almondsun/DynamicSystemsAndControl/project/pcb/redesign/production/jlcpcb-revB-2026-10-27/evidence/drill-report.txt

Drill report for buck.kicad_pcb
Created on 2026-10-27T14:55:54

Copper Layer Stackup:
    =============================================================
    L1 :  F.Cu                      front
    L2 :  B.Cu                      back

Drill file 'buck-PTH.drl' contains
    plated through holes:
    =============================================================
    T1  0.300mm  0.0118"  (39 holes))
    T2  0.400mm  0.0157"  (350 holes))
    T3  1.000mm  0.0394"  (9 holes))
    T4  1.100mm  0.0433"  (12 holes))
    T5  1.300mm  0.0512"  (4 holes))
    T6  1.400mm  0.0551"  (3 holes))

    Total plated holes count 417

Drill file 'buck-NPTH.drl' contains
    unplated through holes:
    =============================================================

    Total unplated holes count 0
