almondsun/DynamicSystemsAndControl/project/pcb/redesign/production/jlcpcb-quote-2026-10/evidence/drill-report.txt

Drill report for buck.kicad_pcb
Created on 2026-10-27T00:43:03

Copper Layer Stackup:
    =============================================================
    L1 :  F.Cu                      front
    L2 :  B.Cu                      back

Drill file 'buck-PTH.drl' contains
    plated through holes:
    =============================================================
    T1  0.300mm  0.0118"  (22 holes))
    T2  0.400mm  0.0157"  (25 holes))
    T3  1.000mm  0.0394"  (2 holes))
    T4  1.000mm  0.0394"  (19 holes))
    T5  1.100mm  0.0433"  (5 holes))
    T6  1.300mm  0.0512"  (8 holes))

    Total plated holes count 81

Drill file 'buck-NPTH.drl' contains
    unplated through holes:
    =============================================================

    Total unplated holes count 0
