almondsun/DynamicSystemsAndControl/project/pcb/audit/organization_by_type.md

# Documentos y bibliotecas organizados por tipo

Carpeta de origen comprobada: `C:\Users\justa\Downloads`. Se copiaron documentos de componentes electrónicos y bibliotecas; los documentos personales y materiales de clase ajenos permanecen en origen.

|Carpeta|Archivos únicos|
|---|---:|
|datasheets|40|
|cad/symbols|11|
|cad/footprints|15|
|cad/models_3d|14|
|cad/integrated_libraries|6|
|archives|16|
|technical_documents|6|
|pending_review|6|

Los datasheets confirmados están juntos en datasheets/. Los símbolos, footprints y modelos 3D están separados dentro de cad/. Las bibliotecas Altium integradas quedan en cad/integrated_libraries/, sin conversión ni separación interna. Los ZIP se conservan en archives/.

Se conservaron los nombres de archivo; para colisiones de nombre con contenido diferente se añade un fragmento SHA-256. Contenido idéntico se guarda una sola vez por categoría y sus orígenes quedan registrados.

La estructura anterior component_library/ por MPN se conserva como respaldo trazable y continúa siendo el destino del organizador previo. Esta vista por tipo es una copia organizada del estado actual; no se reconfiguró el watcher.

classification_by_type_manifest.csv registra origen, miembro ZIP, destino, MPN cuando existe, evidencia, asociación y hash. La presencia de documentos de otros componentes no los aprueba como sustitutos del Buck.

Originales de Descargas conservados, sin movimientos ni eliminaciones. Copias y originales verificados con SHA-256. Toda esta carpeta sigue excluida de Git. No se modificaron esquemáticos, PCB ni bibliotecas del proyecto activo.

## Pendientes de identificación
PDF sin texto claro o con caracteres ilegibles se copiaron a pending_review/. La identidad de estos archivos no se dedujo únicamente de su nombre.
