almondsun/DynamicSystemsAndControl/project/pcb/release/hardware-appendix.pdf

## Anexo de hardware: convertidor Buck

Revisión A: diseño preparado; ensayos físicos pendientes

Martín Ramírez Espinosa; Jerónimo Vargas Orozco Andrew Esteban Henao Becerra; Mateo Alexander Cardenas Cuesta Universidad Nacional de Colombia, Sede Manizales

## Alcance y estado

Este anexo acompaña las cuatro entregas IEEE. Las vistas proceden de la placa KiCad; no son fotografías de un prototipo. La placa tiene 99 por 99 mm, dos capas y 57 componentes. No se han comprado componentes ni realizado ensayos físicos. La fabricación permanece retenida hasta calificar componentes y validar un prototipo soldado.


Figura 1. Vista CAD isométrica. Los encapsulados estándar proceden de la biblioteca oficial KiCad. L1/L2 usan envolventes provisionales de 25 mm de diámetro: no representan dimensiones verificadas, bobinado ni terminales comerciales. Los capacitores representan el encapsulado previsto, con referencia y altura comercial pendientes. El MCU y accesorios son externos. Las vistas no certifican holguras, disipación ni montaje.

## Vista superior y localización


Figura 2. Vista superior CAD. La posición corresponde al archivo de placa. Verificar orientación, polaridad y dimensiones contra las piezas recibidas antes de ordenar.

Referencias | Función
J1; J2; J3 | Entrada con fusible externo; salida a carga; interfaz MCU.
Q1; D1; L1/L2; RS1 | MOSFET; rueda libre; inductancia serie; shunt.
U1; U2; U3 | IR2110; regulador 5 V; inversor HCT14.
U4; U5; U6 | Enclavamiento HCT00; comparadores LM393; INA180A1.
C4/C5 | Dos capacitores de 10 µF en paralelo.

## Plano de componentes

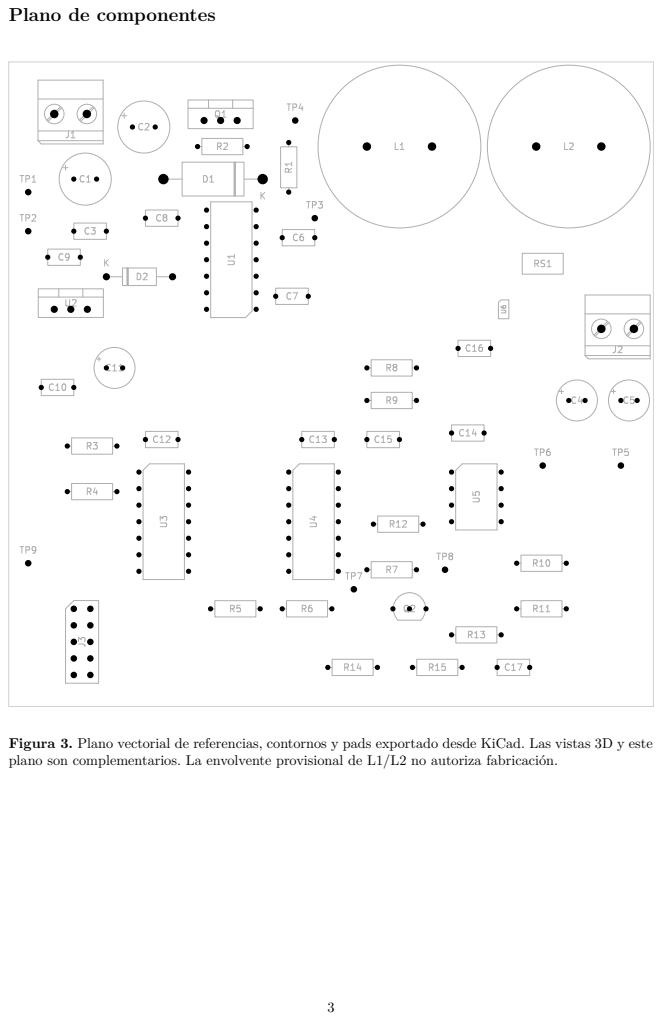
[picture p3: page 3]

Figura 3. Plano vectorial de referencias, contornos y pads exportado desde KiCad. Las vistas 3D y este
plano son complementarios. La envolvente provisional de L1/L2 no autoriza fabricación.

## Interconexión y puntos de medida

PCB BUCK
J1: VIN / GND
J2: VOUT / GND
J3: control y sensor

Fuente 12 V limitada
Fusible externo 2 A

Carga externa
6 / 7.2 / 4.8 Ω

STM32 Blue Pill
externo
5 V desde PCB

ST-Link + USB-UART
externos
lógica 3.3 V

SWD: PA13/14 · UART: PA9/10

CONEXIONES PREVISTAS · MONTAJE PENDIENTE

J3 → MCU
3: PA8 PWM
4: PB0 RUN
5: PB1 RESET
6: PB10 fallo
7: PA0 ADC
9: 3.3 V
J3: 1 = 5 V; 2, 8 y 10 = GND
Punto | Medida prevista
TP1 / TP2 | VIN / GND.
TP3 / TP4 | SW / GATE; vGS = V (TP4) − V (TP3), medida diferencial.
TP5 / TP6 | VOUT / ISENSE (nominalmente 1 V/A).
TP7 / TP8 / TP9 | SD / NTRIP / PWM d

′

J3: 1 = 5 V; 2, 8, 10 = GND; 3 = PA8; 4 = PB0; 5 = PB1; 6 = PB10 (fallo activo bajo); 7 = PA0; 9 = 3.3 V desde MCU. Conectar con alimentación apagada. Evitar realimentación entre USB, programador y reguladores. Verificar si el pin de 3.3 V del ST-Link es salida de alimentación o referencia; no unir fuentes independientes.

## Apagado y enclavamiento

NTRIP | RESET | RUN | SD | Resultado
0 | X | X | 1 | Disparo prioritario; fallo enclavado.
1 | 0 | 0 | 1 | Salida deshabilitada; conserva fallo previo.
1 | 1 | 0 | 1 | Limpia fallo con salida deshabilitada.
1 | 0 | 1 | 0/1 | Habilita sólo si no hay fallo enclavado.

Umbrales nominales: 2 A y 8.2 V. Intervalos estáticos calculados: 1.825–2.184 A y 7.561–8.868 V. No incluyen la verificación experimental del retardo ni garantizan ausencia de sobrepicos. Nunca conectar la masa de una sonda convencional al nodo SW.

## Revisión contra la guía original

Entrega | Requisito y evidencia disponible | Trabajo pendiente

1 (20 %) Derivación, dinámica, dos escalones de d

′ y
| errores; MATLAB/Simulink y circuito ngs- pice. | Revisión docente del informe; el circuito BJT no es la placa IR2110.

2 (30 %) PCB, lista de materiales, captura y protoco-
| lo preparados. | Montaje funcional; medir RLC; ajustar mo- delo; dos escalones físicos y errores.

3 (20 %) Especificaciones, PI por respuesta en fre-
| cuencia, cuatro casos numéricos; estimación PCB adicional separada. | Confirmar aceptación de la ubicación elegi- da del cero respecto a la recomendación de clase.

4 (30 %) Firmware ARM compilado, pruebas C y cap-
| tura, protocolo de cuatro casos. | Programar MCU, calibrar, medir tempori- zación/protecciones, cuatro pruebas físicas y reajuste si procede.

La lámina 90 del capítulo 10 recomienda normalmente cero PI por debajo del cruce. La entrega 3 explica por qué se escogió 3000 rad/s con cruce de 1000 rad/s y comprueba su margen; no se afirma seguir literalmente esa recomendación. Los porcentajes son pesos de evaluación, no porcentaje ganado ni avance calculado. Las fechas de mayo de 2025 de la guía deben confirmarse para el curso actual.

## Secuencia de trabajo del equipo

1. Cerrar referencias, disponibilidad y dimensiones; medir o conseguir datos de DCR, saturación y rizado admisible. Objetivo COP 350 000; estimado COP 281 501.95 con asignaciones de transporte y reserva COP 68 498.05, sin cotización final entregada.
2. Obtener y verificar MCU y componentes. Validar prototipo soldado con fuente limitada: inversión, bootstrap, apagado, protección y sensores.
3. Corregir el diseño según evidencia. Repetir ERC/DRC y comparar cotizaciones entregadas de PCBWay y JLCPCB; liberar fabricación sólo tras resolver bloqueos.
4. Fabricar, montar e inspeccionar. Medir RLC y calibrar ADC con dos puntos, comprobar con un tercero; medir PWM, latencia, rizado y temperatura.
5. Ejecutar tres repeticiones de los dos casos abiertos y los cuatro cerrados: 18 registros mínimos. Usar osciloscopio para rizado y pretrigger en carga.
6. Incorporar capturas, parámetros reales, incertidumbre y errores en entregas 2 y 4. Conservar datos previos a cualquier reajuste.

## Fuentes y trazabilidad

Guía: Descripción Proyecto Buck, pp. 1–3. Método: 10 The Frequency-Response Design Method, sección 7. Archivos KiCad y manifiesto de modelos en project/pcb; hojas de datos y enlaces en docs/sources.md. Simulación adicional en release/simulation. Los esquemas completos siguen en cinco páginas vectoriales exportadas directamente desde KiCad; ampliar para consultar pines y redes.

## Conectividad resumida de la etapa de potencia

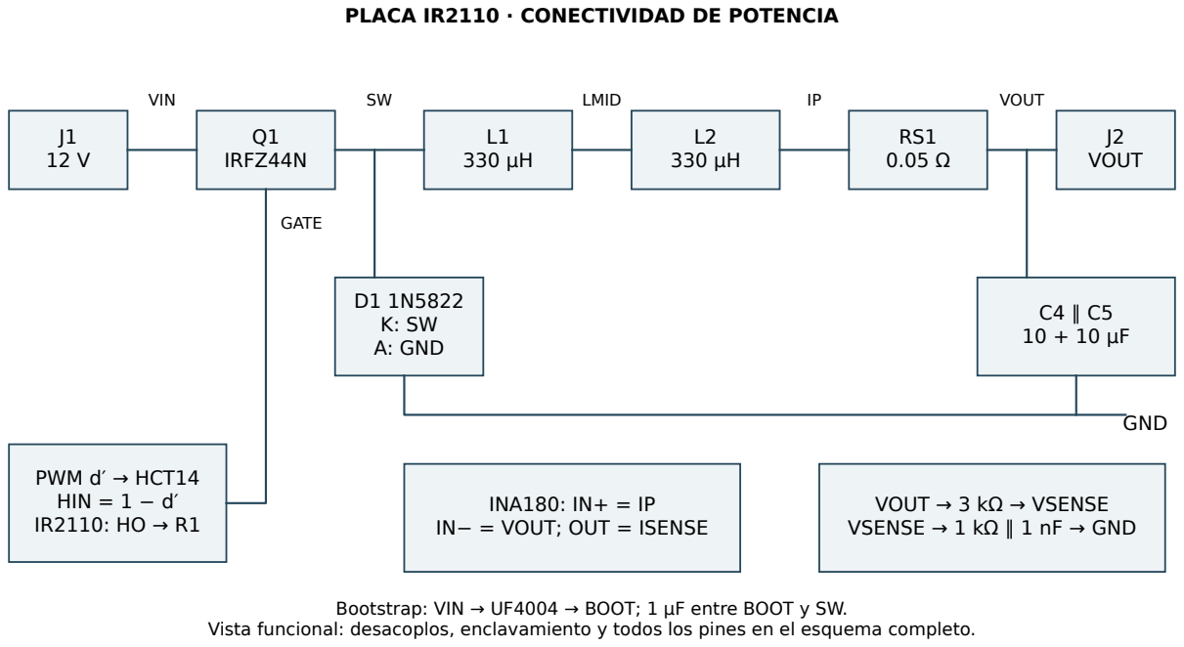
[picture p4: figure]
PLACA IR2110 · CONECTIVIDAD DE POTENCIA; Q1 IRFZ44N; J2 VOUT; VIN; LMID; VOUT; D1 1N5822 K: SW A: GND; GND; PWM d′ → HCT14 HIN = 1 − d′ IR2110: HO → R1; GATE; INA180: IN+ = IP IN− = VOUT; OUT = ISENSE; VOUT → 3 kΩ → VSENSE VSENSE → 1 kΩ ∥ 1 nF → GND

Bootstrap: VIN → UF4004 → BOOT; 1 μF entre BOOT y SW. Vista funcional: desacoplos, enclavamiento y todos los pines en el esquema completo.

Figura 4. Vista funcional de las redes de potencia y del signo de la entrada. L1 y L2 están en serie; RS1 está entre IP y VOUT. C4 y C5 comparten VOUT y GND. El esquema completo de las páginas siguientes detalla todos los pines, desacoplos, alimentación y protección. Esta vista no debe usarse sola para ensamblar.

1 | 2 | 3 | 4 | 5 | 6
1 | 2 | 3 | 4 | 5 | 6

AB

C

D

AB

C

D Date:

KiCad E.D.A. 10.0.6

Size: A4 | Rev: A Id: 1/5

Title: Buck 12V / 6V - REVIEW ONLY

File: buck.kicad_sch

Sheet: /

UNAL Manizales

Power stage

File: buck_1.kicad_sch Gate driver and supplies File: buck_2.kicad_sch

Independent protection

File: buck_3.kicad_sch STM32 interface and test points File: buck_4.kicad_sch

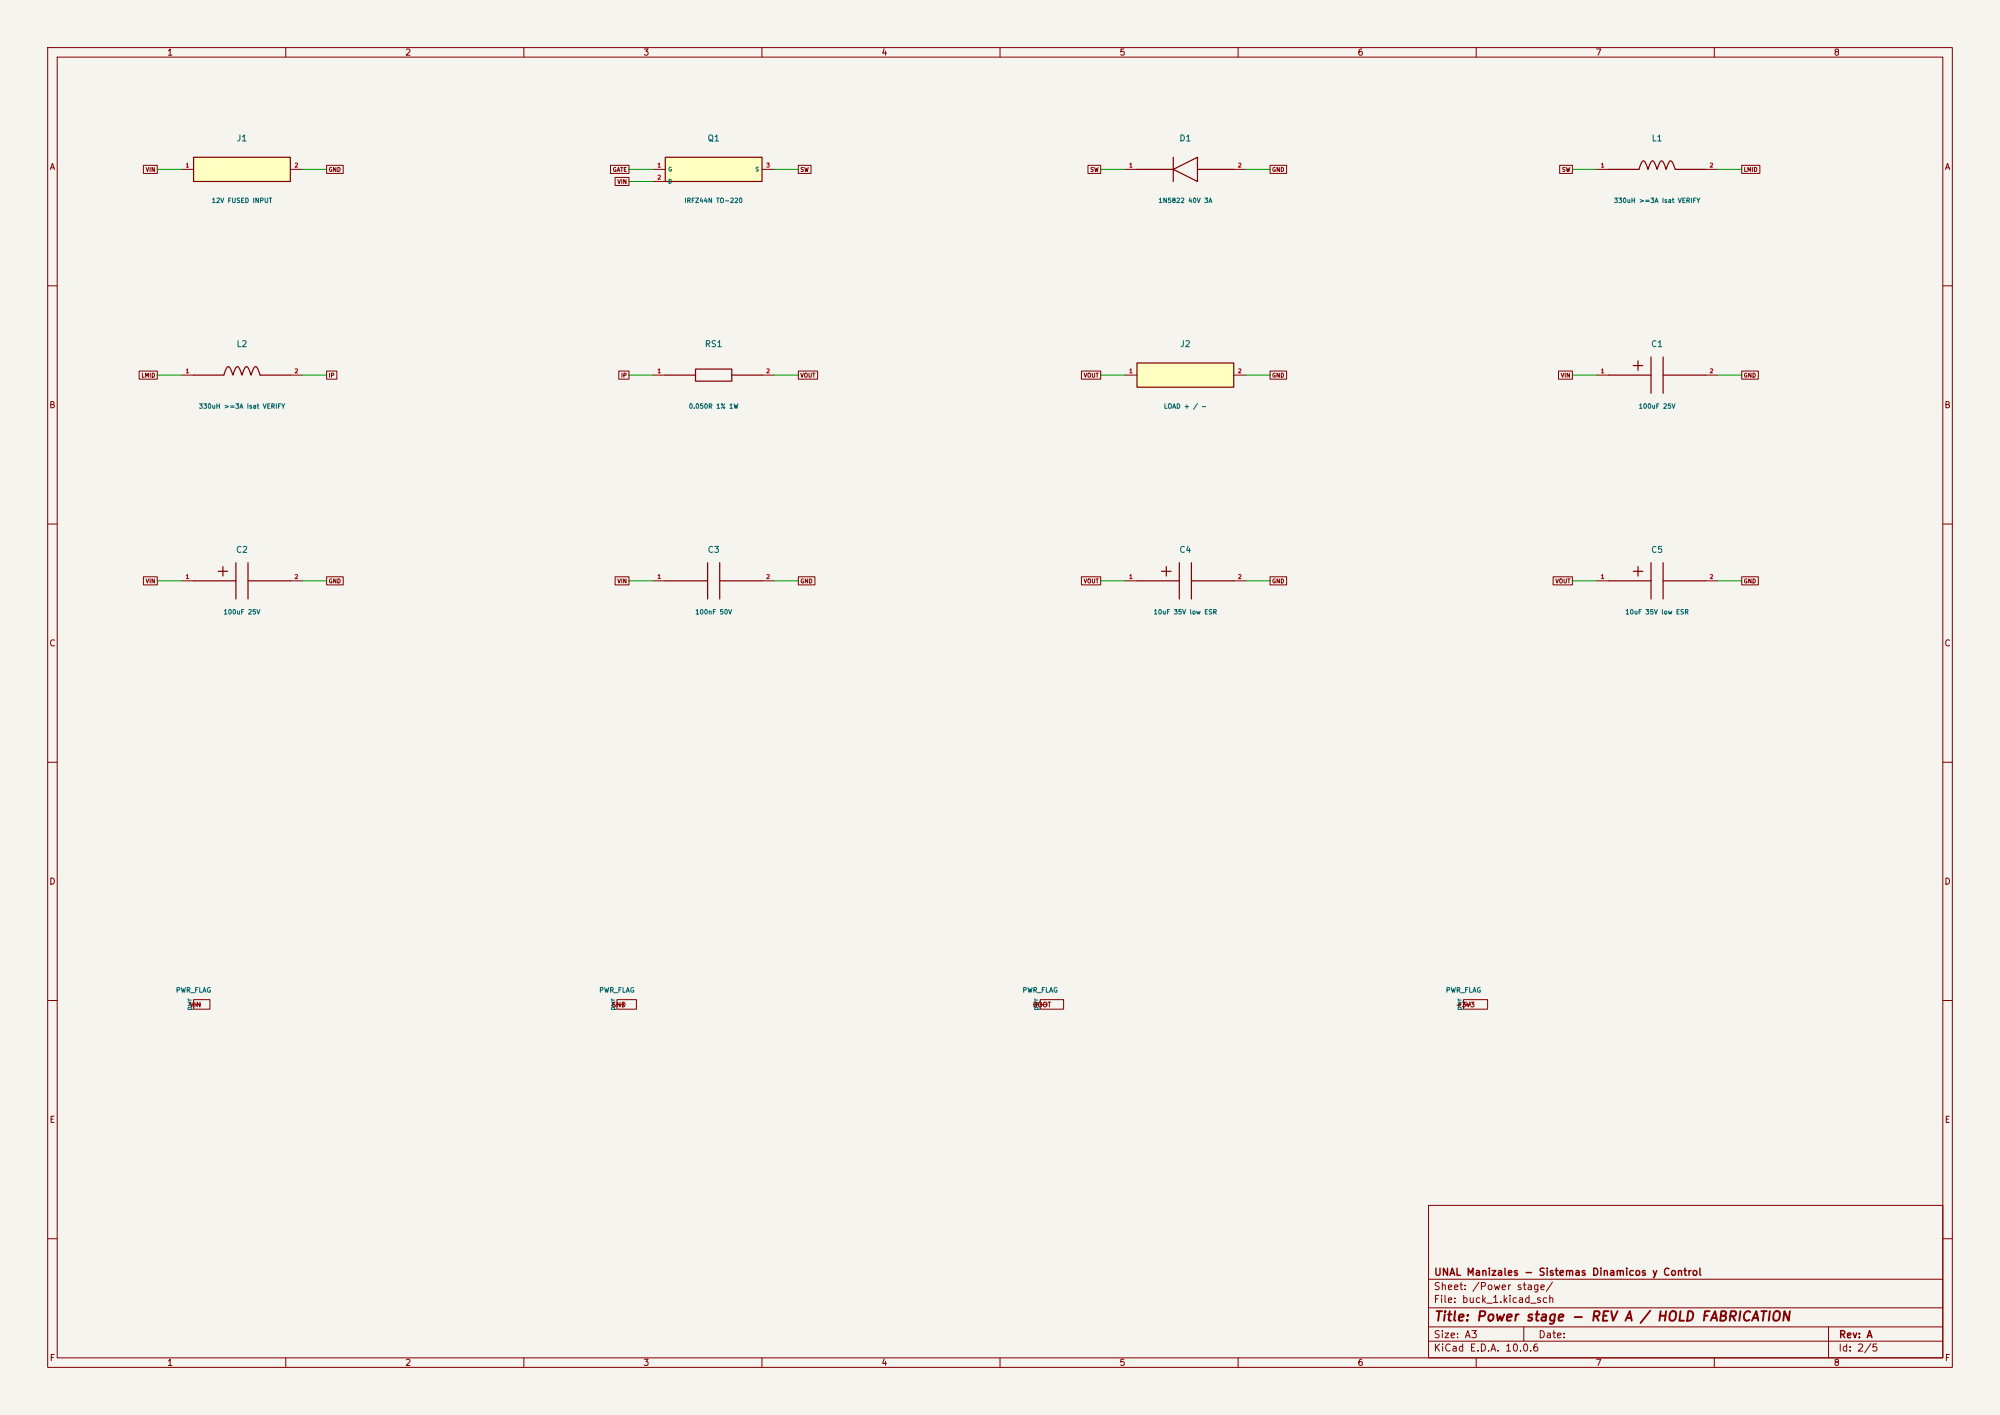
[picture p5: page 8]

UNAL Manizales - Sistemas Dinamicos y Control pwr 1 PWR_FLAG pwr 1 PWR_FLAG

Sheet: /Power stage/
File: buck_1.kicad_sch
Title: Power stage - REV A / HOLD FABRICATION

# 10k ¹ 2 C6

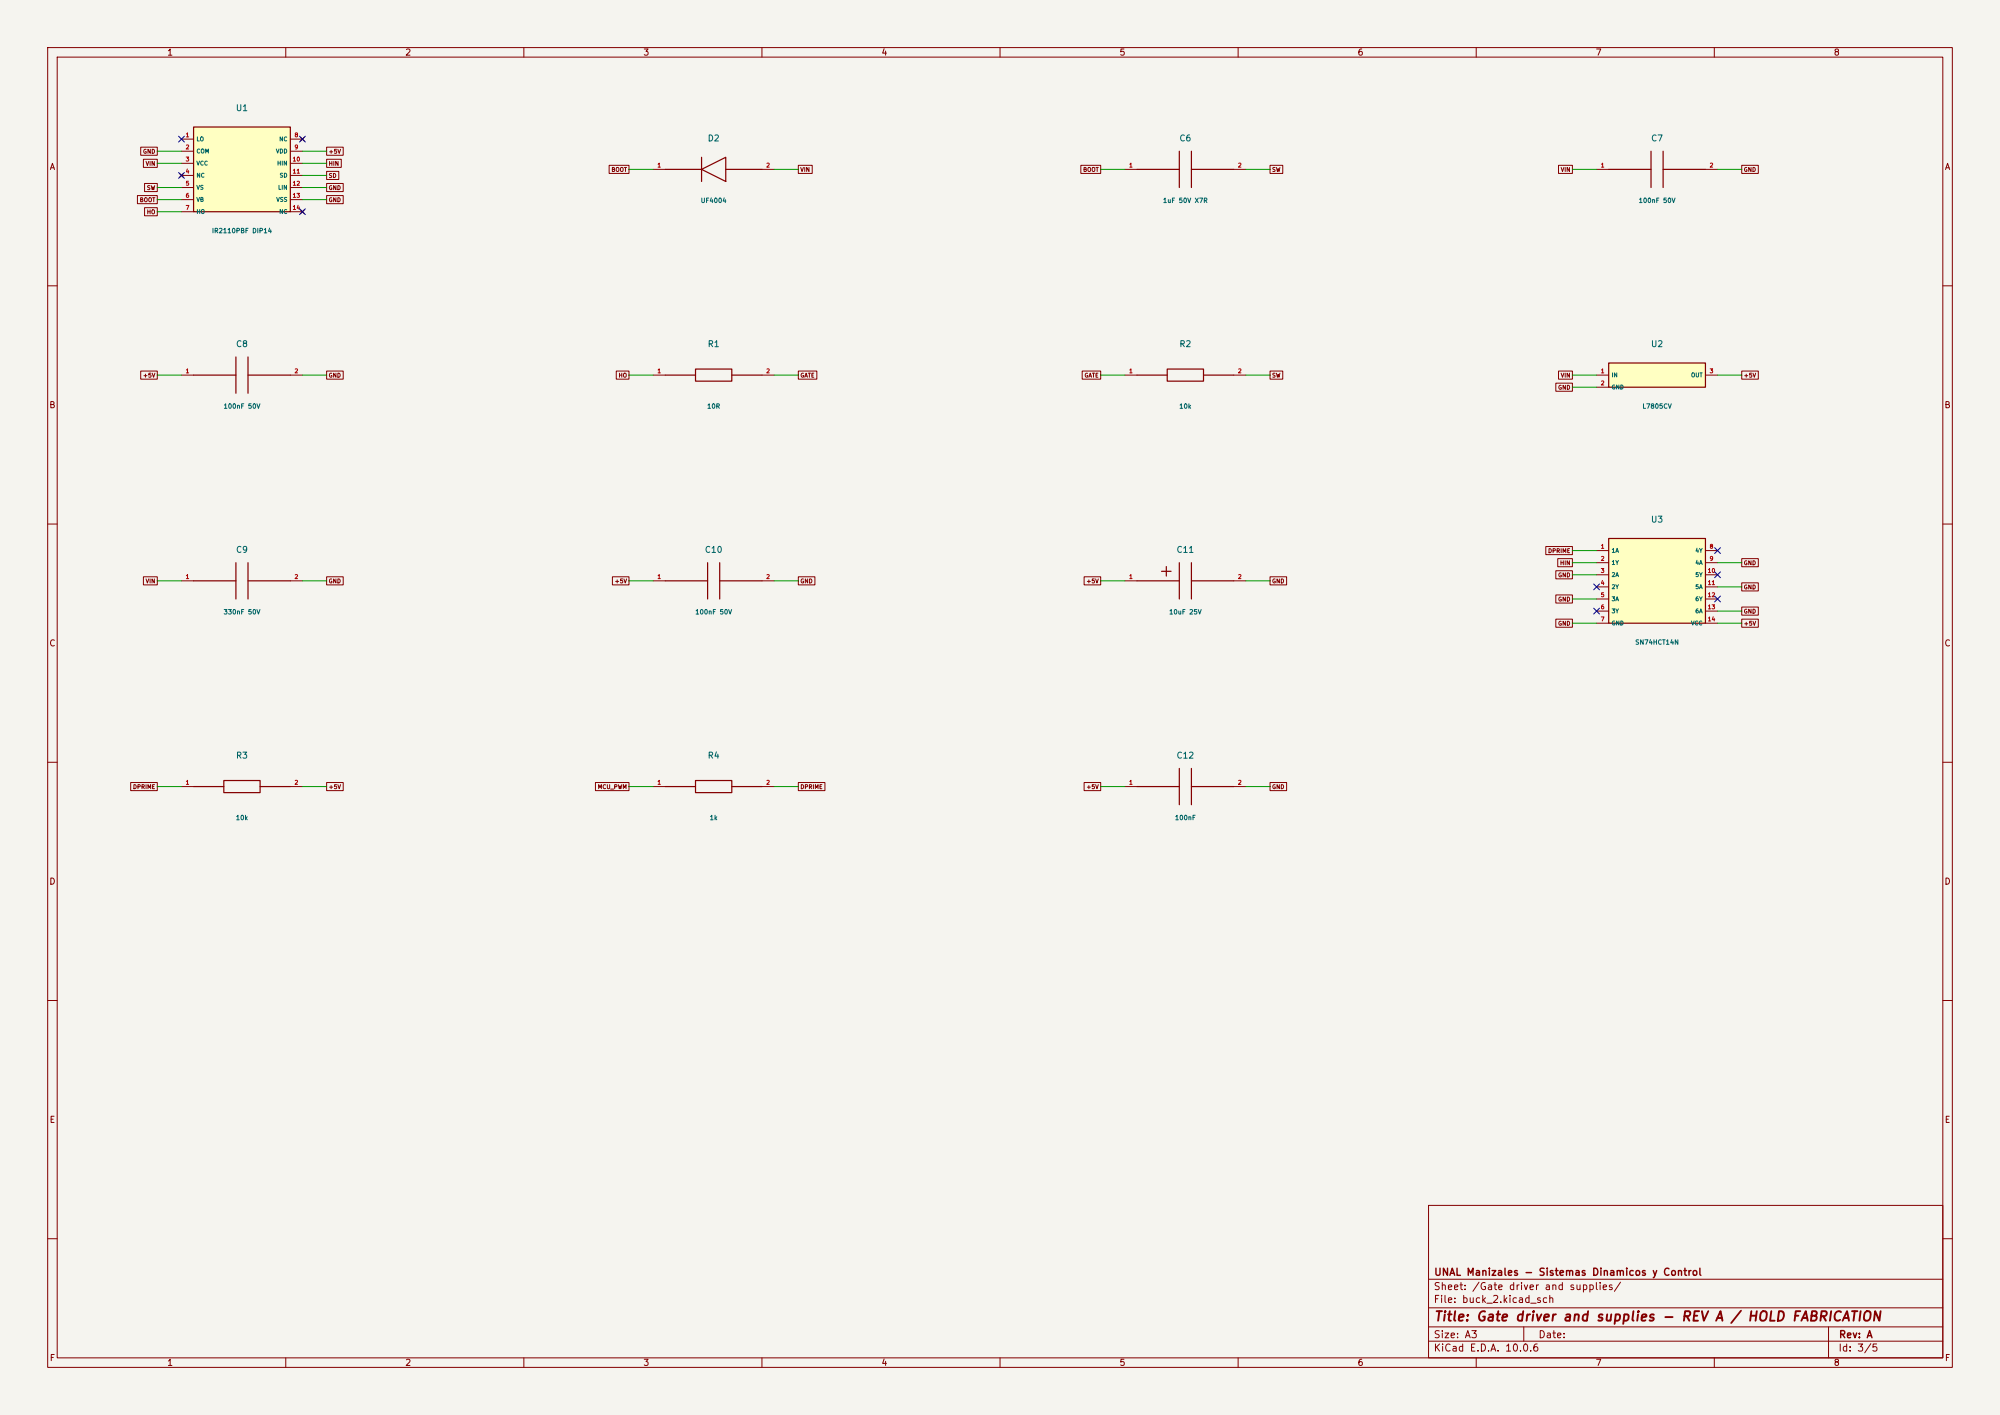
[picture p6: page 9]

UNAL Manizales - Sistemas Dinamicos y Control
Sheet: /Gate driver and supplies/
File: buck_2.kicad_sch
Title: Gate driver and supplies - REV A / HOLD FABRICATION

1 | 2 | 3 | 4 | 5 | 6 | 7 | 8
1 | 2 | 3 | 4 | 5 | 6 | 7 | 8

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
F Date:

Size: A3 | Rev: A

Title: Independent protection - REV A / HOLD FABRICATION

File: buck_3.kicad_sch

Sheet: /Independent protection/

UNAL Manizales - Sistemas Dinamicos y Control ¹ | 2 R13

10k

1A 1

1B 2

1Y 3

2A 4

2B 5

2Y 6 GND 7

3Y 8

3A 9

3B 10

4Y 11

4A 12

4B 13

VCC 14 U4

SN74HCT00N

1 | 2 R7
4.7k | 1 | 2 R5
10k | 1 | 2 R6

10k OUT1 1

IN1- 2

IN1+ 3 GND 4

IN2+ 5

IN2- 6 OUT2 7

VCC 8 U5

LM393P

1 | 2 C14

100nF

1 | 2 C15

100nF

1 | 2 R8

15k 1%

1 | 2 R10

31k 1%

1 | 2 R11

10k 1%

E 1 B
2 | C

3 Q2

2N3904

1 | 2 R12
10k ¹ | 2 C16

100nF

1 | 2 R9

10k 1%

1 | 2 C13

100nF OUT 1 GND 2

IN+ 3

IN- 4

VS 5 U6

INA180A1IDBVR

RUN +5V | GND

VOUT

RESET | GND

NFAULT_MCU

IP

GND

+3V3

NTRIP | +5V NFAULT NTRIP
FAULT NRESET +5V | +5V | VREF
VOUT | OVSENSE GND | OVSENSE | GND
ISENSE | GND | NFAULT_MCU
| FB
FAULT | FB
VREF | GND NFAULT | OVSENSE NTRIP

VREF +5V GND

GND

VREF

VREF

# ISENSE NTRIP +5V GND

+5V RESET NTRIP

SD NFAULT | GND
RUN
GND | +5V

FAULT NRESET

1 | 2 | 3 | 4 | 5 | 6 | 7 | 8
1 | 2 | 3 | 4 | 5 | 6 | 7 | 8

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
F Date:

Size: A3 | Rev: A

Title: STM32 interface and test points - REV A / HOLD FABRICATION

File: buck_4.kicad_sch

Sheet: /STM32 interface and test points/

UNAL Manizales - Sistemas Dinamicos y Control

SD 1 | TP7
SD MCU_PWM 1 | TP9

MCU_PWM

ISENSE 1 | TP6

ISENSE

GND 1 | TP2

GND

VOUT 1 | TP5
VOUT VIN 1 | TP1

VIN

1 | 2 R15

1k 1%

1 | 2 R14

3k 1%

NTRIP 1 | TP8

NTRIP

GATE 1 | TP4

GATE

SW 1 | TP3

SW

+5V 1 GND 2 MCU_PWM 3 RUN 4 RESET 5 | NFAULT_MCU

6

VSENSE 7 GND

8 +3V3

9 GND

10 J3

STM32 CABLE 2x5

1 | 2 C17
1nF | RUN

VSENSE

VOUT

GND

VIN

VOUT | VSENSE
ISENSE GND | GATE NTRIP
GND | +5V SW

SD

RESET | NFAULT_MCU

VSENSE GND +3V3 GND MCU_PWM

MCU_PWM

VSENSE | GND
