almondsun/DynamicSystemsAndControl/project/reports/final/entrega_1.pdf

# Modelado y validación de un convertidor Buck

Martín Ramírez Espinosa, Jerónimo Vargas Orozco Andrew Esteban Henao Becerra, Mateo Alexander Cardenas Cuesta Universidad Nacional de Colombia, Sede Manizales maramirezes@unal.edu.co, jevargaso@unal.edu.co anhenaobe@unal.edu.co, macardenascu@unal.edu.co

Entrega 1: Modelo y simulación

Resumen—Se deriva el modelo del Buck desde sus estados de conmutación. Se comparan la función de transferencia, el PWM ideal y un circuito completo ante dos escalones del complemento del ciclo de trabajo. Se separan sesgo estático, error incremental y rizado. Los resultados son de simulación.

I. PARÁMETROS Y CIRCUITO

Tabla I
PARÁMETROS DE LA GUÍA
Magnitud | Valor
Vin | 12 V
L; C | 660 µH; 20 µF
R; fs | 6 Ω; 10 kHz
D′ = 0.5 | Vo = 6 V; IL = 1 A

Se usan los valores de la guía [1]. La Fig. 1 representa el circuito simulado. Se suponen DCR rL = 0.1 Ω y ESR rC = 0.05 Ω; los semiconductores usan modelos genéricos. No son parámetros medidos.

sw

660 µH | rL | vo

Df

rC

20 µF

6 Ω

30 kΩ

vs

10 kΩ

g

Figura 1. Etapa de potencia y sensor del netlist. El driver excita g; el divisor entrega vs = vo/4.

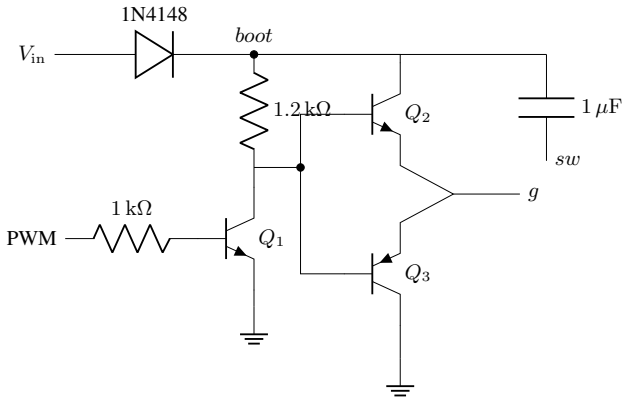
[picture p7: figure]
Vin; boot; PWM

Figura 2. Driver inversor y bootstrap del netlist. Q1: 2N2222; Q2: 2N3904; Q3: 2N2907, con modelos genéricos. sw es el nodo de conmutación.

II. DERIVACIÓN DEL MODELO
iL(t) y vo(t) son instantáneas; una barra indica promedio sobre Ts, mayúscula indica equilibrio y tilde indica perturbación. Se supone conducción continua (CCM), fuente constante y elementos ideales. Las ecuaciones ON/OFF son:

L

diL
dt =

(
Vin − vo, ON,
−vo, | OFF,

(1)

C

dvo
dt = iL −

vo
R
| en ambos estados. | (2)

El driver invierte PWM: d = 1−d

′
. Promediando los intervalos con pesos d y 1 − d:

L¯˙
iL = Vin(1 − d

′
| ) − v¯o,
Cv¯˙o = ¯iL − v¯o/R.
| | (3)

Vo = Vin(1 − D′
), | IL = Vo/R. | (4)

Sustituir ¯iL = IL + ˜iL, v¯o = Vo + ˜vo y d

| ′ = D′ + ˜d | ′ da el
estado incremental x˜ = [˜iL v˜o]
T:

x˜˙ =

0 −1/L
1/C −1/(RC)
| x˜ +
| −Vin/L
| 0
˜d

′
,

v˜o =

0 1
x. ˜

(5)

Eliminando ¯iL se obtiene LCv¨¯o+(L/R)v¯˙o+ ¯vo = Vin(1−d
′
).
Con condiciones iniciales incrementales nulas:

Gd′ (s) = Veo(s)
De′(s)

=

−Vin
LCs² + (L/R)s + 1
. | (6)
Gd′ (s) = | −9.090909 × 10⁸
s

2 + 8333.333s + 7.575758 × 10⁷

. (7)

La tensión total es 6 V más la respuesta incremental. No se debe aplicar el duty absoluto al modelo incremental. Para R constante, las ecuaciones promediadas son afines y también describen los escalones finitos dentro de sus hipótesis.

III. RESPUESTA DINÁMICA Y CONDUCCIÓN
La forma canónica de segundo orden [2] permite identificar:

ωn =

1
√
LC

, ζ =

p
L/C
2R

, ωd = ωn

p
1 − ζ
2. (8)

ωn = 8703.883 rad/s, ζ = 0.47871 y polos −4166.667 ± j7641.758 s−1
. No hay ceros finitos. La planta es estable y subamortiguada; su ganancia CC es −12 V por unidad de d

′

Mp = 100e

−πζ/√
1−ζ
2
= 18.03 %,
tp = π/ωd = 0.411 ms,
ts,2 % ≃ 4/(ζωn) = 0.960 ms.

(9)

Para ˜d
′ = a u(t − t0) y τ = t − t0 ≥ 0:

v˜o(τ ) = −12a[1 − e

−ζωnτh(τ )],

h(τ ) = cos(ωdτ ) + ζωn
ωd

sin(ωdτ ).

(10)

Así, a = +0.1 lleva a 4.8 V y a = −0.1 a 7.2 V. En el punto

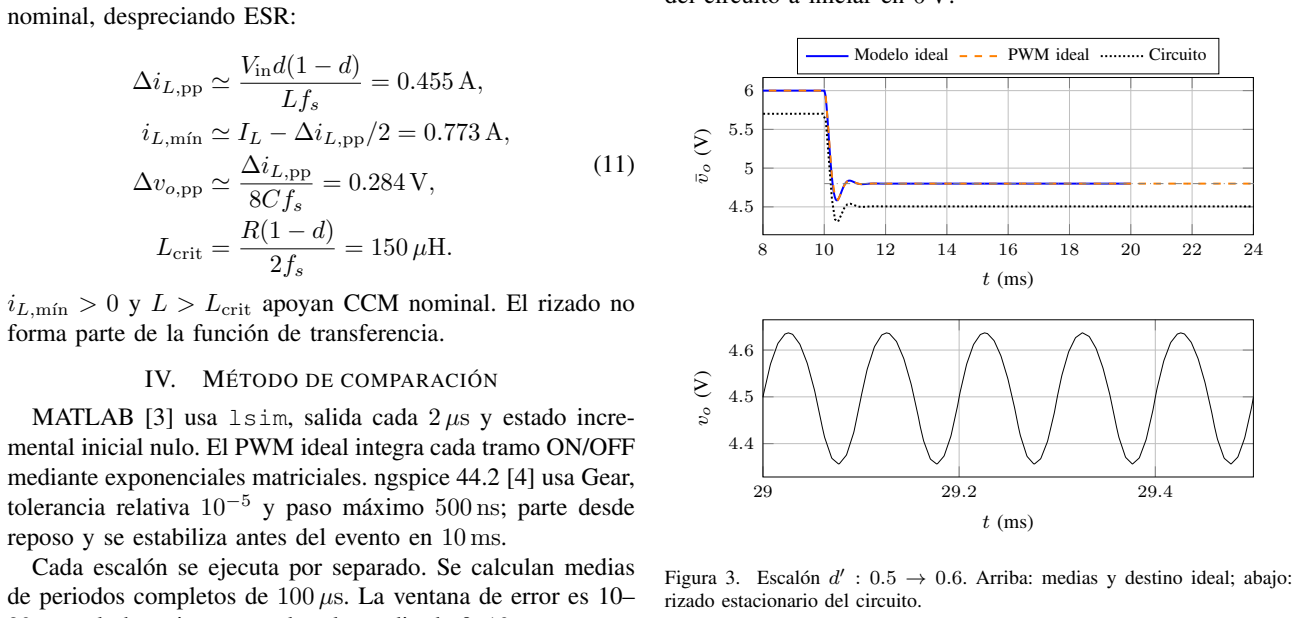
[picture p8: figure]
nominal, despreciando ESR:; Vind(1 − d); Lfs; 8Cfs; Lcrit =; IV. MÉTODO DE COMPARACIÓN; Modelo ideal; PWM ideal; Circuito; Figura 3. Escalón d; rizado estacionario del circuito.

iL,m´ın > 0 y L > Lcrit apoyan CCM nominal. El rizado no forma parte de la función de transferencia.

MATLAB [3] usa lsim, salida cada 2 µs y estado incremental inicial nulo. El PWM ideal integra cada tramo ON/OFF mediante exponenciales matriciales. ngspice 44.2 [4] usa Gear, tolerancia relativa 10−5 y paso máximo 500 ns; parte desde reposo y se estabiliza antes del evento en 10 ms.
Cada escalón se ejecuta por separado. Se calculan medias de periodos completos de 100 µs. La ventana de error es 10– 20 ms y la base incremental es la media de 9–10 ms.
Se compara la media por periodo v¯c[k] con el modelo vm[k] interpolado en el centro de cada periodo. Para N muestras:

ek = ¯vc[k] − vm[k],

ERMS =

### vuut

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
, Em´ax = m´ax k

|ek|.

(12)

El error incremental resta a cada curva su propia media previa al evento, vc,0 o vm,0:

e∆,k = (¯vc[k] − vc,0) − (vm[k] − vm,0). | (13)

ERMS,∆ usa la misma raíz cuadrática con e∆,k. El error normalizado es 100ERMS/|∆Videal|, donde el cambio nominal tiene magnitud 1.2 V.

V. RESULTADOS Y DISCUSIÓN

Tabla II
ERROR DEL CIRCUITO RESPECTO AL MODELO IDEAL
Magnitud | ∆d
| ′ = +0.1 | ∆d ′ = −0.1
Vo,ideal (V) | 4.800 | 7.200
v¯o,∞ (V) | 4.5060 | 6.8969
ERMS (V) | 0.2934 | 0.3025
ERMS,∆ (V) | 0.0060 | 0.0069
Em´ax (V) | 0.2975 | 0.3170
Error normalizado ( %) | 24.4506 | 25.2111

Las Figs. 3 y 4 muestran el sesgo estacionario cercano a 0.30 V, mientras el error incremental es de 6–7 mV. Las pérdidas y el driver desplazan el equilibrio; la dinámica dominante permanece próxima a la ideal. No se fuerza la curva del circuito a iniciar en 6 V.

: 0.5 → 0.6. Arriba: medias y destino ideal; abajo:

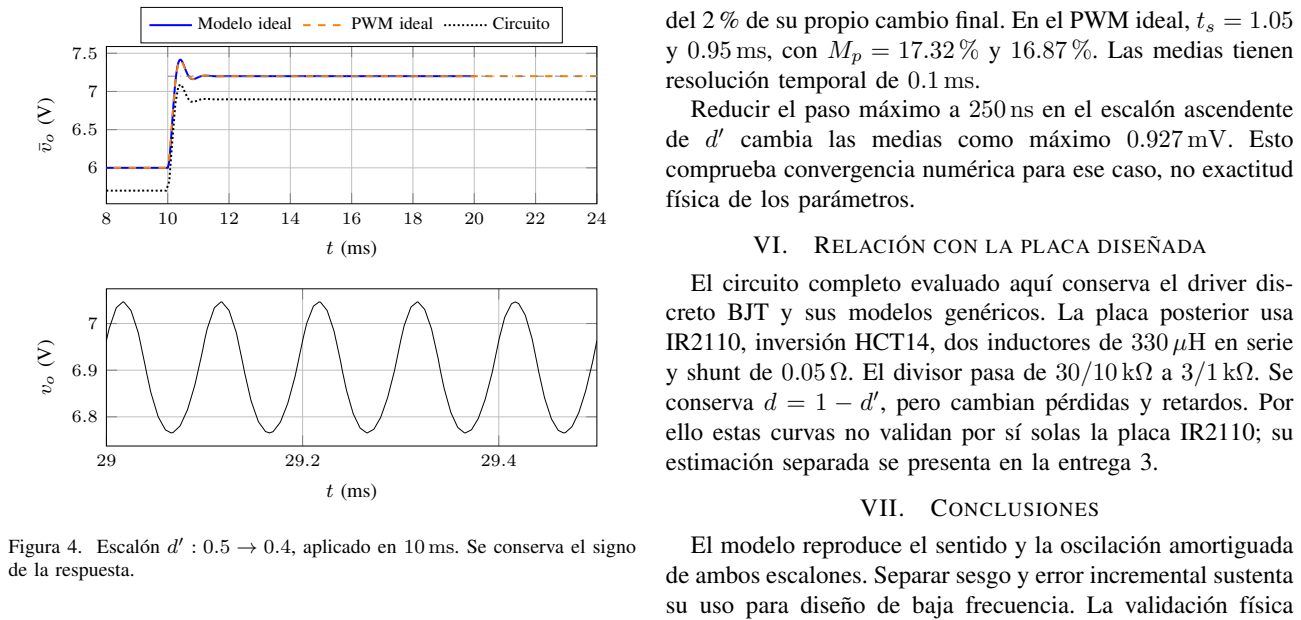
[picture p9: figure]
Modelo ideal; PWM ideal; Circuito; Figura 4. Escalón d; de la respuesta.; resolución temporal de 0.1 ms.; física de los parámetros.; VI. RELACIÓN CON LA PLACA DISEÑADA; conserva d = 1 − d; , pero cambian pérdidas y retardos. Por; VII. CONCLUSIONES

: 0.5 → 0.4, aplicado en 10 ms. Se conserva el signo

Tabla III
DINÁMICA DEL CIRCUITO RESPECTO DE SU PROPIO FINAL
Magnitud | +0.1 | −0.1
ts (ms) | 0.950 | 0.950
Mp ( %) | 16.43 | 16.01
Rizado pico a pico (V) | 0.280 | 0.281
iL,m´ın (A) | 0.458 | 0.807

El circuito no alcanza el destino ideal: su ts usa una banda del 2 % de su propio cambio final. En el PWM ideal, ts = 1.05 y 0.95 ms, con Mp = 17.32 % y 16.87 %. Las medias tienen

Reducir el paso máximo a 250 ns en el escalón ascendente cambia las medias como máximo 0.927 mV. Esto comprueba convergencia numérica para ese caso, no exactitud

El circuito completo evaluado aquí conserva el driver discreto BJT y sus modelos genéricos. La placa posterior usa IR2110, inversión HCT14, dos inductores de 330 µH en serie y shunt de 0.05 Ω. El divisor pasa de 30/10 kΩ a 3/1 kΩ. Se

ello estas curvas no validan por sí solas la placa IR2110; su estimación separada se presenta en la entrega 3.

El modelo reproduce el sentido y la oscilación amortiguada de ambos escalones. Separar sesgo y error incremental sustenta su uso para diseño de baja frecuencia. La validación física exige medir componentes y repetir los ensayos en laboratorio.

REFERENCIAS

[1] J. D. Bastidas Rodríguez, “Proyecto de Curso: Convertidor Buck con control de tensión de salida, Universidad Nacional de Colombia, mayo 2025, pp. 1–3.
[2] Material de Sistemas Dinámicos y Control, “Dynamic Response, Universidad Nacional de Colombia, material de clase.
[3] MathWorks, MATLAB, Simulink y Control System Toolbox, R2026a, documentación de lsim, margin, feedback, c2d y stepinfo, 2026.
[4] The ngspice team, ngspice User Manual, versión 44.2. Disponible: https: //ngspice.sourceforge.io/docs.html.
