almondsun/DynamicSystemsAndControl/project/reports/final/entrega_2.pdf

# Validación experimental del Buck en lazo abierto

Martín Ramírez Espinosa, Jerónimo Vargas Orozco Andrew Esteban Henao Becerra, Mateo Alexander Cardenas Cuesta Universidad Nacional de Colombia, Sede Manizales maramirezes@unal.edu.co, jevargaso@unal.edu.co anhenaobe@unal.edu.co, macardenascu@unal.edu.co

Entrega 2: Metodología; mediciones pendientes

Resumen—Se especifican la identificación de componentes, los dos ensayos de lazo abierto y las métricas de error. Se formula el modelo ajustado y se preparan tablas de registro. No hay datos de laboratorio: los resultados experimentales permanecen pendientes.

I. OBJETIVO Y ESTADO EXPERIMENTAL
La guía exige medir R, L y C y contrastar ambos escalones con el modelo ajustado [1]. No se han recibido mediciones ni capturas físicas: el documento establece el protocolo y los registros pendientes.

Tabla I
PARÁMETROS DE LA GUÍA
Magnitud | Valor
Vin | 12 V
L; C | 660 µH; 20 µF
R; fs | 6 Ω; 10 kHz
D′ = 0.5 | Vo = 6 V; IL = 1 A

Se seleccionan dos resistencias de 12 Ω, 10W en paralelo: carga nominal de 6 Ω, 20W: el nominal disipa 6W y a 7.2 V disipa 8.64W. Registrar temperatura y resistencia efectiva. Verificar terminales y referencias de los componentes reales.

II. DISEÑO PREPARADO PARA CONSTRUCCIÓN
La placa de 99 × 99 mm, dos capas y 57 componentes dispone de archivos KiCad, lista de materiales y salidas de fabricación para revisión. ERC, DRC y correspondencia esquema–placa no registran infracciones. Esto verifica reglas CAD, no funcionamiento eléctrico. No se han comprado componentes ni construido el prototipo.

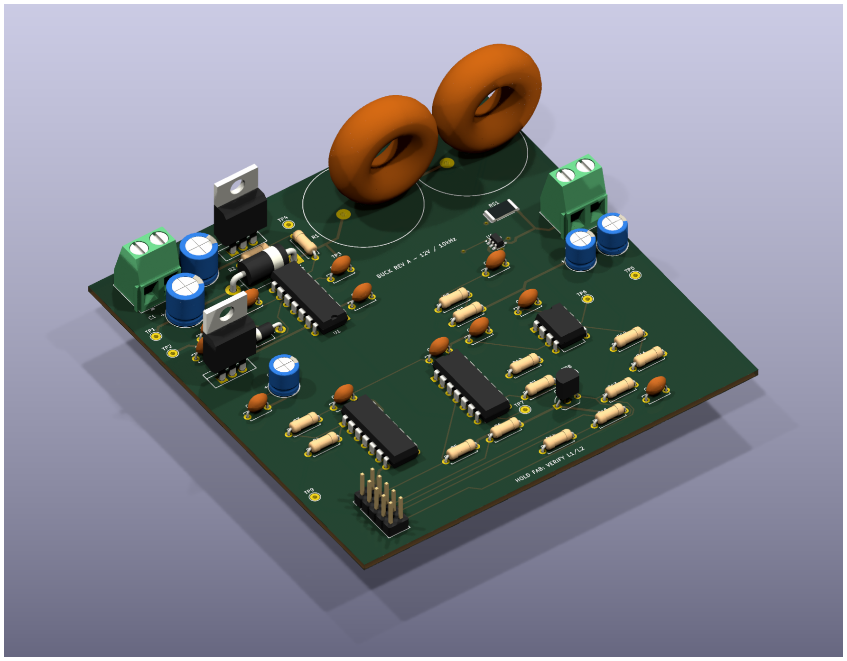
[picture p10: figure]

Figura 2. Vista CAD isométrica; no es una fotografía. Inductores: envolvente provisional. Capacitores: geometría genérica del encapsulado, referencia comercial pendiente.

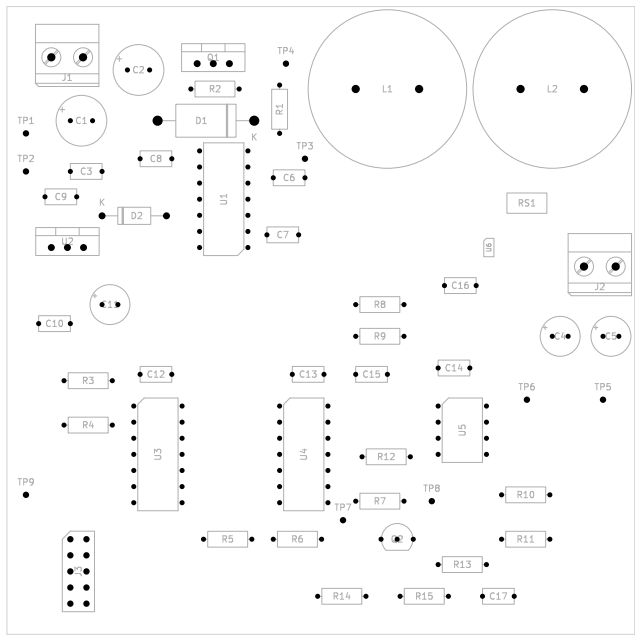
[picture p11: figure]

Figura 3. Vista de componentes con referencias y conectores. Las conexiones externas se detallan en el anexo.

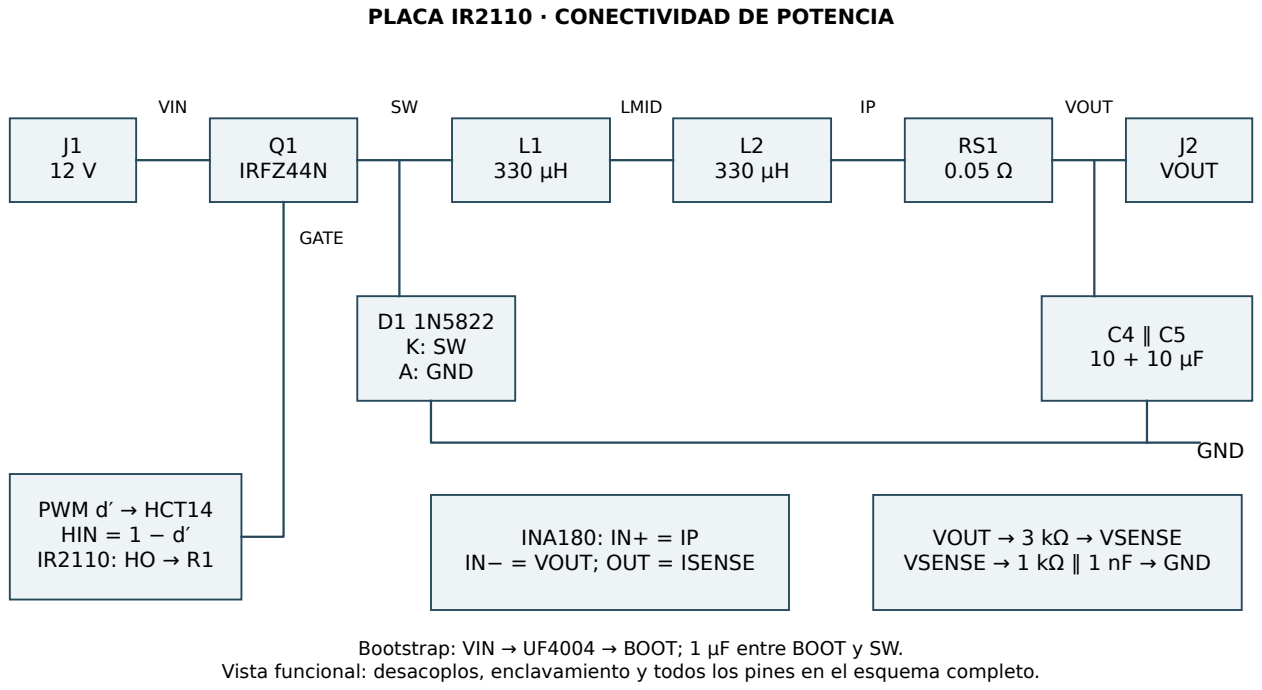
[picture p12: figure]
PLACA IR2110 · CONECTIVIDAD DE POTENCIA; Q1 IRFZ44N; J2 VOUT; VIN; LMID; VOUT; D1 1N5822 K: SW A: GND; GND; PWM d′ → HCT14 HIN = 1 − d′ IR2110: HO → R1; GATE; INA180: IN+ = IP IN− = VOUT; OUT = ISENSE; VOUT → 3 kΩ → VSENSE VSENSE → 1 kΩ ∥ 1 nF → GND

Bootstrap: VIN → UF4004 → BOOT; 1 μF entre BOOT y SW. Vista funcional: desacoplos, enclavamiento y todos los pines en el esquema completo.

Figura 1. Conectividad resumida de potencia, driver y sensor de la placa IR2110. El esquema completo con todos los pines está en el anexo de hardware.

La fabricación permanece retenida hasta confirmar dimensiones, saturación y DCR de L1/L2, referencia y corriente de
rizado de C4/C5, y verificar bootstrap, apagado y sensores en prototipo soldado. El STM32, programador y banco de carga se conectan externamente. El objetivo de presupuesto es COP 350 000; el estimado de COP 281 501.95 incluye asignaciones sin cotización final, dejando COP 68 498.05 de reserva.

III. IDENTIFICACIÓN DE PARÁMETROS

Tabla II
REGISTRO CON MEDIDOR DE PARÁMETROS; P = PENDIENTE
Dato | Nominal | Medido | Incert.
Vin (V) | 12 | P | P
R (Ω) | 6 | P | P
L (µH) | 660 | P | P
C (µF) | 20 | P | P
rL (Ω) | 0.20 (sup. PCB) | P | P
rC (Ω) | 0.15 (sup. PCB) | P | P
PWM (kHz) | 10 | P | P

Registrar instrumento, identificación, calibración, frecuencia de prueba, resolución, fecha y temperatura. Medir sin energizar; comprobar ausencia de saturación del inductor bajo corriente. Conservar fotografías y datos originales.

IV. MODELO CON PARÁMETROS MEDIDOS
El subíndice m denota parámetros medidos. La comparación principal actualiza la planta ideal:

Gd′

,m(s) = | −Vin,m
LmCms

2 + (Lm/Rm)s + 1

. | (1)

Como contraste adicional, incluir DCR y omitir ESR conduce a:

Gd′
,rL
(s) = −Vin,m
Dm(s)

,

Dm(s) = LmCms

2 + (Lm/Rm + rLCm)s

+ 1 + rL/Rm.

(2)

Este segundo modelo no incorpora caídas de diodos ni driver. El analizador disponible resuelve el modelo ideal con parámetros medidos y duty registrado; no identifica automáticamente pérdidas. Inicializar con tensión y corriente previas medidas. Si falta corriente, declarar iL(ti) = vo(ti)/Rm como hipótesis.

V. PROCEDIMIENTO DE ADQUISICIÓN
Comprobar continuidad, polaridad, PWM y apagado sin potencia. Verificar que aumentar d

′
reduce el tiempo ON.
Energizar con fuente limitada y observar corriente y vGS. En nodos flotantes usar medida diferencial apropiada; no conectar allí la masa de una sonda referida a tierra.

Estabilizar con d

′ = 0.5. Aplicar por separado 0.5 → 0.6 y 0.5 → 0.4, regresando al nominal entre capturas. Registrar duty y tensión simultáneamente al menos 5 ms antes y 20 ms después. Realizar tres repeticiones de cada caso.
Para rizado adquirir al menos 200 kS/s; documentar ancho de banda y desfase de canales. Promediar periodos completos sincronizados al PWM y conservar la forma instantánea.

VI. ANÁLISIS Y TABLAS DE RESULTADOS

Se compara la media por periodo v¯c[k] con el modelo vm[k] interpolado en el centro de cada periodo. Para N muestras:

ek = ¯vc[k] − vm[k],

ERMS =

### vuut

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
, Em´ax = m´ax k

|ek|.

(3)

El error incremental resta a cada curva su propia media previa al evento, vc,0 o vm,0:

e∆,k = (¯vc[k] − vc,0) − (vm[k] − vm,0). | (4)

ERMS,∆ usa la misma raíz cuadrática con e∆,k. El error normalizado es 100ERMS/|∆Videal|, donde el cambio nominal tiene magnitud 1.2 V.

Tabla III
RESULTADOS EXPERIMENTALES: d

′ 0.5 → 0.6

Magnitud | Modelo medido | Experimento
vo,0; vo,∞ (V) | Pendiente | Pendiente
Mp ( %); ts (ms) | Pendiente | Pendiente
ERMS; Em´ax (V) | — | Pendiente
ERMS,∆ (V) | — | Pendiente
Rizado (V) | No incluido | Pendiente

Tabla IV
RESULTADOS EXPERIMENTALES: d

′ 0.5 → 0.4

Magnitud | Modelo medido | Experimento
vo,0; vo,∞ (V) | Pendiente | Pendiente
Mp ( %); ts (ms) | Pendiente | Pendiente
ERMS; Em´ax (V) | — | Pendiente
ERMS,∆ (V) | — | Pendiente
Rizado (V) | No incluido | Pendiente

Reportar media y dispersión de las tres repeticiones, ventanas y banda del 2 % respecto del cambio final de cada curva. La comparación absoluta evalúa exactitud; la incremental separa sesgo y dinámica. No afirmar cumplimiento de una banda menor que la incertidumbre instrumental.

VII. DISCUSIÓN Y CRITERIO DE CIERRE
Superponer modelo nominal, modelo medido y experimento. Explicar tolerancias, pérdidas y errores instrumentales con evidencia. El cierre requiere ambas respuestas, parámetros medidos, incertidumbre, fotografías y conclusiones basadas en capturas. La validación física permanece pendiente.
| APÉNDICE A
| ARCHIVOS DE ANÁLISIS

El CSV contiene time_s, voltage_V, dprime, load_ohm y reference_V. El JSON contiene Vin, L_H, C_F, R_ohm, step_time_s, instrumento y fecha; initial_current_A es opcional. Ejecutar analyze_experiment.py según project/data/README.md. Conservar calibración y archivos originales de cada repetición.

| REFERENCIAS
[1] J. D. Bastidas Rodríguez, “Proyecto de Curso: Convertidor Buck con control de tensión de salida, Universidad Nacional de Colombia, mayo 2025, pp. 1–3.
