almondsun/DynamicSystemsAndControl/project/reports/final/entrega_3.pdf

# Diseño y validación del regulador PI

Martín Ramírez Espinosa, Jerónimo Vargas Orozco Andrew Esteban Henao Becerra, Mateo Alexander Cardenas Cuesta Universidad Nacional de Colombia, Sede Manizales maramirezes@unal.edu.co, jevargaso@unal.edu.co anhenaobe@unal.edu.co, macardenascu@unal.edu.co

Entrega 3: Control de tensión de salida

Resumen—Se diseña un PI mediante respuesta en frecuencia para regular 6 V. Se documentan signo, saturación, anti-windup y discretización. Cuatro escenarios de referencia y carga se contrastan en modelos promediados, PWM digital y circuito completo. Los resultados son exclusivamente numéricos.

I. ESPECIFICACIONES Y SIGNO DEL LAZO
La guía pide un compensador de la familia PID y cuatro escenarios [1]. Se elige PI (Kd = 0). Las siguientes metas son decisiones de diseño y se aplican a la tensión media por periodo.

Tabla I
METAS DE DISEÑO
Magnitud | Criterio
Referencia nominal | 6 V
Error final | < 20 mV
ts en referencia | < 10 ms; banda ±20 mV
Mp en referencia | < 10 % del escalón de 1 V
ts en carga | < 10 ms; banda ±0.12 V
Pico en carga | < 0.8 V
Duty físico | 0.05 ≤ d ≤ 0.95
Margen de fase | > 60◦ (modelo continuo)

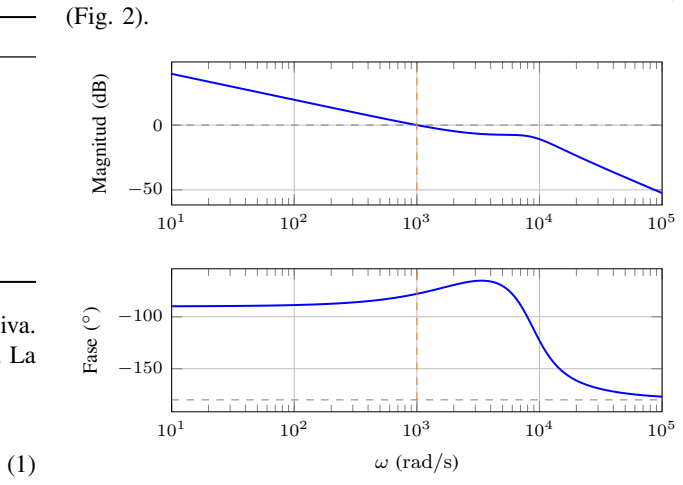
[picture p13: figure]
(Fig. 2).; Magnitud (dB); ω (rad/s); Fase (

Se define e = r−v¯o y se diseña sobre Gd = −Gd′ , positiva. El compensador hacia d

′
es H = −K; así Gd′H = GdK. La Fig. 1 muestra el complemento explícito.

K(s) = Kp +

Ki
s

,

d

′ = 1 − sat(0.5 + Kpe + z).

Σ | PI | 1 − d

PWM
driver r | Buck
e | d | d
′ | d
vo

sensor y promedio

−

Figura 1. Lazo de regulación. PI incluye sesgo, saturación y anti-windup. PWM y driver convierten d

′
en duty físico d.

II. DISEÑO POR RESPUESTA EN FRECUENCIA
Se aplica la condición de cruce de clase [2]. Se fijan ωc = 1000 rad/s (159.15 Hz) y ωz = 3000 rad/s, muy por debajo de fs = 10 kHz:

Ac = 1 − LCω²
c

, Bc = Lωc/R,

|Gd(jωc)| = p

Vin
A²
c + B² c | = 12.08566 V,

Kp =

1
|Gd(jωc)|

p
| 1 + (ωz/ωc)
| 2 ,

Ki = ωzKp.

(2)

Kp = 0.026165529 V−1
,
Ki = 78.496586 (V s)−1
,
Ti = Kp/Ki = 0.333333 ms.

(3)

∠Gd(jωc) = −6.3606◦ y ∠K(jωc) = −71.5651◦
. MATLAB
[3] obtiene margen de fase 102.075◦ y cruce 1000.019 rad/s

Figura 2. Lazo continuo K(jω)Gd(jω); línea vertical en ωc. No hay cruce finito de −180◦.

El margen de ganancia nominal es infinito dentro del modelo continuo; no incluye retardos ni polos parásitos del hardware. La integral corrige errores constantes y se omite la derivada para evitar amplificar ruido y rizado.

T(s) = Vin(Kps + Ki)
Dcl(s)

,

Dcl(s) = LCs³ + (L/R)s

2

+ (1 + VinKp)s + VinKi

(4)

La respuesta continua tiene subida 10–90 % de 2.613 ms, establecimiento al 2 % de 4.832 ms y sobreimpulso nulo.

III. PERTURBACIONES Y ALGORITMO DIGITAL
La carga cambia a 7.2 o 4.8 Ω manteniendo r = 6 V. Para corriente adicional extraída de la salida:

Veo

Iecarga

=

−Ls
LCs² + (L/R)s + 1

1
1 + GdK
. | (5)
La aproximación ˜icarga ≃ −VoR/R ˜ | 2
es local. Los ensayos
de ±20 % usan R(t) directamente. Al aumentar R, la tensión sube inicialmente porque disminuye la corriente de carga.

uk = 0.5 + Kpek + zk,
d

cmd
k = m´ın(0.95, m´ax(0.05, uk)),

zk+1 =

(
zk, | Sk,
zk + KiTsek, en otro caso, Sk = (uk ≥ 0.95 ∧ ek > 0)
∨ (uk ≤ 0.05 ∧ ek < 0).

(6)

El integrador se congela sólo si profundiza la saturación. Se usa Ts = 100 µs, medida media del periodo completado y orden aplicada d

ap
k = d

cmd
k−1

. En el equilibrio ideal: Vo = 6 V, IL = 1 A y z0 = 0.

t

k − 1 | k | k + 1 | k + 2

media v¯k−1
cálculo
d

cmd
k
precarga: Ts

d

cmd
k

aplicado

Figura 3. Temporización digital: cálculo con la media anterior y orden aplicada un periodo después. El promedio también modifica la dinámica de medida.

IV. VALIDACIÓN Y ALCANCE
MATLAB usa ode45, tolerancias relativa 10−8 y absoluta 10−10, paso máximo 10 µs y tramos separados en el evento de 10 ms. Simulink representa las mismas ecuaciones. ngspice emplea PI continuo y parte desde reposo; el PWM ideal usa PI digital con promedio y retardo. Las gráficas identifican estas realizaciones distintas.
La máxima diferencia MATLAB–Simulink es 43.414 µV. El modelo lineal ZOH con retardo de un periodo tiene radio de polos 0.915396 < 1. Son estables las 27 combinaciones de R, L, C al 80, 100 y 120 %, tanto continuas como discretas. La malla no prueba todas las tolerancias ni la transición CCM/DCM.
V. RESULTADOS
El error final es | media25–30 ms(¯vo)−rf |. El establecimiento
se obtiene del último incumplimiento de la banda desde el evento, con resolución Ts. El sobreimpulso se normaliza por 1 V en referencia; en carga se mide m´ax |v¯o−6|. Las Figs. 4–7 muestran los cuatro casos.

Tabla II
PWM IDEAL CON PI DIGITAL
Caso | ts (ms) | |e∞| (mV) | Mp/pico | Rizado (V)
6 → 7 V | 4.15 | 0.0002 | 0.000 % | 0.277
6 → 5 V | 4.05 | 0.0002 | 0.000 % | 0.277
R : +20 % | 0.85 | 0.0000 | 0.560 V | 0.286
R : −20 % | 0.85 | 0.0000 | 0.691 V | 0.282

Tabla III
CIRCUITO CON PI CONTINUO
Caso | ts (ms) | |e∞| (mV) | Mp/pico | Rizado (V)
6 → 7 V | 4.95 | 0.0048 | 0.012 % | 0.279
6 → 5 V | 4.95 | 0.0110 | 0.012 % | 0.288
R : +20 % | 0.65 | 0.0146 | 0.487 V | 0.293
R : −20 % | 0.65 | 0.0159 | 0.605 V | 0.289

El rizado es pico a pico. Los errores medios menores que 0.02 mV son precisión numérica del modelo, no una garantía para ADC reales. Ambas realizaciones cumplen las metas nominales.

8 | 10 | 12 | 14 | 16 | 18 | 20 | 22 | 24

6

6.5

7

t (ms)

¯vo (V)

Promediado | PWM digital | Circuito
29 | 29.2 | 29.4

6.9

7

7.1

t (ms)

vo (V)

Figura 4. Respuesta a 6 → 7 V. Arriba: medias y banda de establecimiento; abajo: rizado estacionario del circuito.

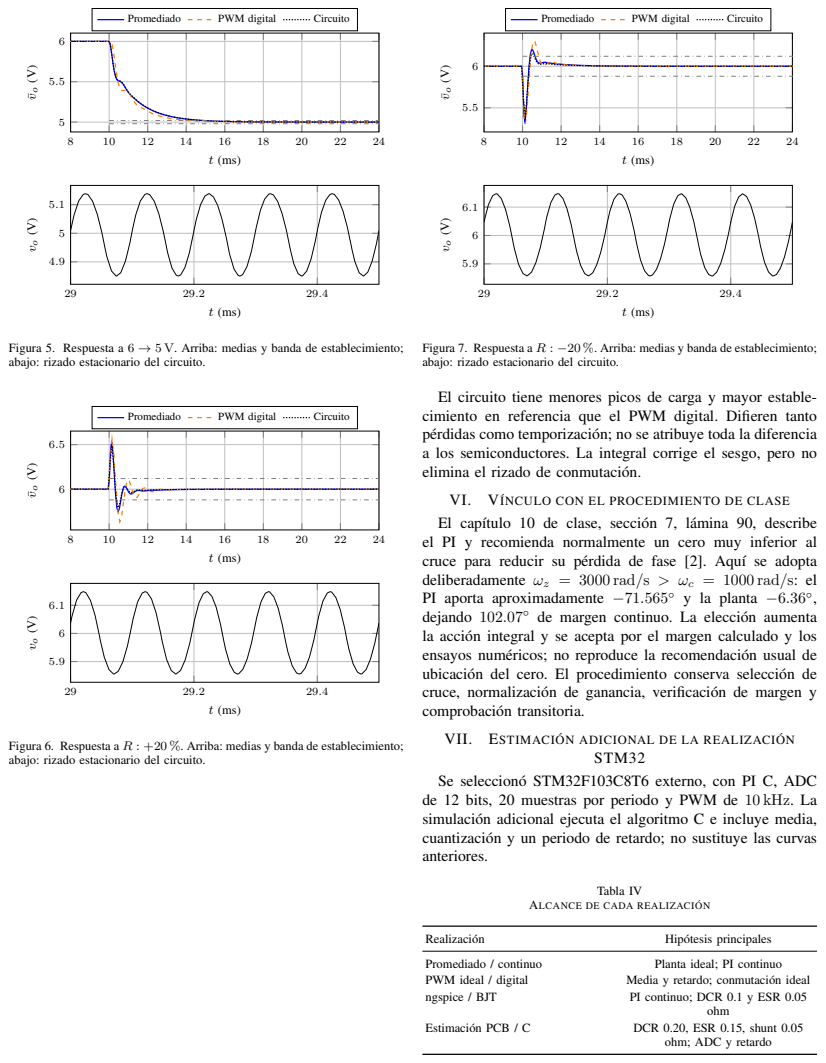
[picture p14: page 3]
Promediado; PWM digital; Circuito; STM32; Tabla IV; Realización; Hipótesis principales; Promediado / continuo; Planta ideal; PI continuo; PWM ideal / digital; Media y retardo; conmutación ideal; ngspice / BJT; PI continuo; DCR 0.1 y ESR 0.05; ohm; Estimación PCB / C; DCR 0.20, ESR 0.15, shunt 0.05

Figura 5. Respuesta a 6 → 5 V. Arriba: medias y banda de establecimiento;
abajo: rizado estacionario del circuito.

Figura 7. Respuesta a R : −20 %. Arriba: medias y banda de establecimiento;

El circuito tiene menores picos de carga y mayor estable-
cimiento en referencia que el PWM digital. Difieren tanto
pérdidas como temporización; no se atribuye toda la diferencia
a los semiconductores. La integral corrige el sesgo, pero no
elimina el rizado de conmutación.

VI. VÍNCULO CON EL PROCEDIMIENTO DE CLASE
El capítulo 10 de clase, sección 7, lámina 90, describe
el PI y recomienda normalmente un cero muy inferior al
cruce para reducir su pérdida de fase [2]. Aquí se adopta
deliberadamente ωz = 3000 rad/s > ωc = 1000 rad/s: el
PI aporta aproximadamente −71.565◦ y la planta −6.36◦
dejando 102.07◦ de margen continuo. La elección aumenta
la acción integral y se acepta por el margen calculado y los
ensayos numéricos; no reproduce la recomendación usual de
ubicación del cero. El procedimiento conserva selección de
cruce, normalización de ganancia, verificación de margen y
comprobación transitoria.

VII. ESTIMACIÓN ADICIONAL DE LA REALIZACIÓN

Figura 6. Respuesta a R : +20 %. Arriba: medias y banda de establecimiento;

Se seleccionó STM32F103C8T6 externo, con PI C, ADC
de 12 bits, 20 muestras por periodo y PWM de 10 kHz. La
simulación adicional ejecuta el algoritmo C e incluye media,
cuantización y un periodo de retardo; no sustituye las curvas
anteriores.

ALCANCE DE CADA REALIZACIÓN

ohm; ADC y retardo

La estimación PCB usa RDS = 0.022 Ω, VF = 0.45 V y retardos de encendido/apagado de 120/94 ns como supuestos. Euler usa paso de 0.5 µs con fracción de flanco PWM; parte de energía nula y aplica el evento tras 800 ms. Se muestran 40 ms con evento en 10 ms. No modela saturación, térmica, EMI ni la recarga real del bootstrap.

Tabla V
RESULTADOS ADICIONALES ESTIMADOS; NO MEDIDOS
Caso | ts (ms) | |e∞| (mV)
6 a 7 V | 4.30 | 0.364
6 a 5 V | 4.30 | 0.988
6 a 7.2 ohm | 0.80 | 0.253
6 a 4.8 ohm | 0.90 | 0.176

Las bandas son ±20 mV en referencia y ±0.12 V en carga. Seis escenarios no activan la protección simulada; corriente máxima 1.549272 A. Reducir el paso a 0.25 µs cambia la media como máximo 1.345 mV en referencia ascendente. Los umbrales nominales de protección no son tolerancias garantizadas.

VIII. CONCLUSIONES
El PI cumple los escenarios nominales y mantiene estabi-lidad en la malla evaluada. El signo inversor, los límites y el anti-windup son explícitos. La validación física requiere verificar adquisición, retardo y apagado y repetir los cuatro casos.

REFERENCIAS

[1] J. D. Bastidas Rodríguez, “Proyecto de Curso: Convertidor Buck con control de tensión de salida, Universidad Nacional de Colombia, mayo 2025, pp. 1–3.
[2] Material de Sistemas Dinámicos y Control, “The Frequency-Response Design Method, cap. 10, material de clase.
[3] MathWorks, MATLAB, Simulink y Control System Toolbox, R2026a, documentación de lsim, margin, feedback, c2d y stepinfo, 2026.
