almondsun/DynamicSystemsAndControl/project/reports/final/entrega_4.pdf

# Implementación y validación experimental del PI

Martín Ramírez Espinosa, Jerónimo Vargas Orozco Andrew Esteban Henao Becerra, Mateo Alexander Cardenas Cuesta Universidad Nacional de Colombia, Sede Manizales maramirezes@unal.edu.co, jevargaso@unal.edu.co anhenaobe@unal.edu.co, macardenascu@unal.edu.co

Entrega 4: Metodología digital; ensayos pendientes

Resumen—Se documenta la integración del PI con ADC y PWM: calibración, temporización, saturación y reajuste. Se establecen cuatro pruebas de aceptación. La integración física, las mediciones y los resultados experimentales permanecen pendientes.

I. ALCANCE
La guía exige implementar y ajustar el compensador y repetir cuatro ensayos físicos [1]. La placa está diseñada y el firmware STM32 compila. El código integra adquisición, DMA y PWM, y el núcleo C cuenta con pruebas en computador. Faltan el montaje, la programación del MCU, la calibración y las capturas físicas. No se declara completada la implementación física.

II. ADQUISICIÓN Y CALIBRACIÓN
El divisor nominal tiene Rt = 3 kΩ y Rb = 1 kΩ. Para un ADC unipolar de N bits:

vs[k] = nkVADC
2N − 1

,

vˆo[k] = a vs[k] + b, anom = 1 + Rt/Rb = 4,

∆vo,LSB =

aVADC
2N − 1

(1)

Obtener a, b con dos tensiones conocidas y validar con un tercer punto. Medir referencia y resistencias, registrar residuos y comprobar rango del ADC durante transitorios. Comparar resolución efectiva, ruido e incertidumbre con la meta de 20 mV.
La media por periodo requiere varias muestras sincronizadas; una sola muestra no reproduce automáticamente el promedio simulado. La configuración es de 12 bits, referencia nominal de 3.3 V y muestreo de 200 kHz; deben verificarse en la placa real.

Tabla I
CONFIGURADO EN FIRMWARE; VERIFICACIÓN FÍSICA PENDIENTE
Dato | Configuración; falta medir
MCU y reloj | STM32F103C8T6; 72 MHz
ADC | 12 bits; 3.3 V nominal; 200 kHz
Media; filtro | 20 muestras; RC de 0.75 us
PWM | 10 kHz; 7200 cuentas
Calibración y jitter | Pendiente
Instrumentos y fotografía | Pendiente

III. ALGORITMO Y TEMPORIZACIÓN
Se usa ek = rk − vˆo,k y se devuelve d

′
k = 1 − d

cmd
k
Verificar con osciloscopio la inversión del driver antes de conectar potencia.

uk = 0.5 + Kpek + zk,
d

cmd
k = clip(uk, 0.05, 0.95),
zk+1 = zk + γkek,

γk =

0, | uk ≥ 0.95, ek > 0,
0, | uk ≤ 0.05, ek < 0,
KiTs, en otro caso.

(2)

La rutina calcula la orden con la integral anterior y luego actualiza el estado. Cada 100 µs completa la media previa y precarga el PWM para el periodo siguiente (Fig. 1). Verificar latencia con un pin de diagnóstico y ausencia de interrupciones perdidas.

t

k − 1 | k | k + 1 | k + 2

media v¯k−1
cálculo
d

cmd
k
precarga: Ts

d

cmd
k

aplicado

Figura 1. Secuencia que debe reproducir la tarjeta: media, cálculo y aplicación retardada de la orden.

Tabla II
COEFICIENTES DISEÑADOS Y CARGADOS
Magnitud | Diseño / núcleo C | En tarjeta

Kp (V−1
) | 0.026165529 | Pendiente
Ki ((V s)−1
) | 78.496586 | Pendiente
KiTs (V−1
) | 0.007849659 | Pendiente
Ts (µs) | 100 | Pendiente
dm´ın; dm´ax | 0.05; 0.95 | Pendiente

El núcleo devuelve d

′ = 1 al deshabilitarse o enclavar fallo; detecta valores no finitos, tensiones fuera de rango y salida mayor que 8.5 V. Verificar apagado eléctrico real. La rutina no mide corriente ni sustituye la protección de sobrecorriente.

IV. PUESTA EN MARCHA Y REAJUSTE
Usar el montaje ya validado en lazo abierto, fuente limitada y referencia gradual. El firmware incorpora rampa de duty y transferencia al PI con ajuste de integral; falta verificarla en hardware. Verificar saturación, recuperación de la integral y apagado antes de alcanzar 6 V.
Si se requiere reajuste, actualizar Gd con parámetros medidos y considerar el retardo real. Recalcular la condición |K(jωc)Gd(jωc)| = 1, reducir cruce si el margen resulta insuficiente y conservar ganancias y capturas anteriores.

Tabla III
REGISTRO DE REAJUSTE
Dato | Antes | Después
Kp; Ki | Diseño | Pendiente
Cruce y margen | Diseño | Pendiente
Motivo y evidencia | — | Pendiente
Versión y fecha | Pendiente | Pendiente
V. INTEGRACIÓN IMPLEMENTADA Y PROTECCIÓN

PCB BUCK
J1: VIN / GND
J2: VOUT / GND
J3: control y sensor

Fuente 12 V limitada
Fusible externo 2 A

Carga externa
6 / 7.2 / 4.8 Ω

STM32 Blue Pill
externo
5 V desde PCB

ST-Link + USB-UART
externos
lógica 3.3 V

SWD: PA13/14 · UART: PA9/10

CONEXIONES PREVISTAS · MONTAJE PENDIENTE

J3 → MCU
3: PA8 PWM
4: PB0 RUN
5: PB1 RESET
6: PB10 fallo
7: PA0 ADC
9: 3.3 V
J3: 1 = 5 V; 2, 8 y 10 = GND

Figura 2. Interconexión prevista. MCU, programador, enlace serie y carga son externos a la PCB.

TIM1 genera PWM por PA8 y sincroniza TIM3; este dispara ADC1/PA0 cada 5 µs. DMA circular conserva dos bloques de 20 muestras. La interrupción TIM1 verifica bloque completo, promedia y precarga CCR para el siguiente periodo. La última conversión termina nominalmente a 97.667 µs. DWT vigila ejecución y el watchdog exige adquisición fresca. Estos tiempos proceden de la configuración y deben medirse.

Tabla IV
EVIDENCIA DE IMPLEMENTACIÓN
Elemento | Estado
Compilación ARM | ELF, BIN y HEX generados
Núcleo y runtime C | Pruebas nativas y sanitizadores superadas
Captura serie | Cuatro pruebas automatizadas superadas
Programación / tiempo real | Pendiente en MCU
ADC / protección / térmica | Pendiente en laboratorio

INA180A1 amplifica el shunt; LM393 activa un enclavamiento HCT00 por sobrecorriente o sobretensión. RUN bajo fuerza SD alto y deshabilita IR2110. El disparo tiene prioridad sobre RESET. Los umbrales nominales son 2 A y 8.2 V; la evaluación estática de tolerancias da 1.825–2.184 A y 7.561–8.868 V. Deben comprobarse retardo y disparo real. Se requiere fusible externo de 2 A y fuente limitada.
El enlace UART de 115200 baudios exporta las capturas después de detener RUN. Las 512 medias se guardan con duty aplicado y referencia; no equivalen al rizado instantáneo, que exige osciloscopio. Los escalones de carga manuales requieren captura con pretrigger. Conservar CSV crudos, calibración y versión de firmware junto a cada ensayo.

VI. ENSAYOS DE ACEPTACIÓN
Ejecutar por separado r : 6 → 7 V, r : 6 → 5 V, R : 6 → 7.2 Ω y R : 6 → 4.8 Ω, estos últimos con r = 6 V. Regresar al nominal y realizar tres repeticiones por caso. Capturar referencia, tensión, orden y carga desde 5 ms antes hasta al menos 20 ms después.
Usar e∞ = rf − media(¯vo) en una ventana final declarada. Medir ts con banda ±20 mV en referencia y ±0.12 V en carga. Medir sobreimpulso porcentual en referencia, pico m´ax |v¯o−6| en carga y rizado instantáneo.

Tabla V
RESULTADOS FÍSICOS; P = PENDIENTE
Caso | ts (ms) | |e∞| (mV) | Mp/pico | Rizado (V)
6 → 7 V | P | P | P | P
6 → 5 V | P | P | P | P
R : +20 % | P | P | P | P
R : −20 % | P | P | P | P

Agregar duty mínimo y máximo, corriente máxima, incertidumbre y dispersión. Comparar con la entrega 3 y explicar cuantización, latencia, pérdidas y saturación. Todo reajuste exige repetir los cuatro casos conservando el antes y después.

VII. ESTADO Y CONCLUSIÓN EXPERIMENTAL
Faltan montaje identificado, firmware cargado en MCU, calibración, medición de temporización y apagado, y doce capturas mínimas. La simulación sustenta el ajuste inicial, pero no demuestra desempeño físico.

APÉNDICE A
EVIDENCIA REPRODUCIBLE
Conservar firmware, buck_control.c, configuración de temporizador, calibración y CSV originales. El protocolo está en project/hardware/implementacion.md. El analizador compara el modelo promediado con duty y carga registrados; la evaluación del controlador debe añadir las métricas de aceptación y su incertidumbre.

REFERENCIAS

[1] J. D. Bastidas Rodríguez, “Proyecto de Curso: Convertidor Buck con control de tensión de salida, Universidad Nacional de Colombia, mayo 2025, pp. 1–3.
