almondsun/DynamicSystemsAndControl/project/pcb/redesign/netclass_assignments.csv

Net | Netclass | Track_target_mm | Clearance_mm | Via_diameter_mm | Via_drill_mm | Review
+5V | SUPPLY_5V | 0.5 | 0.25 | 0.8 | 0.4 | Preliminary
BOOT | GATE_DRIVER | 0.5 | 0.25 | 0.6 | 0.3 | Preliminary
DPRIME | DIGITAL_CONTROL | 0.25 | 0.2 | 0.6 | 0.3 | Preliminary
FAULT | DIGITAL_CONTROL | 0.25 | 0.2 | 0.6 | 0.3 | Preliminary
FB | DIGITAL_CONTROL | 0.25 | 0.2 | 0.6 | 0.3 | Preliminary
GATE | GATE_DRIVER | 0.5 | 0.25 | 0.6 | 0.3 | Preliminary
GND | POWER_GND | 0.25 | 0.2 | 0.8 | 0.4 | GND power return uses plane/manual review
HIN | DIGITAL_CONTROL | 0.25 | 0.2 | 0.6 | 0.3 | Preliminary
HO | GATE_DRIVER | 0.5 | 0.25 | 0.6 | 0.3 | Preliminary
IP | POWER_INDUCTOR | 2.0 | 0.25 | 0.8 | 0.4 | IP/VOUT Kelvin branches require manual width review
ISENSE | ANALOG_SENSE | 0.25 | 0.25 | 0.6 | 0.3 | Preliminary
LMID | POWER_INDUCTOR | 2.0 | 0.25 | 0.8 | 0.4 | Preliminary
MCU_PWM | DIGITAL_CONTROL | 0.25 | 0.2 | 0.6 | 0.3 | Preliminary
NFAULT | DIGITAL_CONTROL | 0.25 | 0.2 | 0.6 | 0.3 | Preliminary
NFAULT_MCU | DIGITAL_CONTROL | 0.25 | 0.2 | 0.6 | 0.3 | Preliminary
NRESET | DIGITAL_CONTROL | 0.25 | 0.2 | 0.6 | 0.3 | Preliminary
NTRIP | DIGITAL_CONTROL | 0.25 | 0.2 | 0.6 | 0.3 | Preliminary
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
