almondsun/DynamicSystemsAndControl/classroom/9 The Root-Locus Design Method.pdf

# The Root-Locus Design Method

# Professor: Juan David Bastidas Rodríguez Reference book for the presentation: Feedback Control of Dynamic Systems, 8th Edition, Franklin • Powell • Emami-Naeini, Pearson, 2019, ISBN: 978-0-13-468571-7

# Content

# 1. Root Locus of a Basic Feedback System 2. Guidelines for Determining a Root Locus 3. Selected Illustrative Root Loci 4. Design Using Dynamic Compensation 5. Design Examples Using the Root Locus

Sistemas Dinámicos y Control - 2025-1. Juan D. Bastidas
R. 2

# 1. Root Locus of a Basic Feedback System

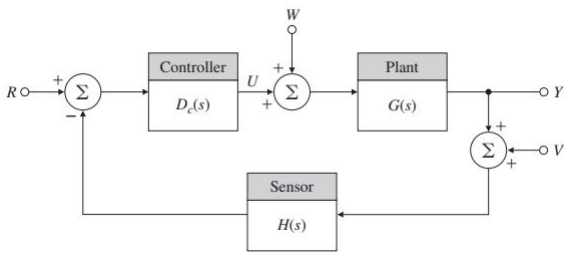
[picture p26: figure]

# 1. Put the characteristic equation in a polynomial form 2. Select the parameter of interest K 3. We can define component polynomials a(s) and b(s) such that

# the characteristic equation is a(s) + Kb(s) = 0 4. We then define the transfer function L(s) so that the characteristic equation can be written as =>

R. 3

# 1. Root Locus of a Basic Feedback System

# •Usually K is the gain of the controller then:

# - L(s) is proportional to Dc(s)G(s)H(s)

•Evans proposed: to plot the locus of all possible roots of the characteristic equation for 0 < K < ∞ to determine the best value of K - Studying the effects of additional poles and zeros on this plot, we can determine the consequences of additional dynamics added to Dc(s) (design of the controller) •The plot is named root locus •The rules to construct the root locus is called Evan’s method

R. 4

# 1. Root Locus of a Basic Feedback System

# Assuming

# - b(s) and a(s) are monic (the coefficient of the highest power of s is 1) - b(s) is degree m and a(s) is degree n with m

≤ n

# - The roots of b(s) = 0 are the zeros of L(s)

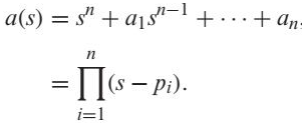
[picture p27: figure]

=> zi

# - The roots of a(s) = 0 are the poles of L(s)

=> pi

# - The root of a(s) + Kb(s) = 0 are the poles of the closed-loop system => r

i

R. 5

# 1. Root Locus of a Basic Feedback System

# There are different ways to write the characteristic equation of the closed-loop

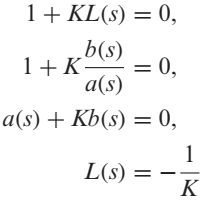
[picture p28: figure]

# system •Root-locus form or Evans form

# - Where K > 0

# - For each value of K there is a set of roots of the characteristic equation

R. 6

# 1. Root Locus of a Basic Feedback System

# Example: Root Locus of a Motor Position Control

# Solve for the root locus of closed-loop poles of the system created by feeding back the output θ

m

# with respect to the parameter A if Dc(s) = H(s) = 1 and also c

= 1.

R. 7

# 1. Root Locus of a Basic Feedback System

# Example: Root Locus of a Motor Position Control

R. 8

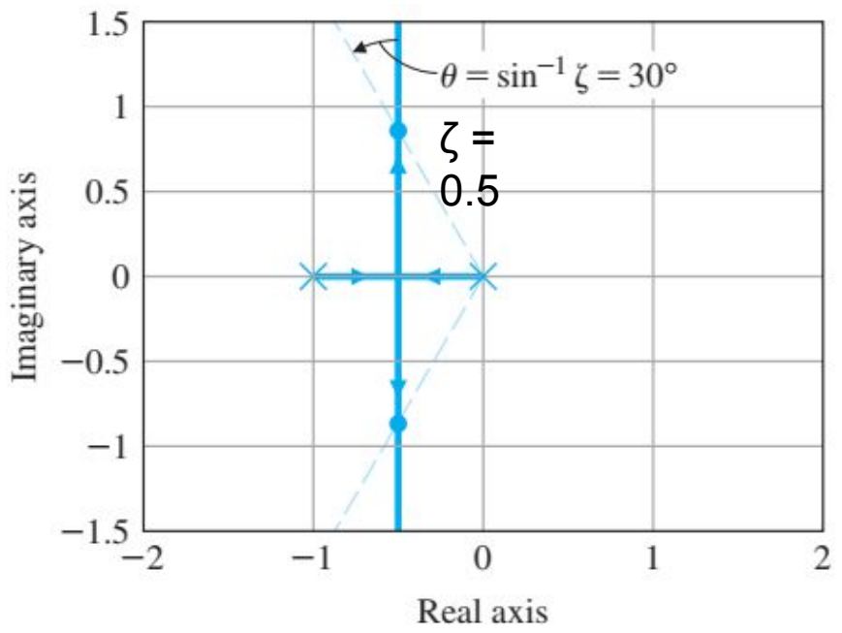
[picture p29: figure]

## To find wd

## for ζ = 0.5 (intersection):

wd

## = (½)/tan(30°) = √3/2 Then, K = 1

# 1. Root Locus of a Basic Feedback System

# Example: Root Locus of a Motor Position Control

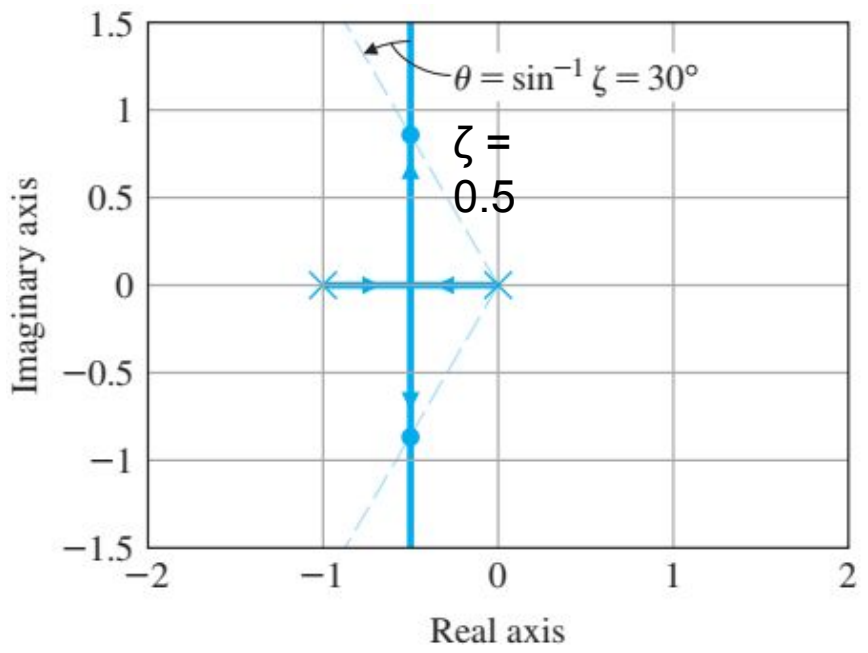
[picture p30: figure]

- There are two roots, thus, two loci which we call branches of the root locus - For K = 0 (open-loop) the branches begin at 0 and -1 (open-loop poles) - As K is increased, the roots move toward each other, coming together at s = −1/2 ( breakaway point) - The roots move off to ∞ with equal real parts (the sum is always −1)

R. 9

# 1. Root Locus of a Basic Feedback System

# Example: Root Locus of a Motor Position Control

# - Modifying K we change the location of the closed-loop poles but with the same settling time for complex poles - If the dynamic response is satisfactory =>

we define K for a desired ζ; otherwise,

# we require a more complex controller

# - The same logic can be applied for other parameters of the system that enters linearly in the characteristic equation

R. 10

# 1. Root Locus of a Basic Feedback System

# Example: Root Locus with Respect to Plant Open-Loop Pole and Zero

# With Dc(s) = H(s) = 1, find the root locus of the characteristic equation with respect

to c.

R. 11

# 1. Root Locus of a Basic Feedback System

# Example: Root Locus with Respect to Plant Open-Loop Pole and Zero

# With Dc(s) = H(s) = 1, find the root locus of the characteristic equation with respect

to c.

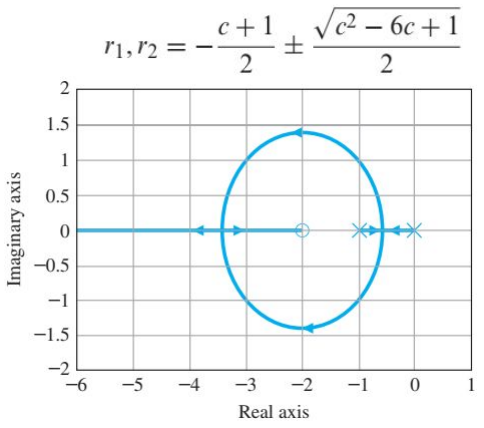
[picture p31: figure]

R. 12

## The root-locus form

# 1. Root Locus of a Basic Feedback System

# Example: Root Locus with Respect to Plant Open-Loop Pole and Zero

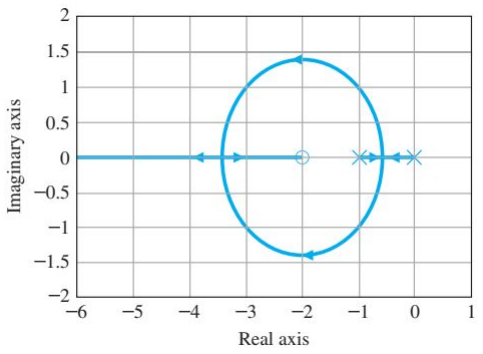
[picture p32: figure]

# - When c² − 6c + 1 < 0, the roots become complex, when 0.172 < c < 5.828 - When c < 0.172, the roots are on the real axis between s = 0 and −1 points - There are two roots at

## - s = −0.586, when c = 0.172 (breakaway point) - s = −3.41 when c = 5.828 (break-in point)

# - When c > 5.828, the two locus segments move in opposite along the real axis

## - One to ∞ - One to the zero

R. 13

# 1. Root Locus of a Basic Feedback System

# •Root locus can be done by Matlab (rlocus(G))

In control design we are interested in: •How a controller modifies the dynamics of the closed-loop system - Propose a controller that will meet the dynamic response specifications a required closed-loop performance •Evaluate the correctness of a computer-generated locus •It is difficult the generate the root locus for more complex systems (when the characteristic equation is order 3 or higher)

R. 14

# 2. Guidelines for Determining a Root Locus

# Guidelines for Determining a Root Locus

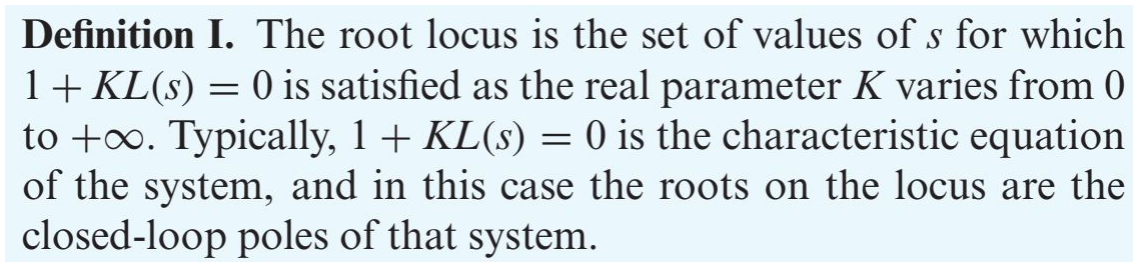
[picture p33: figure]

R. 15

# 2. Guidelines for Determining a Root Locus

# Guidelines for Determining a Root Locus

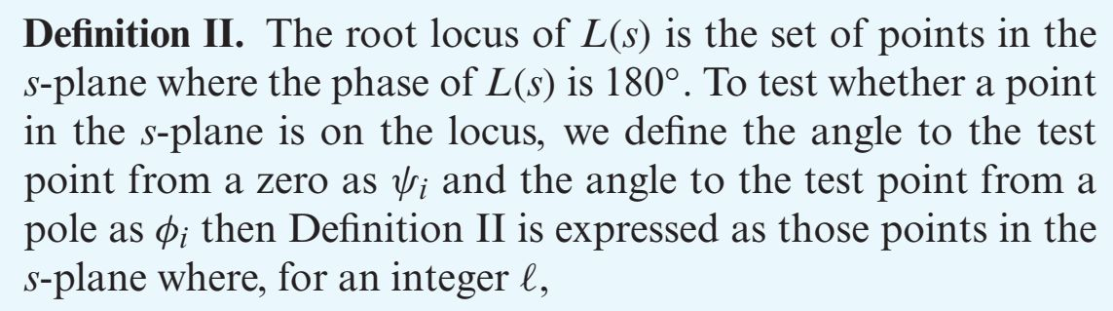
[picture p34: figure]

R. 16

# Guidelines for Determining a Root Locus

# - The importance of Definition II: while it is very difficult to solve a high-order polynomial by hand, computing the phase of a transfer function is relatively easy

- The usual case: K is real and positive => positive or 180° locus.

# - Other case: K is real and negative => negative or 0° locus

# - We can determine a positive root locus for a complex transfer function by measuring the phase and marking those places where we find 180◦

R. 17

# 2. Guidelines for Determining a Root Locus

# 2. Guidelines for Determining a Root Locus

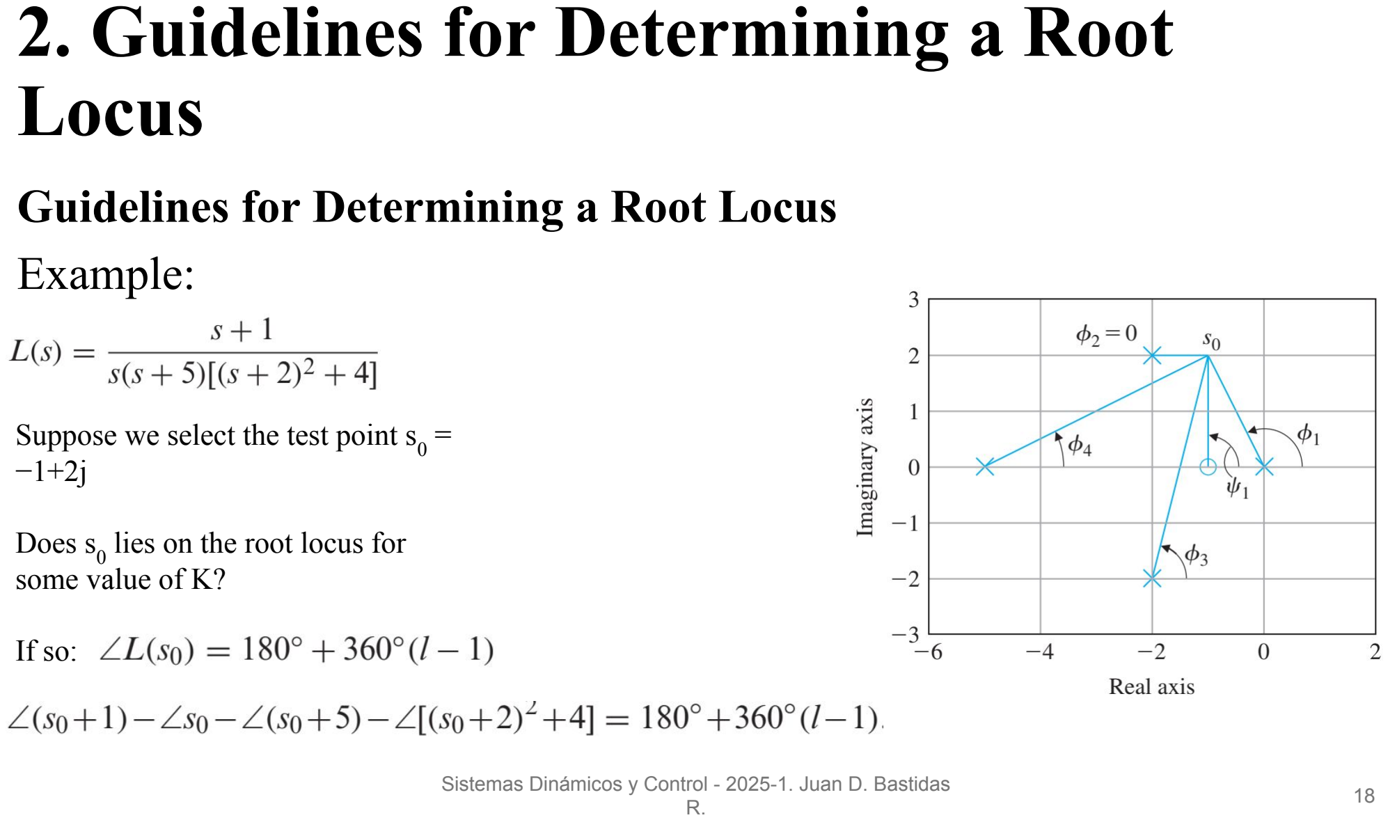
[picture p35: page 18]

# Guidelines for Determining a Root Locus

# Example:

R. 18

## Suppose we select the test point s0

=
−1+2j

## Does s0

## lies on the root locus for some value of K?

## If so:

# Guidelines for Determining a Root Locus

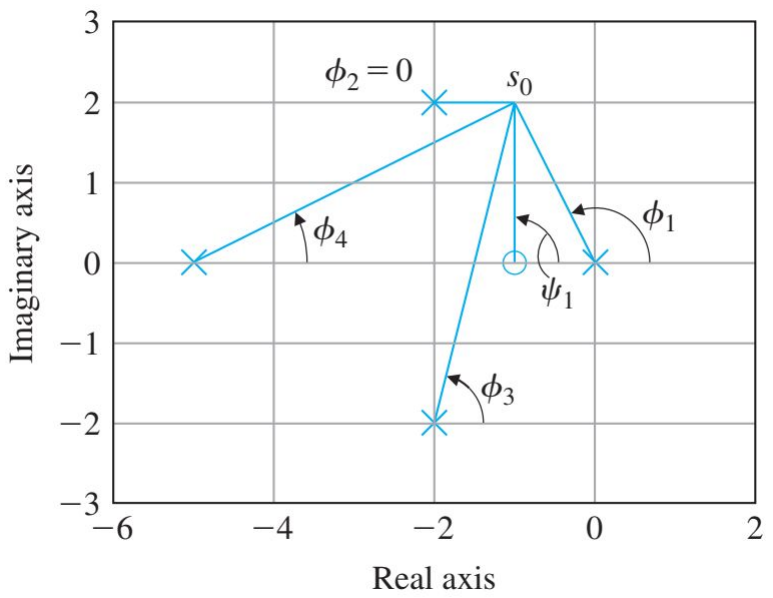
[picture p36: figure]

# Example:

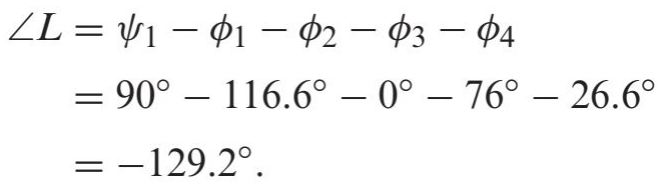
[picture p37: figure]

R. 19

## - The angle from the zero term s0 +1 can be computed by drawing a line from the location of the zero at −1 to the test point s0

=> ψ1

## and ψ1

= 90°

## - The same approach can be used for the angles from each pole to

s0

## - Angle of L(s) is not 180° => s0 is not on the root locus - Try another point on the plane => not practical

# We need guidelines

# 2. Guidelines for Determining a Root Locus

# Guidelines for Determining a Root Locus

# •Evans developed 5 rules

# - Rules 1 – 3 are commonly used - Rules 4 and 5 used occasionally

R. 20

# 2. Guidelines for Determining a Root Locus

# Guidelines for Determining a Root Locus: Rule 1: The n branches of the locus start at the poles of L(s) and m

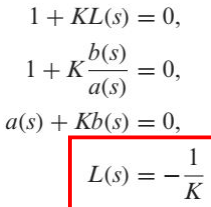
[picture p38: figure]

of these branches end on the zeros of L(s).

# - If K = 0 => characteristic eq. is a(s) = 0 (poles of L(s)) - When K -> ∞

# - b(s) = 0 or

- s → ∞

# - Since there are m zeros where b(s) = 0, m branches can end in those zeros

R. 21

# 2. Guidelines for Determining a Root Locus

# 2. Guidelines for Determining a Root Locus

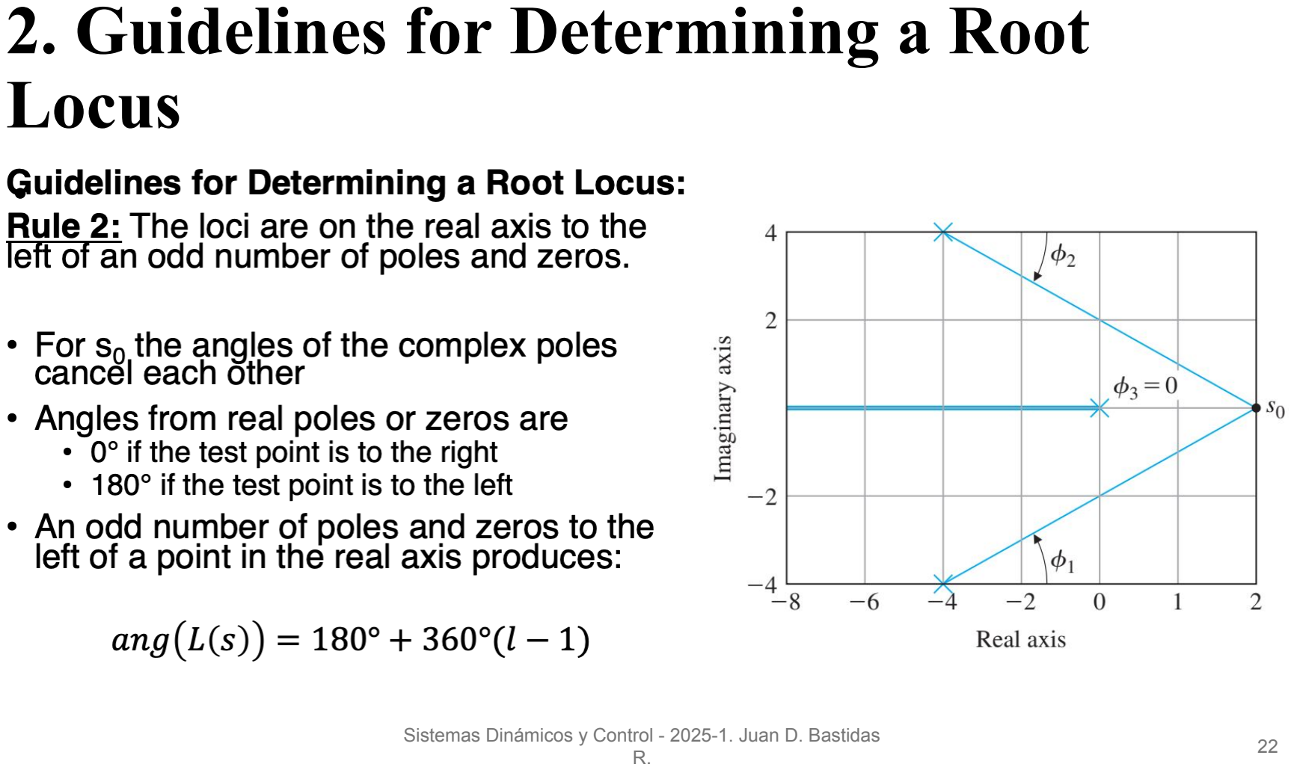
[picture p39: page 22]

•

R. 22

# Guidelines for Determining a Root Locus:

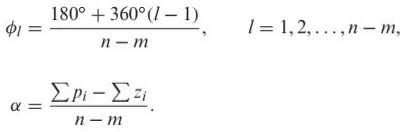
[picture p40: figure]

# Rule 3 (for n > m, more poles than zeros in L(s)): For large

# values of s and K, n − m branches of the loci are asymptotic to lines at angles φl

# radiating out from the point s = α on the real axis, where

R. 23

# 2. Guidelines for Determining a Root Locus

# Guidelines for Determining a Root Locus: Rule 3 (for n>m): Explanation

# - Ch. Eq. L(s) = -1/K for K -> ∞ can be satisfied only if

## - L(s) = 0 (at zeros of L(s))

- s -> ∞

# - L(s) = b(s)/a(s) can be forced to

# approximate the form L(s) ≈ 1/(s-

α)

n-m

## - i.e. n-m poles at s = α

## - Like seen the poles and zeros with a zoom-out - m zeros cancel the effect of the n

## poles

R. 24

## L(s) ≈ 1/(s-α)

## n-m can be obtained by calculating a(s)/b(s) and matching the dominant two terms (highest powers in s) to the expansion of (s − α)n−m

## The locus of (1) is asymptotic to the locus of (2) when K -> ∞ and s -> ∞

(1)

(2)

# 2. Guidelines for Determining a Root Locus

## Guidelines for Determining a Root Locus: Rule 3 (for n>m): Explanation

## - For L(s) ≈ 1/(s-α)

n-m

## - Evaluating if a point s0

## = Rejφ is in the locus (with R large and φ variable) - All the n-m poles produce the same angle φl

- s0

## is in the locus if (n-m)*φl

= 180° + 360◦(l − 1)

## - With l = 1, …, n-m

## - The lines of the asymptotic locus come from s0 = α on the real axis

## - How to calculate α?

R. 25

# 2. Guidelines for Determining a Root Locus

Guidelines for Determining a Root Locus: Rule 3 (for n>m): Explanation

### - How to determine α?

- With some properties of polynomials

### - Expanding the right side

- Coefficient of sn−1 is −p1
− p2

− · · · − p
n

### - From the left side

- Coefficient of sn−1 is a1

### - The same analysis can be done for the numerator b(s)

### - The sum of the closed-loop roots (ri ) is the negative of the coefficient of sn−1

- This coefficient is independent of K if m < n − 1
- The center point of the roots does not change with K if m < n − 1
R. 26

## The characteristic equation can be written as:

## if m < n − 1

## Then:

# 2. Guidelines for Determining a Root Locus

# Guidelines for Determining a Root Locus: Rule 3 (for n>m): Explanation

# - Center point of a monic (coefficient 1 for sn

# higher

# power) polynomial: is the average of its roots (or the centroid or geometric center of the roots in the complex plane)

R. 27

## The center point can be calculated as follows:

## Option 1:

## Option 2:

# 2. Guidelines for Determining a Root Locus

# Guidelines for Determining a Root Locus: Rule 3 (for n>m): For large values of K the n

# closed-loop roots (ri

# ) go to:

# - m roots (ri ) approach the m zeros (zi

)

# - n − m roots (ri ) approach the

# asymptotic system of 1/(s−α)n−m

(at ∞)

R. 28

## Solving α:

Note that | and | only require the
real parts.

## Imaginary parts of the complex conjugate

poles cancel eachother.

# 2. Guidelines for Determining a Root Locus

# Guidelines for Determining a Root Locus: Example

# •Rule 1: 3 poles => 3 branches that end in ∞ (0 zeros) •Rule 2: there is locus to the left of an odd number of poles and zeros

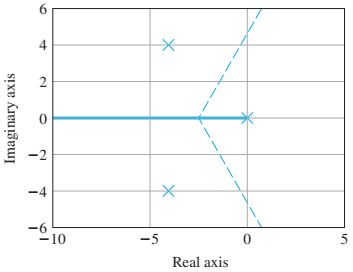
[picture p41: figure]

R. 29

# 2. Guidelines for Determining a Root Locus

# Guidelines for Determining a Root Locus: Example

# •Rule 3: calculate α (starting point of the asymptotes)

- pi
: 0, -4+4j, -4-4j
- z
i

# : no zeros

- n = 3, m = 0

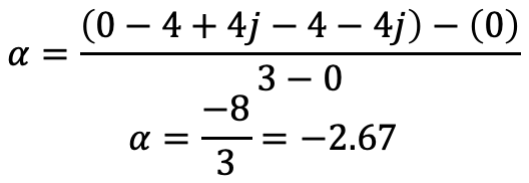
[picture p42: figure]

R. 30

# 2. Guidelines for Determining a Root Locus

# 2. Guidelines for Determining a Root Locus

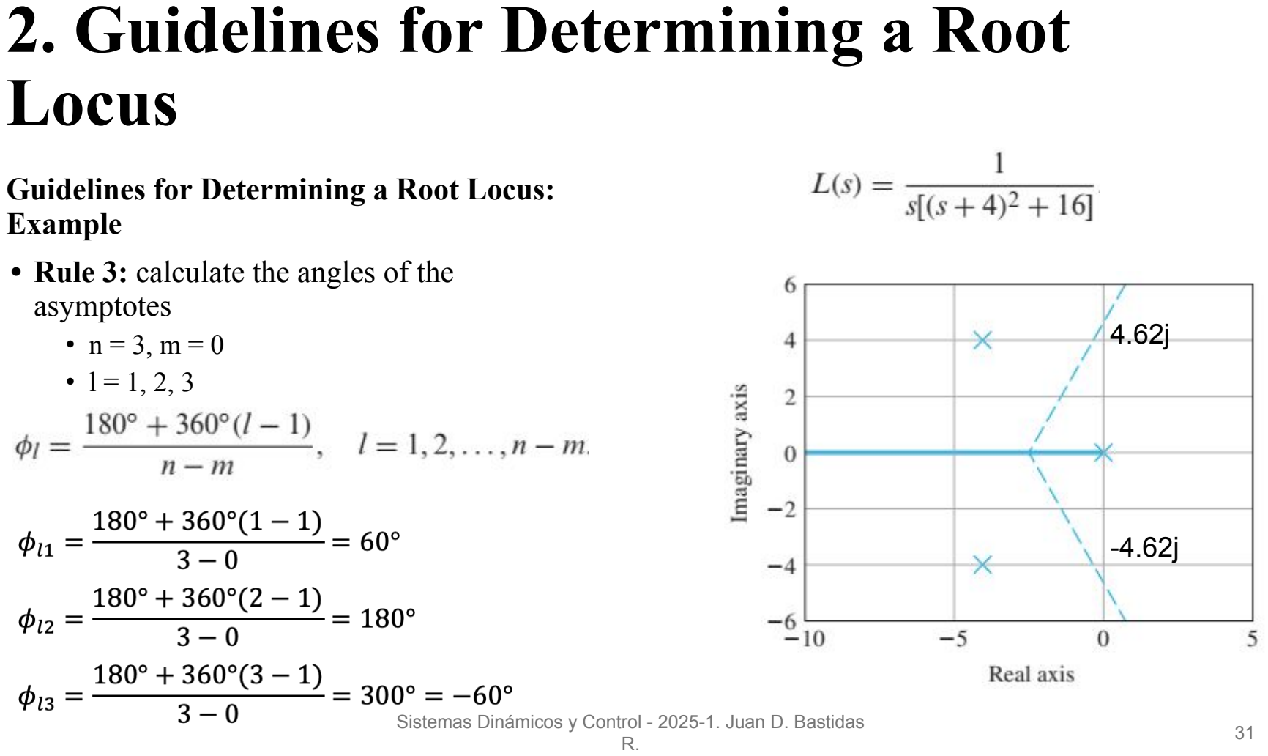
[picture p43: page 31]

## Guidelines for Determining a Root Locus: Example

## - Rule 3: calculate the angles of the asymptotes

- n = 3, m = 0
- l = 1, 2, 3
R. 31

4.62j

-4.62j

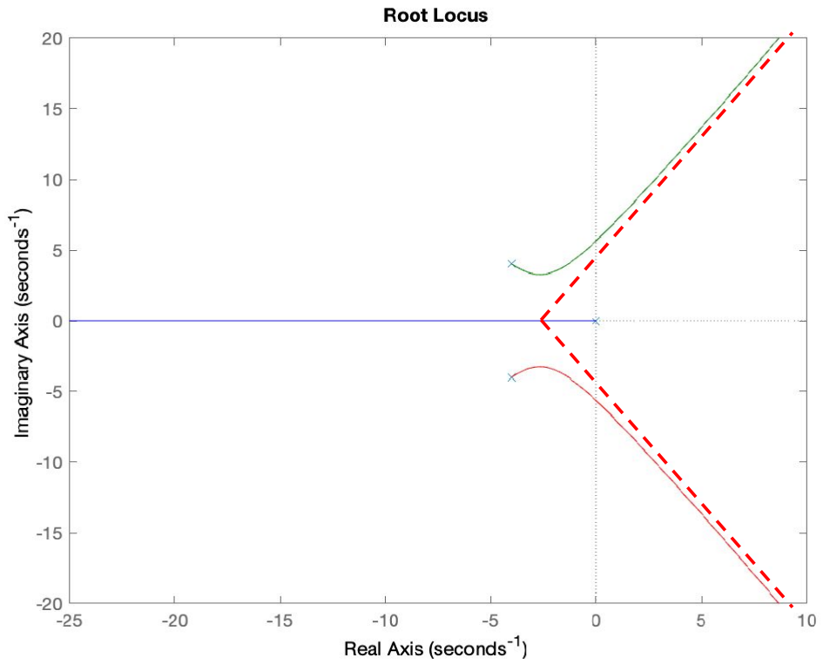
[picture p44: figure]

# Guidelines for Determining a Root Locus: Example •Matlab: rlocus(G)

R. 32

s=tf('s');
G=1/(s*((s+4)^2 + 16));
rlocus(G);

# 2. Guidelines for Determining a Root Locus

# Guidelines for Determining a Root Locus:

# Rule 4: The angle of departure of a branch of the locus from a single pole is

given by the equation.

# The angles of departure for repeated poles with multiplicity, q, is given the

equation.

# q branches depart from a pole with

# multiplicity q

R. 33

## Sum of the angles to the

## remaining poles

## Sum of the angles to all the zeros

l is an integer l = 1, 2, ... , q.

## Excep the analized pole (the one we are calculating the angle of departure)

# 2. Guidelines for Determining a Root Locus

# Guidelines for Determining a Root Locus:

# Rule 4: The angle(s) of arrival of a branch at a zero with multiplicity q is given by the equation

# q branches arrive to a zero with

# multiplicity q

R. 34

l is an integer l = 1, 2, ... , q.

## Sum of the angles to all the poles

## Sum of the angles to the

## remaining zeros

## Excep the analized zero (the one we are calculating the angle of arrival)

# 2. Guidelines for Determining a Root Locus

# Guidelines for Determining a Root Locus:

# Rule 4: Example

# - Consider a test point s0

# very near

# the pole x (analyzed) - The angle from pole x to s0

: φ1

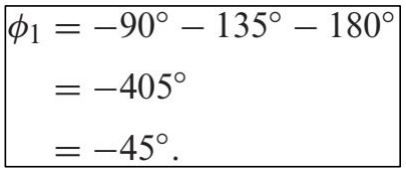
[picture p45: figure]

# - Considering the example

# - (1) must be fulfilled for a point in the locus - l = 1 (multiplicity of the poles) - Leaving φ1 to the right of (1) and the rest of the terms to the left

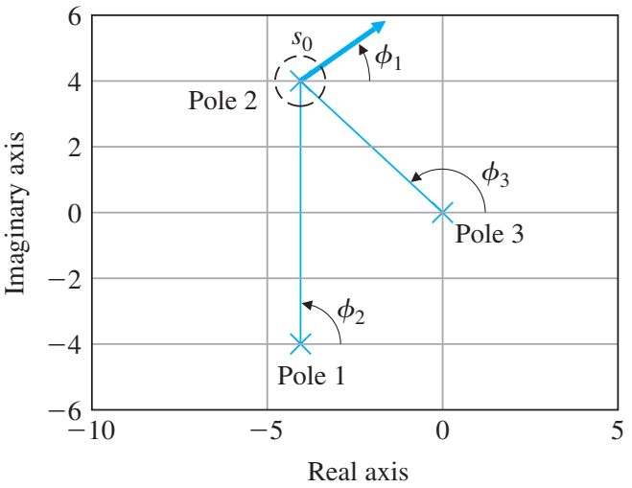
[picture p46: figure]

R. 35

(1)

# 2. Guidelines for Determining a Root Locus

# Guidelines for Determining a Root Locus: Rule 5:

# - The locus can have multiple roots at points on the locus and the branches will approach a point of q roots at angles separated by

# - and will depart at angles with the same separation

R. 36

# 2. Guidelines for Determining a Root Locus

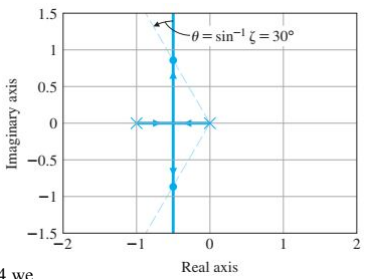
[picture p47: figure]

# Guidelines for Determining a Root Locus:

# Rule 5: Example

•K1
= ¼
•K = 1/4 + K2
R. 37

## Using the equation of Rule 4 we calculate the “departure” angles

# 2. Guidelines for Determining a Root Locus

# 2. Guidelines for Determining a Root Locus

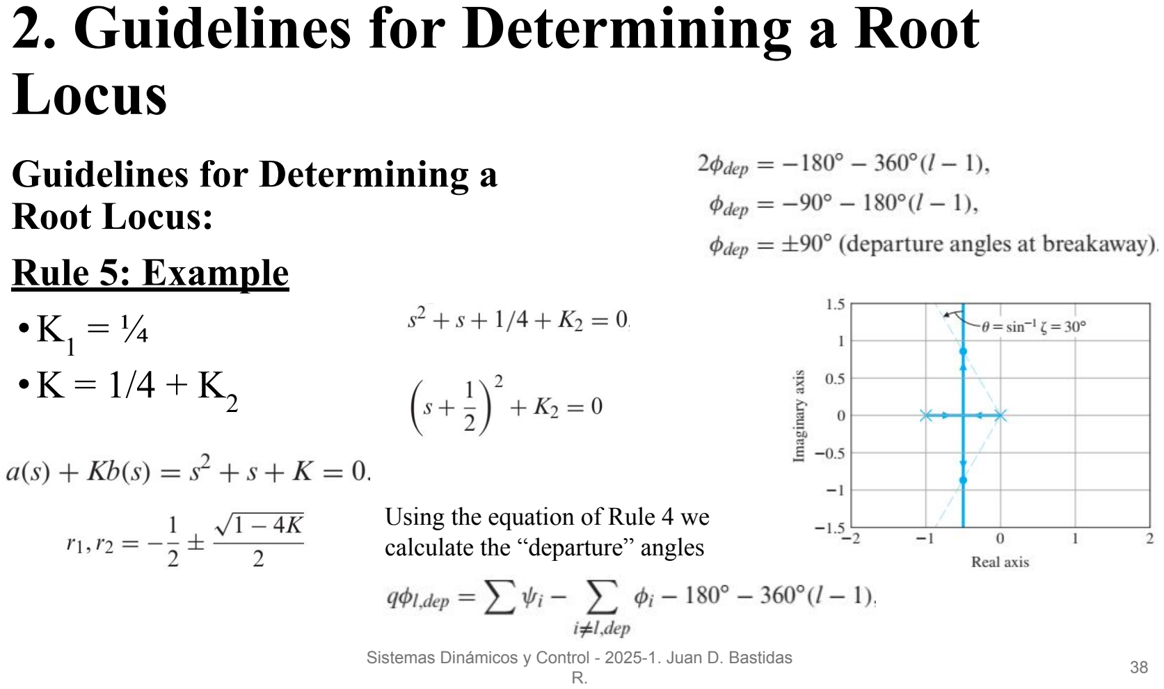
[picture p48: page 38]

# Guidelines for Determining a Root Locus:

# Rule 5: Example

•K1
= ¼
•K = 1/4 + K2
R. 38

## Using the equation of Rule 4 we calculate the “departure” angles

## Summary

## - RULE 1. The n branches of the locus start at the poles of L(s)

and m branches end on the zeros of L(s).

## - RULE 2. The loci are on the real axis to the left of an odd

number of poles and zeros.

## - RULE 3. For large s and K, n − m branches of the loci are asymptotic to lines at angles φl

## radiating out from the center

point s = α on the real axis (see (1) and (2).

## - RULE 4. The angle(s) of departure of a branch of the locus

from a pole of multiplicity q is given by (3), where l = 1, 2, ...

## , q and the angle(s) of arrival of a branch at a zero of

multiplicity q is given by (4).

## - RULE 5. The locus can have multiple roots at points on the locus of multiplicity q. The branches will approach to/depart from a point of q roots at angles separated by the angles given in (5), where l = 1, 2, ... , q

R. 39

# 2. Guidelines for Determining a Root Locus

(1)

(2)

(3)

(4)

(5)

# Selecting the Parameter Value

# •Option 1: using Matlab (example)

R. 40

# 2. Guidelines for Determining a Root Locus

s=tf('s');
G=1/(s*((s+4)^2 + 16));
rlocus(G);

[K,p] = rlocfind(G);

sisotool('rlocus',G);

# 2. Guidelines for Determining a Root Locus

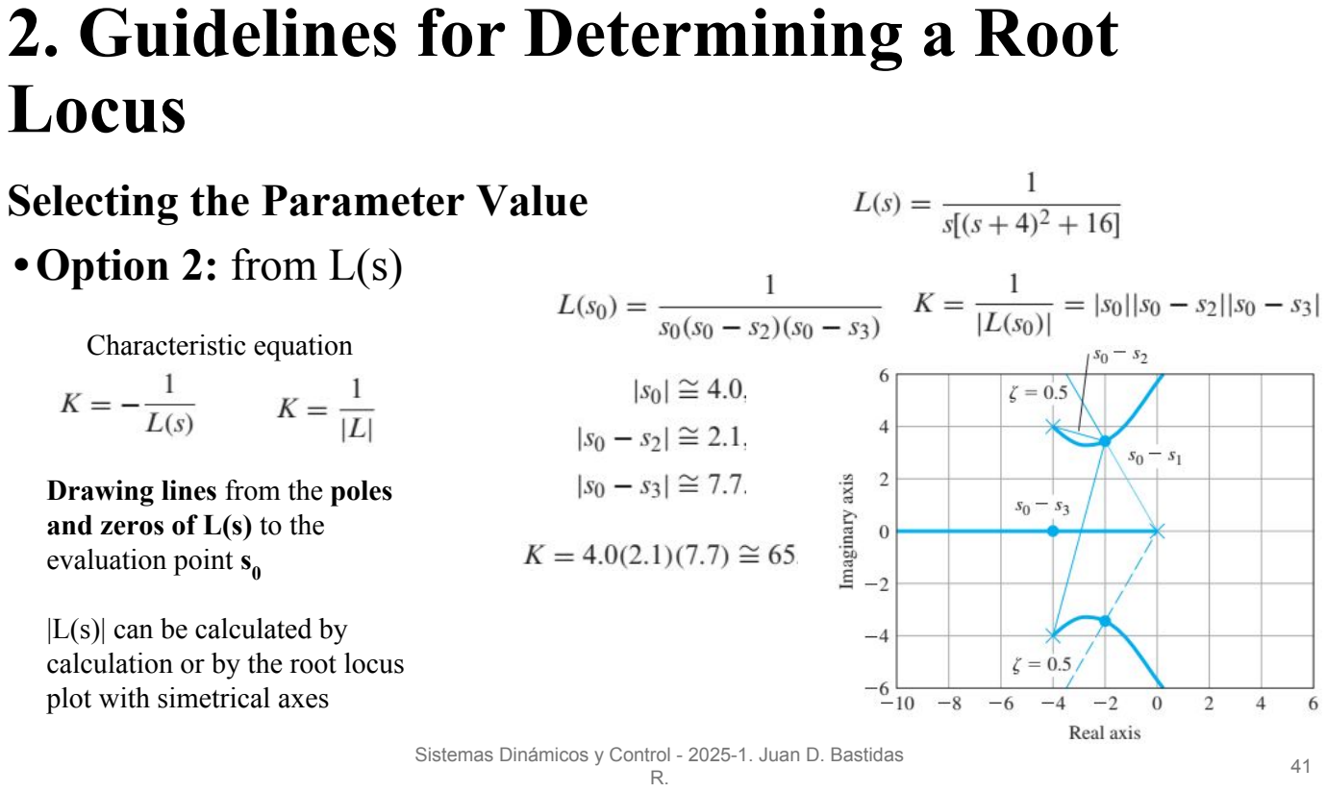
[picture p49: page 41]

# Selecting the Parameter Value

# •Option 2: from L(s)

R. 41

## Characteristic equation

## Drawing lines from the poles and zeros of L(s) to the

## evaluation point s0

## |L(s)| can be calculated by calculation or by the root locus plot with simetrical axes

# Example: Root Locus for Satellite Attitude Control with PD Control

R. 42

# 3. Selected Illustrative Root Loci

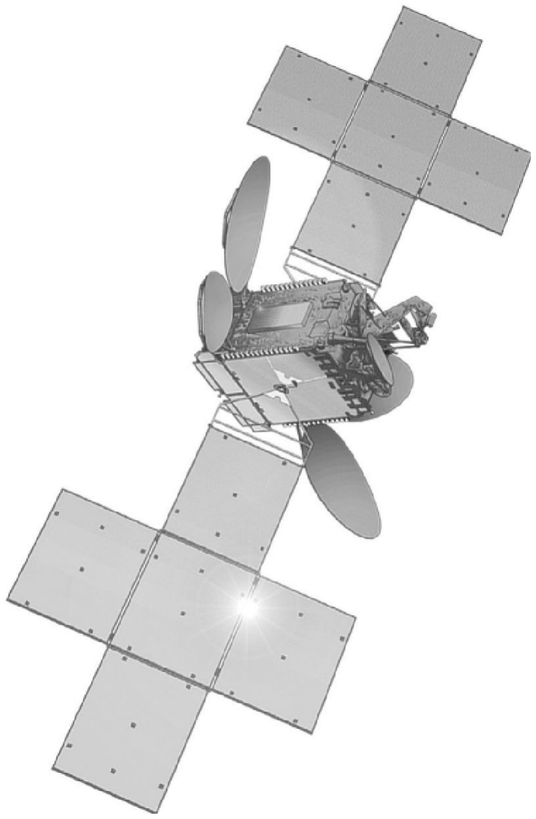
[picture p50: figure]
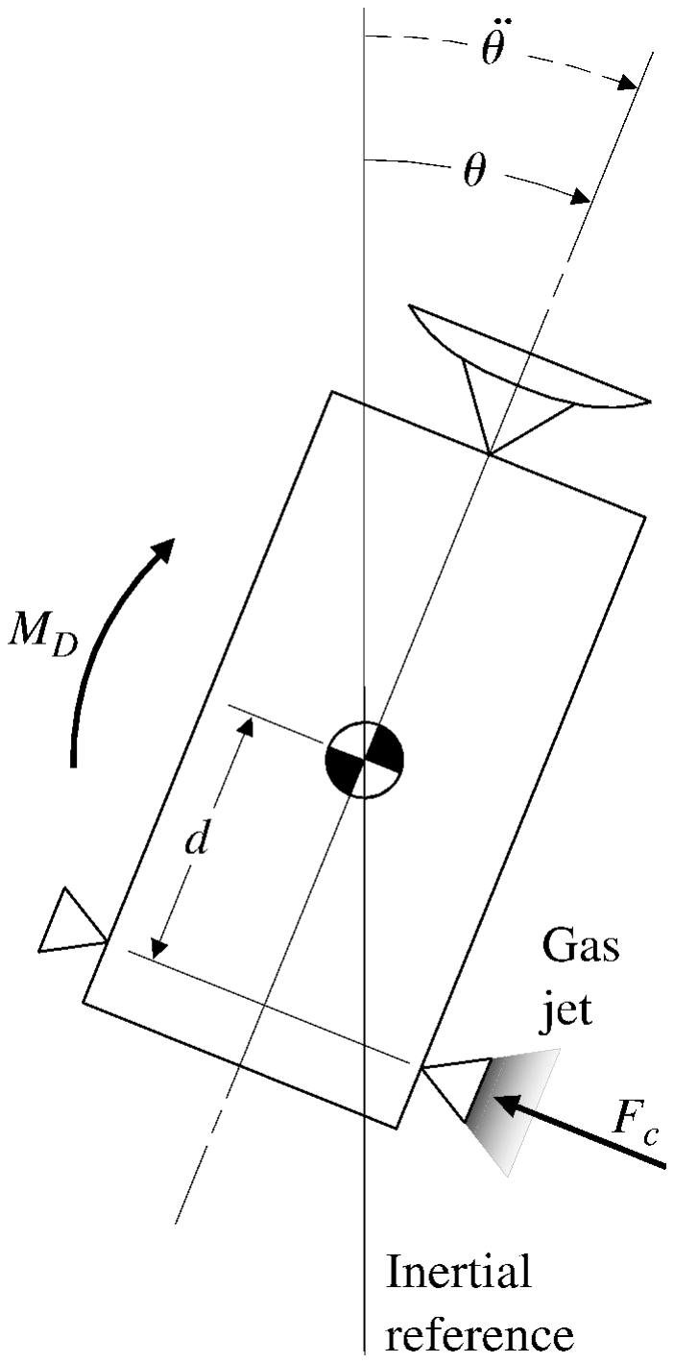
[picture p51: figure]

## To obtain θ => integrate the sum of the input torques twice (double-integrator plant)

## Substituting U = Fcd + MD

## and s for d/dt

## Assuming I = 1

# Example: Root Locus for Satellite Attitude Control with PD Control

R. 43

# 3. Selected Illustrative Root Loci

## - We define K = kD - We arbitrarily select the gain ratio as

k
p

/kD

## = 1 (this ratio can be defined depending on the rise time)

## Characteristic equation (closed-loop)

## Characteristic equation (closed-loop) with

k
p

/kD
= 1

# Example: Root Locus for Satellite Attitude Control with PD Control

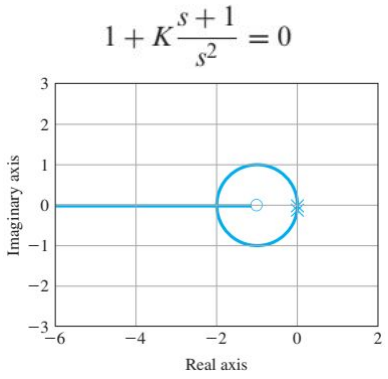
[picture p52: figure]

R. 44

# 3. Selected Illustrative Root Loci

## - We define K = kD - We arbitrarily select the gain ratio as

k
p

/kD

## = 1 (this ratio can be defined depending on the rise time)

## Characteristic equation (closed-loop)

# Example: Root Locus for Satellite Attitude Control with PD Control

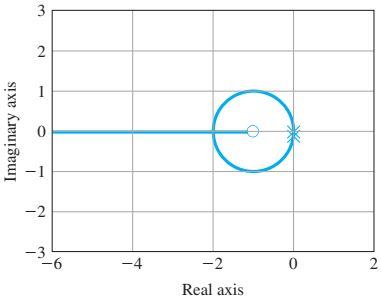
[picture p53: figure]

R. 45

# 3. Selected Illustrative Root Loci

# - The addition of the zero has pulled the locus into the LHP

# - Important in constructing a compensation

# Example: Root Locus of the Satellite Control with Modified PD or Lead Compensation

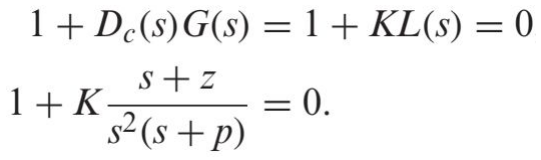
[picture p54: figure]

R. 46

# 3. Selected Illustrative Root Loci

## - To implement the PD it is necessary to add a pole p

## - p need to be far from the poles and zeros of the plant and the controller

- Defining | Lets analyze the following cases: p = 12 (pole at s = -12) p = 4 (pole at s = -4) p = 9 (pole at s = -9)

# Example: Root Locus of the Satellite Control with Modified PD or Lead Compensation

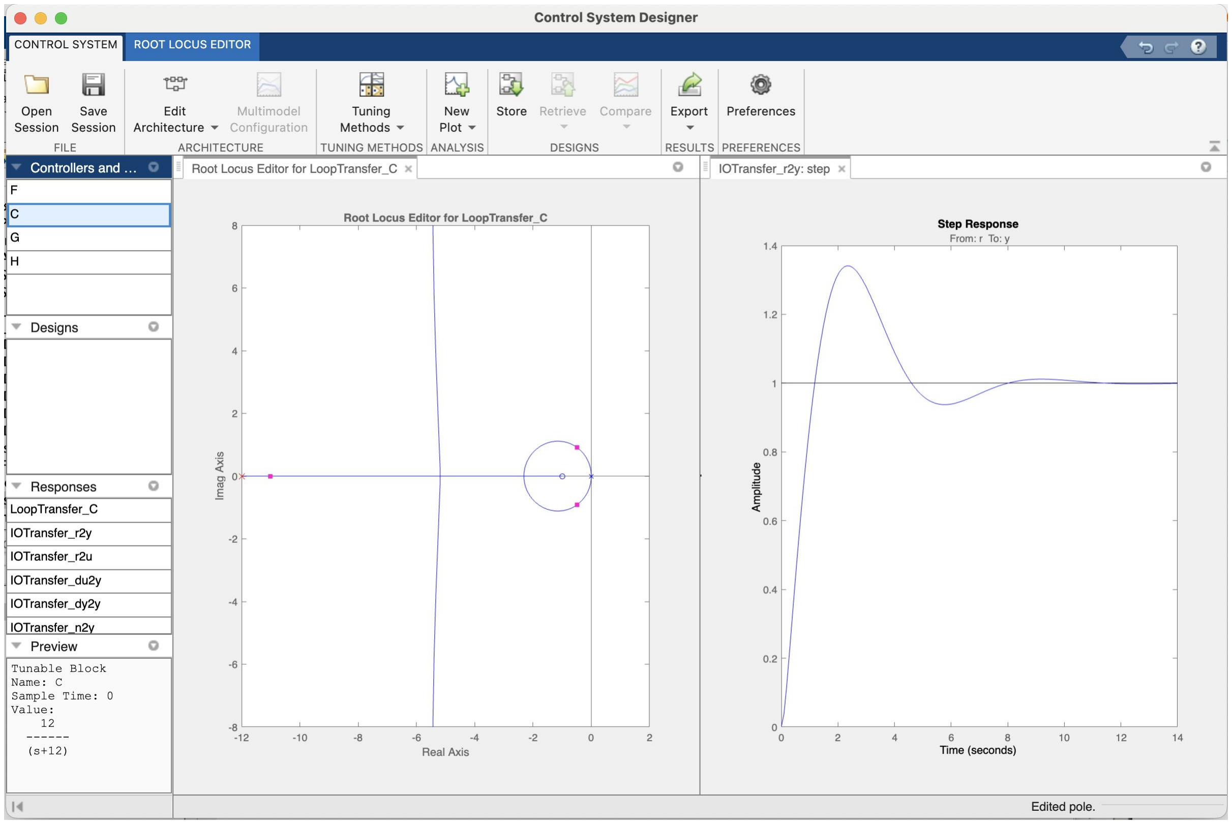
[picture p55: figure]

R. 47

# 3. Selected Illustrative Root Loci

## With z = 1

## p = 12 (pole at s = -12) p = 4 (pole at s = -4) p = 9 (pole at s = -9)

s=tf('s');
G=(s+1)/(s^2);

sisotool('rlocus',G);

# Example: Root Locus of the Satellite Control with Modified PD or Lead Compensation

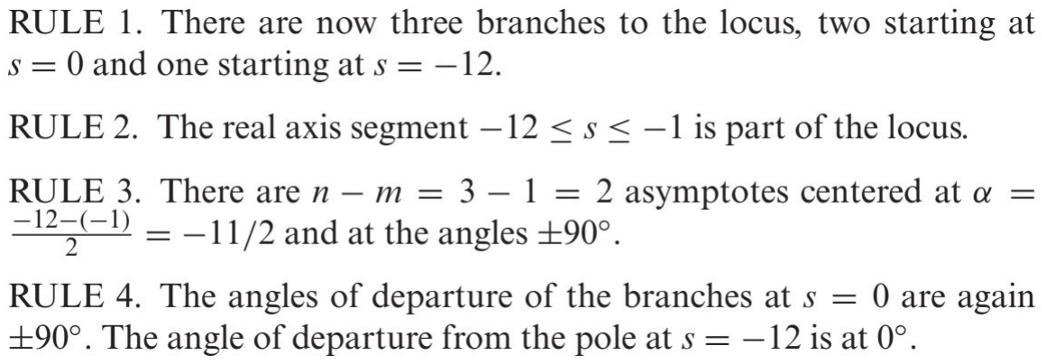
[picture p56: figure]

R. 48

# 3. Selected Illustrative Root Loci

## p = 12 (pole at s = -12)

# Example: Root Locus of the Satellite Control with Modified PD or Lead Compensation

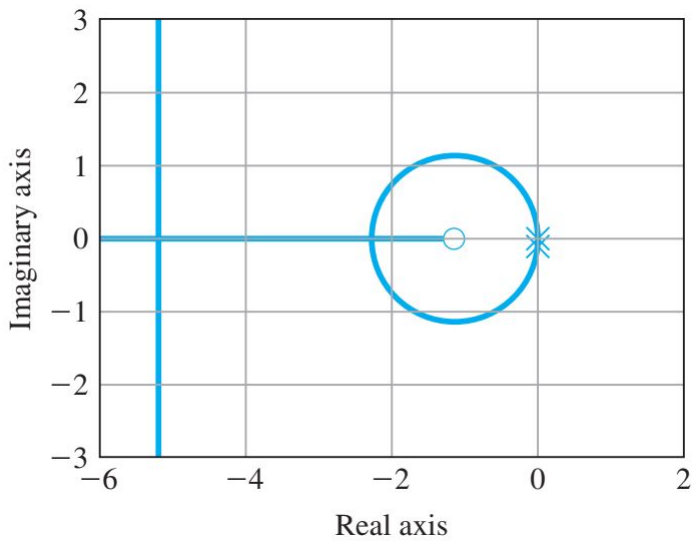
[picture p57: figure]

R. 49

# 3. Selected Illustrative Root Loci

## p = 12 (pole at s = -12)

# Example: Root Locus of the Satellite Control with Modified PD or Lead Compensation

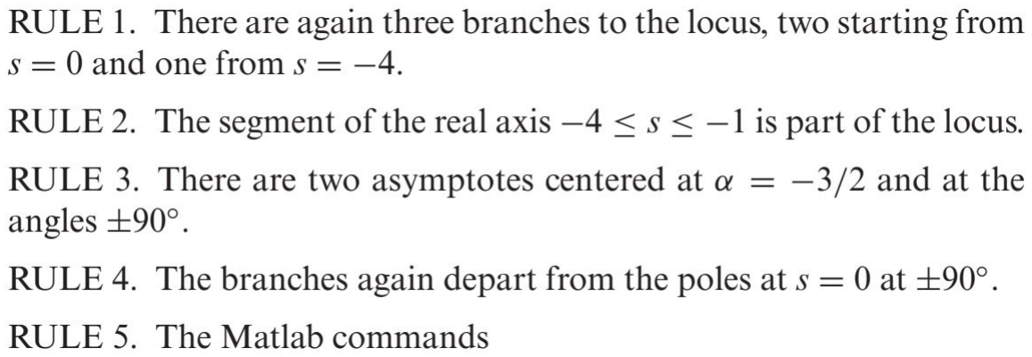
[picture p58: figure]

R. 50

# 3. Selected Illustrative Root Loci

## p = 4 (pole at s = -4)

# Example: Root Locus of the Satellite Control with Modified PD or Lead Compensation

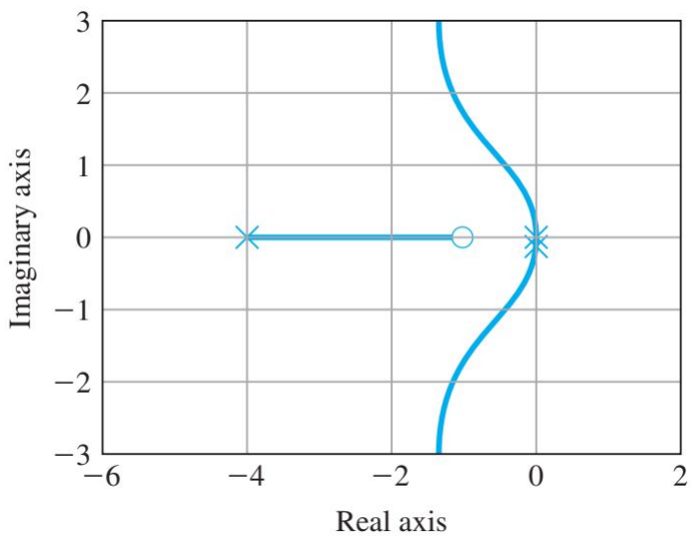
[picture p59: figure]

R. 51

# 3. Selected Illustrative Root Loci

## p = 4 (pole at s = -4)

# Example: Root Locus of the Satellite Control with Modified PD or Lead Compensation

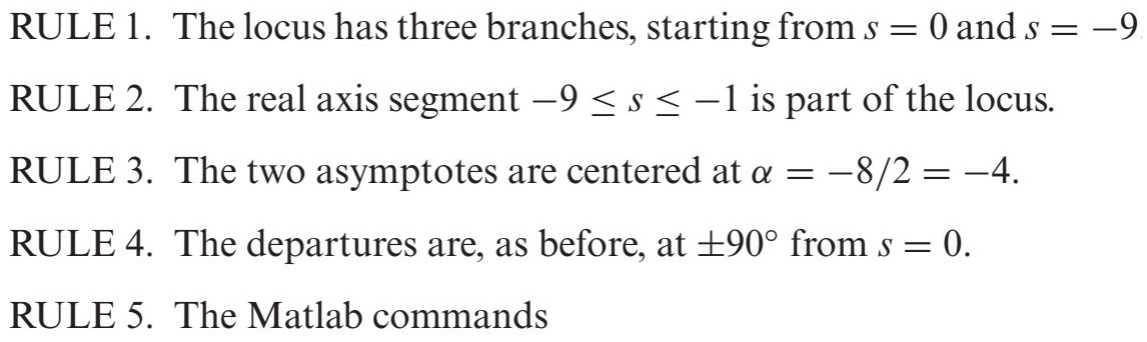
[picture p60: figure]

R. 52

# 3. Selected Illustrative Root Loci

## p = 12 (pole at s = -12)

# Example: Root Locus of the Satellite Control with Modified PD or Lead Compensation

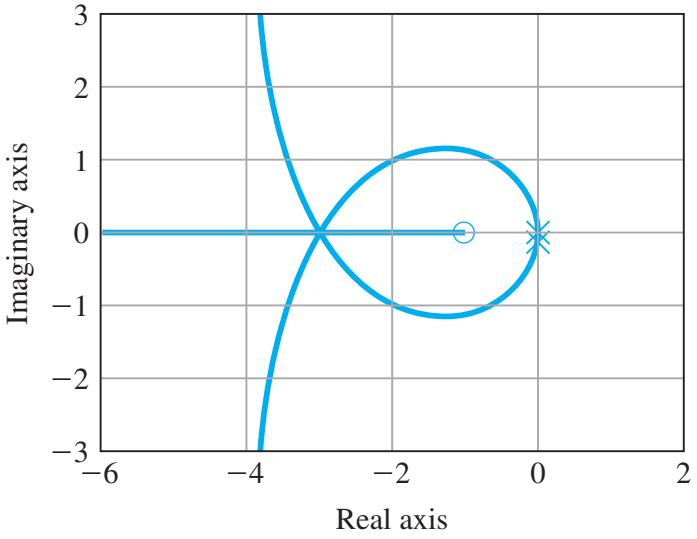
[picture p61: figure]

R. 53

# 3. Selected Illustrative Root Loci

## p = 9 (pole at s = -9)

# 4. Design Using Dynamic Compensation

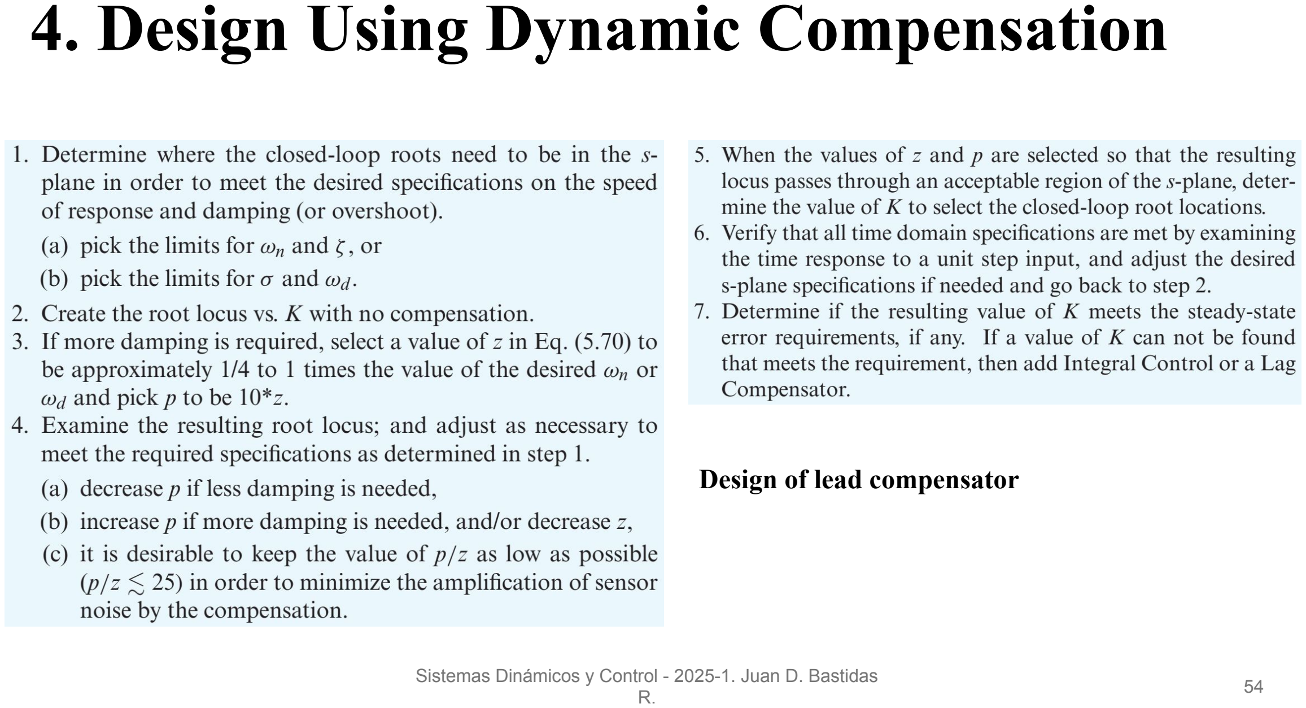
[picture p62: page 54]

R. 54

## Design of lead compensator

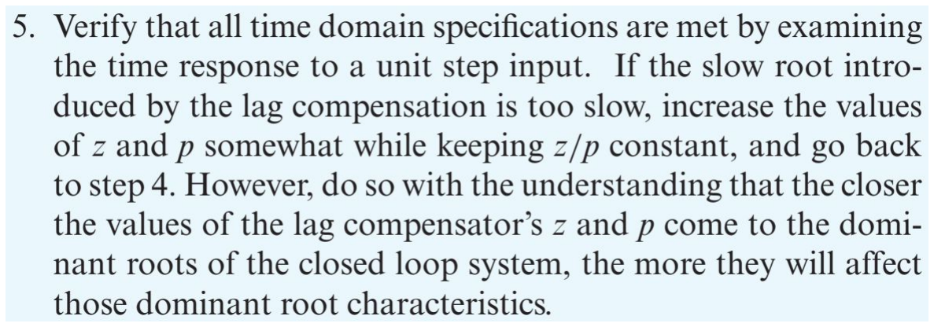
[picture p63: figure]
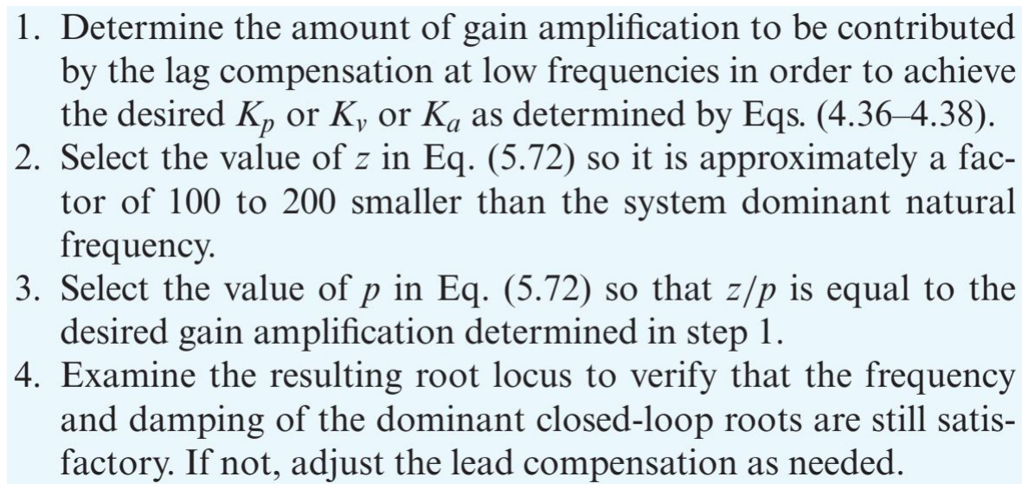
[picture p64: figure]

R. 55

# 4. Design Using Dynamic Compensation

## Design of lag compensator

# Control of a Quadrotor Drone Pitch Axis

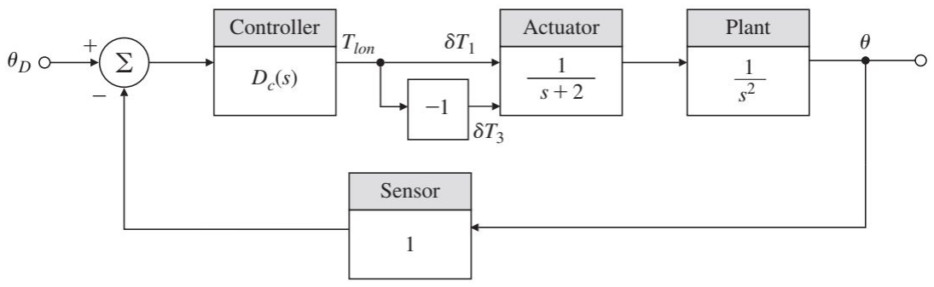
[picture p65: figure]

R. 56

# 5. Design Examples Using the Root Locus

## The lag term (s + 2) is for quadrotor

of 2 meters in diameter, aprox.

## Desired specifications:

## Compensator: lead

# Control of a Quadrotor Drone Pitch Axis

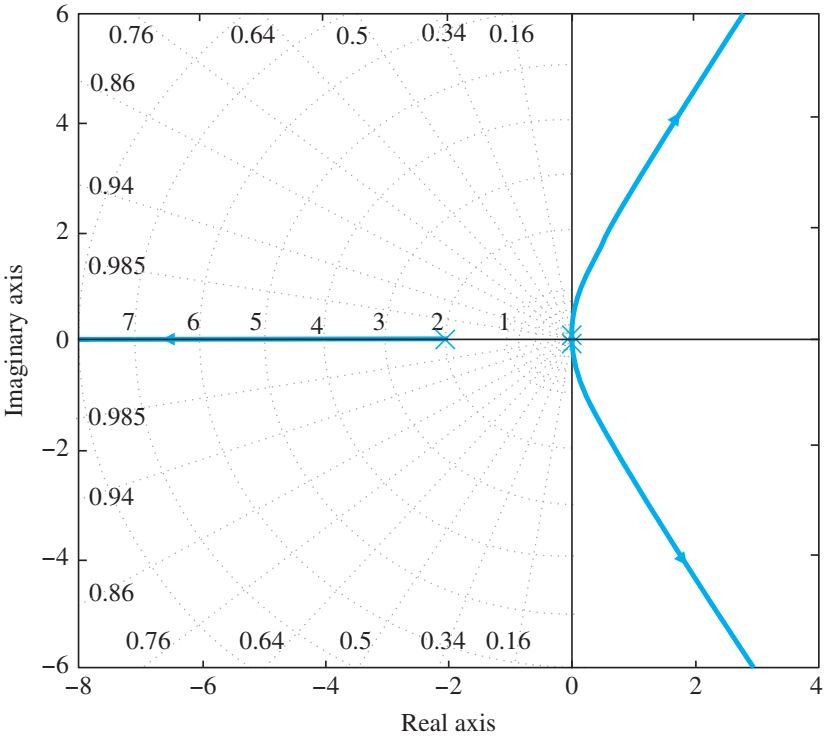
[picture p66: figure]

R. 57

# 5. Design Examples Using the Root Locus

## Step 1: specifications

## Step 2: Root locus in open-loop

s = tf('s');
sysG1=1/((s^2)*(s + 2));
rlocus(sysG1);
axis([-8 4 -6 6]);
grid on;

# Control of a Quadrotor Drone Pitch Axis

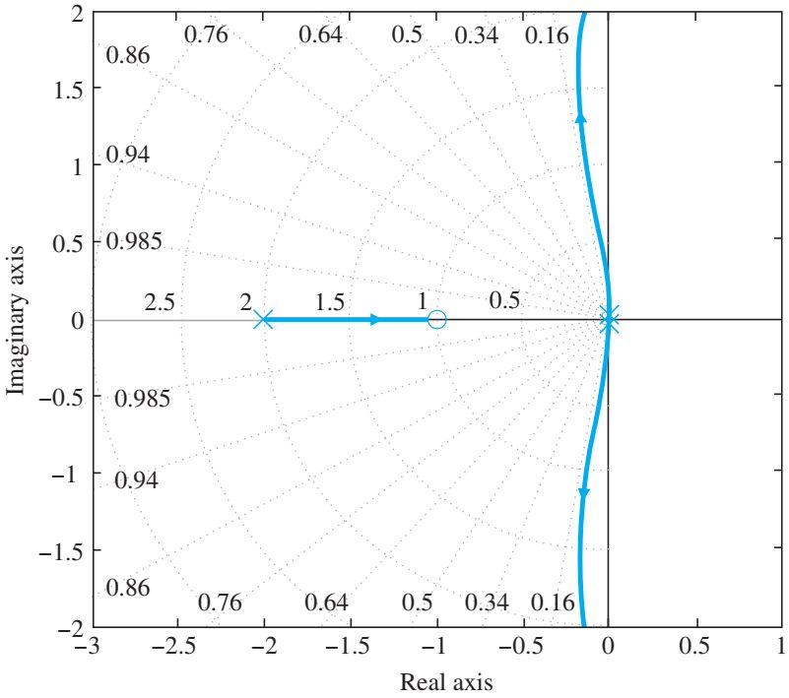
[picture p67: figure]

R. 58

# 5. Design Examples Using the Root Locus

## Step 1: specifications

## Step 2: Root locus in open-loop

## Step 3: lead compensator with z = 1 and p = 10 and generate the root locus

sysD=(s+1)/(s+10);
figure(2);
rlocus(sysG1*sysD);
axis([-3 1 -2 2]);
grid on;

# Control of a Quadrotor Drone Pitch Axis

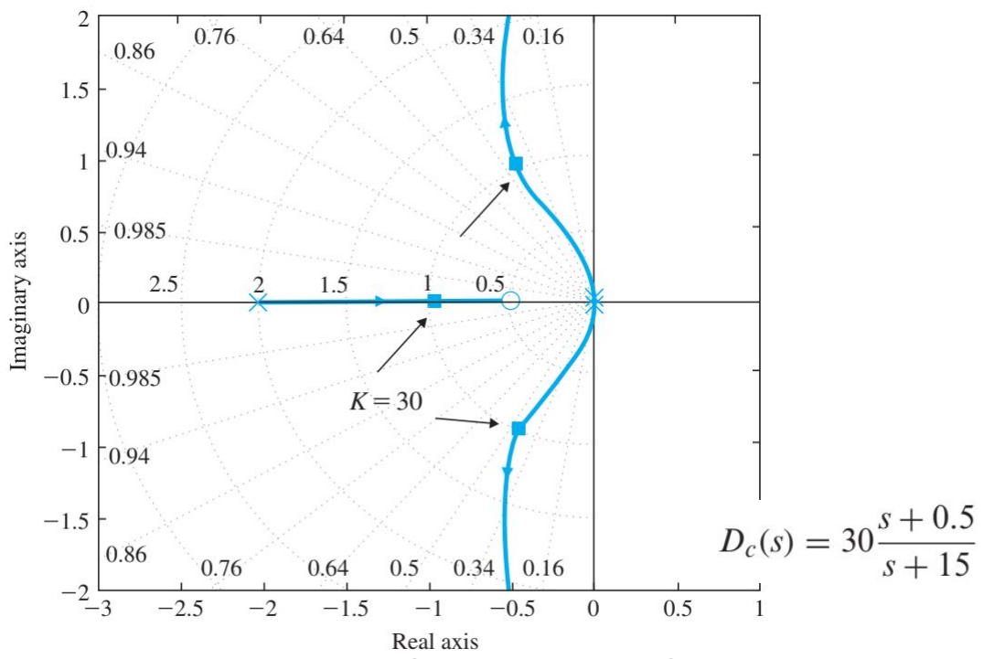
[picture p68: figure]

R. 59

# 5. Design Examples Using the Root Locus

## Step 1: specifications

## Step 2: Root locus in open-loop

## Step 3: lead compensator with z = 1 and p = 10 and generate the root locus => no feasible

## Step 4: lead compensator with z = 0.5 and p = 15

## Step 5: verify (using the cursor in Matlab’s plot)

# Control of a Quadrotor Drone Pitch Axis

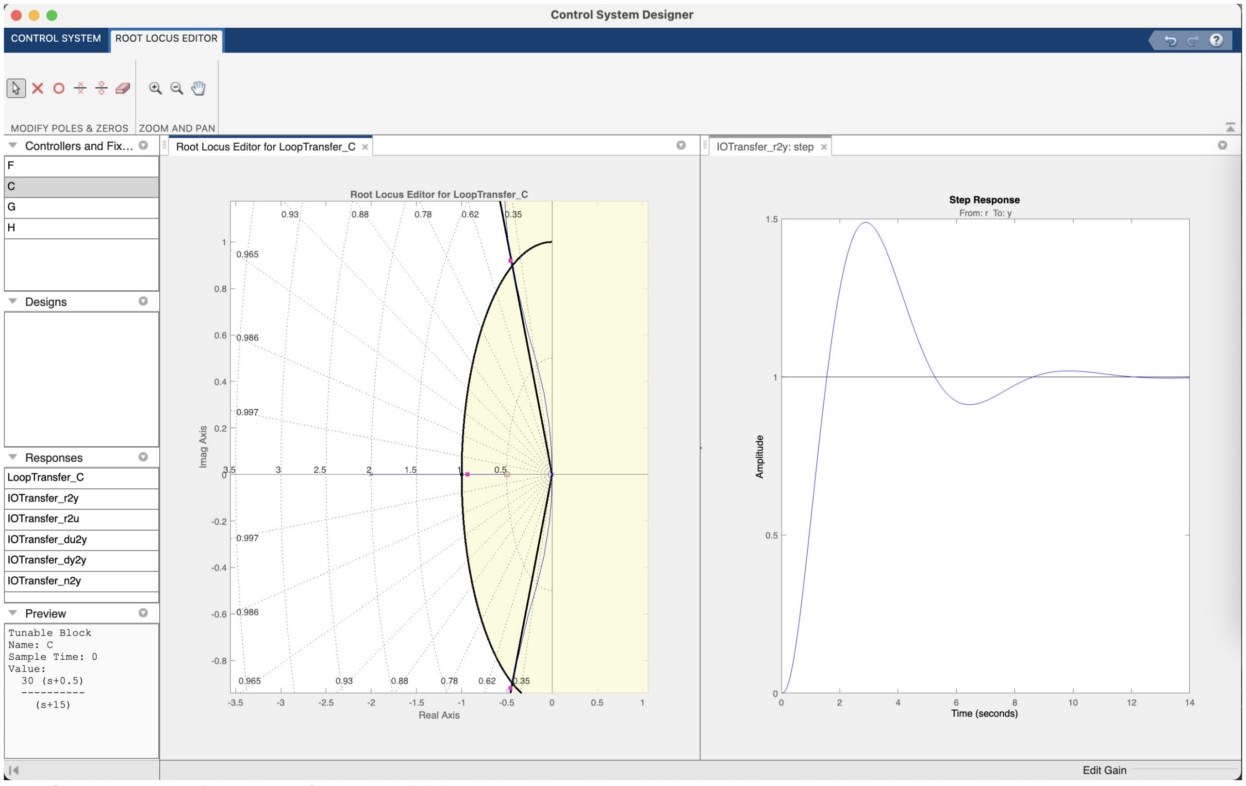
[picture p69: figure]

R. 60

# 5. Design Examples Using the Root Locus

Kctrl = 30;
sysD = Kctrl*sysD;

## sisotool('rlocus',sysG1,sy

sD);

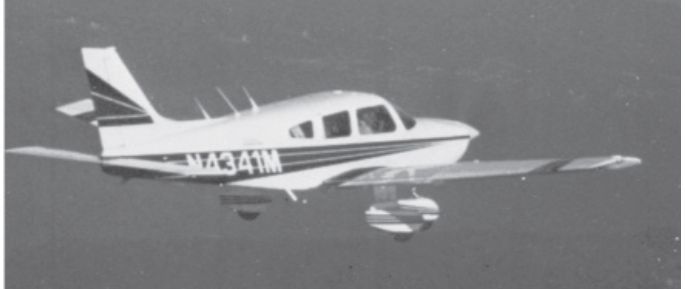
[picture p70: figure]

# Control of a Small Airplane

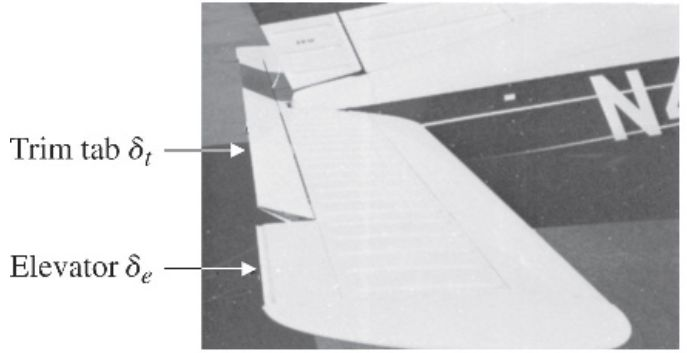
[picture p71: figure]

R. 61

# 5. Design Examples Using the Root Locus

## Transfer function between the elevator input and the pitch attitude

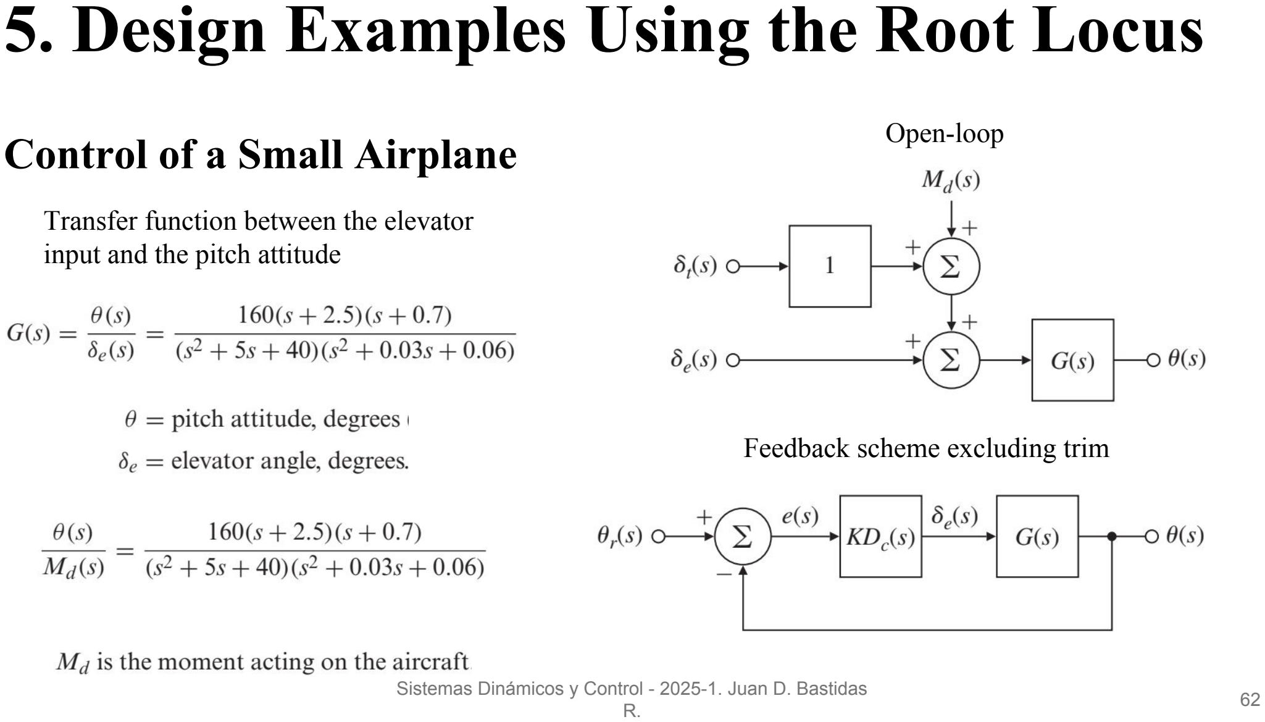
[picture p72: figure]
Control of a Small Airplane; 5. Design Examples Using the Root Locus; Transfer function between the elevator input and the pitch attitude; Open-loop; Feedback scheme excluding trim

# Control of a Small Airplane

R. 63

# 5. Design Examples Using the Root Locus

## Transfer function between the elevator input and the pitch attitude

## 1. Design an autopilot so the response to a step elevator input has a rise time of 1 sec or less and an

overshoot less than 10%.

## 2. Design an autopilot that will command the trim δt

## so as to drive the steadystate value of δe to zero for an arbitrary constant moment Md as well as meet

the specifications in part (a).

# Control of a Small Airplane

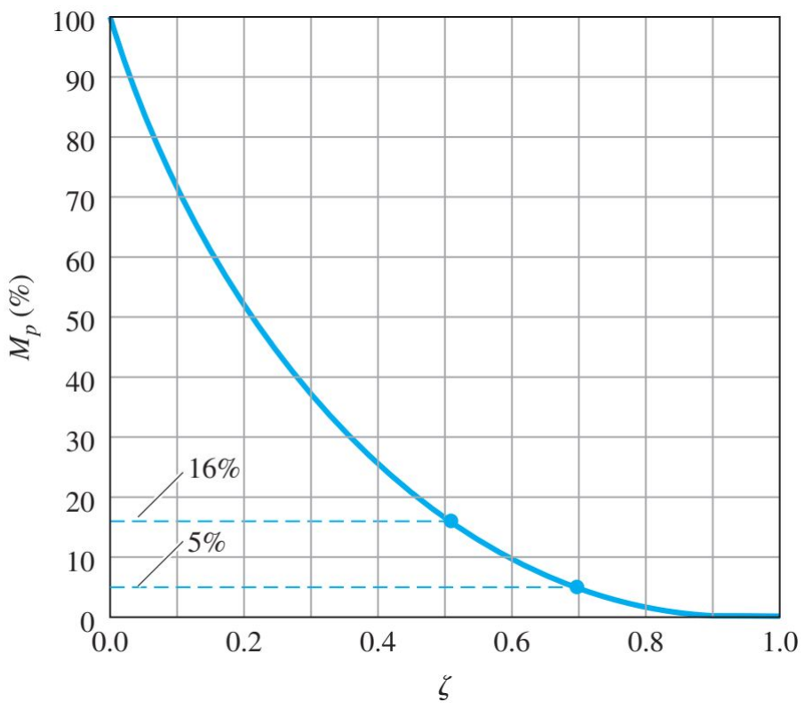
[picture p73: figure]

R. 64

# 5. Design Examples Using the Root Locus

## Step 1: design requirements

## 1. Design an autopilot so the response to a step elevator input has a rise time of 1 sec or less

## then, wn

## > 1.8 rad/s

and an overshoot less than 10%.

## From the figure: ζ > 0.6

# Control of a Small Airplane

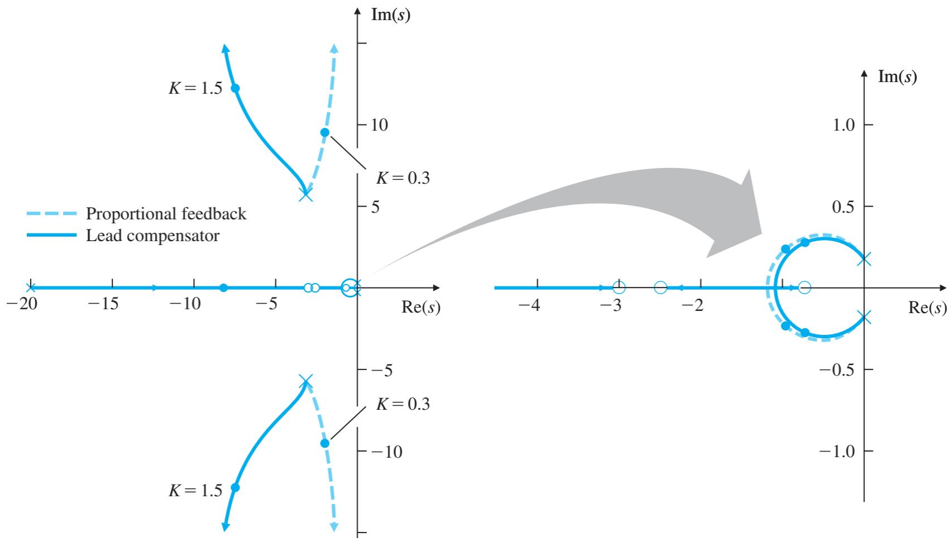
[picture p74: figure]

R. 65

# 5. Design Examples Using the Root Locus

## Step 2: root locus in

## open-loop (dashed lines)

# Control of a Small Airplane

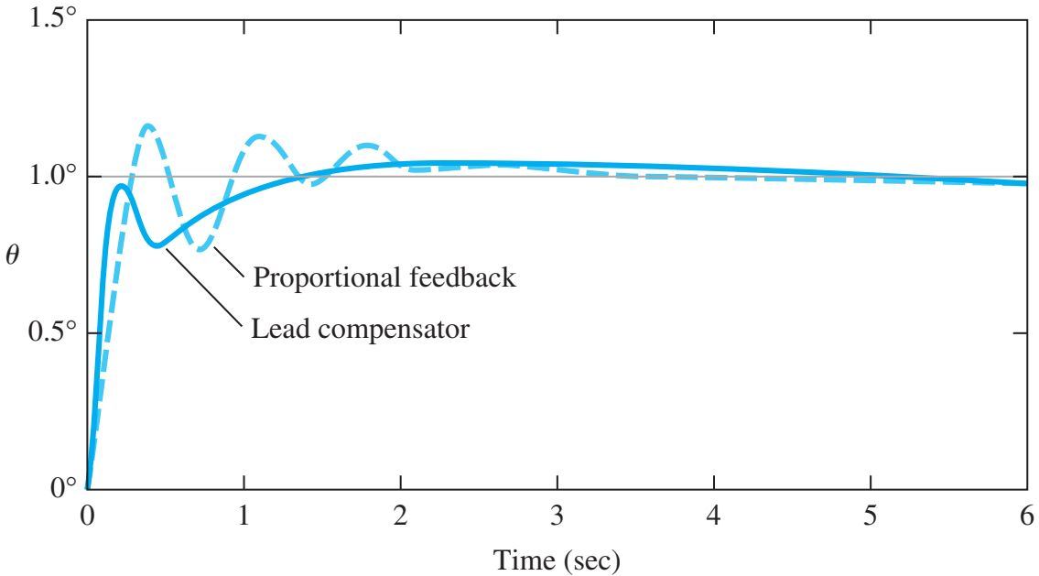
[picture p75: figure]

R. 66

# 5. Design Examples Using the Root Locus

## Step 2: step response in

## open-loop (dashed lines)

# Control of a Small Airplane

R. 67

# 5. Design Examples Using the Root Locus

## Step 3: try lead compensator with z = 3 and p = 20

## (solid lines)

# Control of a Small Airplane

R. 68

# 5. Design Examples Using the Root Locus

## Step 3: try lead compensator with z = 3 and p = 20

## (solid lines)

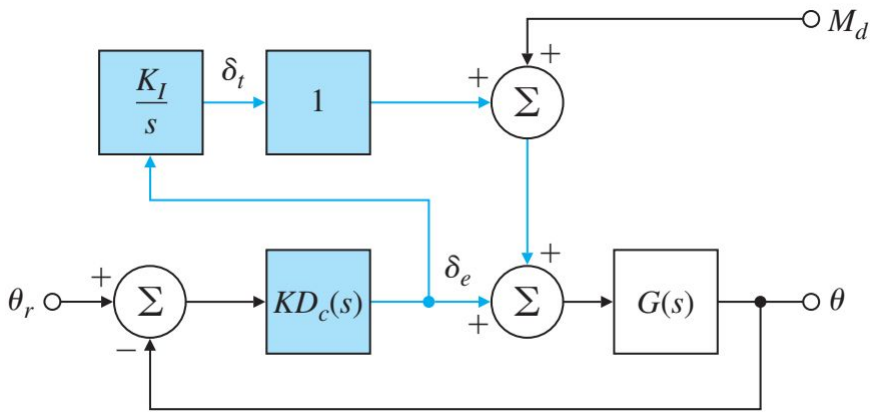
[picture p76: figure]

# Control of a Small Airplane

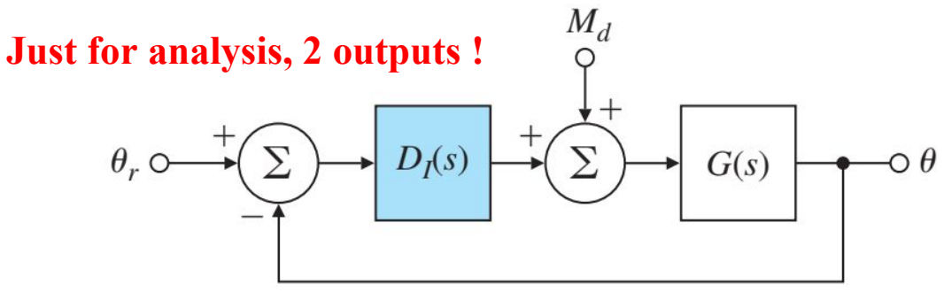
[picture p77: figure]
Just for analysis, 2 outputs !

R. 69

# 5. Design Examples Using the Root Locus

## 2. Design an autopilot that will command the trim δt so as to drive the steadystate value of δe to zero for an arbitrary constant moment Md as well as

meet the specifications in part (a).

## Idea: take δe to 0 with an I controller

# 5. Design Examples Using the Root Locus

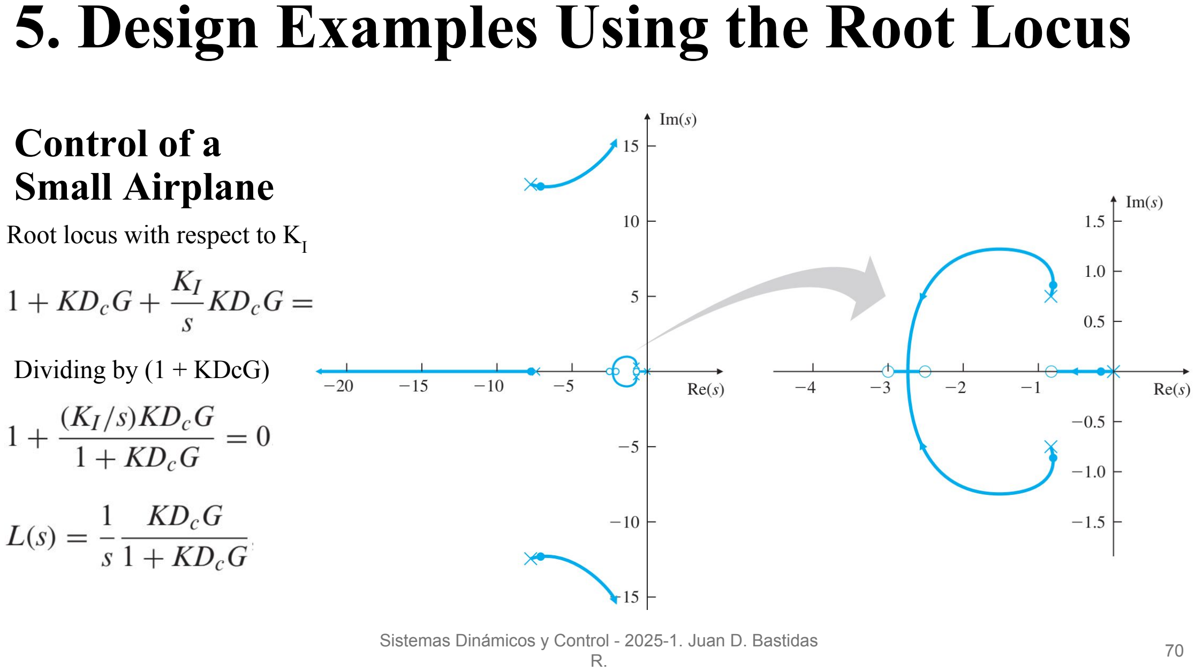
[picture p78: page 70]

# Control of a Small Airplane

R. 70

## Root locus with respect to KI

## Dividing by (1 + KDcG)

# Control of a Small Airplane

R. 71

# 5. Design Examples Using the Root Locus

## Keep KI

## as low as possible

KI

## = 1 to obtain approximately the same settling time

## The steady-state is 0

## Remember: 2 outputs !
