almondsun/DynamicSystemsAndControl/classroom/Ej_LazoAbierto_LazoCerrado/metadata/thumbnail.png

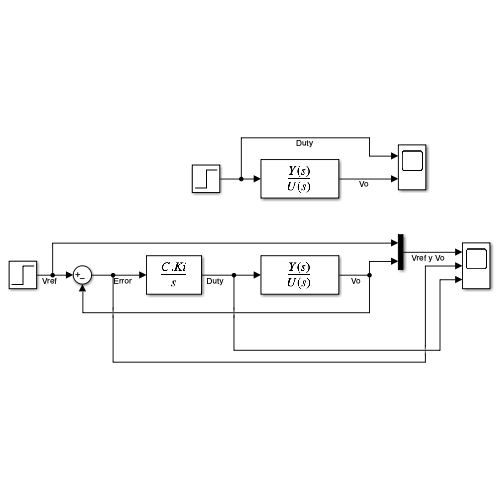
classroom/Ej_LazoAbierto_LazoCerrado/metadata/thumbnail.png
