almondsun/DynamicSystemsAndControl/project/pcb/release/board-back.png

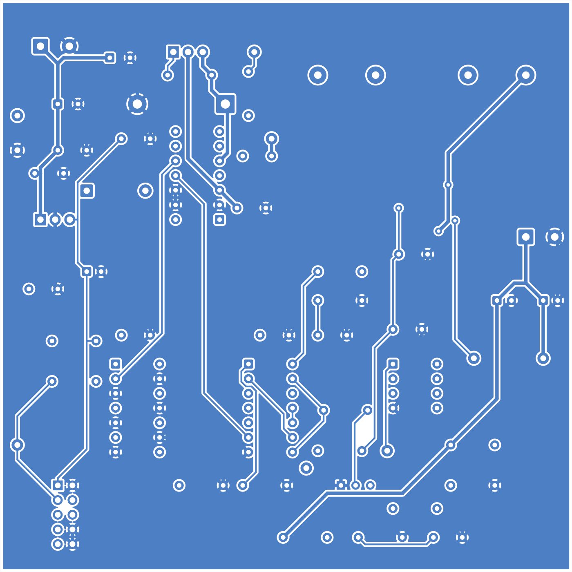
project/pcb/release/board-back.png
