almondsun/DynamicSystemsAndControl/project/pcb/release/board-front.png

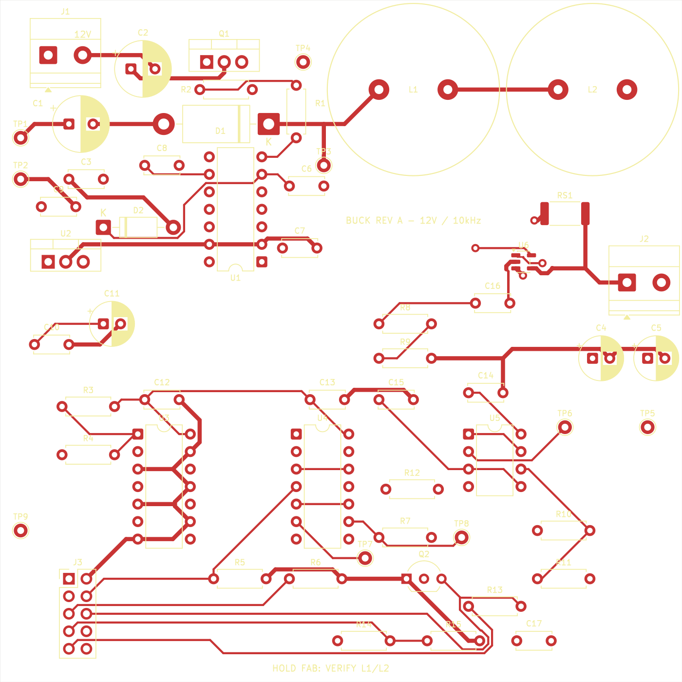
project/pcb/release/board-front.png
