almondsun/DynamicSystemsAndControl/project/pcb/release/gerber-bottom.png

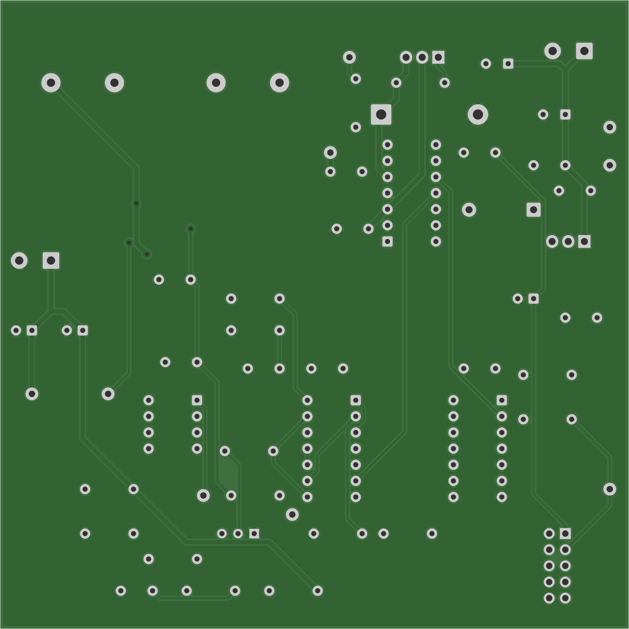
project/pcb/release/gerber-bottom.png
