almondsun/DynamicSystemsAndControl/project/pcb/release/gerber-top.png

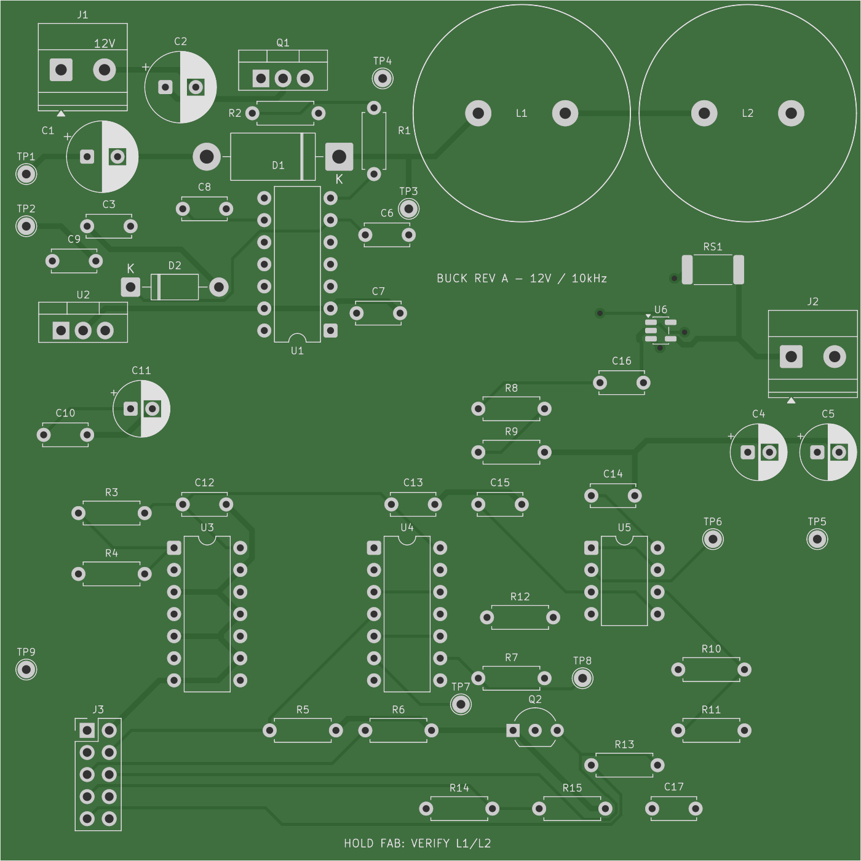
project/pcb/release/gerber-top.png
