almondsun/DynamicSystemsAndControl/project/pcb/release/report-assets/power-summary.png

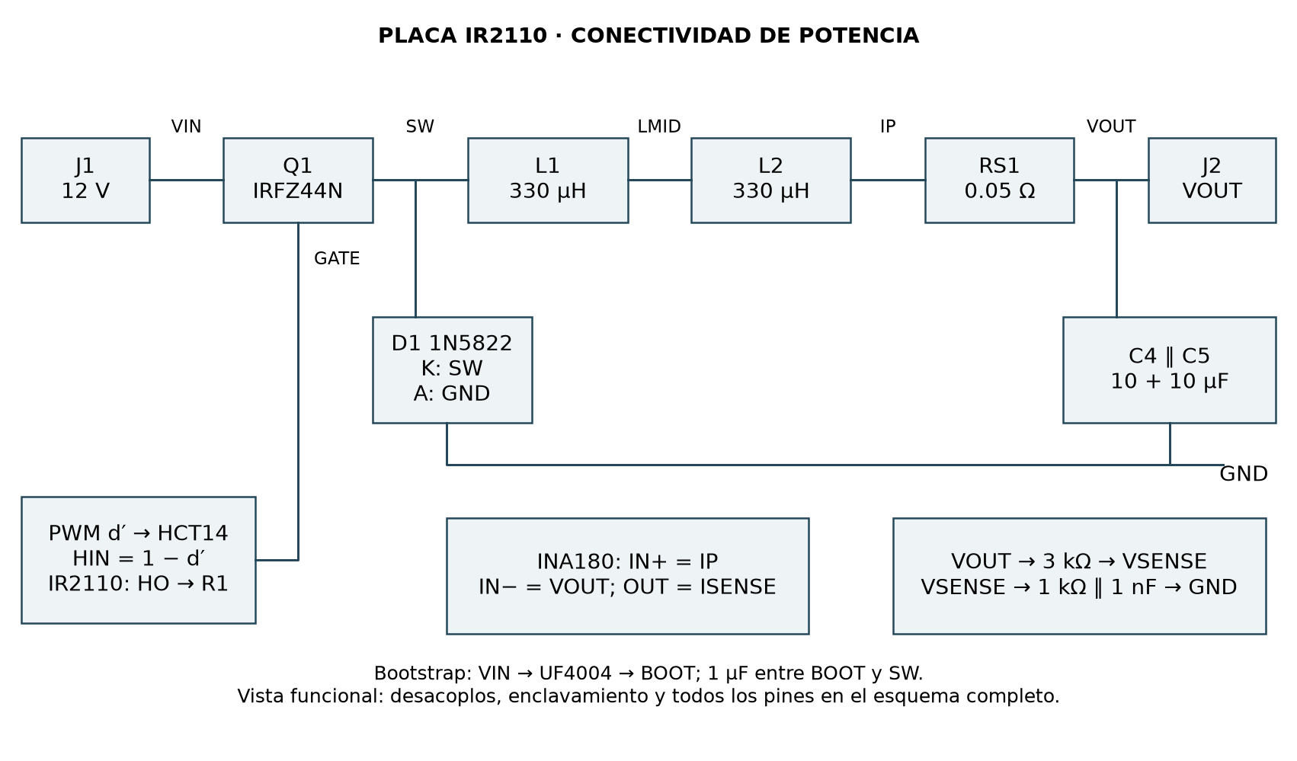
project/pcb/release/report-assets/power-summary.png
