almondsun/DynamicSystemsAndControl/project/pcb/revC/docs/nucleo_bottom.jpeg

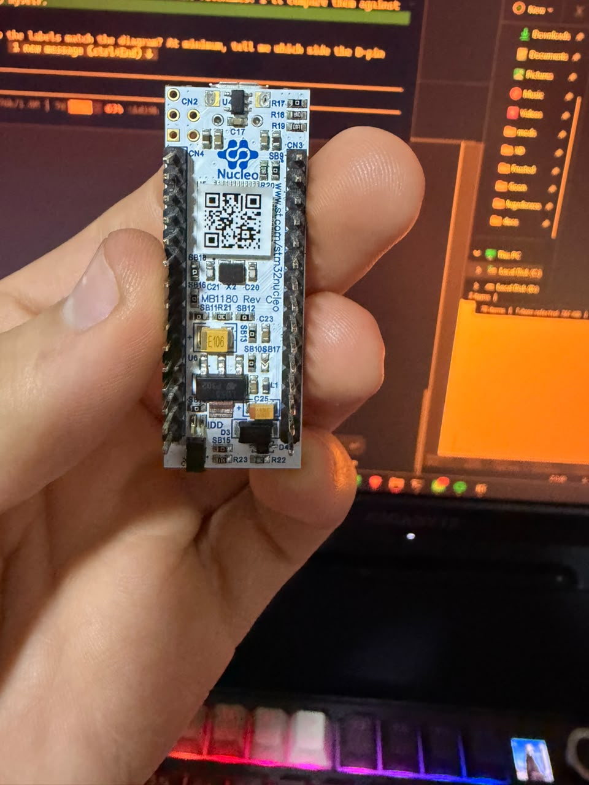
project/pcb/revC/docs/nucleo_bottom.jpeg
