almondsun/DynamicSystemsAndControl/project/pcb/revC/docs/nulceo_top.jpeg

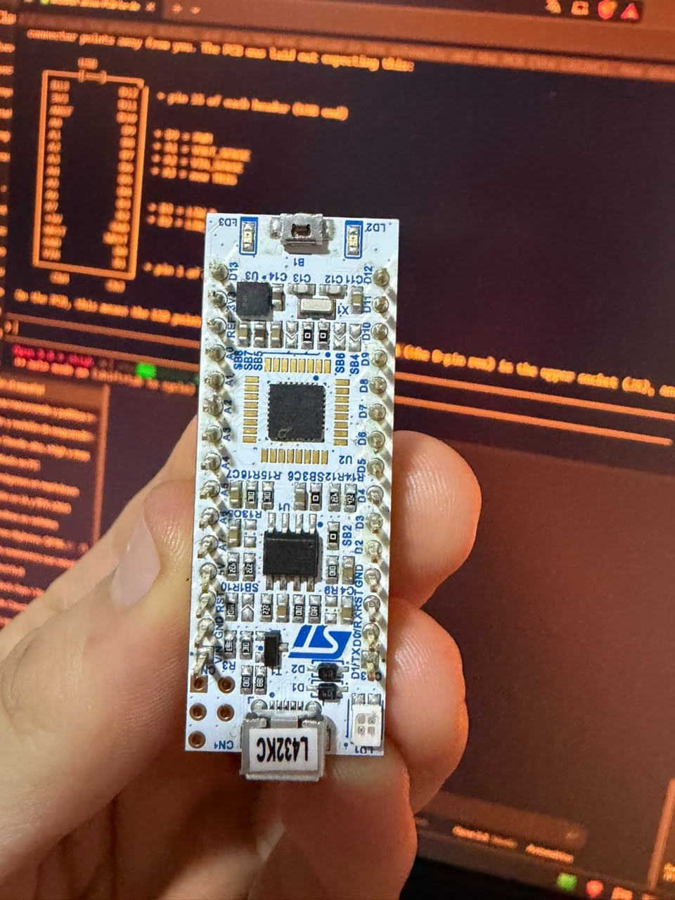
project/pcb/revC/docs/nulceo_top.jpeg
