almondsun/DynamicSystemsAndControl/project/pcb/redesign/component_mapping.md

> **HISTÓRICO: estado anterior a la actualización NUCLEO.** Para valores, conectividad y decisiones vigentes consulte [design_changes.md](design_changes.md), [open_issues.md](open_issues.md) y [el informe de migración](nucleo_l432kc_migration.md). Las tablas siguientes preservan la trazabilidad anterior; no describen la revisión vigente.

# Matriz previa de correspondencia SMD

Preparada ANTES de editar símbolos (2026-10-25). Revisión humana obligatoria; no fabricar.

Fuentes principales: [informe](sources/verificacion_definitiva_candidatos_pasivos_buck_2026-10-25.md) y [matriz, hoja Matriz filas 2–36](sources/matriz_verificacion_pasivos_buck_legible.xlsx). Los 35 registros se leyeron sin modificar el libro. Para los otros 22 componentes: inventario y manifiesto CAD originales. MPN original no declarado se distingue del candidato del inventario. Los candidatos NO son MPN originales acreditados.

FOOTPRINT_ONLY conserva el símbolo, sus pines y posiciones; puede corregir el rótulo MPN de semiconductores. SYMBOL_REPLACEMENT usa símbolo adaptado documentado. PENDING conserva original por falta de información/aceptación. BLOCKED identifica CAD o función incompatible. Asignado no significa aprobado. Las 12 referencias J/TP se conservan; no se propone convertirlas arbitrariamente a SMD.

|Ref.|Valor original|MPN original|MPN nuevo candidato|JLC/LCSC|Símbolo original|Símbolo nuevo|Footprint seleccionado / conservado|Clase|Pines original→nuevo: función @ red|Compatibilidad|Validación eléctrica parcial|Aprobación pasivos|Decisión / pendiente|
|---|---|---|---|---|---|---|---|---|---|---|---|---|---|
|C4|10uF 35V low ESR|No declarado; rótulo histórico: 10uF 35V low ESR|Panasonic 50SVF10M|C454354|Buck:C4|Buck:C4|Buck_SMD:CAP_SVF_C6_PAN|FOOTPRINT_ONLY|1→1 + @ VOUT; 2→2 - @ GND|1:1, sin mover terminales|APROBADO (rizado y tensión)|PENDIENTE — ALTO|Margen corriente 11,7× y tensión nominal ≥2,5× frente a 20 V hipotéticos. C_banco efectiva≥16 µF a vida/temperatura no demostrada; ESR @10 kHz y estabilidad PI; land C6 y polaridad.|
|RS1|0.050R 1% 1W|No declarado; rótulo histórico: 0.050R 1% 1W|TA-I RLP25FEER050|C160588|Buck:RS1|Buck:RS1|Resistor_SMD:R_2512_6332Metric|FOOTPRINT_ONLY|1→1 terminal no polar @ IP; 2→2 terminal no polar @ VOUT|1:1, sin mover terminales|APROBADO (potencia calculada, no térmica)|PENDIENTE — ALTO|ASIGNACIÓN CAD PROVISIONAL, NO APROBACIÓN ELÉCTRICA. Huella 2512 genérica PROVISIONAL; NO reproduce land TA-I a=4,b=2.1,L=4.1 mm. Mantener pendiente mecánica/Kelvin/térmica. Con 1 oz (~35 µm) no atribuir 2 W. Demostrar derating y temperatura a 0,316 W; kelvin desde pads; land TA-I específico.|
|J1|12V FUSED INPUT|No declarado; rótulo histórico: 12V FUSED INPUT|TB002-500-02BE|C2757858|Buck:J1|Buck:J1|TerminalBlock_Phoenix:TerminalBlock_Phoenix_MKDS-1,5-2_1x02_P5.00mm_Horizontal|PENDING|1→1 según red original @ VIN; 2→2 según red original @ GND|Sustitución NO efectuada|Solo pinout documental; aptitud eléctrica pendiente|No aplica|Fuera de migración SMD segura: conservar conector/punto de prueba THT; MPN/montaje exacto no cerrado. Sin cambios.|
|D1|1N5822 40V 3A|No declarado; rótulo histórico: 1N5822 40V 3A|SS34|C8678|Buck:D1|Buck:D1|Diode_SMD:D_SMA|FOOTPRINT_ONLY|1→1 K @ SW; 2→2 A @ GND|1:1, sin mover terminales|Solo pinout documental; aptitud eléctrica pendiente|No aplica|MDD SS34 SMA según ficha local pp.1,3; se rechaza SMB descargado. Pad1 K/banda,2 A; térmica/transitorios pendientes.|
|L1|330uH >=3A Isat VERIFY|No declarado; rótulo histórico: 330uH >=3A Isat VERIFY|Murata 60B334C|C6823957|Buck:L1|Buck:L1|Buck:Inductor_25mm_P10mm_VERIFY|PENDING|1→1 terminal no polar @ SW; 2→2 terminal no polar @ LMID|Sustitución NO efectuada|PENDIENTE|PENDIENTE — CRÍTICO|No hay land KiCad verificado de Murata 60B334C; NO asignar THT a pieza SMD. L(I,T), acoplamiento y pérdidas pendientes. Inductancia efectiva por bobina debe sostener L_total≥528 µH; a −15 % inicial quedan 561 µH y solo 5,9 % de pérdida admisible. Curva L(I,T) y pérdidas núcleo ausentes; land Murata obligatorio.|
|C1|100uF 25V|No declarado; rótulo histórico: 100uF 25V|Panasonic 25SVPF100M|C136279|Buck:C1|Buck:C1|Buck_SMD:PCAP_SVP_E7_PAN|FOOTPRINT_ONLY|1→1 + @ VIN; 2→2 - @ GND|1:1, sin mover terminales|APROBADO (rizado y tensión)|PENDIENTE — MEDIO|Margen I_ripple 3,73× y VDC 1,89×. Verificar C_banco efectiva≥160 µF con vida/temperatura y ESR @10k; land E7 y polaridad. 160 µF es mínimo por tolerancia inicial, no de vida.|
|C2|100uF 25V|No declarado; rótulo histórico: 100uF 25V|Panasonic 25SVPF100M|C136279|Buck:C2|Buck:C2|Buck_SMD:PCAP_SVP_E7_PAN|FOOTPRINT_ONLY|1→1 + @ VIN; 2→2 - @ GND|1:1, sin mover terminales|APROBADO (rizado y tensión)|PENDIENTE — MEDIO|Margen I_ripple 3,73× y VDC 1,89×. Verificar C_banco efectiva≥160 µF con vida/temperatura y ESR @10k; land E7 y polaridad. 160 µF es mínimo por tolerancia inicial, no de vida.|
|C3|100nF 50V|No declarado; rótulo histórico: 100nF 50V|Yageo CC0603KRX7R9BB104|C14663|Buck:C3|Buck:C3|Capacitor_SMD:C_0603_1608Metric|FOOTPRINT_ONLY|1→1 terminal no polar @ VIN; 2→2 terminal no polar @ GND|1:1, sin mover terminales|APROBADO (tensión/temperatura nominal)|PENDIENTE — BAJO|Retención de ≥70 nF con DC/temperatura y proximidad Q1/D1; exigir evidencia capacitancia efectiva y ubicación.|
|J2|LOAD + / -|No declarado; rótulo histórico: LOAD + / -|TB002-500-02BE|C2757858|Buck:J2|Buck:J2|TerminalBlock_Phoenix:TerminalBlock_Phoenix_MKDS-1,5-2_1x02_P5.00mm_Horizontal|PENDING|1→1 según red original @ VOUT; 2→2 según red original @ GND|Sustitución NO efectuada|Solo pinout documental; aptitud eléctrica pendiente|No aplica|Fuera de migración SMD segura: conservar conector/punto de prueba THT; MPN/montaje exacto no cerrado. Sin cambios.|
|L2|330uH >=3A Isat VERIFY|No declarado; rótulo histórico: 330uH >=3A Isat VERIFY|Murata 60B334C|C6823957|Buck:L2|Buck:L2|Buck:Inductor_25mm_P10mm_VERIFY|PENDING|1→1 terminal no polar @ LMID; 2→2 terminal no polar @ IP|Sustitución NO efectuada|PENDIENTE|PENDIENTE — CRÍTICO|Igual L1; se conserva huella THT histórica solo como original NO MIGRADO. Comprobar influencia de proximidad/acoplamiento: L_eq = L1+L2±2M. Validar I de saturación por condición de 80 % del nominal y temperatura.|
|C5|10uF 35V low ESR|No declarado; rótulo histórico: 10uF 35V low ESR|Panasonic 50SVF10M|C454354|Buck:C5|Buck:C5|Buck_SMD:CAP_SVF_C6_PAN|FOOTPRINT_ONLY|1→1 + @ VOUT; 2→2 - @ GND|1:1, sin mover terminales|APROBADO (rizado y tensión)|PENDIENTE — ALTO|Margen corriente 11,7× y tensión nominal ≥2,5× frente a 20 V hipotéticos. C_banco efectiva≥16 µF a vida/temperatura no demostrada; ESR @10 kHz y estabilidad PI; land C6 y polaridad.|
|Q1|IRFZ44N TO-220|No declarado; rótulo histórico: IRFZ44N TO-220|IRFZ44NS|C5199867|Buck:Q1|Buck:Q1|Package_TO_SOT_THT:TO-220-3_Vertical|PENDING|1→1 G @ GATE; 2→2 D @ VIN; 3→3 S @ SW|Sustitución NO efectuada|Solo pinout documental; aptitud eléctrica pendiente|No aplica|Revisión/familia UMW y TO-263 pendientes de conciliar; se retiene original TO-220.|
|U1|IR2110PBF DIP14|No declarado; rótulo histórico: IR2110PBF DIP14|IR2110STRPBF|C2968|Buck:U1|Buck:U1|Package_SO:SOIC-16W_7.5x10.3mm_P1.27mm|FOOTPRINT_ONLY|1→1 LO @ unconnected-(U1-LO-Pad1); 2→2 COM @ GND; 3→3 VCC @ VIN; 4→4 NC @ unconnected-(U1-NC-Pad4); 5→5 NC @ unconnected-(U1-NC-Pad5); 6→6 VS @ SW; 7→7 VB @ BOOT; 8→8 HO @ HO; 9→9 NC @ unconnected-(U1-NC-Pad9); 10→10 NC @ unconnected-(U1-NC-Pad10); 11→11 VDD @ +5V; 12→12 HIN @ HIN; 13→13 SD @ SD; 14→14 LIN @ GND; 15→15 VSS @ GND; 16→16 NC @ unconnected-(U1-NC-Pad16)|1:1, sin mover terminales|Solo pinout documental; aptitud eléctrica pendiente|No aplica|El símbolo original YA tiene pinout SOIC16 pese a Value DIP14; se conserva mapa real 1:1. Datasheet Infineon rev.V pp.5,16 (MS-013AA); se corrige rótulo a MPN SMD.|
|R2|10k|No declarado; rótulo histórico: 10k|UNI-ROYAL 0603WAF1002T5E|C25804|Buck:R2|Buck:R2|Resistor_SMD:R_0603_1608Metric|FOOTPRINT_ONLY|1→1 terminal no polar @ GATE; 2→2 terminal no polar @ SW|1:1, sin mover terminales|APROBADO (CC)|PENDIENTE — ALTO|Su descarga gate agrega consumo al bootstrap en cada ciclo; validar VBS.|
|U2|L7805CV|No declarado; rótulo histórico: L7805CV|78M05|C347278|Buck:U2|Buck:U2|Package_TO_SOT_SMD:TO-252-2|FOOTPRINT_ONLY|1→1 IN @ VIN; 2→2 GND @ GND; 3→3 OUT @ +5V|1:1, sin mover terminales|Solo pinout documental; aptitud eléctrica pendiente|No aplica|UMW 78Mxx pp.1,14: TO-252, 1 IN,2 GND/tab,3 OUT; 5V nominal conservado, térmica/estabilidad pendientes.|
|D2|UF4004|No declarado; rótulo histórico: UF4004|US1G|C3034075|Buck:D2|Buck:D2|Diode_THT:D_DO-41_SOD81_P10.16mm_Horizontal|BLOCKED|1→1 según red original @ BOOT; 2→2 según red original @ VIN|Sustitución NO efectuada|Solo pinout documental; aptitud eléctrica pendiente|No aplica|Falta ficha exacta ShunYe US1G; CAD descargado es CLD-Diode, función incompatible. Reemplazo bloqueado.|
|R1|10R|No declarado; rótulo histórico: 10R|UNI-ROYAL 0805W8F100JT5E|C17415|Buck:R1|Buck:R1|Resistor_SMD:R_0805_2012Metric|FOOTPRINT_ONLY|1→1 terminal no polar @ HO; 2→2 terminal no polar @ GATE|1:1, sin mover terminales|PENDIENTE|PENDIENTE — ALTO|Curva de pulsos repetitivos no contrastada; 13,2 mW es potencia total simplificada, no la que disipa necesariamente R1.|
|C11|10uF 25V|No declarado; rótulo histórico: 10uF 25V|Samsung CL21A106KAYNNNE|C15850|Buck:C11|Buck_Redesign:CL21A106KAYNNNE|Capacitor_SMD:C_0805_2012Metric|SYMBOL_REPLACEMENT|1→1 terminal no polar @ +5V; 2→2 terminal no polar @ GND|1:1, sin mover terminales|APROBADO (tensión nominal)|PENDIENTE — MEDIO|MLCC X5R no polarizado sustituye capacitor polarizado. Símbolo adaptado con dibujo no polar y terminales en posiciones originales. Curva de DC bias del MPN y ESR/estabilidad del UMW 78M05 no certificadas para todo el rango.|
|C9|330nF 50V|No declarado; rótulo histórico: 330nF 50V|Samsung CL21B334KBFNNNE|C73142|Buck:C9|Buck:C9|Capacitor_SMD:C_0805_2012Metric|FOOTPRINT_ONLY|1→1 terminal no polar @ VIN; 2→2 terminal no polar @ GND|1:1, sin mover terminales|APROBADO (valor nominal/tensión)|PENDIENTE — MEDIO|No trasladar CI nominal de aplicación de UMW a mínimo efectivo garantizado; revisar necesidad de ESR/localidad.|
|R4|1k|No declarado; rótulo histórico: 1k|UNI-ROYAL 0603WAF1001T5E|C21190|Buck:R4|Buck:R4|Resistor_SMD:R_0603_1608Metric|FOOTPRINT_ONLY|1→1 terminal no polar @ MCU_PWM; 2→2 terminal no polar @ DPRIME|1:1, sin mover terminales|APROBADO (CC)|PENDIENTE — MEDIO|Corriente interfaz con MCU desconectado o sin alimentación.|
|R3|10k|No declarado; rótulo histórico: 10k|UNI-ROYAL 0603WAF1002T5E|C25804|Buck:R3|Buck:R3|Resistor_SMD:R_0603_1608Metric|FOOTPRINT_ONLY|1→1 terminal no polar @ DPRIME; 2→2 terminal no polar @ +5V|1:1, sin mover terminales|APROBADO (CC)|PENDIENTE — BAJO|Revisión inyección hacia MCU apagado.|
|U3|SN74HCT14N|No declarado; rótulo histórico: SN74HCT14N|SN74HCT14DR|C6769|Buck:U3|Buck:U3|Buck_SMD:D14|FOOTPRINT_ONLY|1→1 1A @ DPRIME; 2→2 1Y @ HIN; 3→3 2A @ GND; 4→4 2Y @ unconnected-(U3-2Y-Pad4); 5→5 3A @ GND; 6→6 3Y @ unconnected-(U3-3Y-Pad6); 7→7 GND @ GND; 8→8 4Y @ unconnected-(U3-4Y-Pad8); 9→9 4A @ GND; 10→10 5Y @ unconnected-(U3-5Y-Pad10); 11→11 5A @ GND; 12→12 6Y @ unconnected-(U3-6Y-Pad12); 13→13 6A @ GND; 14→14 VCC @ +5V|1:1, sin mover terminales|Solo pinout documental; aptitud eléctrica pendiente|No aplica|TI SCLS225G, SOIC D14, paso1.27mm; pinout 1:1. Se conserva símbolo funcional existente.|
|C7|100nF 50V|No declarado; rótulo histórico: 100nF 50V|Yageo CC0603KRX7R9BB104|C14663|Buck:C7|Buck:C7|Capacitor_SMD:C_0603_1608Metric|FOOTPRINT_ONLY|1→1 terminal no polar @ VIN; 2→2 terminal no polar @ GND|1:1, sin mover terminales|APROBADO (tensión/temperatura nominal)|PENDIENTE — CRÍTICO|ASIGNACIÓN CAD PROVISIONAL, NO APROBACIÓN ELÉCTRICA.  100 nF no demuestra reserva de carga de bootstrap; ver eventual C18 local; exigir evidencia capacitancia efectiva y ubicación.|
|C12|100nF|No declarado; rótulo histórico: 100nF|Yageo CC0603KRX7R9BB104|C14663|Buck:C12|Buck:C12|Capacitor_SMD:C_0603_1608Metric|FOOTPRINT_ONLY|1→1 terminal no polar @ +5V; 2→2 terminal no polar @ GND|1:1, sin mover terminales|APROBADO (tensión/temperatura nominal)|PENDIENTE — BAJO|Posición y retorno para conmutación HCT14; exigir evidencia capacitancia efectiva y ubicación.|
|C6|1uF 50V X7R|No declarado; rótulo histórico: 1uF 50V X7R|Samsung CL21B105KBFNNNE|C28323|Buck:C6|Buck:C6|Capacitor_SMD:C_0805_2012Metric|FOOTPRINT_ONLY|1→1 terminal no polar @ BOOT; 2→2 terminal no polar @ SW|1:1, sin mover terminales|PENDIENTE|PENDIENTE — CRÍTICO|ASIGNACIÓN CAD PROVISIONAL, NO APROBACIÓN ELÉCTRICA.  No se demuestra objetivo Ceff≥1 µF. Evaluar C6 en 10–13 V DC, tiempos off de 5µs, carga inicial y VBS/VGS; reservar posibilidad segundo MLCC sin poblar a ciegas.|
|C10|100nF 50V|No declarado; rótulo histórico: 100nF 50V|Yageo CC0603KRX7R9BB104|C14663|Buck:C10|Buck:C10|Capacitor_SMD:C_0603_1608Metric|FOOTPRINT_ONLY|1→1 terminal no polar @ +5V; 2→2 terminal no polar @ GND|1:1, sin mover terminales|APROBADO (tensión/temperatura nominal)|PENDIENTE — BAJO|Estabilidad con C11 y ESR del regulador UMW no demostrada; exigir evidencia capacitancia efectiva y ubicación.|
|C8|100nF 50V|No declarado; rótulo histórico: 100nF 50V|Yageo CC0603KRX7R9BB104|C14663|Buck:C8|Buck:C8|Capacitor_SMD:C_0603_1608Metric|FOOTPRINT_ONLY|1→1 terminal no polar @ +5V; 2→2 terminal no polar @ GND|1:1, sin mover terminales|APROBADO (tensión/temperatura nominal)|PENDIENTE — BAJO|Retención ≥70 nF, pines reales del SOIC-16; exigir evidencia capacitancia efectiva y ubicación.|
|C13|100nF|No declarado; rótulo histórico: 100nF|Yageo CC0603KRX7R9BB104|C14663|Buck:C13|Buck:C13|Capacitor_SMD:C_0603_1608Metric|FOOTPRINT_ONLY|1→1 terminal no polar @ +5V; 2→2 terminal no polar @ GND|1:1, sin mover terminales|APROBADO (tensión/temperatura nominal)|PENDIENTE — BAJO|Posición y retorno para latch NAND; exigir evidencia capacitancia efectiva y ubicación.|
|R7|4.7k|No declarado; rótulo histórico: 4.7k|UNI-ROYAL 0603WAF4701T5E|C23162|Buck:R7|Buck:R7|Resistor_SMD:R_0603_1608Metric|FOOTPRINT_ONLY|1→1 terminal no polar @ NTRIP; 2→2 terminal no polar @ +5V|1:1, sin mover terminales|APROBADO (CC)|PENDIENTE — BAJO|VOL salida open collector LM393B.|
|U6|INA180A1IDBVR|No declarado; rótulo histórico: INA180A1IDBVR|INA180A1IDBVR|C122228|Buck:U6|Buck:U6|Buck_SMD:DBV0005A_N|FOOTPRINT_ONLY|1→1 OUT @ ISENSE; 2→2 GND @ GND; 3→3 IN+ @ IP; 4→4 IN- @ VOUT; 5→5 VS @ +5V|1:1, sin mover terminales|Solo pinout documental; aptitud eléctrica pendiente|No aplica|TI SBOS741H p.4, pinout A 1OUT,2GND,3IN+,4IN-,5VS. Se conserva símbolo funcional existente.|
|R8|15k 1%|No declarado; rótulo histórico: 15k 1%|UNI-ROYAL 0603WAF1502T5E|C22809|Buck:R8|Buck:R8|Resistor_SMD:R_0603_1608Metric|FOOTPRINT_ONLY|1→1 terminal no polar @ +5V; 2→2 terminal no polar @ VREF|1:1, sin mover terminales|APROBADO (CC)|PENDIENTE — MEDIO|Umbral VREF influido por tolerancia y TCR pareja R8/R9.|
|U4|SN74HCT00N|No declarado; rótulo histórico: SN74HCT00N|SN74HCT00DR|C6764|Buck:U4|Buck:U4|Buck_SMD:D14|FOOTPRINT_ONLY|1→1 1A @ RESET; 2→2 1B @ NTRIP; 3→3 1Y @ NRESET; 4→4 2A @ RUN; 5→5 2B @ NFAULT; 6→6 2Y @ SD; 7→7 GND @ GND; 8→8 3Y @ FAULT; 9→9 3A @ NTRIP; 10→10 3B @ NFAULT; 11→11 4Y @ NFAULT; 12→12 4A @ NRESET; 13→13 4B @ FAULT; 14→14 VCC @ +5V|1:1, sin mover terminales|Solo pinout documental; aptitud eléctrica pendiente|No aplica|TI SCLS062F p.3, SOIC D14, paso1.27mm; pinout 1:1. Se conserva símbolo funcional existente.|
|R12|10k|No declarado; rótulo histórico: 10k|UNI-ROYAL 0603WAF1002T5E|C25804|Buck:R12|Buck:R12|Resistor_SMD:R_0603_1608Metric|FOOTPRINT_ONLY|1→1 terminal no polar @ FAULT; 2→2 terminal no polar @ FB|1:1, sin mover terminales|APROBADO (CC)|PENDIENTE — BAJO|Corriente de base y pinout Q2 SMD.|
|Q2|2N3904|No declarado; rótulo histórico: 2N3904|MMBT3904|C20526|Buck:Q2|Buck_Redesign:MMBT3904_C20526|Package_TO_SOT_SMD:SOT-23|SYMBOL_REPLACEMENT|1→2 E @ GND; 2→1 B @ FB; 3→3 C @ NFAULT_MCU|B/E permutados por función; comparar netlist normalizada|Solo pinout documental; aptitud eléctrica pendiente|No aplica|Símbolo adaptado de Buck:Q2 para Changjing: 1E->2E,2B->1B,3C->3C. Sin mover cables, pines ni UUID de instancia.|
|R10|31k 1%|No declarado; rótulo histórico: 31k 1%|Vishay CRCW060330K9FKEA|C844354|Buck:R10|Buck:R10|Resistor_THT:R_Axial_DIN0207_L6.3mm_D2.5mm_P7.62mm_Horizontal|PENDING|1→1 terminal no polar @ VOUT; 2→2 terminal no polar @ OVSENSE|Sustitución NO efectuada|APROBADO (CC)|PENDIENTE — MEDIO|MPN propuesto 30.9k incompatible con 31k original sin aceptar cambio. No se asigna MPN ni huella nuevos. Valor no es original 31kΩ; V_OVP nominal=8,18 V en vez de 8,20 V, diferencia 0,24 %; requiere aceptar funcionalmente cambio.|
|C16|100nF|No declarado; rótulo histórico: 100nF|Yageo CC0603KRX7R9BB224|C107083|Buck:C16|Buck:C16|Capacitor_THT:C_Disc_D5.0mm_W2.5mm_P5.00mm|PENDING|1→1 terminal no polar @ +5V; 2→2 terminal no polar @ GND|Sustitución NO efectuada|APROBADO (valor nominal/tensión)|PENDIENTE — MEDIO|MPN propuesto 220nF incompatible con 100nF original sin aceptar cambio. No se asigna MPN ni huella nuevos. Valor elegido 220 nF difiere de esquema histórico 100nF. Ceff≥100nF no demostrada: DC bias/edad/posición; confirmar aceptación del cambio.|
|U5|LM393P|No declarado; rótulo histórico: LM393P|LM393BIDR|C2865059|Buck:U5|Buck:U5|Buck_SMD:D0008A-MFG|FOOTPRINT_ONLY|1→1 OUT1 @ NTRIP; 2→2 IN1- @ ISENSE; 3→3 IN1+ @ VREF; 4→4 GND @ GND; 5→5 IN2+ @ VREF; 6→6 IN2- @ OVSENSE; 7→7 OUT2 @ NTRIP; 8→8 VCC @ +5V|1:1, sin mover terminales|Solo pinout documental; aptitud eléctrica pendiente|No aplica|Pinout 1:1 según TI SLCS005AH p.3; se conserva símbolo con open_collector/input, evitando tipos erróneos tri_state del CAD descargado. Courtyard ausente en huella comercial.|
|C15|100nF|No declarado; rótulo histórico: 100nF|Yageo CC0603KRX7R9BB104|C14663|Buck:C15|Buck:C15|Capacitor_SMD:C_0603_1608Metric|FOOTPRINT_ONLY|1→1 terminal no polar @ VREF; 2→2 terminal no polar @ GND|1:1, sin mover terminales|APROBADO (tensión/temperatura nominal)|PENDIENTE — BAJO|τ = (15k /  / 10k)×100nF =0,600 ms nominal; referencia tarda ~3ms en asentarse; exigir evidencia capacitancia efectiva y ubicación.|
|R13|10k|No declarado; rótulo histórico: 10k|UNI-ROYAL 0603WAF1002T5E|C25804|Buck:R13|Buck:R13|Resistor_SMD:R_0603_1608Metric|FOOTPRINT_ONLY|1→1 terminal no polar @ +3V3; 2→2 terminal no polar @ NFAULT_MCU|1:1, sin mover terminales|APROBADO (CC)|PENDIENTE — BAJO|Pull-up NFAULT_MCU a 3,3 V, no a 5 V.|
|R9|10k 1%|No declarado; rótulo histórico: 10k 1%|UNI-ROYAL 0603WAF1002T5E|C25804|Buck:R9|Buck:R9|Resistor_SMD:R_0603_1608Metric|FOOTPRINT_ONLY|1→1 terminal no polar @ VREF; 2→2 terminal no polar @ GND|1:1, sin mover terminales|APROBADO (CC)|PENDIENTE — MEDIO|Umbral VREF influido por tolerancia y TCR pareja R8/R9.|
|R5|10k|No declarado; rótulo histórico: 10k|UNI-ROYAL 0603WAF1002T5E|C25804|Buck:R5|Buck:R5|Resistor_SMD:R_0603_1608Metric|FOOTPRINT_ONLY|1→1 terminal no polar @ RUN; 2→2 terminal no polar @ GND|1:1, sin mover terminales|APROBADO (CC)|PENDIENTE — BAJO|Pull-down RUN y estado arranque.|
|R11|10k 1%|No declarado; rótulo histórico: 10k 1%|UNI-ROYAL 0603WAF1002T5E|C25804|Buck:R11|Buck:R11|Resistor_SMD:R_0603_1608Metric|FOOTPRINT_ONLY|1→1 terminal no polar @ OVSENSE; 2→2 terminal no polar @ GND|1:1, sin mover terminales|APROBADO (CC)|PENDIENTE — MEDIO|Tolerancia/TCR y valor final R10 afectan umbral OVP.|
|R6|10k|No declarado; rótulo histórico: 10k|UNI-ROYAL 0603WAF1002T5E|C25804|Buck:R6|Buck:R6|Resistor_SMD:R_0603_1608Metric|FOOTPRINT_ONLY|1→1 terminal no polar @ RESET; 2→2 terminal no polar @ GND|1:1, sin mover terminales|APROBADO (CC)|PENDIENTE — BAJO|Pull-down RESET y estado arranque.|
|C14|100nF|No declarado; rótulo histórico: 100nF|Yageo CC0603KRX7R9BB104|C14663|Buck:C14|Buck:C14|Capacitor_SMD:C_0603_1608Metric|FOOTPRINT_ONLY|1→1 terminal no polar @ +5V; 2→2 terminal no polar @ GND|1:1, sin mover terminales|APROBADO (tensión/temperatura nominal)|PENDIENTE — BAJO|Posición y retorno para comparador real; exigir evidencia capacitancia efectiva y ubicación.|
|TP5|VOUT|No declarado; rótulo histórico: VOUT|No definido|No verificado|Buck:TP5|Buck:TP5|TestPoint:TestPoint_THTPad_D2.0mm_Drill1.0mm|PENDING|1→1 VOUT @ VOUT|Sustitución NO efectuada|Solo pinout documental; aptitud eléctrica pendiente|No aplica|Fuera de migración SMD segura: conservar conector/punto de prueba THT; MPN/montaje exacto no cerrado. Sin cambios.|
|R14|3k 1%|No declarado; rótulo histórico: 3k 1%|UNI-ROYAL 0603WAF3001T5E|C4211|Buck:R14|Buck:R14|Resistor_SMD:R_0603_1608Metric|FOOTPRINT_ONLY|1→1 terminal no polar @ VOUT; 2→2 terminal no polar @ VSENSE|1:1, sin mover terminales|APROBADO (CC ≤13,2V)|PENDIENTE — CRÍTICO|ASIGNACIÓN CAD PROVISIONAL, NO APROBACIÓN ELÉCTRICA.  A 20V la potencia equivalente continua casi agota derating; determinar energía de pulso. Además VSENSE≈5,0V pone en riesgo PA0.|
|TP9|MCU_PWM|No declarado; rótulo histórico: MCU_PWM|No definido|No verificado|Buck:TP9|Buck:TP9|TestPoint:TestPoint_THTPad_D2.0mm_Drill1.0mm|PENDING|1→1 MCU_PWM @ MCU_PWM|Sustitución NO efectuada|Solo pinout documental; aptitud eléctrica pendiente|No aplica|Fuera de migración SMD segura: conservar conector/punto de prueba THT; MPN/montaje exacto no cerrado. Sin cambios.|
|TP3|SW|No declarado; rótulo histórico: SW|No definido|No verificado|Buck:TP3|Buck:TP3|TestPoint:TestPoint_THTPad_D2.0mm_Drill1.0mm|PENDING|1→1 SW @ SW|Sustitución NO efectuada|Solo pinout documental; aptitud eléctrica pendiente|No aplica|Fuera de migración SMD segura: conservar conector/punto de prueba THT; MPN/montaje exacto no cerrado. Sin cambios.|
|TP2|GND|No declarado; rótulo histórico: GND|No definido|No verificado|Buck:TP2|Buck:TP2|TestPoint:TestPoint_THTPad_D2.0mm_Drill1.0mm|PENDING|1→1 GND @ GND|Sustitución NO efectuada|Solo pinout documental; aptitud eléctrica pendiente|No aplica|Fuera de migración SMD segura: conservar conector/punto de prueba THT; MPN/montaje exacto no cerrado. Sin cambios.|
|TP1|VIN|No declarado; rótulo histórico: VIN|No definido|No verificado|Buck:TP1|Buck:TP1|TestPoint:TestPoint_THTPad_D2.0mm_Drill1.0mm|PENDING|1→1 VIN @ VIN|Sustitución NO efectuada|Solo pinout documental; aptitud eléctrica pendiente|No aplica|Fuera de migración SMD segura: conservar conector/punto de prueba THT; MPN/montaje exacto no cerrado. Sin cambios.|
|TP6|ISENSE|No declarado; rótulo histórico: ISENSE|No definido|No verificado|Buck:TP6|Buck:TP6|TestPoint:TestPoint_THTPad_D2.0mm_Drill1.0mm|PENDING|1→1 ISENSE @ ISENSE|Sustitución NO efectuada|Solo pinout documental; aptitud eléctrica pendiente|No aplica|Fuera de migración SMD segura: conservar conector/punto de prueba THT; MPN/montaje exacto no cerrado. Sin cambios.|
|R15|1k 1%|No declarado; rótulo histórico: 1k 1%|UNI-ROYAL 0603WAF1001T5E|C21190|Buck:R15|Buck:R15|Resistor_SMD:R_0603_1608Metric|FOOTPRINT_ONLY|1→1 terminal no polar @ VSENSE; 2→2 terminal no polar @ GND|1:1, sin mover terminales|APROBADO (CC)|PENDIENTE — CRÍTICO|ASIGNACIÓN CAD PROVISIONAL, NO APROBACIÓN ELÉCTRICA.  El componente soporta potencia, pero el divisor R14/R15 no protege el ADC en transitorios.|
|TP7|SD|No declarado; rótulo histórico: SD|No definido|No verificado|Buck:TP7|Buck:TP7|TestPoint:TestPoint_THTPad_D2.0mm_Drill1.0mm|PENDING|1→1 SD @ SD|Sustitución NO efectuada|Solo pinout documental; aptitud eléctrica pendiente|No aplica|Fuera de migración SMD segura: conservar conector/punto de prueba THT; MPN/montaje exacto no cerrado. Sin cambios.|
|TP8|NTRIP|No declarado; rótulo histórico: NTRIP|No definido|No verificado|Buck:TP8|Buck:TP8|TestPoint:TestPoint_THTPad_D2.0mm_Drill1.0mm|PENDING|1→1 NTRIP @ NTRIP|Sustitución NO efectuada|Solo pinout documental; aptitud eléctrica pendiente|No aplica|Fuera de migración SMD segura: conservar conector/punto de prueba THT; MPN/montaje exacto no cerrado. Sin cambios.|
|C17|1nF|No declarado; rótulo histórico: 1nF|Fenghua 0603CG102J500NT|C1636|Buck:C17|Buck:C17|Capacitor_SMD:C_0603_1608Metric|FOOTPRINT_ONLY|1→1 terminal no polar @ VSENSE; 2→2 terminal no polar @ GND|1:1, sin mover terminales|APROBADO (tensión/estabilidad nominal)|PENDIENTE — MEDIO|El filtro atenúa 10kHz solo 0,11 %; revisar adquisición ADC y seguridad frente a sobrevoltaje, independiente del rating del capacitor.|
|J3|STM32 CABLE 2x5|No declarado; rótulo histórico: STM32 CABLE 2x5|61201021621|No verificado|Buck:J3|Buck:J3|Connector_PinHeader_2.54mm:PinHeader_2x05_P2.54mm_Vertical|PENDING|1→1 +5V @ +5V; 2→2 GND @ GND; 3→3 MCU_PWM @ MCU_PWM; 4→4 RUN @ RUN; 5→5 RESET @ RESET; 6→6 NFAULT_MCU @ NFAULT_MCU; 7→7 VSENSE @ VSENSE; 8→8 GND @ GND; 9→9 +3V3 @ +3V3; 10→10 GND @ GND|Sustitución NO efectuada|Solo pinout documental; aptitud eléctrica pendiente|No aplica|Fuera de migración SMD segura: conservar conector/punto de prueba THT; MPN/montaje exacto no cerrado. Sin cambios.|
|TP4|GATE|No declarado; rótulo histórico: GATE|No definido|No verificado|Buck:TP4|Buck:TP4|TestPoint:TestPoint_THTPad_D2.0mm_Drill1.0mm|PENDING|1→1 GATE @ GATE|Sustitución NO efectuada|Solo pinout documental; aptitud eléctrica pendiente|No aplica|Fuera de migración SMD segura: conservar conector/punto de prueba THT; MPN/montaje exacto no cerrado. Sin cambios.|

## Decisiones explícitas

R10=31k 1% y C16=100nF se mantienen. Las propuestas 30.9k / 220nF NO se aceptan en esta migración. L1/L2 no reciben huella Murata improvisada. C6/C7, R14/R15 y RS1 usan land genérico de encapsulado como provisional; conservan bloqueos eléctricos del informe. C4/C5 mantienen 10uF y rótulo histórico 35V low ESR; MPN candidato es 50V y su nueva ESR/capacitancia efectiva requiere aprobación del control. C11 mantiene 10uF 25V.

Los símbolos por referencia Buck válidos se conservan cuando su pinout coincide: no se requiere convertirlos en símbolos de proveedor para usar una huella SMD. Q2 y C11 se adaptan a partir de geometría local, sin confiar en el CAD de Diotec para el MPN Changjing. U1 no se reconecta como DIP14: su numeración real de SOIC16 se conserva, incluidas NC4/5/9/10/16.

## Fichas de contraste

- Infineon IR2110 rev.V pp.5,16: https://www.infineon.com/assets/row/public/documents/24/49/infineon-ir2110-datasheet-en.pdf (consultada online; local rev.U difiere y omite dibujo SOIC).
- TI LM393 SLCS005AH p.3: https://www.ti.com/lit/ds/symlink/lm393.pdf
- TI INA180 SBOS741H p.4: https://www.ti.com/lit/ds/symlink/ina180.pdf
- TI HCT00 SCLS062F p.3 y encapsulado D: https://www.ti.com/lit/ds/symlink/sn74hct00.pdf
- Locales copiados: libraries/datasheets/Changjing_MMBT3904.pdf p.1/3; UMW_78Mxx.pdf p.1/14; MDD_SS34.pdf p.1/3; TAI_RLP.pdf p.3; TI_SN74HCT14.pdf.
- Panasonic E7/C6 y tamaños 0603/0805: informe principal §6 y matriz; land y montaje siguen pendientes de aprobación mecánica.
