almondsun/DynamicSystemsAndControl/project/pcb/release/fabrication-review/READ_BEFORE_ORDERING.txt

REVIEW EXPORT ONLY — FABRICATION ON HOLD

Buck revision A, nominal outline 99 x 99 mm, two layers, FR-4 1.6 mm,
1 oz copper, green solder mask, standard HASL finish, five bare boards.

Before ordering: qualify received inductor/capacitor packages and electrical
ratings, verify the soldered prototype, rerun CAD checks after any changes,
and obtain the delivered quote for the real Colombian destination.

L1/L2 footprint is PROVISIONAL (25 mm body, 10 mm pitch, 1.3 mm hole).
No fabrication purchase, assembly or powered test has been performed.
See ../../docs/assembly-and-tests.md and ../../VALIDATION.md.
