almondsun/DynamicSystemsAndControl/project/pcb/audit/final_review_evidence/bom-review-only.csv

Reference | Value | Footprint | MPN | Candidate_MPN | LCSC | Candidate_LCSC | Approval | Through_hole | Review_only
C1 | 100uF 25V | Buck_SMD:PCAP_SVP_E7_PAN | Panasonic 25SVPF100M | Panasonic 25SVPF100M | C136279 | C136279 | PENDING - NOT APPROVED | False | True
C2 | 100uF 25V | Buck_SMD:PCAP_SVP_E7_PAN | Panasonic 25SVPF100M | Panasonic 25SVPF100M | C136279 | C136279 | PENDING - NOT APPROVED | False | True
C3 | 100nF 50V | Capacitor_SMD:C_0603_1608Metric | Yageo CC0603KRX7R9BB104 | Yageo CC0603KRX7R9BB104 | C14663 | C14663 | PENDING - NOT APPROVED | False | True
C4 | 10uF 35V low ESR | Buck_SMD:CAP_SVF_C6_PAN | Panasonic 50SVF10M | Panasonic 50SVF10M | C454354 | C454354 | PENDING - NOT APPROVED | False | True
C5 | 10uF 35V low ESR | Buck_SMD:CAP_SVF_C6_PAN | Panasonic 50SVF10M | Panasonic 50SVF10M | C454354 | C454354 | PENDING - NOT APPROVED | False | True
D1 | SS34 | Diode_SMD:D_SMA | SS34 | SS34 | C8678 | C8678 | PENDING - NOT APPROVED | False | True
J1 | 12V FUSED INPUT | TerminalBlock_Phoenix:TerminalBlock_Phoenix_MKDS-1,5-2_1x02_P5.00mm_Horizontal |  | TB002-500-02BE |  | C2757858 | PENDING - NOT APPROVED | True | True
J2 | LOAD + / - | TerminalBlock_Phoenix:TerminalBlock_Phoenix_MKDS-1,5-2_1x02_P5.00mm_Horizontal |  | TB002-500-02BE |  | C2757858 | PENDING - NOT APPROVED | True | True
L1 | 330uH >=3A Isat VERIFY | Buck:Inductor_25mm_P10mm_VERIFY |  | Murata 60B334C |  | C6823957 | PENDING - NOT APPROVED | True | True
L2 | 330uH >=3A Isat VERIFY | Buck:Inductor_25mm_P10mm_VERIFY |  | Murata 60B334C |  | C6823957 | PENDING - NOT APPROVED | True | True
Q1 | IRFZ44N TO-220 | Package_TO_SOT_THT:TO-220-3_Vertical |  | IRFZ44NS |  | C5199867 | PENDING - NOT APPROVED | True | True
RS1 | 0.050R 1% 1W | Resistor_SMD:R_2512_6332Metric | TA-I RLP25FEER050 | TA-I RLP25FEER050 | C160588 | C160588 | PENDING - NOT APPROVED | False | True
C6 | 2.2uF 50V X7R 10% | Capacitor_SMD:C_1206_3216Metric | CL31B225KBHNNNE | CL31B225KBHNNNE | C50254 | C50254 | PENDING - NOT APPROVED | False | True
C7 | 100nF 50V | Capacitor_SMD:C_0603_1608Metric | Yageo CC0603KRX7R9BB104 | Yageo CC0603KRX7R9BB104 | C14663 | C14663 | PENDING - NOT APPROVED | False | True
C8 | 100nF 50V | Capacitor_SMD:C_0603_1608Metric | Yageo CC0603KRX7R9BB104 | Yageo CC0603KRX7R9BB104 | C14663 | C14663 | PENDING - NOT APPROVED | False | True
C9 | 330nF 50V | Capacitor_SMD:C_0805_2012Metric | Samsung CL21B334KBFNNNE | Samsung CL21B334KBFNNNE | C73142 | C73142 | PENDING - NOT APPROVED | False | True
C10 | 100nF 50V | Capacitor_SMD:C_0603_1608Metric | Yageo CC0603KRX7R9BB104 | Yageo CC0603KRX7R9BB104 | C14663 | C14663 | PENDING - NOT APPROVED | False | True
C11 | 10uF 25V | Capacitor_SMD:C_0805_2012Metric | Samsung CL21A106KAYNNNE | Samsung CL21A106KAYNNNE | C15850 | C15850 | PENDING - NOT APPROVED | False | True
C12 | 100nF | Capacitor_SMD:C_0603_1608Metric | Yageo CC0603KRX7R9BB104 | Yageo CC0603KRX7R9BB104 | C14663 | C14663 | PENDING - NOT APPROVED | False | True
D2 | UF4004 | Diode_THT:D_DO-41_SOD81_P10.16mm_Horizontal |  | US1G |  | C3034075 | PENDING - NOT APPROVED | True | True
R1 | 10R | Resistor_SMD:R_0805_2012Metric | UNI-ROYAL 0805W8F100JT5E | UNI-ROYAL 0805W8F100JT5E | C17415 | C17415 | PENDING - NOT APPROVED | False | True
R2 | 10k | Resistor_SMD:R_0603_1608Metric | UNI-ROYAL 0603WAF1002T5E | UNI-ROYAL 0603WAF1002T5E | C25804 | C25804 | PENDING - NOT APPROVED | False | True
R3 | 10k | Resistor_SMD:R_0603_1608Metric | UNI-ROYAL 0603WAF1002T5E | UNI-ROYAL 0603WAF1002T5E | C25804 | C25804 | PENDING - NOT APPROVED | False | True
R4 | 1k | Resistor_SMD:R_0603_1608Metric | UNI-ROYAL 0603WAF1001T5E | UNI-ROYAL 0603WAF1001T5E | C21190 | C21190 | PENDING - NOT APPROVED | False | True
U1 | IR2110STRPBF | Package_SO:SOIC-16W_7.5x10.3mm_P1.27mm | IR2110STRPBF | IR2110STRPBF | C2968 | C2968 | PENDING - NOT APPROVED | False | True
U2 | 78M05 | Package_TO_SOT_SMD:TO-252-2 | 78M05 | 78M05 | C347278 | C347278 | PENDING - NOT APPROVED | False | True
U3 | SN74HCT14DR | Buck_SMD:D14 | SN74HCT14DR | SN74HCT14DR | C6769 | C6769 | PENDING - NOT APPROVED | False | True
C13 | 100nF | Capacitor_SMD:C_0603_1608Metric | Yageo CC0603KRX7R9BB104 | Yageo CC0603KRX7R9BB104 | C14663 | C14663 | PENDING - NOT APPROVED | False | True
C14 | 100nF | Capacitor_SMD:C_0603_1608Metric | Yageo CC0603KRX7R9BB104 | Yageo CC0603KRX7R9BB104 | C14663 | C14663 | PENDING - NOT APPROVED | False | True
C15 | 100nF | Capacitor_SMD:C_0603_1608Metric | Yageo CC0603KRX7R9BB104 | Yageo CC0603KRX7R9BB104 | C14663 | C14663 | PENDING - NOT APPROVED | False | True
C16 | 220nF 50V X7R 10% | Capacitor_SMD:C_0603_1608Metric | CC0603KRX7R9BB224 | CC0603KRX7R9BB224 | C107083 | C107083 | PENDING - NOT APPROVED | False | True
Q2 | MMBT3904 | Package_TO_SOT_SMD:SOT-23 | MMBT3904 | MMBT3904 | C20526 | C20526 | PENDING - NOT APPROVED | False | True
R5 | 10k | Resistor_SMD:R_0603_1608Metric | UNI-ROYAL 0603WAF1002T5E | UNI-ROYAL 0603WAF1002T5E | C25804 | C25804 | PENDING - NOT APPROVED | False | True
R6 | 10k | Resistor_SMD:R_0603_1608Metric | UNI-ROYAL 0603WAF1002T5E | UNI-ROYAL 0603WAF1002T5E | C25804 | C25804 | PENDING - NOT APPROVED | False | True
R7 | 4.7k | Resistor_SMD:R_0603_1608Metric | UNI-ROYAL 0603WAF4701T5E | UNI-ROYAL 0603WAF4701T5E | C23162 | C23162 | PENDING - NOT APPROVED | False | True
R8 | 15k 1% | Resistor_SMD:R_0603_1608Metric | UNI-ROYAL 0603WAF1502T5E | UNI-ROYAL 0603WAF1502T5E | C22809 | C22809 | PENDING - NOT APPROVED | False | True
R9 | 10k 1% | Resistor_SMD:R_0603_1608Metric | UNI-ROYAL 0603WAF1002T5E | UNI-ROYAL 0603WAF1002T5E | C25804 | C25804 | PENDING - NOT APPROVED | False | True
R10 | 30.9k 1% | Resistor_SMD:R_0603_1608Metric | CRCW060330K9FKEA | CRCW060330K9FKEA | C844354 | C844354 | PENDING - NOT APPROVED | False | True
R11 | 10k 1% | Resistor_SMD:R_0603_1608Metric | UNI-ROYAL 0603WAF1002T5E | UNI-ROYAL 0603WAF1002T5E | C25804 | C25804 | PENDING - NOT APPROVED | False | True
R12 | 10k | Resistor_SMD:R_0603_1608Metric | UNI-ROYAL 0603WAF1002T5E | UNI-ROYAL 0603WAF1002T5E | C25804 | C25804 | PENDING - NOT APPROVED | False | True
R13 | 10k | Resistor_SMD:R_0603_1608Metric | UNI-ROYAL 0603WAF1002T5E | UNI-ROYAL 0603WAF1002T5E | C25804 | C25804 | PENDING - NOT APPROVED | False | True
U4 | SN74HCT00DR | Buck_SMD:D14 | SN74HCT00DR | SN74HCT00DR | C6764 | C6764 | PENDING - NOT APPROVED | False | True
U5 | LM393BIDR | Buck_SMD:D0008A-MFG | LM393BIDR | LM393BIDR | C2865059 | C2865059 | PENDING - NOT APPROVED | False | True
U6 | INA180A1IDBVR | Buck_SMD:DBV0005A_N | INA180A1IDBVR | INA180A1IDBVR | C122228 | C122228 | PENDING - NOT APPROVED | False | True
C17 | 1nF | Capacitor_SMD:C_0603_1608Metric | Fenghua 0603CG102J500NT | Fenghua 0603CG102J500NT | C1636 | C1636 | PENDING - NOT APPROVED | False | True
J3 | NUCLEO-L432KC EXT USB | Connector_IDC:IDC-Header_2x05_P2.54mm_Vertical | TBD keyed IDC header 2x5 2.54mm | TBD keyed IDC header 2x5 2.54mm | NOT SELECTED | NOT SELECTED | PENDING - NOT APPROVED | True | True
R14 | 15k 1% | Resistor_SMD:R_0603_1608Metric | 0603WAF1502T5E | 0603WAF1502T5E | C22809 | C22809 | PENDING - NOT APPROVED | False | True
R15 | 2.2k 1% | Resistor_SMD:R_0603_1608Metric | 0603WAF2201T5E | 0603WAF2201T5E | C4190 | C4190 | PENDING - NOT APPROVED | False | True
TP1 | VIN | TestPoint:TestPoint_THTPad_D2.0mm_Drill1.0mm |  | No definido |  | No verificado | PENDING - NOT APPROVED | True | True
TP2 | GND | TestPoint:TestPoint_THTPad_D2.0mm_Drill1.0mm |  | No definido |  | No verificado | PENDING - NOT APPROVED | True | True
TP3 | SW | TestPoint:TestPoint_THTPad_D2.0mm_Drill1.0mm |  | No definido |  | No verificado | PENDING - NOT APPROVED | True | True
TP4 | GATE | TestPoint:TestPoint_THTPad_D2.0mm_Drill1.0mm |  | No definido |  | No verificado | PENDING - NOT APPROVED | True | True
TP5 | VOUT | TestPoint:TestPoint_THTPad_D2.0mm_Drill1.0mm |  | No definido |  | No verificado | PENDING - NOT APPROVED | True | True
TP6 | ISENSE | TestPoint:TestPoint_THTPad_D2.0mm_Drill1.0mm |  | No definido |  | No verificado | PENDING - NOT APPROVED | True | True
TP7 | SD | TestPoint:TestPoint_THTPad_D2.0mm_Drill1.0mm |  | No definido |  | No verificado | PENDING - NOT APPROVED | True | True
TP8 | NTRIP | TestPoint:TestPoint_THTPad_D2.0mm_Drill1.0mm |  | No definido |  | No verificado | PENDING - NOT APPROVED | True | True
TP9 | MCU_PWM | TestPoint:TestPoint_THTPad_D2.0mm_Drill1.0mm |  | No definido |  | No verificado | PENDING - NOT APPROVED | True | True
