almondsun/DynamicSystemsAndControl/project/pcb/redesign/production/jlcpcb-revB-2026-10-27/bom_jlcpcb_revB.csv

Comment | Designator | Footprint | LCSC Part # | MPN
100uF 25V | C1,C2 | CP_Panasonic_SVPF_E7_Land | C136279 | 25SVPF100M
10uF 25V | C11 | C_0805_2012Metric | C15850 | CL21A106KAYNNNE
220nF 50V X7R 10% | C16 | C_0603_1608Metric | C107083 | CC0603KRX7R9BB224
1nF | C17,C21 | C_0603_1608Metric | C1636 | 0603CG102J500NT
100nF | C3,C7,C8,C10,C12,C13,C14,C15,C18,C19,C20,C22 | C_0603_1608Metric | C14663 | CC0603KRX7R9BB104
10uF 50V 50SVF10M | C4,C5 | CP_Panasonic_SVF_C6_Land | C454354 | 50SVF10M
2.2uF 50V X7R 10% | C6 | C_1206_3216Metric | C50254 | CL31B225KBHNNNE
330nF 50V | C9 | C_0805_2012Metric | C73142 | CL21B334KBFNNNE
SS34 | D1 | D_SMA | C8678 | SS34
BAT54WS-7-F | D3,D4,D5 | Diodes_SOD323 | C124205 | BAT54WS-7-F
MMBT3904 | Q2 | SOT-23 | C20526 | MMBT3904
10R | R1 | R_0805_2012Metric | C17415 | 0805W8F100JT5E
30.9k 1% | R10 | R_0603_1608Metric | C23022 | 0603WAF3092T5E
2.2k | R15,R23 | R_0603_1608Metric | C4190 | 0603WAF2201T5E
100k | R18,R21,R24 | R_0603_1608Metric | C25803 | 0603WAF1003T5E
22k | R19 | R_0603_1608Metric | C31850 | 0603WAF2202T5E
10k | R2,R3,R5,R6,R9,R11,R12,R13,R16,R17,R22 | R_0603_1608Metric | C25804 | 0603WAF1002T5E
1k | R4,R20 | R_0603_1608Metric | C21190 | 0603WAF1001T5E
4.7k | R7 | R_0603_1608Metric | C23162 | 0603WAF4701T5E
15k 1% | R8,R14 | R_0603_1608Metric | C22809 | 0603WAF1502T5E
0.050R 1% 2W RLP25FEER050 | RS1 | R_TAI_RLP25_2512_Kelvin | C160588 | RLP25FEER050
IR2110STRPBF | U1 | SOIC-16W_7.5x10.3mm_P1.27mm | C2968 | IR2110STRPBF
LM4040AIM3X-2.5/NOPB | U10 | TI_DBZ0003A_SOT-23-3 | C111866 | LM4040AIM3X-2.5/NOPB
78M05 | U2 | TO-252-2 | C347278 | 78M05
SN74HCT14DR | U3 | TI_D0014A_SOIC-14 | C6769 | SN74HCT14DR
SN74HCT00DR | U4 | TI_D0014A_SOIC-14 | C6764 | SN74HCT00DR
LM393BIDR | U5 | TI_D0008A_SOIC-8 | C2865059 | LM393BIDR
INA180A1IDBVR | U6 | TI_DBV0005A_SOT-23-5 | C122228 | INA180A1IDBVR
SN74LV4T125PWR | U7 | TI_PW0014A_TSSOP-14 | C90755 | SN74LV4T125PWR
TMUX1511PWR | U8 | TI_PW0014A_TSSOP-14 | C2866750 | TMUX1511PWR
TPS3808G33DBVR | U9 | TI_DBV0006A_SOT-23-6 | C43698 | TPS3808G33DBVR
