almondsun/DynamicSystemsAndControl/project/pcb/redesign/sources/matriz_verificacion_pasivos_buck_legible.xlsx

Sheet: Matriz
ref | mpn | code | tech | stress | rating | elec | integ | why
L1 | Murata 60B334C | C6823957 | 330 µH ±15 %, SMD 6000B | I_RMS ≤1,470 A; I_pk ≤1,775 A; P_Cu≈0,217 W a 85 °C | 4 A bajo criterio L≥75 % o ΔT≤40 °C; DCR máx 80 mΩ, ambiente −40…85 °C | PENDIENTE | PENDIENTE — CRÍTICO | Inductancia efectiva por bobina debe sostener L_total≥528 µH; a −15 % inicial quedan 561 µH y solo 5,9 % de pérdida admisible. Curva L(I,T) y pérdidas núcleo ausentes; land Murata obligatorio.
L2 | Murata 60B334C | C6823957 | 330 µH ±15 %, SMD 6000B | Igual L1; las dos bobinas en serie conducen misma corriente | Igual L1; DCR total máx 160 mΩ a referencia | PENDIENTE | PENDIENTE — CRÍTICO | Comprobar influencia de proximidad/acoplamiento: L_eq = L1+L2±2M. Validar I de saturación por condición de 80 % del nominal y temperatura.
C1 | Panasonic 25SVPF100M | C136279 | 100 µF ±20 %, 25 V, OS-CON E7 Ø8×6,9 mm | I_C,RMS por unidad ≥0,60 A a 10 kHz; V≤13,2 V | 2,24 A a 10 kHz/≤105 °C (3,2 A @100 kHz×0,7); ESR≤24 mΩ @100 kHz | APROBADO (rizado y tensión) | PENDIENTE — MEDIO | Margen I_ripple 3,73× y VDC 1,89×. Verificar C_banco efectiva≥160 µF con vida/temperatura y ESR @10k; land E7 y polaridad. 160 µF es mínimo por tolerancia inicial, no de vida.
C2 | Panasonic 25SVPF100M | C136279 | 100 µF ±20 %, 25 V, OS-CON E7 Ø8×6,9 mm | I_C,RMS por unidad ≥0,60 A a 10 kHz; V≤13,2 V | 2,24 A a 10 kHz/≤105 °C (3,2 A @100 kHz×0,7); ESR≤24 mΩ @100 kHz | APROBADO (rizado y tensión) | PENDIENTE — MEDIO | Margen I_ripple 3,73× y VDC 1,89×. Verificar C_banco efectiva≥160 µF con vida/temperatura y ESR @10k; land E7 y polaridad. 160 µF es mínimo por tolerancia inicial, no de vida.
C3 | Yageo CC0603KRX7R9BB104 | C14663 | 100 nF ±10 %, 50 V X7R 0603 | Desacoplo VIN potencia; Vdc≤13,2 V | 50 V; −55…125 °C nominales; C_min nominal 90 nF antes de DC/T/edad | APROBADO (tensión/temperatura nominal) | PENDIENTE — BAJO | Retención de ≥70 nF con DC/temperatura y proximidad Q1/D1; exigir evidencia capacitancia efectiva y ubicación.
C4 | Panasonic 50SVF10M | C454354 | 10 µF ±20 %, 50 V, OS-CON C6 Ø6,3×5,9 mm | I_C,RMS por unidad ≥0,15 A @10 kHz; V≤20 V transitorio supuesto | 1,75 A @10 kHz y ≤105 °C (2,5 A @100k×0,7); ESR≤40 mΩ @100 kHz | APROBADO (rizado y tensión) | PENDIENTE — ALTO | Margen corriente 11,7× y tensión nominal ≥2,5× frente a 20 V hipotéticos. C_banco efectiva≥16 µF a vida/temperatura no demostrada; ESR @10 kHz y estabilidad PI; land C6 y polaridad.
C5 | Panasonic 50SVF10M | C454354 | 10 µF ±20 %, 50 V, OS-CON C6 Ø6,3×5,9 mm | I_C,RMS por unidad ≥0,15 A @10 kHz; V≤20 V transitorio supuesto | 1,75 A @10 kHz y ≤105 °C (2,5 A @100k×0,7); ESR≤40 mΩ @100 kHz | APROBADO (rizado y tensión) | PENDIENTE — ALTO | Margen corriente 11,7× y tensión nominal ≥2,5× frente a 20 V hipotéticos. C_banco efectiva≥16 µF a vida/temperatura no demostrada; ESR @10 kHz y estabilidad PI; land C6 y polaridad.
C6 | Samsung CL21B105KBFNNNE | C28323 | 1 µF ±10 %, 50 V X7R 0805 | Q_boot≈259 nC por pulso de 95 µs (hipótesis); ΔVBS=0,259 V si Ceff=1µF | 1µF solo nominal; límite −10 % ya es 0,9µF a 0 V; sesgo DC resta más | PENDIENTE | PENDIENTE — CRÍTICO | No se demuestra objetivo Ceff≥1 µF. Evaluar C6 en 10–13 V DC, tiempos off de 5µs, carga inicial y VBS/VGS; reservar posibilidad segundo MLCC sin poblar a ciegas.
C7 | Yageo CC0603KRX7R9BB104 | C14663 | 100 nF ±10 %, 50 V X7R 0603 | Desacoplo VCC driver IR2110; Vdc≤13,2 V | 50 V; −55…125 °C nominales; C_min nominal 90 nF antes de DC/T/edad | APROBADO (tensión/temperatura nominal) | PENDIENTE — CRÍTICO | 100 nF no demuestra reserva de carga de bootstrap; ver eventual C18 local; exigir evidencia capacitancia efectiva y ubicación.
C8 | Yageo CC0603KRX7R9BB104 | C14663 | 100 nF ±10 %, 50 V X7R 0603 | Desacoplo VDD IR2110; Vdc≤5,25 V | 50 V; −55…125 °C nominales; C_min nominal 90 nF antes de DC/T/edad | APROBADO (tensión/temperatura nominal) | PENDIENTE — BAJO | Retención ≥70 nF, pines reales del SOIC-16; exigir evidencia capacitancia efectiva y ubicación.
C9 | Samsung CL21B334KBFNNNE | C73142 | 330 nF ±10 %, 50 V X7R 0805 | VIN≤13,2 V; CI del esquema 78M05=330 nF nominal | 50 V nominal, X7R; DC bias y vida sin límite garantizado recuperado | APROBADO (valor nominal/tensión) | PENDIENTE — MEDIO | No trasladar CI nominal de aplicación de UMW a mínimo efectivo garantizado; revisar necesidad de ESR/localidad.
C10 | Yageo CC0603KRX7R9BB104 | C14663 | 100 nF ±10 %, 50 V X7R 0603 | Desacoplo salida 78M05; Vdc≤5,25 V | 50 V; −55…125 °C nominales; C_min nominal 90 nF antes de DC/T/edad | APROBADO (tensión/temperatura nominal) | PENDIENTE — BAJO | Estabilidad con C11 y ESR del regulador UMW no demostrada; exigir evidencia capacitancia efectiva y ubicación.
C11 | Samsung CL21A106KAYNNNE | C15850 | 10 µF ±10 %, 25 V X5R 0805 | V5 máximo supuesto 5,25 V; objetivo Ceff≥5µF | 25 V, X5R; a mínima tolerancia 9µF, requiere retención adicional ≥55,6 % | APROBADO (tensión nominal) | PENDIENTE — MEDIO | Curva de DC bias del MPN y ESR/estabilidad del UMW 78M05 no certificadas para todo el rango.
C12 | Yageo CC0603KRX7R9BB104 | C14663 | 100 nF ±10 %, 50 V X7R 0603 | Bypass SN74HCT14; Vdc≤5,25 V | 50 V; −55…125 °C nominales; C_min nominal 90 nF antes de DC/T/edad | APROBADO (tensión/temperatura nominal) | PENDIENTE — BAJO | Posición y retorno para conmutación HCT14; exigir evidencia capacitancia efectiva y ubicación.
C13 | Yageo CC0603KRX7R9BB104 | C14663 | 100 nF ±10 %, 50 V X7R 0603 | Bypass SN74HCT00; Vdc≤5,25 V | 50 V; −55…125 °C nominales; C_min nominal 90 nF antes de DC/T/edad | APROBADO (tensión/temperatura nominal) | PENDIENTE — BAJO | Posición y retorno para latch NAND; exigir evidencia capacitancia efectiva y ubicación.
C14 | Yageo CC0603KRX7R9BB104 | C14663 | 100 nF ±10 %, 50 V X7R 0603 | Bypass LM393B; Vdc≤5,25 V | 50 V; −55…125 °C nominales; C_min nominal 90 nF antes de DC/T/edad | APROBADO (tensión/temperatura nominal) | PENDIENTE — BAJO | Posición y retorno para comparador real; exigir evidencia capacitancia efectiva y ubicación.
C15 | Yageo CC0603KRX7R9BB104 | C14663 | 100 nF ±10 %, 50 V X7R 0603 | Filtro VREF; Vdc≤2,13 V | 50 V; −55…125 °C nominales; C_min nominal 90 nF antes de DC/T/edad | APROBADO (tensión/temperatura nominal) | PENDIENTE — BAJO | τ = (15k||10k)×100nF =0,600 ms nominal; referencia tarda ~3ms en asentarse; exigir evidencia capacitancia efectiva y ubicación.
C16 | Yageo CC0603KRX7R9BB224 | C107083 | 220 nF ±10 %, 50 V X7R 0603 (cambio del original 100 nF) | Bypass INA180A1; recomendación TI 100 nF local | 220nF inicial; min tolerancia 198nF; X7R ±15 % rango T | APROBADO (valor nominal/tensión) | PENDIENTE — MEDIO | Valor elegido 220 nF difiere de esquema histórico 100nF. Ceff≥100nF no demostrada: DC bias/edad/posición; confirmar aceptación del cambio.
C17 | Fenghua 0603CG102J500NT | C1636 | 1 nF ±5 %, 50 V C0G 0603 | VADC≤~3,35 V a VOUT=13,2 V y tolerancias; τ=0,75µs | 50 V, C0G; variación muy baja frente a X7R | APROBADO (tensión/estabilidad nominal) | PENDIENTE — MEDIO | El filtro atenúa 10kHz solo 0,11 %; revisar adquisición ADC y seguridad frente a sobrevoltaje, independiente del rating del capacitor.
R1 | UNI-ROYAL 0805W8F100JT5E | C17415 | 10 Ω ±1 %, 0805; 0,125 W | ≈1,33 A pico ideal; ≈17,6 W pico; 13,2 mW de energía gate total | Resistencias 0603: 0,1 W @70 °C, ≈0,082 W @85 °C; 0805 0,125 W (curva distinta según serie) | PENDIENTE | PENDIENTE — ALTO | Curva de pulsos repetitivos no contrastada; 13,2 mW es potencia total simplificada, no la que disipa necesariamente R1.
RS1 | TA-I RLP25FEER050 | C160588 | 50 mΩ ±1 %, 2512, ±50 ppm/°C | P≤0,109 W normal; P≈0,316 W a 2,5 A; V≈0,126 V | 2 W nominales *solo bajo cobre 105 µm/área 300 mm²*; Toper −55…170 °C | APROBADO (potencia calculada, no térmica) | PENDIENTE — ALTO | Con 1 oz (~35 µm) no atribuir 2 W. Demostrar derating y temperatura a 0,316 W; kelvin desde pads; land TA-I específico.
R2 | UNI-ROYAL 0603WAF1002T5E | C25804 | 10 kΩ ±1 %, 0603; 0,1 W | ≤1,333 mA; ≤17,60 mW | Resistencias 0603: 0,1 W @70 °C, ≈0,082 W @85 °C; 0805 0,125 W (curva distinta según serie) | APROBADO (CC) | PENDIENTE — ALTO | Su descarga gate agrega consumo al bootstrap en cada ciclo; validar VBS.
R3 | UNI-ROYAL 0603WAF1002T5E | C25804 | 10 kΩ ±1 %, 0603; 0,1 W | ≤0,483 mA; ≤2,31 mW | Resistencias 0603: 0,1 W @70 °C, ≈0,082 W @85 °C; 0805 0,125 W (curva distinta según serie) | APROBADO (CC) | PENDIENTE — BAJO | Revisión inyección hacia MCU apagado.
R4 | UNI-ROYAL 0603WAF1001T5E | C21190 | 1 kΩ ±1 %, 0603; 0,1 W | ≤5,303 mA; ≤27,84 mW | Resistencias 0603: 0,1 W @70 °C, ≈0,082 W @85 °C; 0805 0,125 W (curva distinta según serie) | APROBADO (CC) | PENDIENTE — MEDIO | Corriente interfaz con MCU desconectado o sin alimentación.
R5 | UNI-ROYAL 0603WAF1002T5E | C25804 | 10 kΩ ±1 %, 0603; 0,1 W | ≤0,350 mA; ≤1,21 mW | Resistencias 0603: 0,1 W @70 °C, ≈0,082 W @85 °C; 0805 0,125 W (curva distinta según serie) | APROBADO (CC) | PENDIENTE — BAJO | Pull-down RUN y estado arranque.
R6 | UNI-ROYAL 0603WAF1002T5E | C25804 | 10 kΩ ±1 %, 0603; 0,1 W | ≤0,350 mA; ≤1,21 mW | Resistencias 0603: 0,1 W @70 °C, ≈0,082 W @85 °C; 0805 0,125 W (curva distinta según serie) | APROBADO (CC) | PENDIENTE — BAJO | Pull-down RESET y estado arranque.
R7 | UNI-ROYAL 0603WAF4701T5E | C23162 | 4,7 kΩ ±1 %, 0603; 0,1 W | ≤1,128 mA; ≤5,92 mW | Resistencias 0603: 0,1 W @70 °C, ≈0,082 W @85 °C; 0805 0,125 W (curva distinta según serie) | APROBADO (CC) | PENDIENTE — BAJO | VOL salida open collector LM393B.
R8 | UNI-ROYAL 0603WAF1502T5E | C22809 | 15 kΩ ±1 %, 0603; 0,1 W | ≤0,214 mA; ≤0,679 mW | Resistencias 0603: 0,1 W @70 °C, ≈0,082 W @85 °C; 0805 0,125 W (curva distinta según serie) | APROBADO (CC) | PENDIENTE — MEDIO | Umbral VREF influido por tolerancia y TCR pareja R8/R9.
R9 | UNI-ROYAL 0603WAF1002T5E | C25804 | 10 kΩ ±1 %, 0603; 0,1 W | ≤0,215 mA; ≤0,456 mW | Resistencias 0603: 0,1 W @70 °C, ≈0,082 W @85 °C; 0805 0,125 W (curva distinta según serie) | APROBADO (CC) | PENDIENTE — MEDIO | Umbral VREF influido por tolerancia y TCR pareja R8/R9.
R10 | Vishay CRCW060330K9FKEA | C844354 | 30,9 kΩ ±1 %, 0603; 0,1 W (alternativa adoptada) | <0,33 mA; ≤3,3 mW a 13,2 V, ≈7,5mW a 20 V | Resistencias 0603: 0,1 W @70 °C, ≈0,082 W @85 °C; 0805 0,125 W (curva distinta según serie) | APROBADO (CC) | PENDIENTE — MEDIO | Valor no es original 31kΩ; V_OVP nominal=8,18 V en vez de 8,20 V, diferencia 0,24 %; requiere aceptar funcionalmente cambio.
R11 | UNI-ROYAL 0603WAF1002T5E | C25804 | 10 kΩ ±1 %, 0603; 0,1 W | ≤0,330 mA; ≤1,08 mW a 13,2 V | Resistencias 0603: 0,1 W @70 °C, ≈0,082 W @85 °C; 0805 0,125 W (curva distinta según serie) | APROBADO (CC) | PENDIENTE — MEDIO | Tolerancia/TCR y valor final R10 afectan umbral OVP.
R12 | UNI-ROYAL 0603WAF1002T5E | C25804 | 10 kΩ ±1 %, 0603; 0,1 W | ≤0,480 mA; ≤2,28 mW | Resistencias 0603: 0,1 W @70 °C, ≈0,082 W @85 °C; 0805 0,125 W (curva distinta según serie) | APROBADO (CC) | PENDIENTE — BAJO | Corriente de base y pinout Q2 SMD.
R13 | UNI-ROYAL 0603WAF1002T5E | C25804 | 10 kΩ ±1 %, 0603; 0,1 W | ≤0,350 mA; ≤1,21 mW | Resistencias 0603: 0,1 W @70 °C, ≈0,082 W @85 °C; 0805 0,125 W (curva distinta según serie) | APROBADO (CC) | PENDIENTE — BAJO | Pull-up NFAULT_MCU a 3,3 V, no a 5 V.
R14 | UNI-ROYAL 0603WAF3001T5E | C4211 | 3 kΩ ±1 %, 0603; 0,1 W | 33,3 mW a 13,2 V; ≈76,5 mW a 20 V | Resistencias 0603: 0,1 W @70 °C, ≈0,082 W @85 °C; 0805 0,125 W (curva distinta según serie) | APROBADO (CC ≤13,2V) | PENDIENTE — CRÍTICO | A 20V la potencia equivalente continua casi agota derating; determinar energía de pulso. Además VSENSE≈5,0V pone en riesgo PA0.
R15 | UNI-ROYAL 0603WAF1001T5E | C21190 | 1 kΩ ±1 %, 0603; 0,1 W | 11,33 mW a 13,2 V; ≈26mW a 20 V | Resistencias 0603: 0,1 W @70 °C, ≈0,082 W @85 °C; 0805 0,125 W (curva distinta según serie) | APROBADO (CC) | PENDIENTE — CRÍTICO | El componente soporta potencia, pero el divisor R14/R15 no protege el ADC en transitorios.

Sheet: Guía
Guía de lectura
Nota | Hoja "Matriz": datos idénticos al CSV original (35 filas × 9 columnas); solo se cambió el formato. Esta hoja es un añadido para orientar la lectura; las descripciones de columnas son interpretación a partir de su contenido.
Columna | Qué contiene
ref | Designador del componente en el esquema (L=inductor, C=capacitor, R=resistencia, RS=resistencia de sensado).
mpn | Fabricante y número de parte.
code | Código de catálogo del proveedor (formato "C…").
tech | Valor, tolerancia, tensión y encapsulado.
stress | Esfuerzo esperado en el circuito (corrientes, tensiones, potencias).
rating | Capacidad nominal del componente frente a ese esfuerzo.
elec | Veredicto eléctrico: APROBADO o PENDIENTE.
integ | Verificación de integración (curvas, layout/land, efectiva con DC bias, etc.) con nivel de criticidad: CRÍTICO / ALTO / MEDIO / BAJO.
why | Justificación y qué falta por verificar.
Colores (col. integ) | Rojo = CRÍTICO · Naranja = ALTO · Amarillo = MEDIO · Verde = BAJO
Colores (col. elec) | Verde = APROBADO · Amarillo = PENDIENTE
Resumen | Conteo (fórmulas sobre la hoja Matriz)
CRÍTICO | 6
ALTO | 5
MEDIO | 11
BAJO | 13
Total filas | 35
elec = APROBADO | 31
elec = PENDIENTE | 4
