almondsun/DynamicSystemsAndControl/project/pcb/redesign/production/jlcpcb-revB-2026-10-27/manual_assembly_revB.csv

Ref | Value | MPN | Manufacturer | Footprint | Assembly | LCSC_or_supplier
D2 | UF4004-E3/54 | UF4004-E3/54 | Vishay | Diode_THT:D_DO-41_SOD81_P10.16mm_Horizontal | MANUAL_THT | C5137033
J1 | 12V IN TB002-500-02BE | TB002-500-02BE | Same Sky | Buck_RevB:TerminalBlock_SameSky_TB002-500-02_1x02_P5.00mm | MANUAL_THT | C2757858
J2 | LOAD TB002-500-02BE | TB002-500-02BE | Same Sky | Buck_RevB:TerminalBlock_SameSky_TB002-500-02_1x02_P5.00mm | MANUAL_THT | C2757858
J3 | NUCLEO IF 61201021621 | 61201021621 | Wurth Elektronik | Buck_RevB:Wurth_WR-BHD_61201021621_2x05_P2.54mm_Vertical | MANUAL_THT | C4355000
L1 | 680uH 60B684C | 60B684C | Murata Power Solutions | Buck_RevB:L_Murata_6000B_27.0x23.5mm | MANUAL_SMD_DNP_AT_JLC | C6095796
Q1 | IRFZ44NPBF | IRFZ44NPBF | Infineon | Buck_RevB:TO-220-3_Vertical_Drill1.4 | MANUAL_THT | C2586
TP1 | VIN |  |  | TestPoint:TestPoint_THTPad_D2.0mm_Drill1.0mm | BARE_TEST_PAD
TP2 | GND |  |  | TestPoint:TestPoint_THTPad_D2.0mm_Drill1.0mm | BARE_TEST_PAD
TP3 | SW |  |  | TestPoint:TestPoint_THTPad_D2.0mm_Drill1.0mm | BARE_TEST_PAD
TP4 | GATE |  |  | TestPoint:TestPoint_THTPad_D2.0mm_Drill1.0mm | BARE_TEST_PAD
TP5 | VOUT |  |  | TestPoint:TestPoint_THTPad_D2.0mm_Drill1.0mm | BARE_TEST_PAD
TP6 | ISENSE |  |  | TestPoint:TestPoint_THTPad_D2.0mm_Drill1.0mm | BARE_TEST_PAD
TP7 | SD |  |  | TestPoint:TestPoint_THTPad_D2.0mm_Drill1.0mm | BARE_TEST_PAD
TP8 | NTRIP |  |  | TestPoint:TestPoint_THTPad_D2.0mm_Drill1.0mm | BARE_TEST_PAD
TP9 | MCU_PWM |  |  | TestPoint:TestPoint_THTPad_D2.0mm_Drill1.0mm | BARE_TEST_PAD
