almondsun/DynamicSystemsAndControl/project/pcb/audit/asset_manifest.csv

mpn | category | source_path | archive_member | archive_sha256 | destination | sha256 | size_bytes | operation | association | identity_evidence | eligible_for_downloaded_inventory | validation | file_format | cad_role_by_format
IRFZ44NS | datasheet | C:\Users\justa\Downloads\C5199867.pdf |  |  | project/pcb/vendor_assets_local/component_library/IRFZ44NS/datasheet/ebcbb210b448e54f27f8ae13686619e83c1ca18d60dfc7d3fe8cbfd7609456b5/C5199867.pdf | ebcbb210b448e54f27f8ae13686619e83c1ca18d60dfc7d3fe8cbfd7609456b5 | 558007 | reutilizada por SHA-256 | BOM candidato | PDF UMW IRFZ44NS/IRFZ44N; 60V, G/D/S; sufijo y plano pendientes | True | pendiente | .pdf | documento PDF
SS34 | datasheet | C:\Users\justa\Downloads\C8678.pdf |  |  | project/pcb/vendor_assets_local/component_library/SS34/datasheet/fb4970875779696914d235bcf954240569302fb325399838f2861d474cbf9760/C8678.pdf | fb4970875779696914d235bcf954240569302fb325399838f2861d474cbf9760 | 1300729 | reutilizada por SHA-256 | BOM candidato | PDF MDD familia SS32–SS3200; tabla SS34 40V/3A | True | pendiente | .pdf | documento PDF
IR2110STRPBF | datasheet | C:\Users\justa\Downloads\C2968.pdf |  |  | project/pcb/vendor_assets_local/component_library/IR2110STRPBF/datasheet/3de3f1ff4244dc9ffb5542cd5ad52bd970f4c0fc1cc45e67aa8962b52166786c/C2968.pdf | 3de3f1ff4244dc9ffb5542cd5ad52bd970f4c0fc1cc45e67aa8962b52166786c | 336436 | reutilizada por SHA-256 | BOM candidato | PDF IR2110(S)/IR2113(S); cubrir SOIC16 y variante exacta | True | pendiente | .pdf | documento PDF
78M05 | datasheet | C:\Users\justa\Downloads\C347278.pdf |  |  | project/pcb/vendor_assets_local/component_library/78M05/datasheet/162df1416fa16eadefc4d9fb2f46121df5c48569a40255a0ddfb9a01e14c166f/C347278.pdf | 162df1416fa16eadefc4d9fb2f46121df5c48569a40255a0ddfb9a01e14c166f | 270766 | reutilizada por SHA-256 | BOM candidato | PDF UMW 78Mxx; contiene 78M05; encapsulado/sufijo comercial pendientes | True | pendiente | .pdf | documento PDF
SN74HCT14DR | datasheet | C:\Users\justa\Downloads\sn74hct14.pdf |  |  | project/pcb/vendor_assets_local/component_library/SN74HCT14DR/datasheet/925eabf18762f43fff8c774e33c0b9d6e22293e95833adebfaab86728eb2cb0e/sn74hct14.pdf | 925eabf18762f43fff8c774e33c0b9d6e22293e95833adebfaab86728eb2cb0e | 1663449 | reutilizada por SHA-256 | BOM candidato | PDF Texas Instruments; familia y opción D | True | pendiente | .pdf | documento PDF
MMBT3904 | datasheet | C:\Users\justa\Downloads\C20526.pdf |  |  | project/pcb/vendor_assets_local/component_library/MMBT3904/datasheet/6c2034cb0bd0d85be51c9c4f82aad838a688aa70c20de1a71681be8ec02b659b/C20526.pdf | 6c2034cb0bd0d85be51c9c4f82aad838a688aa70c20de1a71681be8ec02b659b | 674831 | reutilizada por SHA-256 | BOM candidato | PDF Changjing; comprobar rango/sufijo exacto del código C20526 | True | pendiente | .pdf | documento PDF
IR2110STRPBF | auxiliary | C:\Users\justa\Downloads\IR2110STRPBF.zip |  |  | project/pcb/vendor_assets_local/component_library/IR2110STRPBF/auxiliary/e50329e32e4c2d1ab5a75433b42e5e1c60892591881915e9b301e905f48f48ef/IR2110STRPBF.zip | e50329e32e4c2d1ab5a75433b42e5e1c60892591881915e9b301e905f48f48ef | 549946 | reutilizada por SHA-256 | BOM candidato | Archivo original ZIP conservado; identificación de miembros separada | False | pendiente | .zip | archivo ZIP original
IR2110STRPBF | 3d | C:\Users\justa\Downloads\IR2110STRPBF.zip | IR2110STRPBF.STEP | e50329e32e4c2d1ab5a75433b42e5e1c60892591881915e9b301e905f48f48ef | project/pcb/vendor_assets_local/component_library/IR2110STRPBF/3d/7e327f3c93074ecca454949da7f087027f6122871c91d868631358b25752f9f3/IR2110STRPBF.STEP | 7e327f3c93074ecca454949da7f087027f6122871c91d868631358b25752f9f3 | 549814 | reutilizada por SHA-256 | BOM candidato | Metadatos STEP PRODUCT=['IR2110S']; miembro y procedencia ZIP conservados; cotejar geometría | True | pendiente | .step | modelo STEP
IR2110STRPBF | auxiliary | C:\Users\justa\Downloads\IR2110STRPBF (1).zip |  |  | project/pcb/vendor_assets_local/component_library/IR2110STRPBF/auxiliary/663f6048f1c33474fefaab52236021fa3d0a8968f446199fdb41d33e5c6f9927/IR2110STRPBF (1).zip | 663f6048f1c33474fefaab52236021fa3d0a8968f446199fdb41d33e5c6f9927 | 549946 | reutilizada por SHA-256 | BOM candidato | Archivo original ZIP conservado; identificación de miembros separada | False | pendiente | .zip | archivo ZIP original
IR2110STRPBF | 3d | C:\Users\justa\Downloads\IR2110STRPBF (1).zip | IR2110STRPBF.STEP | 663f6048f1c33474fefaab52236021fa3d0a8968f446199fdb41d33e5c6f9927 | project/pcb/vendor_assets_local/component_library/IR2110STRPBF/3d/7e327f3c93074ecca454949da7f087027f6122871c91d868631358b25752f9f3/IR2110STRPBF.STEP | 7e327f3c93074ecca454949da7f087027f6122871c91d868631358b25752f9f3 | 549814 | reutilizada por SHA-256 | BOM candidato | Metadatos STEP PRODUCT=['IR2110S']; miembro y procedencia ZIP conservados; cotejar geometría | True | pendiente | .step | modelo STEP
SN74HCT14DR | auxiliary | C:\Users\justa\Downloads\SN74HCT14DR.zip |  |  | project/pcb/vendor_assets_local/component_library/SN74HCT14DR/auxiliary/da7eb641de5e939280d2f965c132b26595d266b5e91197230cac1648cdbef484/SN74HCT14DR.zip | da7eb641de5e939280d2f965c132b26595d266b5e91197230cac1648cdbef484 | 37860 | reutilizada por SHA-256 | BOM candidato | Archivo original ZIP conservado; identificación de miembros separada | False | pendiente | .zip | archivo ZIP original
SN74HCT14DR | 3d | C:\Users\justa\Downloads\SN74HCT14DR.zip | D0014A.stp | da7eb641de5e939280d2f965c132b26595d266b5e91197230cac1648cdbef484 | project/pcb/vendor_assets_local/component_library/SN74HCT14DR/3d/bf9112576a5c64b5b450fc4ca996247ce4f2e4a825a44dafc2453e0dfe2be627/D0014A.stp | bf9112576a5c64b5b450fc4ca996247ce4f2e4a825a44dafc2453e0dfe2be627 | 192480 | reutilizada por SHA-256 | BOM candidato | Metadatos STEP PRODUCT=['BODY-SO', 'LEAD-SO', 'PIN1-ID', 'D0014A_ASM']; miembro y procedencia ZIP conservados; cotejar geometría | True | pendiente | .stp | modelo STEP
SN74HCT14DR | symbol | C:\Users\justa\Downloads\SN74HCT14DR.zip | KiCADv6/2026-10-23_16-23-33.kicad_sym | da7eb641de5e939280d2f965c132b26595d266b5e91197230cac1648cdbef484 | project/pcb/vendor_assets_local/component_library/SN74HCT14DR/symbol/d899201bfed6f29ab2a57f574279e259425659f25f477928baff0f92cffca202/2026-10-23_16-23-33.kicad_sym | d899201bfed6f29ab2a57f574279e259425659f25f477928baff0f92cffca202 | 4260 | copiada y verificada SHA-256 | BOM candidato | Biblioteca KiCad: símbolos ['SN74HCT14DR'] | True | pendiente | .kicad_sym | símbolos KiCad
SN74HCT14DR | footprint | C:\Users\justa\Downloads\SN74HCT14DR.zip | KiCADv6/footprints.pretty/D14-L.kicad_mod | da7eb641de5e939280d2f965c132b26595d266b5e91197230cac1648cdbef484 | project/pcb/vendor_assets_local/component_library/SN74HCT14DR/footprint/aa00bba6e51820c722d005b58b6b71cf2d0c03eaaa65558e8ccff5973adce216/D14-L.kicad_mod | aa00bba6e51820c722d005b58b6b71cf2d0c03eaaa65558e8ccff5973adce216 | 8944 | copiada y verificada SHA-256 | BOM candidato | Footprint D14; tags [['tags', 'SN74HCT14DR ']] | True | pendiente | .kicad_mod | footprint KiCad
SN74HCT14DR | footprint | C:\Users\justa\Downloads\SN74HCT14DR.zip | KiCADv6/footprints.pretty/D14-M.kicad_mod | da7eb641de5e939280d2f965c132b26595d266b5e91197230cac1648cdbef484 | project/pcb/vendor_assets_local/component_library/SN74HCT14DR/footprint/29ab4ddb098891a9248f7c421f8b2f3e1d27fdb0a3e4814d2bb4575b81607ef7/D14-M.kicad_mod | 29ab4ddb098891a9248f7c421f8b2f3e1d27fdb0a3e4814d2bb4575b81607ef7 | 8962 | copiada y verificada SHA-256 | BOM candidato | Footprint D14; tags [['tags', 'SN74HCT14DR ']] | True | pendiente | .kicad_mod | footprint KiCad
SN74HCT14DR | footprint | C:\Users\justa\Downloads\SN74HCT14DR.zip | KiCADv6/footprints.pretty/D14.kicad_mod | da7eb641de5e939280d2f965c132b26595d266b5e91197230cac1648cdbef484 | project/pcb/vendor_assets_local/component_library/SN74HCT14DR/footprint/36e8106a581c150117874a1373ff7d6e3adc3acffd55a01ce064db1b6fee9d7b/D14.kicad_mod | 36e8106a581c150117874a1373ff7d6e3adc3acffd55a01ce064db1b6fee9d7b | 8369 | copiada y verificada SHA-256 | BOM candidato | Footprint D14; tags [['tags', 'SN74HCT14DR ']] | True | pendiente | .kicad_mod | footprint KiCad
TB002-500-02BE | auxiliary | C:\Users\justa\Downloads\TB002_500_02BE.zip |  |  | project/pcb/vendor_assets_local/component_library/TB002-500-02BE/auxiliary/513b4ed719fdc5ba893195aff0836a2e77d2d210e7be5caca8fcdea9b9e50902/TB002_500_02BE.zip | 513b4ed719fdc5ba893195aff0836a2e77d2d210e7be5caca8fcdea9b9e50902 | 88821 | copiada y verificada SHA-256 | BOM candidato | Archivo original ZIP conservado; identificación de miembros separada | False | pendiente | .zip | archivo ZIP original
TB002-500-02BE | auxiliary | C:\Users\justa\Downloads\TB002_500_02BE.zip | TB002-500-02BE.IntLib | 513b4ed719fdc5ba893195aff0836a2e77d2d210e7be5caca8fcdea9b9e50902 | project/pcb/vendor_assets_local/component_library/TB002-500-02BE/auxiliary/9d4957b8127e2fc43cf222d60000e4dd07e67ced11b9c3b82016a181790abd82/TB002-500-02BE.IntLib | 9d4957b8127e2fc43cf222d60000e4dd07e67ced11b9c3b82016a181790abd82 | 84992 | copiada y verificada SHA-256 | BOM candidato | Altium OLE; referencias internas ['TB002-500-02BE', 'CUI_TB002-500-02BE', 'GC:\\altium-converter\\conversion_dir\\Temp_23972\\CUI_TB002-500-02BE.PcbLib', 'Check_prices=https://www.snapeda.com/parts/TB002-500-02BE/Same+Sky/view-part/?ref=eda|Comment=*|Component Kind=Standard|Description=2~24 Poles, Screw Type, Horizontal, 5.0 Pitch, 22~12 (AWG), Terminal Block Connector|Footprint=CUI']; sin conversión ni validación nativa KiCad | False | pendiente | .intlib | biblioteca integrada Altium; inspección/conversión pendiente
TB002-500-02BE | auxiliary | C:\Users\justa\Downloads\TB002_500_02BE (1).zip |  |  | project/pcb/vendor_assets_local/component_library/TB002-500-02BE/auxiliary/f39ef20eb77abdfd45860d382242e99771e5a117b5541944c97ace4245bc203f/TB002_500_02BE (1).zip | f39ef20eb77abdfd45860d382242e99771e5a117b5541944c97ace4245bc203f | 341218 | copiada y verificada SHA-256 | BOM candidato | Archivo original ZIP conservado; identificación de miembros separada | False | pendiente | .zip | archivo ZIP original
TB002-500-02BE | 3d | C:\Users\justa\Downloads\TB002_500_02BE (1).zip | TB002-500-02BE.STEP | f39ef20eb77abdfd45860d382242e99771e5a117b5541944c97ace4245bc203f | project/pcb/vendor_assets_local/component_library/TB002-500-02BE/3d/fa62702c8916ee04ce4087cb57de963c527c6e9044eb377342c3b46d104673bc/TB002-500-02BE.STEP | fa62702c8916ee04ce4087cb57de963c527c6e9044eb377342c3b46d104673bc | 341082 | copiada y verificada SHA-256 | BOM candidato | Metadatos STEP PRODUCT=['TB002-500-02P_Blue - S', 'CUI_DEVICES_TB002-500-02BE']; miembro y procedencia ZIP conservados; cotejar geometría | True | pendiente | .step | modelo STEP
50PK4700MEFC18X40 | auxiliary | C:\Users\justa\Downloads\50PK4700MEFC18X40.zip |  |  | project/pcb/vendor_assets_local/component_library/50PK4700MEFC18X40/auxiliary/2c37edeb0dc41aa8eaf2a41b1d389b61f9850f5b50659030d6ca789fe539a646/50PK4700MEFC18X40.zip | 2c37edeb0dc41aa8eaf2a41b1d389b61f9850f5b50659030d6ca789fe539a646 | 36712 | copiada y verificada SHA-256 | identidad MPN provisional; metadatos registrados; SIN correspondencia BOM Buck, revisar | Archivo original ZIP conservado; identificación de miembros separada | False | pendiente | .zip | archivo ZIP original
50PK4700MEFC18X40 | auxiliary | C:\Users\justa\Downloads\50PK4700MEFC18X40.zip | Altium/50PK4700MEFC18X40/50PK4700MEFC18X40.PcbLib | 2c37edeb0dc41aa8eaf2a41b1d389b61f9850f5b50659030d6ca789fe539a646 | project/pcb/vendor_assets_local/component_library/50PK4700MEFC18X40/auxiliary/d38cd2384a71d2a750ce8c57da6351dbf14d8fbf9181bb117d04df343757633c/50PK4700MEFC18X40.PcbLib | d38cd2384a71d2a750ce8c57da6351dbf14d8fbf9181bb117d04df343757633c | 115712 | copiada y verificada SHA-256 | identidad MPN provisional; metadatos registrados; SIN correspondencia BOM Buck, revisar | Altium OLE; referencias internas ['|FILENAME=E:\\NativeModelsWorkingDir\\Working\\27410187\\output\\50PK4700MEFC18X40.PcbLib|KIND=Protel_Advanced_PCB_Library|VERSION=3.00|DATE=7/14/2025|TIME=10:56:50 PM|V9_MASTERSTACK_STYLE=0|V9_MASTERSTACK_ID={7EA89039-F448-447F-8B8A-9', '|PATTERN=CAP_PKPZ_18X40_RUB|HEIGHT=0mil|DESCRIPTION=|ITEMGUID=|REVISIONGUID=']; sin conversión ni validación nativa KiCad | False | pendiente | .pcblib | footprints Altium; conversión pendiente
50PK4700MEFC18X40 | auxiliary | C:\Users\justa\Downloads\50PK4700MEFC18X40.zip | Altium/50PK4700MEFC18X40/50PK4700MEFC18X40.SchLib | 2c37edeb0dc41aa8eaf2a41b1d389b61f9850f5b50659030d6ca789fe539a646 | project/pcb/vendor_assets_local/component_library/50PK4700MEFC18X40/auxiliary/28ba9abc1d18fd6c300d94479737e8684b6f1cb6c2e11970da0722f182d9f7e6/50PK4700MEFC18X40.SchLib | 28ba9abc1d18fd6c300d94479737e8684b6f1cb6c2e11970da0722f182d9f7e6 | 6144 | copiada y verificada SHA-256 | identidad MPN provisional; metadatos registrados; SIN correspondencia BOM Buck, revisar | Altium OLE; referencias internas ['|HEADER=Protel for Windows - Schematic Library Editor Binary File Version 5.0|Weight=20|MinorVersion=9|UniqueID=ISKBAXRA|FontIdCount=3|Size1=10|FontName1=Times New Roman|Size2=5|FontName2=Courier New|Size3=14|FontName3=Courier New', '|RECORD=1|LibReference=50PK4700MEFC18X40|ComponentDescription=Description|PartCount=2|DisplayModeCount=1|IndexInSheet=-1|OwnerPartId=-1|CurrentPartId=1|LibraryPath=*|SourceLibraryName=*|SheetPartFileName=*|TargetFileName=*|UniqueI', '|RECORD=41|IndexInSheet=2|OwnerPartId=1|Justification=4|FontID=2|IsHidden=T|Text=50PK4700MEFC18X40|Name=Manufacturer_Part_Number|UniqueID=XHTXUTVB', '|RECORD=41|IndexInSheet=-1|OwnerPartId=-1|Location.X=-5|Location.Y=-15|Color=8388608|FontID=1|Text=50PK4700MEFC18X40|Name=Comment|UniqueID=WQUKXGZG']; sin conversión ni validación nativa KiCad | False | pendiente | .schlib | símbolos Altium; conversión pendiente
50PK4700MEFC18X40 | 3d | C:\Users\justa\Downloads\50PK4700MEFC18X40.zip | Altium/50PK4700MEFC18X40/CAP_PKPZ_18X40_RUB.step | 2c37edeb0dc41aa8eaf2a41b1d389b61f9850f5b50659030d6ca789fe539a646 | project/pcb/vendor_assets_local/component_library/50PK4700MEFC18X40/3d/550f258cddf4dff6c2bc8b54b2ae4abdde4adec9bb0358c1f9a70e9ae72e069e/CAP_PKPZ_18X40_RUB.step | 550f258cddf4dff6c2bc8b54b2ae4abdde4adec9bb0358c1f9a70e9ae72e069e | 22633 | copiada y verificada SHA-256 | identidad MPN provisional; metadatos registrados; SIN correspondencia BOM Buck, revisar | Metadatos STEP PRODUCT=['product']; miembro y procedencia ZIP conservados; cotejar geometría | False | pendiente | .step | modelo STEP
50YXJ47M6-3X11 | auxiliary | C:\Users\justa\Downloads\50YXJ47M6_3X11.zip |  |  | project/pcb/vendor_assets_local/component_library/50YXJ47M6-3X11/auxiliary/93b9b10089a5ac79e3b89575d7bd65c19ca6e87998e1e44d9cffaeb40725504a/50YXJ47M6_3X11.zip | 93b9b10089a5ac79e3b89575d7bd65c19ca6e87998e1e44d9cffaeb40725504a | 36633 | copiada y verificada SHA-256 | identidad MPN provisional; metadatos registrados; SIN correspondencia BOM Buck, revisar | Archivo original ZIP conservado; identificación de miembros separada | False | pendiente | .zip | archivo ZIP original
50YXJ47M6-3X11 | auxiliary | C:\Users\justa\Downloads\50YXJ47M6_3X11.zip | Altium/50YXJ47M6-3X11/50YXJ47M6P3X11.PcbLib | 93b9b10089a5ac79e3b89575d7bd65c19ca6e87998e1e44d9cffaeb40725504a | project/pcb/vendor_assets_local/component_library/50YXJ47M6-3X11/auxiliary/eb8a790e0bbbb64ac5dbf6fcdb173a96ae7ae2b9b9845ed0cacfb9eb0d4825aa/50YXJ47M6P3X11.PcbLib | eb8a790e0bbbb64ac5dbf6fcdb173a96ae7ae2b9b9845ed0cacfb9eb0d4825aa | 115712 | copiada y verificada SHA-256 | identidad MPN provisional; metadatos registrados; SIN correspondencia BOM Buck, revisar | Altium OLE; referencias internas ['|PATTERN=CAP_YX_6P3X11_RUB|HEIGHT=0mil|DESCRIPTION=|ITEMGUID=|REVISIONGUID=']; sin conversión ni validación nativa KiCad | False | pendiente | .pcblib | footprints Altium; conversión pendiente
50YXJ47M6-3X11 | auxiliary | C:\Users\justa\Downloads\50YXJ47M6_3X11.zip | Altium/50YXJ47M6-3X11/50YXJ47M6P3X11.SchLib | 93b9b10089a5ac79e3b89575d7bd65c19ca6e87998e1e44d9cffaeb40725504a | project/pcb/vendor_assets_local/component_library/50YXJ47M6-3X11/auxiliary/c186d548f48762952312df04e77e88e4c509496248556d2b65f9ddb46a580a61/50YXJ47M6P3X11.SchLib | c186d548f48762952312df04e77e88e4c509496248556d2b65f9ddb46a580a61 | 6144 | copiada y verificada SHA-256 | identidad MPN provisional; metadatos registrados; SIN correspondencia BOM Buck, revisar | Altium OLE; referencias internas ['|RECORD=1|LibReference=50YXJ47M6.3X11|ComponentDescription=Description|PartCount=2|DisplayModeCount=1|IndexInSheet=-1|OwnerPartId=-1|CurrentPartId=1|LibraryPath=*|SourceLibraryName=*|SheetPartFileName=*|TargetFileName=*|UniqueID=V']; sin conversión ni validación nativa KiCad | False | pendiente | .schlib | símbolos Altium; conversión pendiente
50YXJ47M6-3X11 | 3d | C:\Users\justa\Downloads\50YXJ47M6_3X11.zip | Altium/50YXJ47M6-3X11/CAP_YX_6P3X11_RUB.step | 93b9b10089a5ac79e3b89575d7bd65c19ca6e87998e1e44d9cffaeb40725504a | project/pcb/vendor_assets_local/component_library/50YXJ47M6-3X11/3d/02fdd37d53c1686b6d768f4178745558741d1bcefffbae73143248d64d078d9b/CAP_YX_6P3X11_RUB.step | 02fdd37d53c1686b6d768f4178745558741d1bcefffbae73143248d64d078d9b | 22603 | copiada y verificada SHA-256 | identidad MPN provisional; metadatos registrados; SIN correspondencia BOM Buck, revisar | Metadatos STEP PRODUCT=['product']; miembro y procedencia ZIP conservados; cotejar geometría | False | pendiente | .step | modelo STEP
865080343009 | auxiliary | C:\Users\justa\Downloads\865080343009.zip |  |  | project/pcb/vendor_assets_local/component_library/865080343009/auxiliary/726d9dd09fdb56d2da29cd60173522ead776dc92e5727a4cc4e4dd11d4f7f569/865080343009.zip | 726d9dd09fdb56d2da29cd60173522ead776dc92e5727a4cc4e4dd11d4f7f569 | 25325 | copiada y verificada SHA-256 | identidad MPN provisional; metadatos registrados; SIN correspondencia BOM Buck, revisar | Archivo original ZIP conservado; identificación de miembros separada | False | pendiente | .zip | archivo ZIP original
865080343009 | auxiliary | C:\Users\justa\Downloads\865080343009.zip | WCAP-ASLI_6.3X5.5.IntLib | 726d9dd09fdb56d2da29cd60173522ead776dc92e5727a4cc4e4dd11d4f7f569 | project/pcb/vendor_assets_local/component_library/865080343009/auxiliary/e6e8995b002330557c54f9d5389dbe0f0ebd73d62e6f9afd77cc08ded3493a79/WCAP-ASLI_6.3X5.5.IntLib | e6e8995b002330557c54f9d5389dbe0f0ebd73d62e6f9afd77cc08ded3493a79 | 21504 | copiada y verificada SHA-256 | identidad MPN provisional; metadatos registrados; SIN correspondencia BOM Buck, revisar | Altium OLE; referencias internas ["Availability=Unavailable|Comment=*|Component Kind=Standard|Footprint=WCAP-ASLI_6.3X5.5(DXL)|Library Reference=WCAP-ASLI_6.3X5.5|MF={'manufacturer': u'W\\xfcrth Elektronik'}|MP=865080343009|Package=None|Price=None|Value=*|Designator"]; sin conversión ni validación nativa KiCad | False | pendiente | .intlib | biblioteca integrada Altium; inspección/conversión pendiente
865080343009 | auxiliary | C:\Users\justa\Downloads\865080343009 (1).zip |  |  | project/pcb/vendor_assets_local/component_library/865080343009/auxiliary/29489b891de44fd553bad8e18a2defde00063b23229755a5e7344ad5397ef3d0/865080343009 (1).zip | 29489b891de44fd553bad8e18a2defde00063b23229755a5e7344ad5397ef3d0 | 89436 | copiada y verificada SHA-256 | identidad MPN provisional; metadatos registrados; SIN correspondencia BOM Buck, revisar | Archivo original ZIP conservado; identificación de miembros separada | False | pendiente | .zip | archivo ZIP original
865080343009 | 3d | C:\Users\justa\Downloads\865080343009 (1).zip | STP_WCAP-ASLI_6.3x5.5x2+%28rev1%29.stp | 29489b891de44fd553bad8e18a2defde00063b23229755a5e7344ad5397ef3d0 | project/pcb/vendor_assets_local/component_library/865080343009/3d/ee8afdf89cd43acf69067f0790bf4b4c3871669b66938e36a665ddfa04b00daf/STP_WCAP-ASLI_6.3x5.5x2+%28rev1%29.stp | ee8afdf89cd43acf69067f0790bf4b4c3871669b66938e36a665ddfa04b00daf | 595150 | copiada y verificada SHA-256 | identidad MPN provisional; metadatos registrados; SIN correspondencia BOM Buck, revisar | Metadatos STEP PRODUCT=['Assem1', 'capicitor_6.3x5.5x2.2', 'Base_\\X2\\03A6\\X0\\6_3Capacitor']; miembro y procedencia ZIP conservados; cotejar geometría | False | pendiente | .stp | modelo STEP
C0402C473K3RECTU | auxiliary | C:\Users\justa\Downloads\C0402C473K3RECTU.zip |  |  | project/pcb/vendor_assets_local/component_library/C0402C473K3RECTU/auxiliary/53aac7851e59446a9884105412a460adbc5e89701d5d4b34a111ef9b9c3fc5fc/C0402C473K3RECTU.zip | 53aac7851e59446a9884105412a460adbc5e89701d5d4b34a111ef9b9c3fc5fc | 97808 | copiada y verificada SHA-256 | identidad MPN provisional; metadatos registrados; SIN correspondencia BOM Buck, revisar | Archivo original ZIP conservado; identificación de miembros separada | False | pendiente | .zip | archivo ZIP original
C0402C473K3RECTU | 3d | C:\Users\justa\Downloads\C0402C473K3RECTU.zip | CCS_CCSTD_0402_L1.05W0.55T0.55B0.3.step | 53aac7851e59446a9884105412a460adbc5e89701d5d4b34a111ef9b9c3fc5fc | project/pcb/vendor_assets_local/component_library/C0402C473K3RECTU/3d/b5aa94e32e4bf59005a74ef2209b2b097b1ed0d5540f2085fdc3c6d09e8e757c/CCS_CCSTD_0402_L1.05W0.55T0.55B0.3.step | b5aa94e32e4bf59005a74ef2209b2b097b1ed0d5540f2085fdc3c6d09e8e757c | 359862 | copiada y verificada SHA-256 | identidad MPN provisional; metadatos registrados; SIN correspondencia BOM Buck, revisar | Metadatos STEP PRODUCT=['CCS_CCSTD_0402_L1.05W0.55T0.55B0.3']; miembro y procedencia ZIP conservados; cotejar geometría | False | pendiente | .step | modelo STEP
C0402C473K3RECTU | auxiliary | C:\Users\justa\Downloads\C0402C473K3RECTU.zip | Altium/C0402C473K3RECTU.PcbLib | 53aac7851e59446a9884105412a460adbc5e89701d5d4b34a111ef9b9c3fc5fc | project/pcb/vendor_assets_local/component_library/C0402C473K3RECTU/auxiliary/5ca1d5db804bb6de91ea8f9244ee4b4dd826188efb52f6e926aed2b7c02466af/C0402C473K3RECTU.PcbLib | 5ca1d5db804bb6de91ea8f9244ee4b4dd826188efb52f6e926aed2b7c02466af | 143360 | copiada y verificada SHA-256 | identidad MPN provisional; metadatos registrados; SIN correspondencia BOM Buck, revisar | Altium OLE; referencias internas ['|FILENAME=E:\\QueueWorkingDirNative\\9182796\\Output\\Altium\\C0402C473K3RECTU.PcbLib|KIND=Protel_Advanced_PCB_Library|VERSION=3.00|DATE=9/29/2026|TIME=5:16:58 AM|V9_MASTERSTACK_STYLE=0|V9_MASTERSTACK_ID={6324ED50-612E-41E0-886B-E3AF5D', '|PATTERN=CAPC10555_55N_KEM|HEIGHT=0mil|DESCRIPTION=|ITEMGUID=|REVISIONGUID=', '|PATTERN=CAPC10555_55N_KEM-M|HEIGHT=0mil|DESCRIPTION=|ITEMGUID=|REVISIONGUID=', '|PATTERN=CAPC10555_55N_KEM-L|HEIGHT=0mil|DESCRIPTION=|ITEMGUID=|REVISIONGUID=']; sin conversión ni validación nativa KiCad | False | pendiente | .pcblib | footprints Altium; conversión pendiente
C0402C473K3RECTU | auxiliary | C:\Users\justa\Downloads\C0402C473K3RECTU.zip | Altium/C0402C473K3RECTU.SchLib | 53aac7851e59446a9884105412a460adbc5e89701d5d4b34a111ef9b9c3fc5fc | project/pcb/vendor_assets_local/component_library/C0402C473K3RECTU/auxiliary/fc2bf81acaa4d185d0ad6630e1ce285a4f9ebc68612bbd7b571aa99315030502/C0402C473K3RECTU.SchLib | fc2bf81acaa4d185d0ad6630e1ce285a4f9ebc68612bbd7b571aa99315030502 | 6656 | copiada y verificada SHA-256 | identidad MPN provisional; metadatos registrados; SIN correspondencia BOM Buck, revisar | Altium OLE; referencias internas ['|HEADER=Protel for Windows - Schematic Library Editor Binary File Version 5.0|Weight=21|MinorVersion=9|UniqueID=HYCMPUSA|FontIdCount=4|Size1=10|FontName1=Times New Roman|Size2=5|FontName2=Courier New|Size3=5|Underline3=T|FontName3', '|RECORD=1|LibReference=C0402C473K3RECTU|ComponentDescription=ESD SMD Comm X7R, Ceramic, 0.047 uF, 10%, 25 VDC, X7R, SMD, MLCC, Temperature Stable, Electro Static Discharge, Class II, 0402|PartCount=2|DisplayModeCount=1|IndexInShee', '|RECORD=41|IndexInSheet=2|OwnerPartId=1|Justification=4|FontID=2|IsHidden=T|Text=C0402C473K3RECTU|Name=Manufacturer_Part_Number|UniqueID=HHEIOQCA', '|RECORD=41|IndexInSheet=-1|OwnerPartId=-1|Location.X=-5|Location.Y=-15|Color=8388608|FontID=1|Text=C0402C473K3RECTU|Name=Comment|UniqueID=KMOMITOW']; sin conversión ni validación nativa KiCad | False | pendiente | .schlib | símbolos Altium; conversión pendiente
C0402C473K3RECTU | 3d | C:\Users\justa\Downloads\C0402C473K3RECTU.zip | Altium/CAPC10555_55N_KEM.step | 53aac7851e59446a9884105412a460adbc5e89701d5d4b34a111ef9b9c3fc5fc | project/pcb/vendor_assets_local/component_library/C0402C473K3RECTU/3d/2a0ccdbab7375362d519562b8427e201558859054d9cb11a4b803cd090c8ed50/CAPC10555_55N_KEM.step | 2a0ccdbab7375362d519562b8427e201558859054d9cb11a4b803cd090c8ed50 | 24499 | copiada y verificada SHA-256 | identidad MPN provisional; metadatos registrados; SIN correspondencia BOM Buck, revisar | Metadatos STEP PRODUCT=['product']; miembro y procedencia ZIP conservados; cotejar geometría | False | pendiente | .step | modelo STEP
ECQ-E2104KB | auxiliary | C:\Users\justa\Downloads\ECQ_E2104KB.zip |  |  | project/pcb/vendor_assets_local/component_library/ECQ-E2104KB/auxiliary/a1f6ce418ac6c0c8e5652624572210f75d3771f6d6582276b53aa54c4b74f8ee/ECQ_E2104KB.zip | a1f6ce418ac6c0c8e5652624572210f75d3771f6d6582276b53aa54c4b74f8ee | 115951 | copiada y verificada SHA-256 | identidad MPN provisional; metadatos registrados; SIN correspondencia BOM Buck, revisar | Archivo original ZIP conservado; identificación de miembros separada | False | pendiente | .zip | archivo ZIP original
ECQ-E2104KB | 3d | C:\Users\justa\Downloads\ECQ_E2104KB.zip | Altium/EC-2_PAN.step | a1f6ce418ac6c0c8e5652624572210f75d3771f6d6582276b53aa54c4b74f8ee | project/pcb/vendor_assets_local/component_library/ECQ-E2104KB/3d/9a834ee91ae22857431d16f3a9d7ceeb2748cdf195b93fd1a298e10057367ea1/EC-2_PAN.step | 9a834ee91ae22857431d16f3a9d7ceeb2748cdf195b93fd1a298e10057367ea1 | 203872 | copiada y verificada SHA-256 | identidad MPN provisional; metadatos registrados; SIN correspondencia BOM Buck, revisar | Metadatos STEP PRODUCT=['product']; miembro y procedencia ZIP conservados; cotejar geometría | False | pendiente | .step | modelo STEP
ECQ-E2104KB | auxiliary | C:\Users\justa\Downloads\ECQ_E2104KB.zip | Altium/ECQ-E2104KB.PcbLib | a1f6ce418ac6c0c8e5652624572210f75d3771f6d6582276b53aa54c4b74f8ee | project/pcb/vendor_assets_local/component_library/ECQ-E2104KB/auxiliary/1e02dd1bfbb1f242780828e2d2a0934fda44b9d38157dc71f7bc2a3d60ccf814/ECQ-E2104KB.PcbLib | 1e02dd1bfbb1f242780828e2d2a0934fda44b9d38157dc71f7bc2a3d60ccf814 | 154624 | copiada y verificada SHA-256 | identidad MPN provisional; metadatos registrados; SIN correspondencia BOM Buck, revisar | Altium OLE; referencias internas ['|FILENAME=E:\\QueueWorkingDir\\7182115\\Output\\Altium\\ECQ-E2104KB.PcbLib|KIND=Protel_Advanced_PCB_Library|VERSION=3.00|DATE=6/11/2026|TIME=11:37:20 PM|V9_MASTERSTACK_STYLE=0|V9_MASTERSTACK_ID={BF3F5F5D-471A-423D-B6CE-3CAB88F28784}|V9', '|PATTERN=EC-2_PAN|HEIGHT=0mil|DESCRIPTION=|ITEMGUID=|REVISIONGUID=']; sin conversión ni validación nativa KiCad | False | pendiente | .pcblib | footprints Altium; conversión pendiente
ECQ-E2104KB | auxiliary | C:\Users\justa\Downloads\ECQ_E2104KB.zip | Altium/ECQ-E2104KB.SchLib | a1f6ce418ac6c0c8e5652624572210f75d3771f6d6582276b53aa54c4b74f8ee | project/pcb/vendor_assets_local/component_library/ECQ-E2104KB/auxiliary/39f5a17878cb5af39b02d5416ad0df89844f08db39481de7bcca7fae4efb8e7d/ECQ-E2104KB.SchLib | 39f5a17878cb5af39b02d5416ad0df89844f08db39481de7bcca7fae4efb8e7d | 5632 | copiada y verificada SHA-256 | identidad MPN provisional; metadatos registrados; SIN correspondencia BOM Buck, revisar | Altium OLE; referencias internas ['|HEADER=Protel for Windows - Schematic Library Editor Binary File Version 5.0|Weight=19|MinorVersion=9|UniqueID=JBEIDPXM|FontIdCount=3|Size1=10|FontName1=Times New Roman|Size2=5|FontName2=Courier New|Size3=14|FontName3=Courier New', '|RECORD=1|LibReference=ECQ-E2104KB|ComponentDescription=No Description Available|PartCount=2|DisplayModeCount=1|IndexInSheet=-1|OwnerPartId=-1|CurrentPartId=1|LibraryPath=*|SourceLibraryName=*|SheetPartFileName=*|TargetFileName=*|', '|RECORD=41|IndexInSheet=2|OwnerPartId=1|Justification=4|FontID=2|IsHidden=T|Text=ECQ-E2104KB|Name=Manufacturer_Part_Number|UniqueID=NAUZFUIL', '|RECORD=41|IndexInSheet=-1|OwnerPartId=-1|Location.X=-5|Location.Y=-15|Color=8388608|FontID=1|Text=ECQ-E2104KB|Name=Comment|UniqueID=MYJCPFEA']; sin conversión ni validación nativa KiCad | False | pendiente | .schlib | símbolos Altium; conversión pendiente
LPS3015-152MRC | auxiliary | C:\Users\justa\Downloads\LIB_LPS3015-152MRC.zip |  |  | project/pcb/vendor_assets_local/component_library/LPS3015-152MRC/auxiliary/5b9a09b9433ef3ddd0c8c1870e6706dde1e6e835eb319ed542dd3ed612d1383a/LIB_LPS3015-152MRC.zip | 5b9a09b9433ef3ddd0c8c1870e6706dde1e6e835eb319ed542dd3ed612d1383a | 31339 | copiada y verificada SHA-256 | identidad MPN provisional; metadatos registrados; SIN correspondencia BOM Buck, revisar | Archivo original ZIP conservado; identificación de miembros separada | False | pendiente | .zip | archivo ZIP original
LPS3015-152MRC | 3d | C:\Users\justa\Downloads\LIB_LPS3015-152MRC.zip | LPS3015-152MRC/3D/LPS3015-152MRC.stp | 5b9a09b9433ef3ddd0c8c1870e6706dde1e6e835eb319ed542dd3ed612d1383a | project/pcb/vendor_assets_local/component_library/LPS3015-152MRC/3d/1e4448e6d381b2a96e5fd476e6aa01dccd7a44ecd4c235ee6e9111a5e520f050/LPS3015-152MRC.stp | 1e4448e6d381b2a96e5fd476e6aa01dccd7a44ecd4c235ee6e9111a5e520f050 | 225124 | copiada y verificada SHA-256 | identidad MPN provisional; metadatos registrados; SIN correspondencia BOM Buck, revisar | Metadatos STEP PRODUCT=['LPS3015-222MRC']; miembro y procedencia ZIP conservados; cotejar geometría | False | pendiente | .stp | modelo STEP
LPS3015-153MRC | auxiliary | C:\Users\justa\Downloads\LPS3015-153MRC.zip |  |  | project/pcb/vendor_assets_local/component_library/LPS3015-153MRC/auxiliary/22c2a1c565ed5753922818ad19eeed5b1518e396eaa1cbb991681e348209f4f0/LPS3015-153MRC.zip | 22c2a1c565ed5753922818ad19eeed5b1518e396eaa1cbb991681e348209f4f0 | 233153 | copiada y verificada SHA-256 | identidad MPN provisional; metadatos registrados; SIN correspondencia BOM Buck, revisar | Archivo original ZIP conservado; identificación de miembros separada | False | pendiente | .zip | archivo ZIP original
LPS3015-153MRC | symbol | C:\Users\justa\Downloads\LPS3015-153MRC.zip | LPS3015-153MRC.kicad_sym | 22c2a1c565ed5753922818ad19eeed5b1518e396eaa1cbb991681e348209f4f0 | project/pcb/vendor_assets_local/component_library/LPS3015-153MRC/symbol/a968989a8982e367298265b6d5fe29b9742bc06a1bd772616eedfdc03db47783/LPS3015-153MRC.kicad_sym | a968989a8982e367298265b6d5fe29b9742bc06a1bd772616eedfdc03db47783 | 3724 | copiada y verificada SHA-256 | identidad MPN provisional; metadatos registrados; SIN correspondencia BOM Buck, revisar | Biblioteca KiCad: símbolos ['LPS3015-153MRC'] | False | pendiente | .kicad_sym | símbolos KiCad
LPS3015-153MRC | 3d | C:\Users\justa\Downloads\LPS3015-153MRC.zip | LPS3015-153MRC.step | 22c2a1c565ed5753922818ad19eeed5b1518e396eaa1cbb991681e348209f4f0 | project/pcb/vendor_assets_local/component_library/LPS3015-153MRC/3d/1e4448e6d381b2a96e5fd476e6aa01dccd7a44ecd4c235ee6e9111a5e520f050/LPS3015-153MRC.step | 1e4448e6d381b2a96e5fd476e6aa01dccd7a44ecd4c235ee6e9111a5e520f050 | 225124 | copiada y verificada SHA-256 | identidad MPN provisional; metadatos registrados; SIN correspondencia BOM Buck, revisar | Metadatos STEP PRODUCT=['LPS3015-222MRC']; miembro y procedencia ZIP conservados; cotejar geometría | False | pendiente | .step | modelo STEP
LPS3015-153MRC | footprint | C:\Users\justa\Downloads\LPS3015-153MRC.zip | IND_LPS3015-153MRC.kicad_mod | 22c2a1c565ed5753922818ad19eeed5b1518e396eaa1cbb991681e348209f4f0 | project/pcb/vendor_assets_local/component_library/LPS3015-153MRC/footprint/e2a87626a07d2726256b61a1a785f4d27a5e34a5e9f07ca5d1b84e400bb96ff6/IND_LPS3015-153MRC.kicad_mod | e2a87626a07d2726256b61a1a785f4d27a5e34a5e9f07ca5d1b84e400bb96ff6 | 3358 | copiada y verificada SHA-256 | identidad MPN provisional; metadatos registrados; SIN correspondencia BOM Buck, revisar | Footprint IND_LPS3015-153MRC; tags [] | False | pendiente | .kicad_mod | footprint KiCad
MCP73871-2CCI/ML | auxiliary | C:\Users\justa\Downloads\MCP73871-2CCI_ML.zip |  |  | project/pcb/vendor_assets_local/component_library/MCP73871-2CCI%2FML/auxiliary/8adf2122debee1cd8e1654955e38fbb00a9a36536733a8763b86123dcc440c41/MCP73871-2CCI_ML.zip | 8adf2122debee1cd8e1654955e38fbb00a9a36536733a8763b86123dcc440c41 | 13028 | copiada y verificada SHA-256 | identidad MPN provisional; metadatos registrados; SIN correspondencia BOM Buck, revisar | Archivo original ZIP conservado; identificación de miembros separada | False | pendiente | .zip | archivo ZIP original
MCP73871-2CCI/ML | symbol | C:\Users\justa\Downloads\MCP73871-2CCI_ML.zip | MCP73871-2CCI_ML.kicad_sym | 8adf2122debee1cd8e1654955e38fbb00a9a36536733a8763b86123dcc440c41 | project/pcb/vendor_assets_local/component_library/MCP73871-2CCI%2FML/symbol/2deddd1f0854551df85bebe8e4045ee6ada1b927d2b45dd59a99ad2b87f22dd7/MCP73871-2CCI_ML.kicad_sym | 2deddd1f0854551df85bebe8e4045ee6ada1b927d2b45dd59a99ad2b87f22dd7 | 7040 | copiada y verificada SHA-256 | identidad MPN provisional; metadatos registrados; SIN correspondencia BOM Buck, revisar | Biblioteca KiCad: símbolos ['MCP73871-2CCI_ML'] | False | pendiente | .kicad_sym | símbolos KiCad
MCP73871-2CCI/ML | footprint | C:\Users\justa\Downloads\MCP73871-2CCI_ML.zip | QFN50P400X400X100-21N.kicad_mod | 8adf2122debee1cd8e1654955e38fbb00a9a36536733a8763b86123dcc440c41 | project/pcb/vendor_assets_local/component_library/MCP73871-2CCI%2FML/footprint/7440f480b06d07fd31a01bc9ddf79067e47011fe01282fcc5cfeb694b58fa055/QFN50P400X400X100-21N.kicad_mod | 7440f480b06d07fd31a01bc9ddf79067e47011fe01282fcc5cfeb694b58fa055 | 5145 | copiada y verificada SHA-256 | identidad MPN provisional; metadatos registrados; SIN correspondencia BOM Buck, revisar | Footprint QFN50P400X400X100-21N; tags [] | False | pendiente | .kicad_mod | footprint KiCad
RN73H1JTTD8762B25 | auxiliary | C:\Users\justa\Downloads\RN73H1JTTD8762B25 (1).zip |  |  | project/pcb/vendor_assets_local/component_library/RN73H1JTTD8762B25/auxiliary/2b9292d2a8f9be4397edecbf112bba336d8e4a06140b5460c6feb99f0636d79f/RN73H1JTTD8762B25 (1).zip | 2b9292d2a8f9be4397edecbf112bba336d8e4a06140b5460c6feb99f0636d79f | 87724 | copiada y verificada SHA-256 | identidad MPN provisional; metadatos registrados; SIN correspondencia BOM Buck, revisar | Archivo original ZIP conservado; identificación de miembros separada | False | pendiente | .zip | archivo ZIP original
RN73H1JTTD8762B25 | 3d | C:\Users\justa\Downloads\RN73H1JTTD8762B25 (1).zip | RN73H1JTTD8762B25.STEP | 2b9292d2a8f9be4397edecbf112bba336d8e4a06140b5460c6feb99f0636d79f | project/pcb/vendor_assets_local/component_library/RN73H1JTTD8762B25/3d/7d544bf881b374142e5f7bb976fd7435469a1d191fef4bbffdb01402db1d139f/RN73H1JTTD8762B25.STEP | 7d544bf881b374142e5f7bb976fd7435469a1d191fef4bbffdb01402db1d139f | 87582 | copiada y verificada SHA-256 | identidad MPN provisional; metadatos registrados; SIN correspondencia BOM Buck, revisar | Metadatos STEP PRODUCT=['RN731JBlack']; miembro y procedencia ZIP conservados; cotejar geometría | False | pendiente | .step | modelo STEP
NRF52840-QFAA-R7 | auxiliary | C:\Users\justa\Downloads\ul_NRF52840-QFAA-R7.zip |  |  | project/pcb/vendor_assets_local/component_library/NRF52840-QFAA-R7/auxiliary/7fc1cb989b85e1cb6ad1165fe2f8c20e022b96bbab37943e4f7e7b525dfa17ed/ul_NRF52840-QFAA-R7.zip | 7fc1cb989b85e1cb6ad1165fe2f8c20e022b96bbab37943e4f7e7b525dfa17ed | 13741 | copiada y verificada SHA-256 | identidad MPN provisional; metadatos registrados; SIN correspondencia BOM Buck, revisar | Archivo original ZIP conservado; identificación de miembros separada | False | pendiente | .zip | archivo ZIP original
NRF52840-QFAA-R7 | symbol | C:\Users\justa\Downloads\ul_NRF52840-QFAA-R7.zip | KiCADv6/2026-07-20_03-01-55.kicad_sym | 7fc1cb989b85e1cb6ad1165fe2f8c20e022b96bbab37943e4f7e7b525dfa17ed | project/pcb/vendor_assets_local/component_library/NRF52840-QFAA-R7/symbol/2ad4e9c43b2df7201f0f6057e76e9986876356ba2a5772924484a0876a2234a0/2026-07-20_03-01-55.kicad_sym | 2ad4e9c43b2df7201f0f6057e76e9986876356ba2a5772924484a0876a2234a0 | 10892 | copiada y verificada SHA-256 | identidad MPN provisional; metadatos registrados; SIN correspondencia BOM Buck, revisar | Biblioteca KiCad: símbolos ['NRF52840-QFAA-R7'] | False | pendiente | .kicad_sym | símbolos KiCad
NRF52840-QFAA-R7 | footprint | C:\Users\justa\Downloads\ul_NRF52840-QFAA-R7.zip | KiCADv6/footprints.pretty/QFN48_NRF52840-QFAA-R7_NOR-L.kicad_mod | 7fc1cb989b85e1cb6ad1165fe2f8c20e022b96bbab37943e4f7e7b525dfa17ed | project/pcb/vendor_assets_local/component_library/NRF52840-QFAA-R7/footprint/2bcfbb0c73fa3c67efa487ebcd68b6ab3c308b560ffaacdfee91a01c6bbffde9/QFN48_NRF52840-QFAA-R7_NOR-L.kicad_mod | 2bcfbb0c73fa3c67efa487ebcd68b6ab3c308b560ffaacdfee91a01c6bbffde9 | 27747 | copiada y verificada SHA-256 | identidad MPN provisional; metadatos registrados; SIN correspondencia BOM Buck, revisar | Footprint QFN48_NRF52840-QFAA-R7_NOR; tags [['tags', 'NRF52840-QFAA-R7 ']] | False | pendiente | .kicad_mod | footprint KiCad
NRF52840-QFAA-R7 | footprint | C:\Users\justa\Downloads\ul_NRF52840-QFAA-R7.zip | KiCADv6/footprints.pretty/QFN48_NRF52840-QFAA-R7_NOR-M.kicad_mod | 7fc1cb989b85e1cb6ad1165fe2f8c20e022b96bbab37943e4f7e7b525dfa17ed | project/pcb/vendor_assets_local/component_library/NRF52840-QFAA-R7/footprint/c7ab0dbf822f61df230566c61e87ae23eca778c34d2a976b75d06b364e1c12a6/QFN48_NRF52840-QFAA-R7_NOR-M.kicad_mod | c7ab0dbf822f61df230566c61e87ae23eca778c34d2a976b75d06b364e1c12a6 | 27715 | copiada y verificada SHA-256 | identidad MPN provisional; metadatos registrados; SIN correspondencia BOM Buck, revisar | Footprint QFN48_NRF52840-QFAA-R7_NOR; tags [['tags', 'NRF52840-QFAA-R7 ']] | False | pendiente | .kicad_mod | footprint KiCad
NRF52840-QFAA-R7 | footprint | C:\Users\justa\Downloads\ul_NRF52840-QFAA-R7.zip | KiCADv6/footprints.pretty/QFN48_NRF52840-QFAA-R7_NOR.kicad_mod | 7fc1cb989b85e1cb6ad1165fe2f8c20e022b96bbab37943e4f7e7b525dfa17ed | project/pcb/vendor_assets_local/component_library/NRF52840-QFAA-R7/footprint/055bf5c12e296ee8c2ac0df0f1895712be077f5cc850ef22786b3336f246f0ae/QFN48_NRF52840-QFAA-R7_NOR.kicad_mod | 055bf5c12e296ee8c2ac0df0f1895712be077f5cc850ef22786b3336f246f0ae | 27715 | copiada y verificada SHA-256 | identidad MPN provisional; metadatos registrados; SIN correspondencia BOM Buck, revisar | Footprint QFN48_NRF52840-QFAA-R7_NOR; tags [['tags', 'NRF52840-QFAA-R7 ']] | False | pendiente | .kicad_mod | footprint KiCad
 | auxiliary | C:\Users\justa\Downloads\KBL406G.IntLib |  |  | project/pcb/vendor_assets_local/pendiente_revision/275a4fa7f258104179c5bbdc287d77bf11e797a63af9cd2e619bcab084384e0f/KBL406G.IntLib | 275a4fa7f258104179c5bbdc287d77bf11e797a63af9cd2e619bcab084384e0f | 32256 | copiada y verificada SHA-256 | Sin asociación confirmada a BOM; revisión | Altium OLE; MPN internos=[]; sin conversión | False | pendiente | .intlib | biblioteca integrada Altium; inspección/conversión pendiente
 | 3d | C:\Users\justa\Downloads\LPS3015-152MRC.stp |  |  | project/pcb/vendor_assets_local/pendiente_revision/1e4448e6d381b2a96e5fd476e6aa01dccd7a44ecd4c235ee6e9111a5e520f050/LPS3015-152MRC.stp | 1e4448e6d381b2a96e5fd476e6aa01dccd7a44ecd4c235ee6e9111a5e520f050 | 225124 | copiada y verificada SHA-256 | Sin asociación confirmada a BOM; revisión | STEP PRODUCT=['LPS3015-222MRC']; no asociado automáticamente al Buck | False | pendiente | .stp | modelo STEP
 | 3d | C:\Users\justa\Downloads\LPS3015.STEP |  |  | project/pcb/vendor_assets_local/pendiente_revision/63924dd75e4e6b6dde6b5f8b42b4b1d3e8c8aca816f466f4183768221205b64a/LPS3015.STEP | 63924dd75e4e6b6dde6b5f8b42b4b1d3e8c8aca816f466f4183768221205b64a | 557186 | copiada y verificada SHA-256 | Sin asociación confirmada a BOM; revisión | STEP PRODUCT=['LPS3015']; no asociado automáticamente al Buck | False | pendiente | .step | modelo STEP
 | auxiliary | C:\Users\justa\Downloads\Miscellaneous Connectors.IntLib |  |  | project/pcb/vendor_assets_local/pendiente_revision/3c1ba2a994d26a92a9dd8d8ed9851deac0b1fe0d7be27d71fec60b9fd2f8ee19/Miscellaneous Connectors.IntLib | 3c1ba2a994d26a92a9dd8d8ed9851deac0b1fe0d7be27d71fec60b9fd2f8ee19 | 140288 | copiada y verificada SHA-256 | Sin asociación confirmada a BOM; revisión | Altium OLE; MPN internos=[]; sin conversión | False | pendiente | .intlib | biblioteca integrada Altium; inspección/conversión pendiente
 | auxiliary | C:\Users\justa\Downloads\shared_lib.IntLib |  |  | project/pcb/vendor_assets_local/pendiente_revision/91594ede8aadf6449fff5b44b7443deafeb73cfaf0bc1eb1ff434d8ac1fb6159/shared_lib.IntLib | 91594ede8aadf6449fff5b44b7443deafeb73cfaf0bc1eb1ff434d8ac1fb6159 | 1772032 | copiada y verificada SHA-256 | Sin asociación confirmada a BOM; revisión | Altium OLE; MPN internos=[]; sin conversión | False | pendiente | .intlib | biblioteca integrada Altium; inspección/conversión pendiente
 | auxiliary | C:\Users\justa\Downloads\50PK4700MEFC18X40\Altium\50PK4700MEFC18X40\50PK4700MEFC18X40.PcbLib |  |  | project/pcb/vendor_assets_local/pendiente_revision/d38cd2384a71d2a750ce8c57da6351dbf14d8fbf9181bb117d04df343757633c/50PK4700MEFC18X40.PcbLib | d38cd2384a71d2a750ce8c57da6351dbf14d8fbf9181bb117d04df343757633c | 115712 | copiada y verificada SHA-256 | Sin asociación confirmada a BOM; revisión | Altium OLE; MPN internos=[]; sin conversión | False | pendiente | .pcblib | footprints Altium; conversión pendiente
 | auxiliary | C:\Users\justa\Downloads\50PK4700MEFC18X40\Altium\50PK4700MEFC18X40\50PK4700MEFC18X40.SchLib |  |  | project/pcb/vendor_assets_local/pendiente_revision/28ba9abc1d18fd6c300d94479737e8684b6f1cb6c2e11970da0722f182d9f7e6/50PK4700MEFC18X40.SchLib | 28ba9abc1d18fd6c300d94479737e8684b6f1cb6c2e11970da0722f182d9f7e6 | 6144 | copiada y verificada SHA-256 | Sin asociación confirmada a BOM; revisión | Altium OLE; MPN internos=[]; sin conversión | False | pendiente | .schlib | símbolos Altium; conversión pendiente
 | 3d | C:\Users\justa\Downloads\50PK4700MEFC18X40\Altium\50PK4700MEFC18X40\CAP_PKPZ_18X40_RUB.step |  |  | project/pcb/vendor_assets_local/pendiente_revision/550f258cddf4dff6c2bc8b54b2ae4abdde4adec9bb0358c1f9a70e9ae72e069e/CAP_PKPZ_18X40_RUB.step | 550f258cddf4dff6c2bc8b54b2ae4abdde4adec9bb0358c1f9a70e9ae72e069e | 22633 | copiada y verificada SHA-256 | Sin asociación confirmada a BOM; revisión | STEP PRODUCT=['product']; no asociado automáticamente al Buck | False | pendiente | .step | modelo STEP
 | auxiliary | C:\Users\justa\Downloads\50YXJ47M6_3X11\Altium\50YXJ47M6-3X11\50YXJ47M6P3X11.PcbLib |  |  | project/pcb/vendor_assets_local/pendiente_revision/eb8a790e0bbbb64ac5dbf6fcdb173a96ae7ae2b9b9845ed0cacfb9eb0d4825aa/50YXJ47M6P3X11.PcbLib | eb8a790e0bbbb64ac5dbf6fcdb173a96ae7ae2b9b9845ed0cacfb9eb0d4825aa | 115712 | copiada y verificada SHA-256 | Sin asociación confirmada a BOM; revisión | Altium OLE; MPN internos=[]; sin conversión | False | pendiente | .pcblib | footprints Altium; conversión pendiente
 | auxiliary | C:\Users\justa\Downloads\50YXJ47M6_3X11\Altium\50YXJ47M6-3X11\50YXJ47M6P3X11.SchLib |  |  | project/pcb/vendor_assets_local/pendiente_revision/c186d548f48762952312df04e77e88e4c509496248556d2b65f9ddb46a580a61/50YXJ47M6P3X11.SchLib | c186d548f48762952312df04e77e88e4c509496248556d2b65f9ddb46a580a61 | 6144 | copiada y verificada SHA-256 | Sin asociación confirmada a BOM; revisión | Altium OLE; MPN internos=[]; sin conversión | False | pendiente | .schlib | símbolos Altium; conversión pendiente
 | 3d | C:\Users\justa\Downloads\50YXJ47M6_3X11\Altium\50YXJ47M6-3X11\CAP_YX_6P3X11_RUB.step |  |  | project/pcb/vendor_assets_local/pendiente_revision/02fdd37d53c1686b6d768f4178745558741d1bcefffbae73143248d64d078d9b/CAP_YX_6P3X11_RUB.step | 02fdd37d53c1686b6d768f4178745558741d1bcefffbae73143248d64d078d9b | 22603 | copiada y verificada SHA-256 | Sin asociación confirmada a BOM; revisión | STEP PRODUCT=['product']; no asociado automáticamente al Buck | False | pendiente | .step | modelo STEP
 | 3d | C:\Users\justa\Downloads\C5750X7R1V476M230KC (1)\C5750X7R1V476M230KC.step |  |  | project/pcb/vendor_assets_local/pendiente_revision/05dbb59f488662db2ab66ed02ebfc7d4292c3ee651be7722db1ff0d95e98ab52/C5750X7R1V476M230KC.step | 05dbb59f488662db2ab66ed02ebfc7d4292c3ee651be7722db1ff0d95e98ab52 | 104720 | copiada y verificada SHA-256 | Sin asociación confirmada a BOM; revisión | STEP PRODUCT=['5.752.30.2']; no asociado automáticamente al Buck | False | pendiente | .step | modelo STEP
 | 3d | C:\Users\justa\Downloads\ECQ_E2104KB\Altium\EC-2_PAN.step |  |  | project/pcb/vendor_assets_local/pendiente_revision/9a834ee91ae22857431d16f3a9d7ceeb2748cdf195b93fd1a298e10057367ea1/EC-2_PAN.step | 9a834ee91ae22857431d16f3a9d7ceeb2748cdf195b93fd1a298e10057367ea1 | 203872 | copiada y verificada SHA-256 | Sin asociación confirmada a BOM; revisión | STEP PRODUCT=['product']; no asociado automáticamente al Buck | False | pendiente | .step | modelo STEP
 | auxiliary | C:\Users\justa\Downloads\ECQ_E2104KB\Altium\ECQ-E2104KB.PcbLib |  |  | project/pcb/vendor_assets_local/pendiente_revision/1e02dd1bfbb1f242780828e2d2a0934fda44b9d38157dc71f7bc2a3d60ccf814/ECQ-E2104KB.PcbLib | 1e02dd1bfbb1f242780828e2d2a0934fda44b9d38157dc71f7bc2a3d60ccf814 | 154624 | copiada y verificada SHA-256 | Sin asociación confirmada a BOM; revisión | Altium OLE; MPN internos=[]; sin conversión | False | pendiente | .pcblib | footprints Altium; conversión pendiente
 | auxiliary | C:\Users\justa\Downloads\ECQ_E2104KB\Altium\ECQ-E2104KB.SchLib |  |  | project/pcb/vendor_assets_local/pendiente_revision/39f5a17878cb5af39b02d5416ad0df89844f08db39481de7bcca7fae4efb8e7d/ECQ-E2104KB.SchLib | 39f5a17878cb5af39b02d5416ad0df89844f08db39481de7bcca7fae4efb8e7d | 5632 | copiada y verificada SHA-256 | Sin asociación confirmada a BOM; revisión | Altium OLE; MPN internos=[]; sin conversión | False | pendiente | .schlib | símbolos Altium; conversión pendiente
 | auxiliary | C:\Users\justa\Downloads\KBL406G\KBL406G.SchLib |  |  | project/pcb/vendor_assets_local/pendiente_revision/c7773ac45e87a7d957122a8c804020a226eac2ec0335d7bc87b9efb885161ba7/KBL406G.SchLib | c7773ac45e87a7d957122a8c804020a226eac2ec0335d7bc87b9efb885161ba7 | 11776 | copiada y verificada SHA-256 | Sin asociación confirmada a BOM; revisión | Altium OLE; MPN internos=[]; sin conversión | False | pendiente | .schlib | símbolos Altium; conversión pendiente
 | auxiliary | C:\Users\justa\Downloads\KBL406G\SIP600W130P510L1900H1630Q4.PcbLib |  |  | project/pcb/vendor_assets_local/pendiente_revision/8418e3ad63700681ea2a1486c96345742056a860945ab38b86dd0fccfa3a3df5/SIP600W130P510L1900H1630Q4.PcbLib | 8418e3ad63700681ea2a1486c96345742056a860945ab38b86dd0fccfa3a3df5 | 115200 | copiada y verificada SHA-256 | Sin asociación confirmada a BOM; revisión | Altium OLE; MPN internos=[]; sin conversión | False | pendiente | .pcblib | footprints Altium; conversión pendiente
LPS3015-153MRC | footprint | C:\Users\justa\Downloads\LPS3015-153MRC\IND_LPS3015-153MRC.kicad_mod |  |  | project/pcb/vendor_assets_local/component_library/LPS3015-153MRC/footprint/e2a87626a07d2726256b61a1a785f4d27a5e34a5e9f07ca5d1b84e400bb96ff6/IND_LPS3015-153MRC.kicad_mod | e2a87626a07d2726256b61a1a785f4d27a5e34a5e9f07ca5d1b84e400bb96ff6 | 3358 | reutilizada por SHA-256 | Sin asociación confirmada a BOM; revisión | Identificador interno LPS3015-153MRC; no es XR6826TS331MHL65 | False | pendiente | .kicad_mod | footprint KiCad
LPS3015-153MRC | symbol | C:\Users\justa\Downloads\LPS3015-153MRC\LPS3015-153MRC.kicad_sym |  |  | project/pcb/vendor_assets_local/component_library/LPS3015-153MRC/symbol/a968989a8982e367298265b6d5fe29b9742bc06a1bd772616eedfdc03db47783/LPS3015-153MRC.kicad_sym | a968989a8982e367298265b6d5fe29b9742bc06a1bd772616eedfdc03db47783 | 3724 | reutilizada por SHA-256 | Sin asociación confirmada a BOM; revisión | Identificador interno LPS3015-153MRC; no es XR6826TS331MHL65 | False | pendiente | .kicad_sym | símbolos KiCad
 | 3d | C:\Users\justa\Downloads\LPS3015-153MRC\LPS3015-153MRC.step |  |  | project/pcb/vendor_assets_local/pendiente_revision/1e4448e6d381b2a96e5fd476e6aa01dccd7a44ecd4c235ee6e9111a5e520f050/LPS3015-153MRC.step | 1e4448e6d381b2a96e5fd476e6aa01dccd7a44ecd4c235ee6e9111a5e520f050 | 225124 | copiada y verificada SHA-256 | Sin asociación confirmada a BOM; revisión | STEP PRODUCT=['LPS3015-222MRC']; no asociado automáticamente al Buck | False | pendiente | .step | modelo STEP
 | auxiliary | C:\Users\justa\Downloads\Miscellaneous Connectors\Miscellaneous Connectors.PcbLib |  |  | project/pcb/vendor_assets_local/pendiente_revision/ba8ca519bcff8694db7ed4c112c89ba0fe41a5a92836ba9edc0d0496831328af/Miscellaneous Connectors.PcbLib | ba8ca519bcff8694db7ed4c112c89ba0fe41a5a92836ba9edc0d0496831328af | 2169856 | copiada y verificada SHA-256 | Sin asociación confirmada a BOM; revisión | Altium OLE; MPN internos=[]; sin conversión | False | pendiente | .pcblib | footprints Altium; conversión pendiente
 | auxiliary | C:\Users\justa\Downloads\Miscellaneous Connectors\Miscellaneous Connectors.SchLib |  |  | project/pcb/vendor_assets_local/pendiente_revision/96ad24cf8da42e976fb8e797a7136c4ce8d7eb5f3ba244ace94af573aac1645a/Miscellaneous Connectors.SchLib | 96ad24cf8da42e976fb8e797a7136c4ce8d7eb5f3ba244ace94af573aac1645a | 990720 | copiada y verificada SHA-256 | Sin asociación confirmada a BOM; revisión | Altium OLE; MPN internos=[]; sin conversión | False | pendiente | .schlib | símbolos Altium; conversión pendiente
 | auxiliary | C:\Users\justa\Downloads\Miscellaneous Connectors\Project Outputs for Miscellaneous Connectors\Miscellaneous Connectors.IntLib |  |  | project/pcb/vendor_assets_local/pendiente_revision/099c2bd29df1714c0132d3b227703c505c0dd75fb68cd626ac6af1a5ff89615d/Miscellaneous Connectors.IntLib | 099c2bd29df1714c0132d3b227703c505c0dd75fb68cd626ac6af1a5ff89615d | 432640 | copiada y verificada SHA-256 | Sin asociación confirmada a BOM; revisión | Altium OLE; MPN internos=[]; sin conversión | False | pendiente | .intlib | biblioteca integrada Altium; inspección/conversión pendiente
 | 3d | C:\Users\justa\Downloads\RN73H1JTTD8762B25 (1)\RN73H1JTTD8762B25.STEP |  |  | project/pcb/vendor_assets_local/pendiente_revision/7d544bf881b374142e5f7bb976fd7435469a1d191fef4bbffdb01402db1d139f/RN73H1JTTD8762B25.STEP | 7d544bf881b374142e5f7bb976fd7435469a1d191fef4bbffdb01402db1d139f | 87582 | copiada y verificada SHA-256 | Sin asociación confirmada a BOM; revisión | STEP PRODUCT=['RN731JBlack']; no asociado automáticamente al Buck | False | pendiente | .step | modelo STEP
 | 3d | C:\Users\justa\Downloads\RT0402DRE0739K7L\RESC1005X35N.step |  |  | project/pcb/vendor_assets_local/pendiente_revision/779b96c02aef8d5f53d7118609f123d8c41c8388e42c553aa685d25baae33e5e/RESC1005X35N.step | 779b96c02aef8d5f53d7118609f123d8c41c8388e42c553aa685d25baae33e5e | 87299 | copiada y verificada SHA-256 | Sin asociación confirmada a BOM; revisión | STEP PRODUCT=['RT0402BRD0727R4L']; no asociado automáticamente al Buck | False | pendiente | .step | modelo STEP
 | auxiliary | C:\Users\justa\Downloads\shared_lib\shared_lib.PcbLib |  |  | project/pcb/vendor_assets_local/pendiente_revision/2d1b10918b7deed86376eb052f961fc6a72b6fa43ef0105fecb371ff6ef692d9/shared_lib.PcbLib | 2d1b10918b7deed86376eb052f961fc6a72b6fa43ef0105fecb371ff6ef692d9 | 2057216 | copiada y verificada SHA-256 | Sin asociación confirmada a BOM; revisión | Altium OLE; MPN internos=[]; sin conversión | False | pendiente | .pcblib | footprints Altium; conversión pendiente
 | auxiliary | C:\Users\justa\Downloads\shared_lib\shared_lib.SchLib |  |  | project/pcb/vendor_assets_local/pendiente_revision/84dbceee0491c7971d2baad97a299f01a93a41e075adcf2d13b83fe7f1f246f4/shared_lib.SchLib | 84dbceee0491c7971d2baad97a299f01a93a41e075adcf2d13b83fe7f1f246f4 | 320512 | copiada y verificada SHA-256 | Sin asociación confirmada a BOM; revisión | Altium OLE; MPN internos=['CY54-47UH', 'CY54-10UH', 'CY54-22UH', 'CP2102N-A02-GQFN20R', 'CY54-2.2UH', 'ZD25WQ16BTIGR', 'CYA0630-10UH', 'PSBD1DF40V1H', 'HC-DC-005-2.0T', 'SMF5.0CA', 'ESP32-C3-WROOM-02-N4', 'MT3608B', 'SMF12CA', 'TPS564201DDCR', 'USBLC6-2SC6', 'TSC015A05026A', 'DN2302S', 'SS34-TD', 'TPS56528DDAR', '35V100uF CD110', 'LESD5Z3.3T1G', 'CR0603FA84R5G', 'RC0603FR-0773K2L', 'RC0603FR-0754K9L', 'RC0603FR-0749K9L', 'RC0603FR-07390KL', 'RC0603FR-07365KL', 'RC0603FR-0733K2L', 'FRC0603J331 TS', 'RC0603FR-07226KL', 'FRC0603F1910TS', 'AC0603FR-07191KL', 'RTT031500FTP', 'FRC0603F1200TS', 'FRC0603J101 TS', 'AP2301', 'SCR0603F4K7', 'FRC0603J332 TS', 'FRC0603J103TS', 'TP4056', 'S2B-PH-K-S(LF)(SN)', 'HGC0603R7474K500NTHJ', 'CL21A106KAYNNNE', '0603F104Z500CT', 'FRC0603J102 TS', 'FRC0603P000 TS', 'TYPE-C-3.1-16PIN', 'CC0603JRNPO9BN330', 'CL21A226MQQNNNE', 'HGC0805R5226M160NSLJ', 'CGA0603X5R226M100JT', 'TCC0603X5R106K100CT', 'RS-3535MWAM', 'AMS1117-3.3', 'CL10A105KB8NNNC', 'CC0603KRX7R9BB102', 'XL-2012UGC', 'KH-MINI-SMT-5P-Cu', 'MX126-5.0-03P-GN01-Cu-S-A', 'JL126-50002G01', 'HCB1608KF-600T20', 'SRD-05VDC-SL-C', 'XL-2012SURC']; sin conversión; contiene CL21A106KAYNNNE candidato C11; SS34-TD no es SS34 de MDD | False | pendiente | .schlib | símbolos Altium; conversión pendiente
