almondsun/DynamicSystemsAndControl/project/pcb/audit/existing_project_assets.csv

designator | role | path | sha256 | status
J1 | símbolo proyecto original | project/pcb/Buck.kicad_sym | 017b58e522210d3f07bf3238b01de6cd5e967a6c791ee3ae5a72b29a4a80a425 | existente; no prueba aprobación del candidato
J1 | footprint BOM original | C:\Program Files\KiCad\10.0\share\kicad\footprints\TerminalBlock_Phoenix.pretty\TerminalBlock_Phoenix_MKDS-1,5-2_1x02_P5.00mm_Horizontal.kicad_mod | 5e763795a39861f76e524153036d7a3c939a595328d8b32cadc5aa17766ea3b8 | existente; no prueba aprobación del candidato
Q1 | símbolo proyecto original | project/pcb/Buck.kicad_sym | 017b58e522210d3f07bf3238b01de6cd5e967a6c791ee3ae5a72b29a4a80a425 | existente; no prueba aprobación del candidato
Q1 | footprint BOM original | C:\Program Files\KiCad\10.0\share\kicad\footprints\Package_TO_SOT_THT.pretty\TO-220-3_Vertical.kicad_mod | e116fbdc5f090042cbd25c86eaef6544bb417581019e1d2da0b5dc6e40b7b4bf | existente; no prueba aprobación del candidato
Q1 | footprint genérico candidato | C:\Program Files\KiCad\10.0\share\kicad\footprints\Package_TO_SOT_SMD.pretty\TO-263-2.kicad_mod | 7527d39d6814c9c546a47a88fc01cacb06ea6e256e9a69376760c6efd2d3e591 | existente; no prueba aprobación del candidato
D1 | símbolo proyecto original | project/pcb/Buck.kicad_sym | 017b58e522210d3f07bf3238b01de6cd5e967a6c791ee3ae5a72b29a4a80a425 | existente; no prueba aprobación del candidato
D1 | footprint BOM original | C:\Program Files\KiCad\10.0\share\kicad\footprints\Diode_THT.pretty\D_DO-201AD_P15.24mm_Horizontal.kicad_mod | bdb233d4a0aa686960651824b80dc5ec725843b6749938797734293976825d3b | existente; no prueba aprobación del candidato
D1 | footprint genérico candidato | C:\Program Files\KiCad\10.0\share\kicad\footprints\Diode_SMD.pretty\D_SMA.kicad_mod | e2d049a54ef961e231eb8e7e769078a3c44feb8475a7bdafba01c6646a5144f3 | existente; no prueba aprobación del candidato
L1 | símbolo proyecto original | project/pcb/Buck.kicad_sym | 017b58e522210d3f07bf3238b01de6cd5e967a6c791ee3ae5a72b29a4a80a425 | existente; no prueba aprobación del candidato
L1 | footprint BOM original | project/pcb/Buck.pretty/Inductor_25mm_P10mm_VERIFY.kicad_mod | 1d25258346039611375b1393f0a354b28e47e5758cd61b3673a34e640684d3ea | existente; no prueba aprobación del candidato
L2 | símbolo proyecto original | project/pcb/Buck.kicad_sym | 017b58e522210d3f07bf3238b01de6cd5e967a6c791ee3ae5a72b29a4a80a425 | existente; no prueba aprobación del candidato
L2 | footprint BOM original | project/pcb/Buck.pretty/Inductor_25mm_P10mm_VERIFY.kicad_mod | 1d25258346039611375b1393f0a354b28e47e5758cd61b3673a34e640684d3ea | existente; no prueba aprobación del candidato
RS1 | símbolo proyecto original | project/pcb/Buck.kicad_sym | 017b58e522210d3f07bf3238b01de6cd5e967a6c791ee3ae5a72b29a4a80a425 | existente; no prueba aprobación del candidato
RS1 | footprint BOM original | C:\Program Files\KiCad\10.0\share\kicad\footprints\Resistor_SMD.pretty\R_2512_6332Metric.kicad_mod | a3a0a11d7a570eb6e8f456699f29a465e3a45980b89223ea253a94e5779102d9 | existente; no prueba aprobación del candidato
RS1 | footprint genérico candidato | C:\Program Files\KiCad\10.0\share\kicad\footprints\Resistor_SMD.pretty\R_2512_6332Metric.kicad_mod | a3a0a11d7a570eb6e8f456699f29a465e3a45980b89223ea253a94e5779102d9 | existente; no prueba aprobación del candidato
J2 | símbolo proyecto original | project/pcb/Buck.kicad_sym | 017b58e522210d3f07bf3238b01de6cd5e967a6c791ee3ae5a72b29a4a80a425 | existente; no prueba aprobación del candidato
J2 | footprint BOM original | C:\Program Files\KiCad\10.0\share\kicad\footprints\TerminalBlock_Phoenix.pretty\TerminalBlock_Phoenix_MKDS-1,5-2_1x02_P5.00mm_Horizontal.kicad_mod | 5e763795a39861f76e524153036d7a3c939a595328d8b32cadc5aa17766ea3b8 | existente; no prueba aprobación del candidato
C1 | símbolo proyecto original | project/pcb/Buck.kicad_sym | 017b58e522210d3f07bf3238b01de6cd5e967a6c791ee3ae5a72b29a4a80a425 | existente; no prueba aprobación del candidato
C1 | footprint BOM original | C:\Program Files\KiCad\10.0\share\kicad\footprints\Capacitor_THT.pretty\CP_Radial_D8.0mm_P3.50mm.kicad_mod | ef43db75696baeadd4726ac5353c4ed478757cf83fd59e2d0c65858f97c2ec06 | existente; no prueba aprobación del candidato
C2 | símbolo proyecto original | project/pcb/Buck.kicad_sym | 017b58e522210d3f07bf3238b01de6cd5e967a6c791ee3ae5a72b29a4a80a425 | existente; no prueba aprobación del candidato
C2 | footprint BOM original | C:\Program Files\KiCad\10.0\share\kicad\footprints\Capacitor_THT.pretty\CP_Radial_D8.0mm_P3.50mm.kicad_mod | ef43db75696baeadd4726ac5353c4ed478757cf83fd59e2d0c65858f97c2ec06 | existente; no prueba aprobación del candidato
C3 | símbolo proyecto original | project/pcb/Buck.kicad_sym | 017b58e522210d3f07bf3238b01de6cd5e967a6c791ee3ae5a72b29a4a80a425 | existente; no prueba aprobación del candidato
C3 | footprint BOM original | C:\Program Files\KiCad\10.0\share\kicad\footprints\Capacitor_THT.pretty\C_Disc_D5.0mm_W2.5mm_P5.00mm.kicad_mod | 581b39dd6ab8744b2031bb6274bcf4ac3345e3a2e46acef2bac31074825b8b05 | existente; no prueba aprobación del candidato
C3 | footprint genérico candidato | C:\Program Files\KiCad\10.0\share\kicad\footprints\Capacitor_SMD.pretty\C_0603_1608Metric.kicad_mod | d45eebd5cb9faace255d4ec95a0f9484efde898359507b02e2ba9bbb3ef6d857 | existente; no prueba aprobación del candidato
C4 | símbolo proyecto original | project/pcb/Buck.kicad_sym | 017b58e522210d3f07bf3238b01de6cd5e967a6c791ee3ae5a72b29a4a80a425 | existente; no prueba aprobación del candidato
C4 | footprint BOM original | C:\Program Files\KiCad\10.0\share\kicad\footprints\Capacitor_THT.pretty\CP_Radial_D6.3mm_P2.50mm.kicad_mod | 985ff707ffcb2e5687d2e09b671bfa3ea0cdc41eeb20f6a75f6cb19f3f316e44 | existente; no prueba aprobación del candidato
C5 | símbolo proyecto original | project/pcb/Buck.kicad_sym | 017b58e522210d3f07bf3238b01de6cd5e967a6c791ee3ae5a72b29a4a80a425 | existente; no prueba aprobación del candidato
C5 | footprint BOM original | C:\Program Files\KiCad\10.0\share\kicad\footprints\Capacitor_THT.pretty\CP_Radial_D6.3mm_P2.50mm.kicad_mod | 985ff707ffcb2e5687d2e09b671bfa3ea0cdc41eeb20f6a75f6cb19f3f316e44 | existente; no prueba aprobación del candidato
U1 | símbolo proyecto original | project/pcb/Buck.kicad_sym | 017b58e522210d3f07bf3238b01de6cd5e967a6c791ee3ae5a72b29a4a80a425 | existente; no prueba aprobación del candidato
U1 | footprint BOM original | C:\Program Files\KiCad\10.0\share\kicad\footprints\Package_DIP.pretty\DIP-14_W7.62mm.kicad_mod | 6e9fc056d23e88e219b9e20d58ff74e1d351ca9a77a7b3e6b633f5475d6040f1 | existente; no prueba aprobación del candidato
U1 | footprint genérico candidato | C:\Program Files\KiCad\10.0\share\kicad\footprints\Package_SO.pretty\SOIC-16W_7.5x10.3mm_P1.27mm.kicad_mod | 79b58eec6e410d8b5af88b6687f2d1148d1e1605b9aaa57f5b707ab29b853e34 | existente; no prueba aprobación del candidato
D2 | símbolo proyecto original | project/pcb/Buck.kicad_sym | 017b58e522210d3f07bf3238b01de6cd5e967a6c791ee3ae5a72b29a4a80a425 | existente; no prueba aprobación del candidato
D2 | footprint BOM original | C:\Program Files\KiCad\10.0\share\kicad\footprints\Diode_THT.pretty\D_DO-41_SOD81_P10.16mm_Horizontal.kicad_mod | fdb8a0fafb90ba28fa9108225076263ede43610f2de398aeb6d4947e3eac85d8 | existente; no prueba aprobación del candidato
D2 | footprint genérico candidato | C:\Program Files\KiCad\10.0\share\kicad\footprints\Diode_SMD.pretty\D_SMA.kicad_mod | e2d049a54ef961e231eb8e7e769078a3c44feb8475a7bdafba01c6646a5144f3 | existente; no prueba aprobación del candidato
C6 | símbolo proyecto original | project/pcb/Buck.kicad_sym | 017b58e522210d3f07bf3238b01de6cd5e967a6c791ee3ae5a72b29a4a80a425 | existente; no prueba aprobación del candidato
C6 | footprint BOM original | C:\Program Files\KiCad\10.0\share\kicad\footprints\Capacitor_THT.pretty\C_Disc_D5.0mm_W2.5mm_P5.00mm.kicad_mod | 581b39dd6ab8744b2031bb6274bcf4ac3345e3a2e46acef2bac31074825b8b05 | existente; no prueba aprobación del candidato
C6 | footprint genérico candidato | C:\Program Files\KiCad\10.0\share\kicad\footprints\Capacitor_SMD.pretty\C_0805_2012Metric.kicad_mod | e890bdf55fa18fc6df6878eb1b5251a991e1b93985509175eb269d3d002880b4 | existente; no prueba aprobación del candidato
C7 | símbolo proyecto original | project/pcb/Buck.kicad_sym | 017b58e522210d3f07bf3238b01de6cd5e967a6c791ee3ae5a72b29a4a80a425 | existente; no prueba aprobación del candidato
C7 | footprint BOM original | C:\Program Files\KiCad\10.0\share\kicad\footprints\Capacitor_THT.pretty\C_Disc_D5.0mm_W2.5mm_P5.00mm.kicad_mod | 581b39dd6ab8744b2031bb6274bcf4ac3345e3a2e46acef2bac31074825b8b05 | existente; no prueba aprobación del candidato
C7 | footprint genérico candidato | C:\Program Files\KiCad\10.0\share\kicad\footprints\Capacitor_SMD.pretty\C_0603_1608Metric.kicad_mod | d45eebd5cb9faace255d4ec95a0f9484efde898359507b02e2ba9bbb3ef6d857 | existente; no prueba aprobación del candidato
C8 | símbolo proyecto original | project/pcb/Buck.kicad_sym | 017b58e522210d3f07bf3238b01de6cd5e967a6c791ee3ae5a72b29a4a80a425 | existente; no prueba aprobación del candidato
C8 | footprint BOM original | C:\Program Files\KiCad\10.0\share\kicad\footprints\Capacitor_THT.pretty\C_Disc_D5.0mm_W2.5mm_P5.00mm.kicad_mod | 581b39dd6ab8744b2031bb6274bcf4ac3345e3a2e46acef2bac31074825b8b05 | existente; no prueba aprobación del candidato
C8 | footprint genérico candidato | C:\Program Files\KiCad\10.0\share\kicad\footprints\Capacitor_SMD.pretty\C_0603_1608Metric.kicad_mod | d45eebd5cb9faace255d4ec95a0f9484efde898359507b02e2ba9bbb3ef6d857 | existente; no prueba aprobación del candidato
R1 | símbolo proyecto original | project/pcb/Buck.kicad_sym | 017b58e522210d3f07bf3238b01de6cd5e967a6c791ee3ae5a72b29a4a80a425 | existente; no prueba aprobación del candidato
R1 | footprint BOM original | C:\Program Files\KiCad\10.0\share\kicad\footprints\Resistor_THT.pretty\R_Axial_DIN0207_L6.3mm_D2.5mm_P7.62mm_Horizontal.kicad_mod | 075301a51b09edb0100d1a4efd026817f42db65a17b4e9e8a1c8776e69aa812d | existente; no prueba aprobación del candidato
R1 | footprint genérico candidato | C:\Program Files\KiCad\10.0\share\kicad\footprints\Resistor_SMD.pretty\R_0805_2012Metric.kicad_mod | 949bbbe025b509557866ddd9fcb0403244571f3ceb4f954c9766ee622d18421c | existente; no prueba aprobación del candidato
R2 | símbolo proyecto original | project/pcb/Buck.kicad_sym | 017b58e522210d3f07bf3238b01de6cd5e967a6c791ee3ae5a72b29a4a80a425 | existente; no prueba aprobación del candidato
R2 | footprint BOM original | C:\Program Files\KiCad\10.0\share\kicad\footprints\Resistor_THT.pretty\R_Axial_DIN0207_L6.3mm_D2.5mm_P7.62mm_Horizontal.kicad_mod | 075301a51b09edb0100d1a4efd026817f42db65a17b4e9e8a1c8776e69aa812d | existente; no prueba aprobación del candidato
R2 | footprint genérico candidato | C:\Program Files\KiCad\10.0\share\kicad\footprints\Resistor_SMD.pretty\R_0603_1608Metric.kicad_mod | 03fc7902b2661df01b4d828fdb6eab9eddf974e7130ed2b98892607387a50c4b | existente; no prueba aprobación del candidato
U2 | símbolo proyecto original | project/pcb/Buck.kicad_sym | 017b58e522210d3f07bf3238b01de6cd5e967a6c791ee3ae5a72b29a4a80a425 | existente; no prueba aprobación del candidato
U2 | footprint BOM original | C:\Program Files\KiCad\10.0\share\kicad\footprints\Package_TO_SOT_THT.pretty\TO-220-3_Vertical.kicad_mod | e116fbdc5f090042cbd25c86eaef6544bb417581019e1d2da0b5dc6e40b7b4bf | existente; no prueba aprobación del candidato
U2 | footprint genérico candidato | C:\Program Files\KiCad\10.0\share\kicad\footprints\Package_TO_SOT_SMD.pretty\TO-252-2.kicad_mod | cb366080aaffaf9f844ba3277472793c1ec65b776d0185bdceeca35fe25b487e | existente; no prueba aprobación del candidato
C9 | símbolo proyecto original | project/pcb/Buck.kicad_sym | 017b58e522210d3f07bf3238b01de6cd5e967a6c791ee3ae5a72b29a4a80a425 | existente; no prueba aprobación del candidato
C9 | footprint BOM original | C:\Program Files\KiCad\10.0\share\kicad\footprints\Capacitor_THT.pretty\C_Disc_D5.0mm_W2.5mm_P5.00mm.kicad_mod | 581b39dd6ab8744b2031bb6274bcf4ac3345e3a2e46acef2bac31074825b8b05 | existente; no prueba aprobación del candidato
C9 | footprint genérico candidato | C:\Program Files\KiCad\10.0\share\kicad\footprints\Capacitor_SMD.pretty\C_0805_2012Metric.kicad_mod | e890bdf55fa18fc6df6878eb1b5251a991e1b93985509175eb269d3d002880b4 | existente; no prueba aprobación del candidato
C10 | símbolo proyecto original | project/pcb/Buck.kicad_sym | 017b58e522210d3f07bf3238b01de6cd5e967a6c791ee3ae5a72b29a4a80a425 | existente; no prueba aprobación del candidato
C10 | footprint BOM original | C:\Program Files\KiCad\10.0\share\kicad\footprints\Capacitor_THT.pretty\C_Disc_D5.0mm_W2.5mm_P5.00mm.kicad_mod | 581b39dd6ab8744b2031bb6274bcf4ac3345e3a2e46acef2bac31074825b8b05 | existente; no prueba aprobación del candidato
C10 | footprint genérico candidato | C:\Program Files\KiCad\10.0\share\kicad\footprints\Capacitor_SMD.pretty\C_0603_1608Metric.kicad_mod | d45eebd5cb9faace255d4ec95a0f9484efde898359507b02e2ba9bbb3ef6d857 | existente; no prueba aprobación del candidato
C11 | símbolo proyecto original | project/pcb/Buck.kicad_sym | 017b58e522210d3f07bf3238b01de6cd5e967a6c791ee3ae5a72b29a4a80a425 | existente; no prueba aprobación del candidato
C11 | footprint BOM original | C:\Program Files\KiCad\10.0\share\kicad\footprints\Capacitor_THT.pretty\CP_Radial_D6.3mm_P2.50mm.kicad_mod | 985ff707ffcb2e5687d2e09b671bfa3ea0cdc41eeb20f6a75f6cb19f3f316e44 | existente; no prueba aprobación del candidato
C11 | footprint genérico candidato | C:\Program Files\KiCad\10.0\share\kicad\footprints\Capacitor_SMD.pretty\C_0805_2012Metric.kicad_mod | e890bdf55fa18fc6df6878eb1b5251a991e1b93985509175eb269d3d002880b4 | existente; no prueba aprobación del candidato
U3 | símbolo proyecto original | project/pcb/Buck.kicad_sym | 017b58e522210d3f07bf3238b01de6cd5e967a6c791ee3ae5a72b29a4a80a425 | existente; no prueba aprobación del candidato
U3 | footprint BOM original | C:\Program Files\KiCad\10.0\share\kicad\footprints\Package_DIP.pretty\DIP-14_W7.62mm.kicad_mod | 6e9fc056d23e88e219b9e20d58ff74e1d351ca9a77a7b3e6b633f5475d6040f1 | existente; no prueba aprobación del candidato
U3 | footprint genérico candidato | C:\Program Files\KiCad\10.0\share\kicad\footprints\Package_SO.pretty\SOIC-14_3.9x8.7mm_P1.27mm.kicad_mod | 26e119bbf40b9b7043210d97c89de9294b820b8e6e155d8c52bedfd5078508e0 | existente; no prueba aprobación del candidato
R3 | símbolo proyecto original | project/pcb/Buck.kicad_sym | 017b58e522210d3f07bf3238b01de6cd5e967a6c791ee3ae5a72b29a4a80a425 | existente; no prueba aprobación del candidato
R3 | footprint BOM original | C:\Program Files\KiCad\10.0\share\kicad\footprints\Resistor_THT.pretty\R_Axial_DIN0207_L6.3mm_D2.5mm_P7.62mm_Horizontal.kicad_mod | 075301a51b09edb0100d1a4efd026817f42db65a17b4e9e8a1c8776e69aa812d | existente; no prueba aprobación del candidato
R3 | footprint genérico candidato | C:\Program Files\KiCad\10.0\share\kicad\footprints\Resistor_SMD.pretty\R_0603_1608Metric.kicad_mod | 03fc7902b2661df01b4d828fdb6eab9eddf974e7130ed2b98892607387a50c4b | existente; no prueba aprobación del candidato
R4 | símbolo proyecto original | project/pcb/Buck.kicad_sym | 017b58e522210d3f07bf3238b01de6cd5e967a6c791ee3ae5a72b29a4a80a425 | existente; no prueba aprobación del candidato
R4 | footprint BOM original | C:\Program Files\KiCad\10.0\share\kicad\footprints\Resistor_THT.pretty\R_Axial_DIN0207_L6.3mm_D2.5mm_P7.62mm_Horizontal.kicad_mod | 075301a51b09edb0100d1a4efd026817f42db65a17b4e9e8a1c8776e69aa812d | existente; no prueba aprobación del candidato
R4 | footprint genérico candidato | C:\Program Files\KiCad\10.0\share\kicad\footprints\Resistor_SMD.pretty\R_0603_1608Metric.kicad_mod | 03fc7902b2661df01b4d828fdb6eab9eddf974e7130ed2b98892607387a50c4b | existente; no prueba aprobación del candidato
C12 | símbolo proyecto original | project/pcb/Buck.kicad_sym | 017b58e522210d3f07bf3238b01de6cd5e967a6c791ee3ae5a72b29a4a80a425 | existente; no prueba aprobación del candidato
C12 | footprint BOM original | C:\Program Files\KiCad\10.0\share\kicad\footprints\Capacitor_THT.pretty\C_Disc_D5.0mm_W2.5mm_P5.00mm.kicad_mod | 581b39dd6ab8744b2031bb6274bcf4ac3345e3a2e46acef2bac31074825b8b05 | existente; no prueba aprobación del candidato
C12 | footprint genérico candidato | C:\Program Files\KiCad\10.0\share\kicad\footprints\Capacitor_SMD.pretty\C_0603_1608Metric.kicad_mod | d45eebd5cb9faace255d4ec95a0f9484efde898359507b02e2ba9bbb3ef6d857 | existente; no prueba aprobación del candidato
U4 | símbolo proyecto original | project/pcb/Buck.kicad_sym | 017b58e522210d3f07bf3238b01de6cd5e967a6c791ee3ae5a72b29a4a80a425 | existente; no prueba aprobación del candidato
U4 | footprint BOM original | C:\Program Files\KiCad\10.0\share\kicad\footprints\Package_DIP.pretty\DIP-14_W7.62mm.kicad_mod | 6e9fc056d23e88e219b9e20d58ff74e1d351ca9a77a7b3e6b633f5475d6040f1 | existente; no prueba aprobación del candidato
U4 | footprint genérico candidato | C:\Program Files\KiCad\10.0\share\kicad\footprints\Package_SO.pretty\SOIC-14_3.9x8.7mm_P1.27mm.kicad_mod | 26e119bbf40b9b7043210d97c89de9294b820b8e6e155d8c52bedfd5078508e0 | existente; no prueba aprobación del candidato
C13 | símbolo proyecto original | project/pcb/Buck.kicad_sym | 017b58e522210d3f07bf3238b01de6cd5e967a6c791ee3ae5a72b29a4a80a425 | existente; no prueba aprobación del candidato
C13 | footprint BOM original | C:\Program Files\KiCad\10.0\share\kicad\footprints\Capacitor_THT.pretty\C_Disc_D5.0mm_W2.5mm_P5.00mm.kicad_mod | 581b39dd6ab8744b2031bb6274bcf4ac3345e3a2e46acef2bac31074825b8b05 | existente; no prueba aprobación del candidato
C13 | footprint genérico candidato | C:\Program Files\KiCad\10.0\share\kicad\footprints\Capacitor_SMD.pretty\C_0603_1608Metric.kicad_mod | d45eebd5cb9faace255d4ec95a0f9484efde898359507b02e2ba9bbb3ef6d857 | existente; no prueba aprobación del candidato
R5 | símbolo proyecto original | project/pcb/Buck.kicad_sym | 017b58e522210d3f07bf3238b01de6cd5e967a6c791ee3ae5a72b29a4a80a425 | existente; no prueba aprobación del candidato
R5 | footprint BOM original | C:\Program Files\KiCad\10.0\share\kicad\footprints\Resistor_THT.pretty\R_Axial_DIN0207_L6.3mm_D2.5mm_P7.62mm_Horizontal.kicad_mod | 075301a51b09edb0100d1a4efd026817f42db65a17b4e9e8a1c8776e69aa812d | existente; no prueba aprobación del candidato
R5 | footprint genérico candidato | C:\Program Files\KiCad\10.0\share\kicad\footprints\Resistor_SMD.pretty\R_0603_1608Metric.kicad_mod | 03fc7902b2661df01b4d828fdb6eab9eddf974e7130ed2b98892607387a50c4b | existente; no prueba aprobación del candidato
R6 | símbolo proyecto original | project/pcb/Buck.kicad_sym | 017b58e522210d3f07bf3238b01de6cd5e967a6c791ee3ae5a72b29a4a80a425 | existente; no prueba aprobación del candidato
R6 | footprint BOM original | C:\Program Files\KiCad\10.0\share\kicad\footprints\Resistor_THT.pretty\R_Axial_DIN0207_L6.3mm_D2.5mm_P7.62mm_Horizontal.kicad_mod | 075301a51b09edb0100d1a4efd026817f42db65a17b4e9e8a1c8776e69aa812d | existente; no prueba aprobación del candidato
R6 | footprint genérico candidato | C:\Program Files\KiCad\10.0\share\kicad\footprints\Resistor_SMD.pretty\R_0603_1608Metric.kicad_mod | 03fc7902b2661df01b4d828fdb6eab9eddf974e7130ed2b98892607387a50c4b | existente; no prueba aprobación del candidato
R7 | símbolo proyecto original | project/pcb/Buck.kicad_sym | 017b58e522210d3f07bf3238b01de6cd5e967a6c791ee3ae5a72b29a4a80a425 | existente; no prueba aprobación del candidato
R7 | footprint BOM original | C:\Program Files\KiCad\10.0\share\kicad\footprints\Resistor_THT.pretty\R_Axial_DIN0207_L6.3mm_D2.5mm_P7.62mm_Horizontal.kicad_mod | 075301a51b09edb0100d1a4efd026817f42db65a17b4e9e8a1c8776e69aa812d | existente; no prueba aprobación del candidato
R7 | footprint genérico candidato | C:\Program Files\KiCad\10.0\share\kicad\footprints\Resistor_SMD.pretty\R_0603_1608Metric.kicad_mod | 03fc7902b2661df01b4d828fdb6eab9eddf974e7130ed2b98892607387a50c4b | existente; no prueba aprobación del candidato
U5 | símbolo proyecto original | project/pcb/Buck.kicad_sym | 017b58e522210d3f07bf3238b01de6cd5e967a6c791ee3ae5a72b29a4a80a425 | existente; no prueba aprobación del candidato
U5 | footprint BOM original | C:\Program Files\KiCad\10.0\share\kicad\footprints\Package_DIP.pretty\DIP-8_W7.62mm.kicad_mod | 44500fc2989169a1ea877ba89e69cd60d0a77414af60fd2d1997de5569f2dee5 | existente; no prueba aprobación del candidato
U5 | footprint genérico candidato | C:\Program Files\KiCad\10.0\share\kicad\footprints\Package_SO.pretty\SOIC-8_3.9x4.9mm_P1.27mm.kicad_mod | 3c9b63198dd4dbf5e6c28c84702c29fad46a35103b821a19306c4ac888ad8e76 | existente; no prueba aprobación del candidato
C14 | símbolo proyecto original | project/pcb/Buck.kicad_sym | 017b58e522210d3f07bf3238b01de6cd5e967a6c791ee3ae5a72b29a4a80a425 | existente; no prueba aprobación del candidato
C14 | footprint BOM original | C:\Program Files\KiCad\10.0\share\kicad\footprints\Capacitor_THT.pretty\C_Disc_D5.0mm_W2.5mm_P5.00mm.kicad_mod | 581b39dd6ab8744b2031bb6274bcf4ac3345e3a2e46acef2bac31074825b8b05 | existente; no prueba aprobación del candidato
C14 | footprint genérico candidato | C:\Program Files\KiCad\10.0\share\kicad\footprints\Capacitor_SMD.pretty\C_0603_1608Metric.kicad_mod | d45eebd5cb9faace255d4ec95a0f9484efde898359507b02e2ba9bbb3ef6d857 | existente; no prueba aprobación del candidato
R8 | símbolo proyecto original | project/pcb/Buck.kicad_sym | 017b58e522210d3f07bf3238b01de6cd5e967a6c791ee3ae5a72b29a4a80a425 | existente; no prueba aprobación del candidato
R8 | footprint BOM original | C:\Program Files\KiCad\10.0\share\kicad\footprints\Resistor_THT.pretty\R_Axial_DIN0207_L6.3mm_D2.5mm_P7.62mm_Horizontal.kicad_mod | 075301a51b09edb0100d1a4efd026817f42db65a17b4e9e8a1c8776e69aa812d | existente; no prueba aprobación del candidato
R8 | footprint genérico candidato | C:\Program Files\KiCad\10.0\share\kicad\footprints\Resistor_SMD.pretty\R_0603_1608Metric.kicad_mod | 03fc7902b2661df01b4d828fdb6eab9eddf974e7130ed2b98892607387a50c4b | existente; no prueba aprobación del candidato
R9 | símbolo proyecto original | project/pcb/Buck.kicad_sym | 017b58e522210d3f07bf3238b01de6cd5e967a6c791ee3ae5a72b29a4a80a425 | existente; no prueba aprobación del candidato
R9 | footprint BOM original | C:\Program Files\KiCad\10.0\share\kicad\footprints\Resistor_THT.pretty\R_Axial_DIN0207_L6.3mm_D2.5mm_P7.62mm_Horizontal.kicad_mod | 075301a51b09edb0100d1a4efd026817f42db65a17b4e9e8a1c8776e69aa812d | existente; no prueba aprobación del candidato
R9 | footprint genérico candidato | C:\Program Files\KiCad\10.0\share\kicad\footprints\Resistor_SMD.pretty\R_0603_1608Metric.kicad_mod | 03fc7902b2661df01b4d828fdb6eab9eddf974e7130ed2b98892607387a50c4b | existente; no prueba aprobación del candidato
C15 | símbolo proyecto original | project/pcb/Buck.kicad_sym | 017b58e522210d3f07bf3238b01de6cd5e967a6c791ee3ae5a72b29a4a80a425 | existente; no prueba aprobación del candidato
C15 | footprint BOM original | C:\Program Files\KiCad\10.0\share\kicad\footprints\Capacitor_THT.pretty\C_Disc_D5.0mm_W2.5mm_P5.00mm.kicad_mod | 581b39dd6ab8744b2031bb6274bcf4ac3345e3a2e46acef2bac31074825b8b05 | existente; no prueba aprobación del candidato
C15 | footprint genérico candidato | C:\Program Files\KiCad\10.0\share\kicad\footprints\Capacitor_SMD.pretty\C_0603_1608Metric.kicad_mod | d45eebd5cb9faace255d4ec95a0f9484efde898359507b02e2ba9bbb3ef6d857 | existente; no prueba aprobación del candidato
R10 | símbolo proyecto original | project/pcb/Buck.kicad_sym | 017b58e522210d3f07bf3238b01de6cd5e967a6c791ee3ae5a72b29a4a80a425 | existente; no prueba aprobación del candidato
R10 | footprint BOM original | C:\Program Files\KiCad\10.0\share\kicad\footprints\Resistor_THT.pretty\R_Axial_DIN0207_L6.3mm_D2.5mm_P7.62mm_Horizontal.kicad_mod | 075301a51b09edb0100d1a4efd026817f42db65a17b4e9e8a1c8776e69aa812d | existente; no prueba aprobación del candidato
R10 | footprint genérico candidato | C:\Program Files\KiCad\10.0\share\kicad\footprints\Resistor_SMD.pretty\R_0603_1608Metric.kicad_mod | 03fc7902b2661df01b4d828fdb6eab9eddf974e7130ed2b98892607387a50c4b | existente; no prueba aprobación del candidato
R11 | símbolo proyecto original | project/pcb/Buck.kicad_sym | 017b58e522210d3f07bf3238b01de6cd5e967a6c791ee3ae5a72b29a4a80a425 | existente; no prueba aprobación del candidato
R11 | footprint BOM original | C:\Program Files\KiCad\10.0\share\kicad\footprints\Resistor_THT.pretty\R_Axial_DIN0207_L6.3mm_D2.5mm_P7.62mm_Horizontal.kicad_mod | 075301a51b09edb0100d1a4efd026817f42db65a17b4e9e8a1c8776e69aa812d | existente; no prueba aprobación del candidato
R11 | footprint genérico candidato | C:\Program Files\KiCad\10.0\share\kicad\footprints\Resistor_SMD.pretty\R_0603_1608Metric.kicad_mod | 03fc7902b2661df01b4d828fdb6eab9eddf974e7130ed2b98892607387a50c4b | existente; no prueba aprobación del candidato
U6 | símbolo proyecto original | project/pcb/Buck.kicad_sym | 017b58e522210d3f07bf3238b01de6cd5e967a6c791ee3ae5a72b29a4a80a425 | existente; no prueba aprobación del candidato
U6 | footprint BOM original | C:\Program Files\KiCad\10.0\share\kicad\footprints\Package_TO_SOT_SMD.pretty\SOT-23-5.kicad_mod | 684a94089f59798a46492dac8dd0242edfa4d915e76a210abdca369e4faa4f9b | existente; no prueba aprobación del candidato
U6 | footprint genérico candidato | C:\Program Files\KiCad\10.0\share\kicad\footprints\Package_TO_SOT_SMD.pretty\SOT-23-5.kicad_mod | 684a94089f59798a46492dac8dd0242edfa4d915e76a210abdca369e4faa4f9b | existente; no prueba aprobación del candidato
C16 | símbolo proyecto original | project/pcb/Buck.kicad_sym | 017b58e522210d3f07bf3238b01de6cd5e967a6c791ee3ae5a72b29a4a80a425 | existente; no prueba aprobación del candidato
C16 | footprint BOM original | C:\Program Files\KiCad\10.0\share\kicad\footprints\Capacitor_THT.pretty\C_Disc_D5.0mm_W2.5mm_P5.00mm.kicad_mod | 581b39dd6ab8744b2031bb6274bcf4ac3345e3a2e46acef2bac31074825b8b05 | existente; no prueba aprobación del candidato
C16 | footprint genérico candidato | C:\Program Files\KiCad\10.0\share\kicad\footprints\Capacitor_SMD.pretty\C_0603_1608Metric.kicad_mod | d45eebd5cb9faace255d4ec95a0f9484efde898359507b02e2ba9bbb3ef6d857 | existente; no prueba aprobación del candidato
Q2 | símbolo proyecto original | project/pcb/Buck.kicad_sym | 017b58e522210d3f07bf3238b01de6cd5e967a6c791ee3ae5a72b29a4a80a425 | existente; no prueba aprobación del candidato
Q2 | footprint BOM original | C:\Program Files\KiCad\10.0\share\kicad\footprints\Package_TO_SOT_THT.pretty\TO-92_Inline_Wide.kicad_mod | 108d7a3d7e23540a947c472fcdbb08bcd4cbfe8911fdfd82764d19dff58272de | existente; no prueba aprobación del candidato
Q2 | footprint genérico candidato | C:\Program Files\KiCad\10.0\share\kicad\footprints\Package_TO_SOT_SMD.pretty\SOT-23.kicad_mod | 7fb2859c6463f3a37966a1a20c31d8bfe7d4e8459d00bb165d5a7488270816c5 | existente; no prueba aprobación del candidato
R12 | símbolo proyecto original | project/pcb/Buck.kicad_sym | 017b58e522210d3f07bf3238b01de6cd5e967a6c791ee3ae5a72b29a4a80a425 | existente; no prueba aprobación del candidato
R12 | footprint BOM original | C:\Program Files\KiCad\10.0\share\kicad\footprints\Resistor_THT.pretty\R_Axial_DIN0207_L6.3mm_D2.5mm_P7.62mm_Horizontal.kicad_mod | 075301a51b09edb0100d1a4efd026817f42db65a17b4e9e8a1c8776e69aa812d | existente; no prueba aprobación del candidato
R12 | footprint genérico candidato | C:\Program Files\KiCad\10.0\share\kicad\footprints\Resistor_SMD.pretty\R_0603_1608Metric.kicad_mod | 03fc7902b2661df01b4d828fdb6eab9eddf974e7130ed2b98892607387a50c4b | existente; no prueba aprobación del candidato
R13 | símbolo proyecto original | project/pcb/Buck.kicad_sym | 017b58e522210d3f07bf3238b01de6cd5e967a6c791ee3ae5a72b29a4a80a425 | existente; no prueba aprobación del candidato
R13 | footprint BOM original | C:\Program Files\KiCad\10.0\share\kicad\footprints\Resistor_THT.pretty\R_Axial_DIN0207_L6.3mm_D2.5mm_P7.62mm_Horizontal.kicad_mod | 075301a51b09edb0100d1a4efd026817f42db65a17b4e9e8a1c8776e69aa812d | existente; no prueba aprobación del candidato
R13 | footprint genérico candidato | C:\Program Files\KiCad\10.0\share\kicad\footprints\Resistor_SMD.pretty\R_0603_1608Metric.kicad_mod | 03fc7902b2661df01b4d828fdb6eab9eddf974e7130ed2b98892607387a50c4b | existente; no prueba aprobación del candidato
R14 | símbolo proyecto original | project/pcb/Buck.kicad_sym | 017b58e522210d3f07bf3238b01de6cd5e967a6c791ee3ae5a72b29a4a80a425 | existente; no prueba aprobación del candidato
R14 | footprint BOM original | C:\Program Files\KiCad\10.0\share\kicad\footprints\Resistor_THT.pretty\R_Axial_DIN0207_L6.3mm_D2.5mm_P7.62mm_Horizontal.kicad_mod | 075301a51b09edb0100d1a4efd026817f42db65a17b4e9e8a1c8776e69aa812d | existente; no prueba aprobación del candidato
R14 | footprint genérico candidato | C:\Program Files\KiCad\10.0\share\kicad\footprints\Resistor_SMD.pretty\R_0603_1608Metric.kicad_mod | 03fc7902b2661df01b4d828fdb6eab9eddf974e7130ed2b98892607387a50c4b | existente; no prueba aprobación del candidato
R15 | símbolo proyecto original | project/pcb/Buck.kicad_sym | 017b58e522210d3f07bf3238b01de6cd5e967a6c791ee3ae5a72b29a4a80a425 | existente; no prueba aprobación del candidato
R15 | footprint BOM original | C:\Program Files\KiCad\10.0\share\kicad\footprints\Resistor_THT.pretty\R_Axial_DIN0207_L6.3mm_D2.5mm_P7.62mm_Horizontal.kicad_mod | 075301a51b09edb0100d1a4efd026817f42db65a17b4e9e8a1c8776e69aa812d | existente; no prueba aprobación del candidato
R15 | footprint genérico candidato | C:\Program Files\KiCad\10.0\share\kicad\footprints\Resistor_SMD.pretty\R_0603_1608Metric.kicad_mod | 03fc7902b2661df01b4d828fdb6eab9eddf974e7130ed2b98892607387a50c4b | existente; no prueba aprobación del candidato
C17 | símbolo proyecto original | project/pcb/Buck.kicad_sym | 017b58e522210d3f07bf3238b01de6cd5e967a6c791ee3ae5a72b29a4a80a425 | existente; no prueba aprobación del candidato
C17 | footprint BOM original | C:\Program Files\KiCad\10.0\share\kicad\footprints\Capacitor_THT.pretty\C_Disc_D5.0mm_W2.5mm_P5.00mm.kicad_mod | 581b39dd6ab8744b2031bb6274bcf4ac3345e3a2e46acef2bac31074825b8b05 | existente; no prueba aprobación del candidato
C17 | footprint genérico candidato | C:\Program Files\KiCad\10.0\share\kicad\footprints\Capacitor_SMD.pretty\C_0603_1608Metric.kicad_mod | d45eebd5cb9faace255d4ec95a0f9484efde898359507b02e2ba9bbb3ef6d857 | existente; no prueba aprobación del candidato
J3 | símbolo proyecto original | project/pcb/Buck.kicad_sym | 017b58e522210d3f07bf3238b01de6cd5e967a6c791ee3ae5a72b29a4a80a425 | existente; no prueba aprobación del candidato
J3 | footprint BOM original | C:\Program Files\KiCad\10.0\share\kicad\footprints\Connector_PinHeader_2.54mm.pretty\PinHeader_2x05_P2.54mm_Vertical.kicad_mod | 1c003758c6bb59c90b91e7652315777dbacbe89ce9a352693a56805290e42ac0 | existente; no prueba aprobación del candidato
TP1 | símbolo proyecto original | project/pcb/Buck.kicad_sym | 017b58e522210d3f07bf3238b01de6cd5e967a6c791ee3ae5a72b29a4a80a425 | existente; no prueba aprobación del candidato
TP1 | footprint BOM original | C:\Program Files\KiCad\10.0\share\kicad\footprints\TestPoint.pretty\TestPoint_THTPad_D2.0mm_Drill1.0mm.kicad_mod | f8383676add1f861160ed7eda486d1a583ecce463dd082c911c03bd1f0ff6aba | existente; no prueba aprobación del candidato
TP1 | footprint genérico candidato | C:\Program Files\KiCad\10.0\share\kicad\footprints\TestPoint.pretty\TestPoint_Pad_D2.0mm.kicad_mod | 075c8efad44dc51dedc947dbb0c586ddfdca34600187cc8ae1a8385e02c6a155 | existente; no prueba aprobación del candidato
TP2 | símbolo proyecto original | project/pcb/Buck.kicad_sym | 017b58e522210d3f07bf3238b01de6cd5e967a6c791ee3ae5a72b29a4a80a425 | existente; no prueba aprobación del candidato
TP2 | footprint BOM original | C:\Program Files\KiCad\10.0\share\kicad\footprints\TestPoint.pretty\TestPoint_THTPad_D2.0mm_Drill1.0mm.kicad_mod | f8383676add1f861160ed7eda486d1a583ecce463dd082c911c03bd1f0ff6aba | existente; no prueba aprobación del candidato
TP2 | footprint genérico candidato | C:\Program Files\KiCad\10.0\share\kicad\footprints\TestPoint.pretty\TestPoint_Pad_D2.0mm.kicad_mod | 075c8efad44dc51dedc947dbb0c586ddfdca34600187cc8ae1a8385e02c6a155 | existente; no prueba aprobación del candidato
TP3 | símbolo proyecto original | project/pcb/Buck.kicad_sym | 017b58e522210d3f07bf3238b01de6cd5e967a6c791ee3ae5a72b29a4a80a425 | existente; no prueba aprobación del candidato
TP3 | footprint BOM original | C:\Program Files\KiCad\10.0\share\kicad\footprints\TestPoint.pretty\TestPoint_THTPad_D2.0mm_Drill1.0mm.kicad_mod | f8383676add1f861160ed7eda486d1a583ecce463dd082c911c03bd1f0ff6aba | existente; no prueba aprobación del candidato
TP3 | footprint genérico candidato | C:\Program Files\KiCad\10.0\share\kicad\footprints\TestPoint.pretty\TestPoint_Pad_D2.0mm.kicad_mod | 075c8efad44dc51dedc947dbb0c586ddfdca34600187cc8ae1a8385e02c6a155 | existente; no prueba aprobación del candidato
TP4 | símbolo proyecto original | project/pcb/Buck.kicad_sym | 017b58e522210d3f07bf3238b01de6cd5e967a6c791ee3ae5a72b29a4a80a425 | existente; no prueba aprobación del candidato
TP4 | footprint BOM original | C:\Program Files\KiCad\10.0\share\kicad\footprints\TestPoint.pretty\TestPoint_THTPad_D2.0mm_Drill1.0mm.kicad_mod | f8383676add1f861160ed7eda486d1a583ecce463dd082c911c03bd1f0ff6aba | existente; no prueba aprobación del candidato
TP4 | footprint genérico candidato | C:\Program Files\KiCad\10.0\share\kicad\footprints\TestPoint.pretty\TestPoint_Pad_D2.0mm.kicad_mod | 075c8efad44dc51dedc947dbb0c586ddfdca34600187cc8ae1a8385e02c6a155 | existente; no prueba aprobación del candidato
TP5 | símbolo proyecto original | project/pcb/Buck.kicad_sym | 017b58e522210d3f07bf3238b01de6cd5e967a6c791ee3ae5a72b29a4a80a425 | existente; no prueba aprobación del candidato
TP5 | footprint BOM original | C:\Program Files\KiCad\10.0\share\kicad\footprints\TestPoint.pretty\TestPoint_THTPad_D2.0mm_Drill1.0mm.kicad_mod | f8383676add1f861160ed7eda486d1a583ecce463dd082c911c03bd1f0ff6aba | existente; no prueba aprobación del candidato
TP5 | footprint genérico candidato | C:\Program Files\KiCad\10.0\share\kicad\footprints\TestPoint.pretty\TestPoint_Pad_D2.0mm.kicad_mod | 075c8efad44dc51dedc947dbb0c586ddfdca34600187cc8ae1a8385e02c6a155 | existente; no prueba aprobación del candidato
TP6 | símbolo proyecto original | project/pcb/Buck.kicad_sym | 017b58e522210d3f07bf3238b01de6cd5e967a6c791ee3ae5a72b29a4a80a425 | existente; no prueba aprobación del candidato
TP6 | footprint BOM original | C:\Program Files\KiCad\10.0\share\kicad\footprints\TestPoint.pretty\TestPoint_THTPad_D2.0mm_Drill1.0mm.kicad_mod | f8383676add1f861160ed7eda486d1a583ecce463dd082c911c03bd1f0ff6aba | existente; no prueba aprobación del candidato
TP6 | footprint genérico candidato | C:\Program Files\KiCad\10.0\share\kicad\footprints\TestPoint.pretty\TestPoint_Pad_D2.0mm.kicad_mod | 075c8efad44dc51dedc947dbb0c586ddfdca34600187cc8ae1a8385e02c6a155 | existente; no prueba aprobación del candidato
TP7 | símbolo proyecto original | project/pcb/Buck.kicad_sym | 017b58e522210d3f07bf3238b01de6cd5e967a6c791ee3ae5a72b29a4a80a425 | existente; no prueba aprobación del candidato
TP7 | footprint BOM original | C:\Program Files\KiCad\10.0\share\kicad\footprints\TestPoint.pretty\TestPoint_THTPad_D2.0mm_Drill1.0mm.kicad_mod | f8383676add1f861160ed7eda486d1a583ecce463dd082c911c03bd1f0ff6aba | existente; no prueba aprobación del candidato
TP7 | footprint genérico candidato | C:\Program Files\KiCad\10.0\share\kicad\footprints\TestPoint.pretty\TestPoint_Pad_D2.0mm.kicad_mod | 075c8efad44dc51dedc947dbb0c586ddfdca34600187cc8ae1a8385e02c6a155 | existente; no prueba aprobación del candidato
TP8 | símbolo proyecto original | project/pcb/Buck.kicad_sym | 017b58e522210d3f07bf3238b01de6cd5e967a6c791ee3ae5a72b29a4a80a425 | existente; no prueba aprobación del candidato
TP8 | footprint BOM original | C:\Program Files\KiCad\10.0\share\kicad\footprints\TestPoint.pretty\TestPoint_THTPad_D2.0mm_Drill1.0mm.kicad_mod | f8383676add1f861160ed7eda486d1a583ecce463dd082c911c03bd1f0ff6aba | existente; no prueba aprobación del candidato
TP8 | footprint genérico candidato | C:\Program Files\KiCad\10.0\share\kicad\footprints\TestPoint.pretty\TestPoint_Pad_D2.0mm.kicad_mod | 075c8efad44dc51dedc947dbb0c586ddfdca34600187cc8ae1a8385e02c6a155 | existente; no prueba aprobación del candidato
TP9 | símbolo proyecto original | project/pcb/Buck.kicad_sym | 017b58e522210d3f07bf3238b01de6cd5e967a6c791ee3ae5a72b29a4a80a425 | existente; no prueba aprobación del candidato
TP9 | footprint BOM original | C:\Program Files\KiCad\10.0\share\kicad\footprints\TestPoint.pretty\TestPoint_THTPad_D2.0mm_Drill1.0mm.kicad_mod | f8383676add1f861160ed7eda486d1a583ecce463dd082c911c03bd1f0ff6aba | existente; no prueba aprobación del candidato
TP9 | footprint genérico candidato | C:\Program Files\KiCad\10.0\share\kicad\footprints\TestPoint.pretty\TestPoint_Pad_D2.0mm.kicad_mod | 075c8efad44dc51dedc947dbb0c586ddfdca34600187cc8ae1a8385e02c6a155 | existente; no prueba aprobación del candidato
