almondsun/DynamicSystemsAndControl/project/pcb/audit/jlc_candidates.csv

designators | mpn | manufacturer | lcsc | jlc_class | stock | stock_date | commercial_url | official_datasheet_url | package | dimensions_mm | electrical_characteristics | differences | pending_validation | extended_reason | selection | validation | jlc_status | research_kind
J1;J2 | TB002-500-02BE | Same Sky (antes CUI Devices) | C2757858 | Extended | NO VERIFICADO | 2026-10-24 | https://jlcpcb.com/partdetail/CUI-TB002_50002BE/C2757858 | https://www.sameskydevices.com/product/resource/tb002-500.pdf | THT 1x2 P5mm | paso 5; altura 10; resto verificar plano | 17.5 A; 250 V; AWG12–22 | Cambio de tecnología/encapsulado respecto a BOM original; no equivalencia de pinout declarada | PDF oficial devolvió 403; verificar torque, agujeros, cable y proceso Wave; conservar THT hasta decidir montaje | Conector de tornillo para corriente y sujeción; no se verificó Basic mecánicamente equivalente | candidato | pendiente | no verificado | nuevo
J3 | 61201021621 | Würth Elektronik |  | NO VERIFICADO | NO VERIFICADO | 2026-10-24 | https://www.we-online.com/en/components/products/WR_BHD_254_MALE_BOX_HEADER | https://www.we-online.com/components/products/datasheet/61201021621.pdf | THT 2x5 con carcasa y llave P2.54mm | 20.36 x 9.1; paso 2.54; taladro recomendado 1.1 | 3 A @25°C; 250 VAC; resistencia contacto <=20mOhm | Cambio de tecnología/encapsulado respecto a BOM original; no equivalencia de pinout declarada | Confirmar cable complementario, llave, orden de señales, huecos y montaje JLC; código JLC no localizado | No Basic confirmado con llave, paso y geometría requeridos | candidato | pendiente | no verificado | nuevo
C3;C7;C8;C10;C12;C13;C14;C15;C16 | CC0603KRX7R9BB104 | YAGEO | C14663 | Basic | NO VERIFICADO | 2026-10-24 | https://jlcpcb.com/partdetail/YAGEO-CC0603KRX7R9BB104/C14663 | https://yageogroup.com/download/specsheet/CC0603KRX7R9BB104 | 0603 | 1.6 x 0.8; altura consultar especificación | 100 nF; 50 V; X7R; ±10% | Cambio de tecnología/encapsulado respecto a BOM original; no equivalencia de pinout declarada | Capacitancia efectiva, temperatura, ESL y ubicación por IC; conservar 50 V; C10 depende del regulador |  | candidato | pendiente | no verificado | nuevo
C6 | CL21B105KBFNNNE | Samsung Electro-Mechanics | C28323 | Basic | NO VERIFICADO | 2026-10-24 | https://jlcpcb.com/partdetail/C28323 | https://product.samsungsem.com/mlcc/CL21B105KBFNNN.do | 0805 | 2.00±0.10 x 1.25±0.10 x 1.25±0.10 | 1 uF; 50 V; X7R; ±10% | Cambio de tecnología/encapsulado respecto a BOM original; no equivalencia de pinout declarada | Bootstrap: C efectivo a VBS, Qg total, fugas, UVLO y tiempo de recarga; aprobación depende de U1 y Q1 |  | candidato | pendiente | no verificado | nuevo
C9 | CL21B334KBFNNNE | Samsung Electro-Mechanics | C73142 | Extended | NO VERIFICADO | 2026-10-24 | https://jlcpcb.com/partdetail/74255-CL21B334KBFNNNE/C73142 | https://product.samsungsem.com/mlcc/CL21B334KBFNNN.do | 0805 | 2.0 x 1.25 nominal; altura verificar ficha | 330 nF; 50 V; X7R; ±10% | Cambio de tecnología/encapsulado respecto a BOM original; no equivalencia de pinout declarada | Confirmar recomendación de 78M05 exacto, C efectivo y montaje | No Basic apropiado confirmado para 330nF/50V; candidato exacto conserva requisito original | candidato | pendiente | no verificado | nuevo
C11 | CL21A106KAYNNNE | Samsung Electro-Mechanics | C15850 | Basic | NO VERIFICADO (página consultada muestra 7,107,006; dato público sin reserva ni confirmación en tiempo real) | 2026-10-24 | https://jlcpcb.com/partdetail/CL21A106KAYNNNE/C15850 | https://product.samsungsem.com/mlcc/CL21A106KAYNNN.do | 0805 | 2.00±0.20 x 1.25±0.20 x 1.25±0.20 | 10 uF; 25 V; X5R; ±10% | Cambio de tecnología/encapsulado respecto a BOM original; no equivalencia de pinout declarada | Cambio electrolítico a MLCC: verificar estabilidad/ESR regulador, C efectivo a 5 V y temperatura; biblioteca Altium localizada; convertir pendiente |  | candidato | pendiente | no verificado | nuevo
C17 | 0603CG102J500NT | FH (Fenghua) | C1636 | Extended | NO VERIFICADO | 2026-10-24 | https://jlcpcb.com/partdetail/1988-0603CG102J500NT/C1636 | https://www.fhcomp.com/zh-cn/product_info/?prod_code=0603CG102J500NT | 0603 | 1.6 x 0.8 nominal; altura verificar ficha | 1 nF; 50 V; C0G; ±5% | Cambio de tecnología/encapsulado respecto a BOM original; no equivalencia de pinout declarada | Verificar settling ADC, tolerancia total del divisor y filtro; tau nominal 0.75 us | C0G prioriza estabilidad del filtro; no Basic C0G adecuado confirmado | candidato | pendiente | no verificado | nuevo
R2;R3;R5;R6;R9;R11;R12;R13 | 0603WAF1002T5E | UNI-ROYAL | C25804 | Basic | NO VERIFICADO | 2026-10-24 | https://jlcpcb.com/partdetail/C25804 | https://www.royalohm.com/assets/pdf/products/smd/1.pdf | 0603 | 1.6 x 0.8 nominal; altura según ficha | 10 kohm; ±1%; 0.1 W; ±100ppm/°C; catálogo 75V (revisar límite por potencia) | Cambio de tecnología/encapsulado respecto a BOM original; no equivalencia de pinout declarada | Calcular potencia y derating, TCR y tolerancia de divisores/umbrales, corriente de base/pull-up según referencia |  | candidato | pendiente | no verificado | nuevo
R4;R15 | 0603WAF1001T5E | UNI-ROYAL | C21190 | Basic | NO VERIFICADO | 2026-10-24 | https://jlcpcb.com/partdetail/C21190 | https://www.royalohm.com/assets/pdf/products/smd/1.pdf | 0603 | 1.6 x 0.8 nominal; altura según ficha | 1 kohm; ±1%; 0.1 W; ±100ppm/°C; catálogo 75V (revisar límite por potencia) | Cambio de tecnología/encapsulado respecto a BOM original; no equivalencia de pinout declarada | Calcular potencia y derating, TCR y tolerancia de divisores/umbrales, corriente de base/pull-up según referencia |  | candidato | pendiente | no verificado | nuevo
R7 | 0603WAF4701T5E | UNI-ROYAL | C23162 | Basic | NO VERIFICADO | 2026-10-24 | https://jlcpcb.com/partdetail/C23162 | https://www.royalohm.com/assets/pdf/products/smd/1.pdf | 0603 | 1.6 x 0.8 nominal; altura según ficha | 4.7 kohm; ±1%; 0.1 W; ±100ppm/°C; catálogo 75V (revisar límite por potencia) | Cambio de tecnología/encapsulado respecto a BOM original; no equivalencia de pinout declarada | Calcular potencia y derating, TCR y tolerancia de divisores/umbrales, corriente de base/pull-up según referencia |  | candidato | pendiente | no verificado | nuevo
R8 | 0603WAF1502T5E | UNI-ROYAL | C22809 | NO VERIFICADO | NO VERIFICADO | 2026-10-24 | https://jlcpcb.com/partdetail/C22809 | https://www.royalohm.com/assets/pdf/products/smd/1.pdf | 0603 | 1.6 x 0.8 nominal; altura según ficha | 15 kohm; ±1%; 0.1 W; ±100ppm/°C; catálogo 75V (revisar límite por potencia) | Cambio de tecnología/encapsulado respecto a BOM original; no equivalencia de pinout declarada | Calcular potencia y derating, TCR y tolerancia de divisores/umbrales, corriente de base/pull-up según referencia; R8 categoría JLC no recuperable |  | candidato | pendiente | no verificado | nuevo
R1 | 0805W8F100JT5E | UNI-ROYAL | C17415 | NO VERIFICADO | NO VERIFICADO | 2026-10-24 | https://jlcpcb.com/partdetail/C17415 | https://www.royalohm.com/assets/pdf/products/smd/1.pdf | 0805 | 2.0 x 1.25 nominal; altura según ficha | 10 ohm; ±1%; 0.125 W; ±200ppm/°C | Cambio de tecnología/encapsulado respecto a BOM original; no equivalencia de pinout declarada | No aprobar por valor: verificar curva de sobrecarga pulsada con Qg/frecuencia, corriente de gate y ringing; ficha JLC no recuperable |  | candidato | pendiente | no verificado | nuevo
R14 | RC0603FR-073KL | YAGEO | C126358 | NO VERIFICADO | NO VERIFICADO | 2026-10-24 | https://www.lcsc.com/product-detail/C126358.html | https://yageogroup.com/component-documentation/download/specsheet/RC0603FR-073KL | 0603 | 1.6 x 0.8 nominal; altura según ficha | 3 kohm; ±1%; 0.1 W; ±100ppm/°C | Cambio de tecnología/encapsulado respecto a BOM original; no equivalencia de pinout declarada | Comprobar error ADC y tolerancia frente a R15, potencia, TCR y muestreo; categoría JLC no confirmada | No Basic exacto 3kohm confirmado por fuente primaria; no reemplazar con 3.3kohm | candidato | pendiente | no verificado | nuevo
R10 | RC0603FR-0731K6L | YAGEO |  | NO VERIFICADO | NO VERIFICADO | 2026-10-24 | https://www.digikey.com/en/products/detail/yageo/RC0603FR-0731K6L/727151 | https://www.yageogroup.com/component-documentation/download/specsheet/RC0603FR-0731K6L | 0603 | 1.6 x 0.8 nominal; altura verificar ficha | 31.6 kohm; ±1%; 0.1 W | Cambio de tecnología/encapsulado respecto a BOM original; no equivalencia de pinout declarada | NO equivalente a 31kohm: cambia umbral OVP; no se asigna al inventario. Requiere decisión humana; MPN exacto 31kohm no verificado | Exploración de valor cercano; no autoriza modificar circuito | candidato | pendiente | no verificado | alternativa de valor; NO asignada
