almondsun/DynamicSystemsAndControl/project/pcb/redesign/production/jlcpcb-quote-2026-10/assembly_inventory.md

# Inventario de ensamblaje — cotización

Estado: PENDIENTE DE REVISIÓN. ASSEMBLED_BY_JLC indica el alcance previsto de cotización SMT, no aprobación eléctrica ni garantía de montaje. No se sustituyó ningún componente. Los 41 SMD tienen selección MPN/LCSC en el esquemático; todos conservan el campo Electrical_Approval=PENDING.

PCB y esquemático contienen las mismas 57 referencias. Inventario obtenido independientemente de la PCB y reconciliado con la netlist recién exportada. DNP real: 0. Los 9 puntos de prueba son pads de cobre, sin componente adicional, y se excluyen sin cambiar atributos CAD.

| Ref | Estado | Tipo | PCB/SCH | MPN válido / LCSC seleccionado | Huella de catálogo / land | BOM/CPL | Motivo |
|---|---|---|---|---|---|---|---|
| C1 | ASSEMBLED_BY_JLC | SMD | sí/sí | Panasonic 25SVPF100M / C136279 | SMD D8x6.9mm; land pendiente | sí/sí | Incluido SOLO para cotización SMT; aprobación eléctrica/land pendiente |
| C2 | ASSEMBLED_BY_JLC | SMD | sí/sí | Panasonic 25SVPF100M / C136279 | SMD D8x6.9mm; land pendiente | sí/sí | Incluido SOLO para cotización SMT; aprobación eléctrica/land pendiente |
| C3 | ASSEMBLED_BY_JLC | SMD | sí/sí | Yageo CC0603KRX7R9BB104 / C14663 | 0603; land pendiente | sí/sí | Incluido SOLO para cotización SMT; aprobación eléctrica/land pendiente |
| C4 | ASSEMBLED_BY_JLC | SMD | sí/sí | Panasonic 50SVF10M / C454354 | SMD D6.3x5.9mm; land pendiente | sí/sí | Incluido SOLO para cotización SMT; aprobación eléctrica/land pendiente |
| C5 | ASSEMBLED_BY_JLC | SMD | sí/sí | Panasonic 50SVF10M / C454354 | SMD D6.3x5.9mm; land pendiente | sí/sí | Incluido SOLO para cotización SMT; aprobación eléctrica/land pendiente |
| C6 | ASSEMBLED_BY_JLC | SMD | sí/sí | CL31B225KBHNNNE / C50254 | 1206; land pendiente | sí/sí | Incluido SOLO para cotización SMT; aprobación eléctrica/land pendiente |
| C7 | ASSEMBLED_BY_JLC | SMD | sí/sí | Yageo CC0603KRX7R9BB104 / C14663 | 0603; land pendiente | sí/sí | Incluido SOLO para cotización SMT; aprobación eléctrica/land pendiente |
| C8 | ASSEMBLED_BY_JLC | SMD | sí/sí | Yageo CC0603KRX7R9BB104 / C14663 | 0603; land pendiente | sí/sí | Incluido SOLO para cotización SMT; aprobación eléctrica/land pendiente |
| C9 | ASSEMBLED_BY_JLC | SMD | sí/sí | Samsung CL21B334KBFNNNE / C73142 | 0805; land pendiente | sí/sí | Incluido SOLO para cotización SMT; aprobación eléctrica/land pendiente |
| C10 | ASSEMBLED_BY_JLC | SMD | sí/sí | Yageo CC0603KRX7R9BB104 / C14663 | 0603; land pendiente | sí/sí | Incluido SOLO para cotización SMT; aprobación eléctrica/land pendiente |
| C11 | ASSEMBLED_BY_JLC | SMD | sí/sí | Samsung CL21A106KAYNNNE / C15850 | 0805; land pendiente | sí/sí | Incluido SOLO para cotización SMT; aprobación eléctrica/land pendiente |
| C12 | ASSEMBLED_BY_JLC | SMD | sí/sí | Yageo CC0603KRX7R9BB104 / C14663 | 0603; land pendiente | sí/sí | Incluido SOLO para cotización SMT; aprobación eléctrica/land pendiente |
| C13 | ASSEMBLED_BY_JLC | SMD | sí/sí | Yageo CC0603KRX7R9BB104 / C14663 | 0603; land pendiente | sí/sí | Incluido SOLO para cotización SMT; aprobación eléctrica/land pendiente |
| C14 | ASSEMBLED_BY_JLC | SMD | sí/sí | Yageo CC0603KRX7R9BB104 / C14663 | 0603; land pendiente | sí/sí | Incluido SOLO para cotización SMT; aprobación eléctrica/land pendiente |
| C15 | ASSEMBLED_BY_JLC | SMD | sí/sí | Yageo CC0603KRX7R9BB104 / C14663 | 0603; land pendiente | sí/sí | Incluido SOLO para cotización SMT; aprobación eléctrica/land pendiente |
| C16 | ASSEMBLED_BY_JLC | SMD | sí/sí | CC0603KRX7R9BB224 / C107083 | 0603; land pendiente | sí/sí | Incluido SOLO para cotización SMT; aprobación eléctrica/land pendiente |
| C17 | ASSEMBLED_BY_JLC | SMD | sí/sí | Fenghua 0603CG102J500NT / C1636 | 0603; land pendiente | sí/sí | Incluido SOLO para cotización SMT; aprobación eléctrica/land pendiente |
| D1 | ASSEMBLED_BY_JLC | SMD | sí/sí | SS34 / C8678 | SMA DO-214AC; land pendiente | sí/sí | Incluido SOLO para cotización SMT; aprobación eléctrica/land pendiente |
| D2 | PENDING | THT | sí/sí | FALTA / FALTA | NO VERIFICADO; land pendiente | no/no | UF4004 DO-41 conservado; candidato US1G SMD no corresponde y NO se solicita |
| J1 | PENDING | THT | sí/sí | FALTA / FALTA | NO VERIFICADO; land pendiente | no/no | THT; MPN final ausente; candidato TB002 no acredita el land Phoenix actual |
| J2 | PENDING | THT | sí/sí | FALTA / FALTA | NO VERIFICADO; land pendiente | no/no | THT; MPN final ausente; candidato TB002 no acredita el land Phoenix actual |
| J3 | PENDING | THT | sí/sí | TBD keyed IDC header 2x5 2.54mm / FALTA | NO VERIFICADO; land pendiente | no/no | THT IDC; MPN/código sin seleccionar; solo interfaz, no una NUCLEO sobre PCB |
| L1 | PENDING | THT | sí/sí | FALTA / FALTA | NO VERIFICADO; land pendiente | no/no | Huella THT provisional; candidato Murata 60B334C es SMD y NO se trasladó su código |
| L2 | PENDING | THT | sí/sí | FALTA / FALTA | NO VERIFICADO; land pendiente | no/no | Huella THT provisional; candidato Murata 60B334C es SMD y NO se trasladó su código |
| Q1 | PENDING | THT | sí/sí | FALTA / FALTA | NO VERIFICADO; land pendiente | no/no | IRFZ44N TO-220 conservado; candidato IRFZ44NS SMD no corresponde y NO se solicita |
| Q2 | ASSEMBLED_BY_JLC | SMD | sí/sí | MMBT3904 / C20526 | SOT-23; land pendiente | sí/sí | Incluido SOLO para cotización SMT; aprobación eléctrica/land pendiente |
| R1 | ASSEMBLED_BY_JLC | SMD | sí/sí | UNI-ROYAL 0805W8F100JT5E / C17415 | 0805; land pendiente | sí/sí | Incluido SOLO para cotización SMT; aprobación eléctrica/land pendiente |
| R2 | ASSEMBLED_BY_JLC | SMD | sí/sí | UNI-ROYAL 0603WAF1002T5E / C25804 | 0603; land pendiente | sí/sí | Incluido SOLO para cotización SMT; aprobación eléctrica/land pendiente |
| R3 | ASSEMBLED_BY_JLC | SMD | sí/sí | UNI-ROYAL 0603WAF1002T5E / C25804 | 0603; land pendiente | sí/sí | Incluido SOLO para cotización SMT; aprobación eléctrica/land pendiente |
| R4 | ASSEMBLED_BY_JLC | SMD | sí/sí | UNI-ROYAL 0603WAF1001T5E / C21190 | 0603; land pendiente | sí/sí | Incluido SOLO para cotización SMT; aprobación eléctrica/land pendiente |
| R5 | ASSEMBLED_BY_JLC | SMD | sí/sí | UNI-ROYAL 0603WAF1002T5E / C25804 | 0603; land pendiente | sí/sí | Incluido SOLO para cotización SMT; aprobación eléctrica/land pendiente |
| R6 | ASSEMBLED_BY_JLC | SMD | sí/sí | UNI-ROYAL 0603WAF1002T5E / C25804 | 0603; land pendiente | sí/sí | Incluido SOLO para cotización SMT; aprobación eléctrica/land pendiente |
| R7 | ASSEMBLED_BY_JLC | SMD | sí/sí | UNI-ROYAL 0603WAF4701T5E / C23162 | 0603; land pendiente | sí/sí | Incluido SOLO para cotización SMT; aprobación eléctrica/land pendiente |
| R8 | ASSEMBLED_BY_JLC | SMD | sí/sí | UNI-ROYAL 0603WAF1502T5E / C22809 | 0603; land pendiente | sí/sí | Incluido SOLO para cotización SMT; aprobación eléctrica/land pendiente |
| R9 | ASSEMBLED_BY_JLC | SMD | sí/sí | UNI-ROYAL 0603WAF1002T5E / C25804 | 0603; land pendiente | sí/sí | Incluido SOLO para cotización SMT; aprobación eléctrica/land pendiente |
| R10 | ASSEMBLED_BY_JLC | SMD | sí/sí | CRCW060330K9FKEA / C844354 | 0603; land pendiente | sí/sí | Incluido SOLO para cotización SMT; aprobación eléctrica/land pendiente |
| R11 | ASSEMBLED_BY_JLC | SMD | sí/sí | UNI-ROYAL 0603WAF1002T5E / C25804 | 0603; land pendiente | sí/sí | Incluido SOLO para cotización SMT; aprobación eléctrica/land pendiente |
| R12 | ASSEMBLED_BY_JLC | SMD | sí/sí | UNI-ROYAL 0603WAF1002T5E / C25804 | 0603; land pendiente | sí/sí | Incluido SOLO para cotización SMT; aprobación eléctrica/land pendiente |
| R13 | ASSEMBLED_BY_JLC | SMD | sí/sí | UNI-ROYAL 0603WAF1002T5E / C25804 | 0603; land pendiente | sí/sí | Incluido SOLO para cotización SMT; aprobación eléctrica/land pendiente |
| R14 | ASSEMBLED_BY_JLC | SMD | sí/sí | 0603WAF1502T5E / C22809 | 0603; land pendiente | sí/sí | Incluido SOLO para cotización SMT; aprobación eléctrica/land pendiente |
| R15 | ASSEMBLED_BY_JLC | SMD | sí/sí | 0603WAF2201T5E / C4190 | 0603; land pendiente | sí/sí | Incluido SOLO para cotización SMT; aprobación eléctrica/land pendiente |
| RS1 | ASSEMBLED_BY_JLC | SMD | sí/sí | TA-I RLP25FEER050 / C160588 | 2512; land pendiente | sí/sí | Incluido SOLO para cotización SMT; aprobación eléctrica/land pendiente |
| TP1 | NOT_FITTED | THT | sí/sí | FALTA / FALTA | NO VERIFICADO; land pendiente | no/no | Pad de prueba desnudo; sin pieza física adicional; no es una orden DNP del esquemático |
| TP2 | NOT_FITTED | THT | sí/sí | FALTA / FALTA | NO VERIFICADO; land pendiente | no/no | Pad de prueba desnudo; sin pieza física adicional; no es una orden DNP del esquemático |
| TP3 | NOT_FITTED | THT | sí/sí | FALTA / FALTA | NO VERIFICADO; land pendiente | no/no | Pad de prueba desnudo; sin pieza física adicional; no es una orden DNP del esquemático |
| TP4 | NOT_FITTED | THT | sí/sí | FALTA / FALTA | NO VERIFICADO; land pendiente | no/no | Pad de prueba desnudo; sin pieza física adicional; no es una orden DNP del esquemático |
| TP5 | NOT_FITTED | THT | sí/sí | FALTA / FALTA | NO VERIFICADO; land pendiente | no/no | Pad de prueba desnudo; sin pieza física adicional; no es una orden DNP del esquemático |
| TP6 | NOT_FITTED | THT | sí/sí | FALTA / FALTA | NO VERIFICADO; land pendiente | no/no | Pad de prueba desnudo; sin pieza física adicional; no es una orden DNP del esquemático |
| TP7 | NOT_FITTED | THT | sí/sí | FALTA / FALTA | NO VERIFICADO; land pendiente | no/no | Pad de prueba desnudo; sin pieza física adicional; no es una orden DNP del esquemático |
| TP8 | NOT_FITTED | THT | sí/sí | FALTA / FALTA | NO VERIFICADO; land pendiente | no/no | Pad de prueba desnudo; sin pieza física adicional; no es una orden DNP del esquemático |
| TP9 | NOT_FITTED | THT | sí/sí | FALTA / FALTA | NO VERIFICADO; land pendiente | no/no | Pad de prueba desnudo; sin pieza física adicional; no es una orden DNP del esquemático |
| U1 | ASSEMBLED_BY_JLC | SMD | sí/sí | IR2110STRPBF / C2968 | SOIC-16 300mil; land pendiente | sí/sí | Incluido SOLO para cotización SMT; aprobación eléctrica/land pendiente |
| U2 | ASSEMBLED_BY_JLC | SMD | sí/sí | 78M05 / C347278 | TO-252; land pendiente | sí/sí | Incluido SOLO para cotización SMT; aprobación eléctrica/land pendiente |
| U3 | ASSEMBLED_BY_JLC | SMD | sí/sí | SN74HCT14DR / C6769 | SOIC-14; land pendiente | sí/sí | Incluido SOLO para cotización SMT; aprobación eléctrica/land pendiente |
| U4 | ASSEMBLED_BY_JLC | SMD | sí/sí | SN74HCT00DR / C6764 | SOIC-14; land pendiente | sí/sí | Incluido SOLO para cotización SMT; aprobación eléctrica/land pendiente |
| U5 | ASSEMBLED_BY_JLC | SMD | sí/sí | LM393BIDR / C2865059 | SOIC-8; land pendiente | sí/sí | Incluido SOLO para cotización SMT; aprobación eléctrica/land pendiente |
| U6 | ASSEMBLED_BY_JLC | SMD | sí/sí | INA180A1IDBVR / C122228 | SOT-23-5; land pendiente | sí/sí | Incluido SOLO para cotización SMT; aprobación eléctrica/land pendiente |

## Elementos externos

| Elemento | Estado | PCB/BOM/CPL |
|---|---|---|
| NUCLEO-L432KC | EXTERNAL_COMPONENT | Fuera de PCB; no se exporta como J3 ni se inventa posición |
| Carga externa 6 Ω | EXTERNAL_COMPONENT | Fuera de PCB; sin designator o posición inventados |

Montaje manual confirmado: 0; **7 THT pendientes**, previsiblemente de compra/soldadura manual u otra modalidad JLC que debe cotizarse aparte. J1/J2/J3, Q1, D2 y L1/L2 no desaparecen: quedan explícitos fuera de la BOM/CPL SMT. No se puede obtener el costo del conjunto completo con solo estas 41 colocaciones.

Stock PCBA para TODOS los componentes: **NO VERIFICADA**. Las páginas públicas confirman identidad/encapsulado; sus cifras indexadas o de venta LCSC no garantizan stock de ensamblaje para la fecha, cantidad y modalidad del pedido.

## Fuentes comerciales consultadas

| Código | MPN de catálogo | Encapsulado | Fuente |
|---|---|---|---|
| C136279 | 25SVPF100M | SMD D8x6.9mm | [JLC/LCSC](https://jlcpcb.com/partdetail/PANASONIC-25SVPF100M/C136279) |
| C454354 | 50SVF10M | SMD D6.3x5.9mm | [JLC/LCSC](https://lcsc.com/product-detail/Solid-Polymer-Electrolytic-Capacitor_PANASONIC-50SVF10M_C454354.html) |
| C14663 | CC0603KRX7R9BB104 | 0603 | [JLC/LCSC](https://jlcpcb.com/partdetail/C14663) |
| C8678 | SS34 | SMA DO-214AC | [JLC/LCSC](https://jlcpcb.com/partdetail/C8678) |
| C160588 | RLP25FEER050 | 2512 | [JLC/LCSC](https://jlcpcb.com/partdetail/ta_iTech-RLP25FEER050/C160588) |
| C50254 | CL31B225KBHNNNE | 1206 | [JLC/LCSC](https://jlcpcb.com/partdetail/C50254) |
| C73142 | CL21B334KBFNNNE | 0805 | [JLC/LCSC](https://jlcpcb.com/partdetail/74255-CL21B334KBFNNNE/C73142) |
| C15850 | CL21A106KAYNNNE | 0805 | [JLC/LCSC](https://jlcpcb.com/partdetail/C15850) |
| C17415 | 0805W8F100JT5E | 0805 | [JLC/LCSC](https://jlcpcb.com/partdetail/0805W8F100JT5E/C17415) |
| C25804 | 0603WAF1002T5E | 0603 | [JLC/LCSC](https://jlcpcb.com/partdetail/C25804) |
| C21190 | 0603WAF1001T5E | 0603 | [JLC/LCSC](https://jlcpcb.com/partdetail/C21190) |
| C2968 | IR2110STRPBF | SOIC-16 300mil | [JLC/LCSC](https://jlcpcb.com/partdetail/IR2110STRPBF/C2968) |
| C347278 | 78M05 | TO-252 | [JLC/LCSC](https://jlcpcb.com/partdetail/78M05/C347278) |
| C6769 | SN74HCT14DR | SOIC-14 | [JLC/LCSC](https://www.lcsc.com/product-detail/C6769.html) |
| C107083 | CC0603KRX7R9BB224 | 0603 | [JLC/LCSC](https://jlcpcb.com/partdetail/YAGEO-CC0603KRX7R9BB224/C107083) |
| C20526 | MMBT3904 | SOT-23 | [JLC/LCSC](https://jlcpcb.com/partdetail/21237-MMBT3904/C20526) |
| C23162 | 0603WAF4701T5E | 0603 | [JLC/LCSC](https://jlcpcb.com/partdetail/C23162) |
| C22809 | 0603WAF1502T5E | 0603 | [JLC/LCSC](https://jlcpcb.com/partdetail/0603WAF1502T5E/C22809) |
| C844354 | CRCW060330K9FKEA | 0603 | [JLC/LCSC](https://jlcpcb.com/partdetail/VishayIntertech-CRCW060330K9FKEA/C844354) |
| C6764 | SN74HCT00DR | SOIC-14 | [JLC/LCSC](https://www.lcsc.com/product-detail/C6764.html) |
| C2865059 | LM393BIDR | SOIC-8 | [JLC/LCSC](https://www.lcsc.com/product-detail/C2865059.html) |
| C122228 | INA180A1IDBVR | SOT-23-5 | [JLC/LCSC](https://jlcpcb.com/partdetail/INA180A1IDBVR/C122228) |
| C1636 | 0603CG102J500NT | 0603 | [JLC/LCSC](https://jlcpcb.com/partdetail/1988-0603CG102J500NT/C1636) |
| C4190 | 0603WAF2201T5E | 0603 | [JLC/LCSC](https://jlcpcb.com/partdetail/C4190) |

La comparación automatizada verifica familia de huella y MPN/código de esta tabla. No acredita al 100% las dimensiones del land. C1/C2/C4/C5 y RS1 mantienen calificación mecánica pendiente; U5 carece de courtyard. Q2 C20526 corresponde al rango comercial 100–300 indicado en catálogo; confirmar ese detalle al reconocerlo. C4/C5: CAD dice 35 V, candidato seleccionado 50 V; RS1: CAD dice 1 W, catálogo 2 W. Se conservó el diseño y se documentan estas diferencias.
