almondsun/DynamicSystemsAndControl/project/pcb/release/report-assets/wiring.png

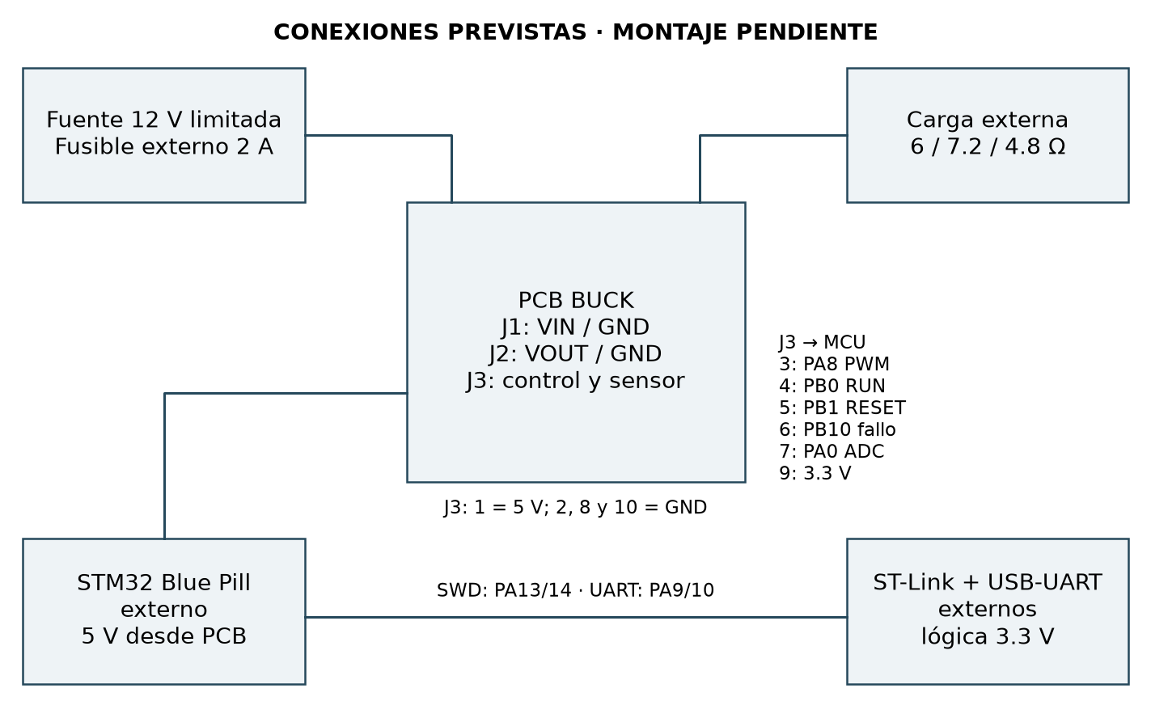
project/pcb/release/report-assets/wiring.png
