almondsun/DynamicSystemsAndControl/project/results/circuit/convergence/cycle_means.csv

time_s | voltage_cycle_mean_V
5.000000000000000240e-05 | 1.757883338685793939e-01
1.500000000000000140e-04 | 2.311752411905156901e+00
2.500000000000000052e-04 | 4.865273166394777249e+00
3.500000000000000507e-04 | 6.354185671896977361e+00
4.500000000000000419e-04 | 6.668637393848930728e+00
5.500000000000000331e-04 | 6.332202306606215636e+00
6.500000000000000786e-04 | 5.883050119599896988e+00
7.500000000000000156e-04 | 5.604211242530862336e+00
8.500000000000000611e-04 | 5.533018268764600123e+00
9.500000000000001065e-04 | 5.584409796558098549e+00
1.049999999999999935e-03 | 5.662821569466834681e+00
1.149999999999999981e-03 | 5.714617868580037729e+00
1.250000000000000026e-03 | 5.729982526189585812e+00
1.350000000000000071e-03 | 5.722430553835380351e+00
1.449999999999999900e-03 | 5.708826748309185461e+00
1.549999999999999946e-03 | 5.699249292891710894e+00
1.649999999999999991e-03 | 5.696033731511836784e+00
1.750000000000000036e-03 | 5.697090188468492578e+00
1.850000000000000082e-03 | 5.699440506801972006e+00
1.949999999999999910e-03 | 5.701184398631490069e+00
2.050000000000000173e-03 | 5.701829267562418480e+00
2.150000000000000435e-03 | 5.701705045310159647e+00
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
