almondsun/DynamicSystemsAndControl/project/results/circuit/open_up/cycle_means.csv

time_s | voltage_cycle_mean_V
5.000000000000000240e-05 | 1.757878995497148822e-01
1.500000000000000140e-04 | 2.311725787528993159e+00
2.500000000000000052e-04 | 4.865221117474801460e+00
3.500000000000000507e-04 | 6.354151299481132220e+00
4.500000000000000419e-04 | 6.668624317755827313e+00
5.500000000000000331e-04 | 6.332200589304276761e+00
6.500000000000000786e-04 | 5.883051667914217298e+00
7.500000000000000156e-04 | 5.604199057239835469e+00
8.500000000000000611e-04 | 5.532974564725185118e+00
9.500000000000001065e-04 | 5.584392386667304642e+00
1.049999999999999935e-03 | 5.662905455526105136e+00
1.149999999999999981e-03 | 5.715013873974625014e+00
1.250000000000000026e-03 | 5.730358715726407759e+00
1.350000000000000071e-03 | 5.722650676392428970e+00
1.449999999999999900e-03 | 5.708891222200229265e+00
1.549999999999999946e-03 | 5.699224455594977812e+00
1.649999999999999991e-03 | 5.696105288636246655e+00
1.750000000000000036e-03 | 5.697753280551903998e+00
1.850000000000000082e-03 | 5.700157393880179058e+00
1.949999999999999910e-03 | 5.701694206357455386e+00
2.050000000000000173e-03 | 5.702053637571449229e+00
2.150000000000000435e-03 | 5.701742325286748070e+00
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
