almondsun/DynamicSystemsAndControl/project/results/circuit/ref_down/cycle_means.csv

time_s | voltage_cycle_mean_V
5.000000000000000240e-05 | 4.051275500728711565e-01
1.500000000000000140e-04 | 3.388332767324298000e+00
2.500000000000000052e-04 | 6.457570182155536465e+00
3.500000000000000507e-04 | 7.682814397518505700e+00
4.500000000000000419e-04 | 7.312314831626031797e+00
5.500000000000000331e-04 | 6.432951609860147357e+00
6.500000000000000786e-04 | 5.850444670699194383e+00
7.500000000000000156e-04 | 5.752077471566536815e+00
8.500000000000000611e-04 | 5.929085289978641704e+00
9.500000000000001065e-04 | 6.118824314439805789e+00
1.049999999999999935e-03 | 6.194006521479311189e+00
1.149999999999999981e-03 | 6.166679414424860006e+00
1.250000000000000026e-03 | 6.105114605617217194e+00
1.350000000000000071e-03 | 6.061624976882564297e+00
1.449999999999999900e-03 | 6.049346381447242571e+00
1.549999999999999946e-03 | 6.055514934196152055e+00
1.649999999999999991e-03 | 6.063298423688786798e+00
1.750000000000000036e-03 | 6.064279429998289395e+00
1.850000000000000082e-03 | 6.058949520031022828e+00
1.949999999999999910e-03 | 6.051619923275741719e+00
2.050000000000000173e-03 | 6.045742505506653153e+00
2.150000000000000435e-03 | 6.041828543513569905e+00
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
