almondsun/DynamicSystemsAndControl/project/results/simulation/load_down.png

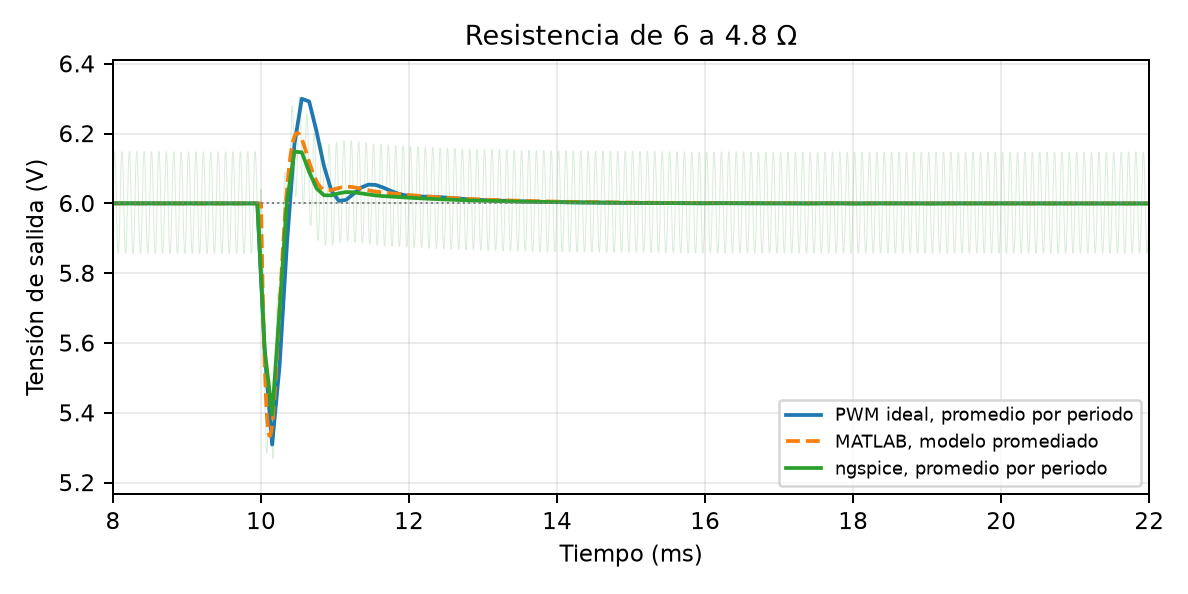
project/results/simulation/load_down.png
