almondsun/DynamicSystemsAndControl/project/results/simulation/load_up.png

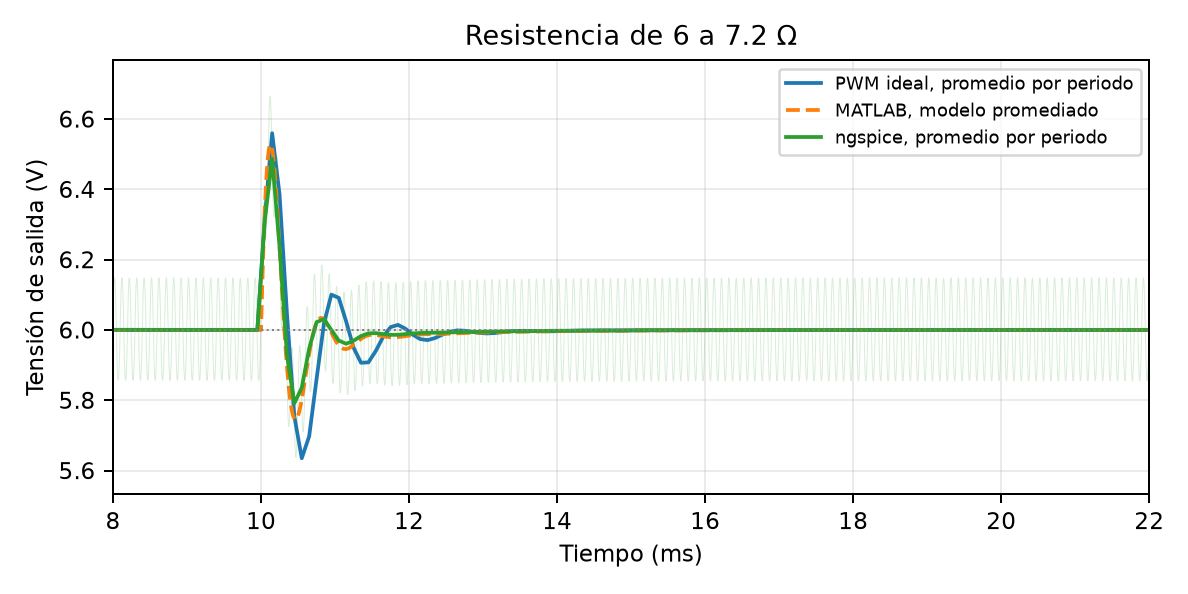
project/results/simulation/load_up.png
