almondsun/DynamicSystemsAndControl/project/results/simulation/open_down.png

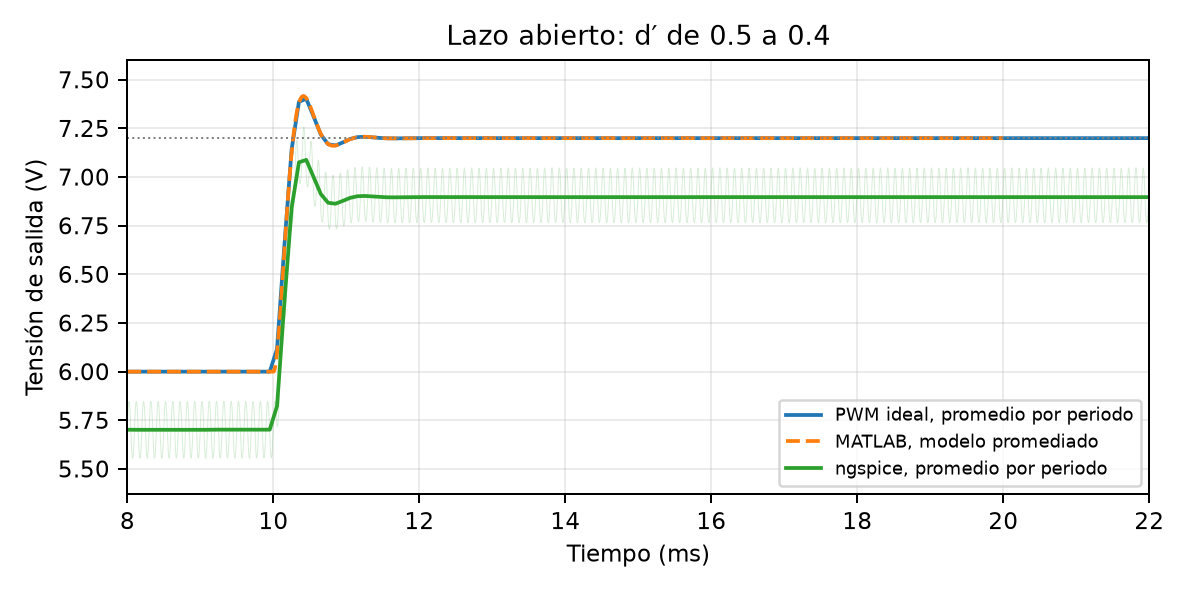
project/results/simulation/open_down.png
