almondsun/DynamicSystemsAndControl/project/results/simulation/open_up.png

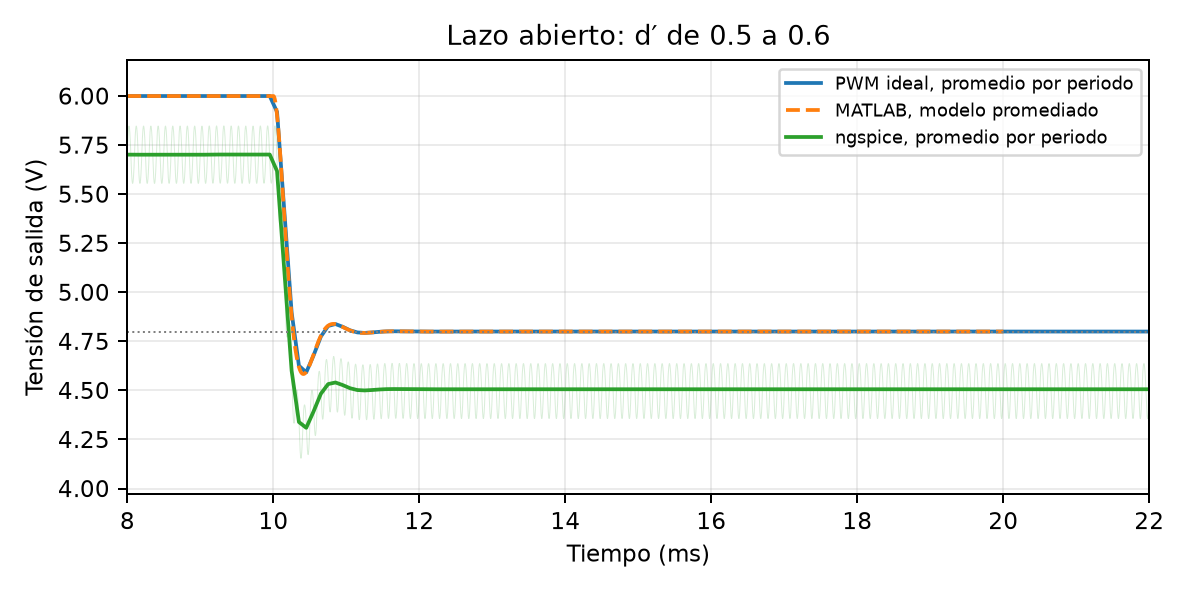
project/results/simulation/open_up.png
