almondsun/DynamicSystemsAndControl/project/results/simulation/ref_down.png

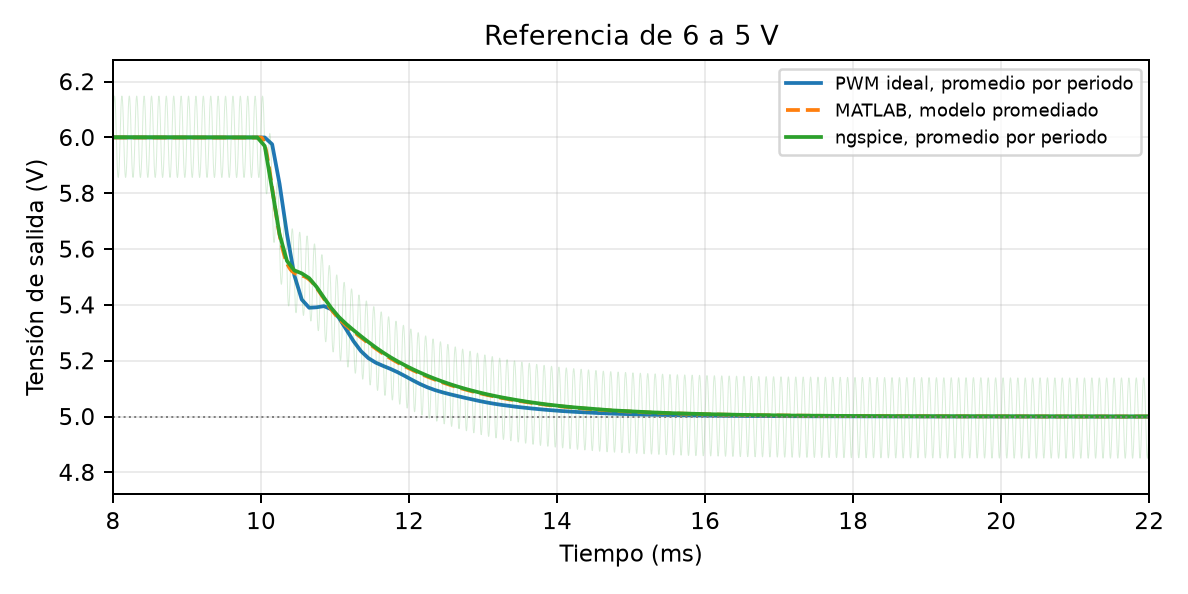
project/results/simulation/ref_down.png
