almondsun/DynamicSystemsAndControl/project/results/simulation/ref_up.png

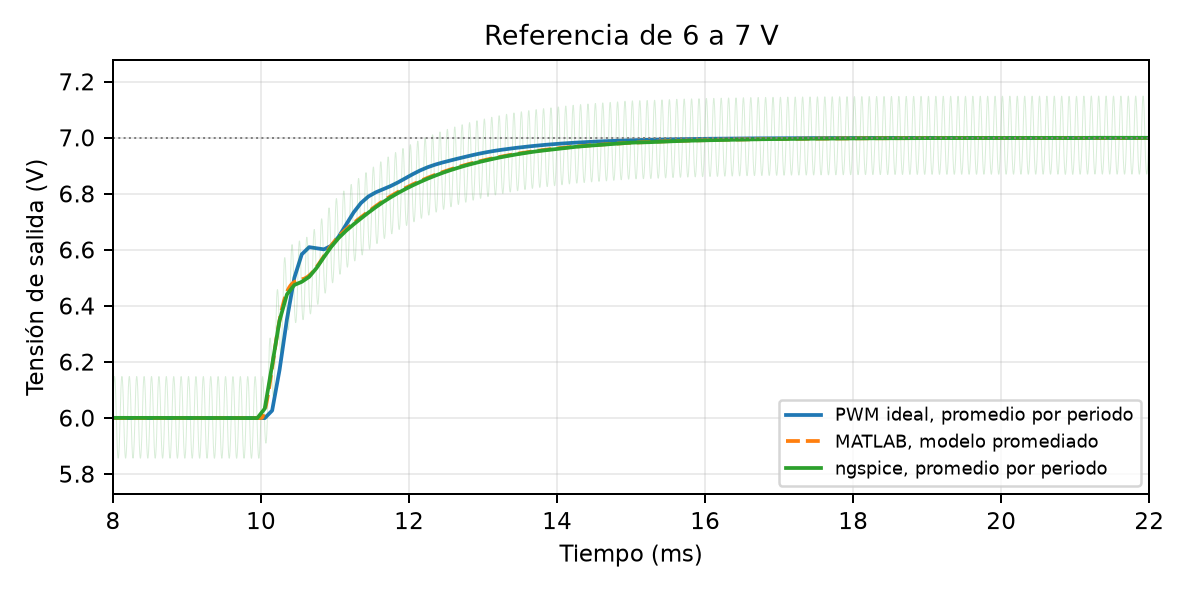
project/results/simulation/ref_up.png
