almondsun/DynamicSystemsAndControl/project/pcb/audit/open_issues.md

# Bloqueos antes de cambiar el esquemático o fabricar

Fecha: 2026-10-24. **35 pasivos inventariados; ninguno liberado aquí para fabricación.** Las especificaciones calculadas y alternativas permiten revisar la selección. No implican validación física. [Requisitos](passives_requirements.md) · [Comportamiento/pruebas](expected_behavior.md) · [Candidatos](jlc_passives_candidates.md) · [Datasheets](datasheet_compliance.md).

Cada casilla permanece abierta hasta obtener la evidencia indicada. **CRÍTICO** impide energizar en la condición afectada o aprobar selección/rediseño; **MAYOR** impide liberación de fabricación; **MENOR** afecta documentación/optimización y no sustituye requisitos eléctricos.

## CRÍTICO

- [ ] **C-01 — Fuente eléctrica de verdad y MPN de IC.** BOM/design.py describen THT; biblioteca local contiene valoresSMD y el Excel solo candidatos. U1 DIP14 y SOIC16 no comparten mapa por número; Q2 cambia asignación respecto al TO92. **Cierre:** aprobar tablaMPN/fabricante/revisión/encapsulado, revisar pines contra datasheet y conciliar esquema/netlist sin ejecutar generadores destructivos. No afirmar equivalencias por nombre de familia.
- [ ] **C-02 — Bootstrap y gate.** R2 consume hasta 1.333 mA y eleva presupuestoQ a≈0.259 µC/95 µs. UnaC6 nominal1 µF no garantiza1 µF efectiva. A12 V falta verificar VGS≥10 V; a 10.8 V el margen es más estrecho. **Cierre:** ficha exactaMOSFET/D2, curvasDCbias/fugas/Qg, impedancia de recarga y capturasVBS/VGS en arranque/carga/duty; mantener VIN12 V como alcance inicial. No habilitarD0.95 hasta justificarlo.
- [ ] **C-03 — Sobretensión tras retirar carga/energía del inductor.** ApagarQ1 no absorbe energía. Ejemplo sin pérdidasL660 µH/I2.5 A/C16 µF/V0=6 V entrega≈17.14 V; no es máximo garantizado. **Cierre:** modelo temporal con límites reales, ensayo con limitación y carga protegida, definir energía admisible y eventual clamp/dump. OVP8.2 V no es un techo garantizado.
- [ ] **C-04 — ADC y alimentación parcial.** Divisor1/4 puede entregar3.35 V a VOUT13.2 V con tolerancias, y mucho más por energía de L; pull-up5 V puede inyectar corriente por PWM en MCU apagado. **Cierre:** identificar STM32F103 exacto/clon y sus pines/rangos/inyección/VDDA, calcular y aprobar clamp/secuencia. No ensayar OVP por fuente externa sin resolver retornos y protecciónADC.
- [ ] **C-05 — Protección dinámica y saturación.** Intervalos estáticosOCP1.825–2.184 A no acotan el pico posterior. Objetivo10 µs/2.5 A es propio, no garantía. **Cierre:** curvasL(I, T) y mínimo efectivo≥528 µH, medición de retardo completoINA/comparador/latch/driver, prueba controlada de falla persistente y límites térmicos. No cerrar con un número comercialIsat sin definición.
- [ ] **C-06 — Arranque, latch y ausencia de PWM.** RUN bajo y pull-upPWM son razonables con rieles válidos; no garantizan estado durante rampas/brownout. PWM fijo bajo puede ordenar encendido continuo hasta perder bootstrap. **Cierre:** tabla de estados de conexiones reales y capturas desde 0 V, reset con falla persistente, desconexión parcial/completaMCU y watchdog aplicable. No considerar UVLO sustituto de un estado seguro demostrado.

## MAYOR

- [ ] **M-01 — Sustituir o justificarC1/C2 preliminares.** EMZR100 µF/25 V de 300 mA a 100 kHz insuficiente: banco ideal0.600 A frente a 0.632 A del escalón obligatorio, sin margen ni corrección a 10 kHz. **Cierre:** escoger polímero/electrolítico con≥0.60 A por pieza a 10 kHz y temperatura de uso, C efectiva/ESR/vida y reparto demostrados. PanasonicSVPF/SVF son alternativas documentadas, no compra aprobada.
- [ ] **M-02 — C4/C5 y control.** BXJ catalogado800 mΩ por pieza/Wave no cumple ESR propuesto y reflow no demostrado. **Cierre:** garantizar C efectiva≥16 µF/ESR banco≤0.15 Ω a 10 kHz o revisar abiertamente esos objetivos; confirmar tecnología, montaje y efecto en amortiguamiento/PI. Un MLCC10 µF nominal no resuelve esto por sí solo.
- [ ] **M-03 — Inductores.** XR carece de ficha primaria completa/DCR/núcleo. MurataSMD tiene catálogo adecuado preliminar, pero faltan ficha completa/Isat y land; SRR1260-331K/681K no cumplen. **Cierre:** ensayo y datos de RDC/L(I, T)/núcleo/ΔT, confirmar acoplamiento entre dos bobinas y comparar con 680 µH única. Si no existeSMD adecuado, conservar THT con justificación.
- [ ] **M-04 — Potencia útil del shunt.** TA-I2 W condicionados a 300 mm² y cobre105 µm; cobre real no confirmado. **Cierre:** especificación de fabricación y cálculo/ensayo térmico según montaje, conexionesKelvin, potencia útil≥1 W recomendada a temperatura y error de cobre/TCR. AlternativaWSL1 W: usar TCR75 ppm/°C de componente documentado y cerrarland/derating.
- [ ] **M-05 — Calor en 78M05.** Ejemplo100 mA:≈0.772 W a 12 V y≈0.899 W a 13.2 V incluyendoIQ. RθJC no demuestraRθJA. **Cierre:** consumo5 V medido incluidoMCU, corriente mínima, cobre/vías y Tj estimada con condiciones reales; ensayoT y estabilidad con C10/C11. No sustituir resultados de ST7805 por UMW automáticamente.
- [ ] **M-06 — CurvasDCbias y edad de MLCC.** C6/C11/C16 y reservaC18 dependen de C efectiva; X5R/X7R y tolerancia no bastan. **Cierre:** curvas de MPN/condiciones de entrega o mediciones bajoDC/T, con envejecimiento. Justificar propuestasC6A/B, C18 y 220 nF en C16 antes de tocar circuito.
- [ ] **M-07 — Umbrales con temperatura y bias.** VREF comparte error de U2; R±1% no define umbrales exactos. LM393B offset documentado con VS≥5 V no cubre por sí solo 4.75 V; INAoffset depende de condiciones. **Cierre:** presupuesto por temperatura/ganancia/offset/bias/cobre y margen frente a rizado/escalones; caracterización de umbrales. Revisar comunes sin ignorar la notaTI de una entrada válida.
- [ ] **M-08 — R1 por pulso y estado comercial.** Potencia media≈13.2 mW no valida pico≈17.6 W. ERJ-P6W investigada está marcada no recomendada para diseños nuevos. **Cierre:** sucesor con MPN/código/curva repetitiva, duración de pulso real, ringing y pérdidas medidas; no aprobar 0805 genérica por potenciaDC.
- [ ] **M-09 — R10 exacta y precisión de divisores.** No se cerró31 kΩ de una pieza; 30 kΩ+1 kΩ es propuesta de cambio futuro. 31.6 kΩ alteraOVP. **Cierre:** aprobar MPN exacto o dos referencias, calcular tolerancias/TCR; decidir siADC/divisores requieren0.1% o calibración para error medio20 mV propuesto.
- [ ] **M-10 — R14 bajo transitorio.** El presupuesto continuo13.2 V da≈33.4 mW; el pulso ilustrativo20 V da≈76.5 mW, sin margen2× en 0603/0.1 W caliente. **Cierre:** energía/duración real, curva de pulso o candidato≥0.25 W y límitesADC resueltos; aún no se cerróMPN para esa variante.
- [ ] **M-11 — Huellas y polaridad.** Ocho huellasKiCad inspeccionadas solo como candidatas; cuerpo/pads no demuestran land/termal correctos. **Cierre:** cotejo pad a terminal, dimensiones/tolerancias, polaridad de polímeros y perfilreflow, área de cobre y capacidad real de montajeJLC; conservar revisión firmada por MPN. No registrar huellas descargadas automáticamente.
- [ ] **M-12 — Inventario comercial actual.** Stock/precio vigente NO VERIFICADOS; algunas páginas cacheadas se contradicen. 50SVPF10M y 60B684C sin código exacto; 50SVF10M con asociación indexada pendiente. **Cierre:** consulta JLC/LCSC de lote/cantidad/clase/MPN/encapsulado al cotizar. Confirmar que la pieza está disponible para PCBA, no solo ventaLCSC.
- [ ] **M-13 — Validación dinámica nueva.** Resultados archivadosTHT no pruebanSMD. No hubo simulación temporal nueva ni hardware. **Cierre:** repetir modelo aislado con pérdidas/curvas definitivas, condiciones iniciales y convergencia; ensayar seis escalones, rizado, protecciones y térmica. Separar mediasPWM de rizado y de ruidoHF.

## MENOR y limitaciones de acceso

- [ ] **N-01 — Completar referencias documentales exactas.** Conservar ficha de D2ShunYe, revisión finalUMWMOSFET y curvas de los pasivos conhash/fecha. Algunos fabricantes solo ofrecieron portal; enlaces directos fallaron o dieron404. No se sustituyeron por fichas de otros fabricantes.
- [ ] **N-02 — Acordar límites propuestos.** Rizado≤0.65 Vpp, eficiencia deetapa objetivo≥85%, tiempos/error y márgenes térmicos son criterios propios. **Cierre:** aceptación del equipo y protocolo con incertidumbre; no atribuirlos a la guía del curso.
- [ ] **N-03 — Exportación de netlist actual.** KiCadCLI falló por acceso a configuración/AppData/Documentos. No se obtuvo netlist nueva ni se repitieronERC/DRC. La auditoría usó lectura estática y`design.py`; resultados históricos de VALIDATION.md son históricos. **Cierre:** exportación en entorno con configuración accesible durante la futura revisión eléctrica; no requiere reescribir esquemas con generadores.
- [ ] **N-04 — Simulación/MATLAB.** No hay herramientas MATLAB MCP expuestas en esta sesión. Solo se ejecutaron cálculos algebraicosPython aislados y comprobaciones de coherencia; no se reclama simulación nueva ni medición física. **Cierre:** cuando se haga simulación, registrar solver, paso, parámetros, condiciones iniciales y convergencia.

## Decisiones humanas antes de la fase siguiente

1. Aprobar los MPN de los IC y la fuente eléctrica conciliada, y decidir alcanceVIN12 V o extensión±10%.
2. Aceptar límites de rizado/transitorios y presupuesto de protección; definir tratamiento de energía de L y protecciónADC.
3. Elegir dos bobinas frente auna de 680 µH, materiales de CIN/COUT y cobre/térmica del shunt/regulador.
4. Aprobar solo entonces cambios propuestosC6A/B, C18, C16, R10A/B y eventual protección adicional; esta auditoría no los incorpora.

La fase documental queda entregada para revisión. La selección comercial definitiva y la liberación física siguen abiertas en las casillas anteriores. No continuar automáticamente a modificarPCB/esquemático.
