almondsun/DynamicSystemsAndControl/project/pcb/release/assembly.pdf

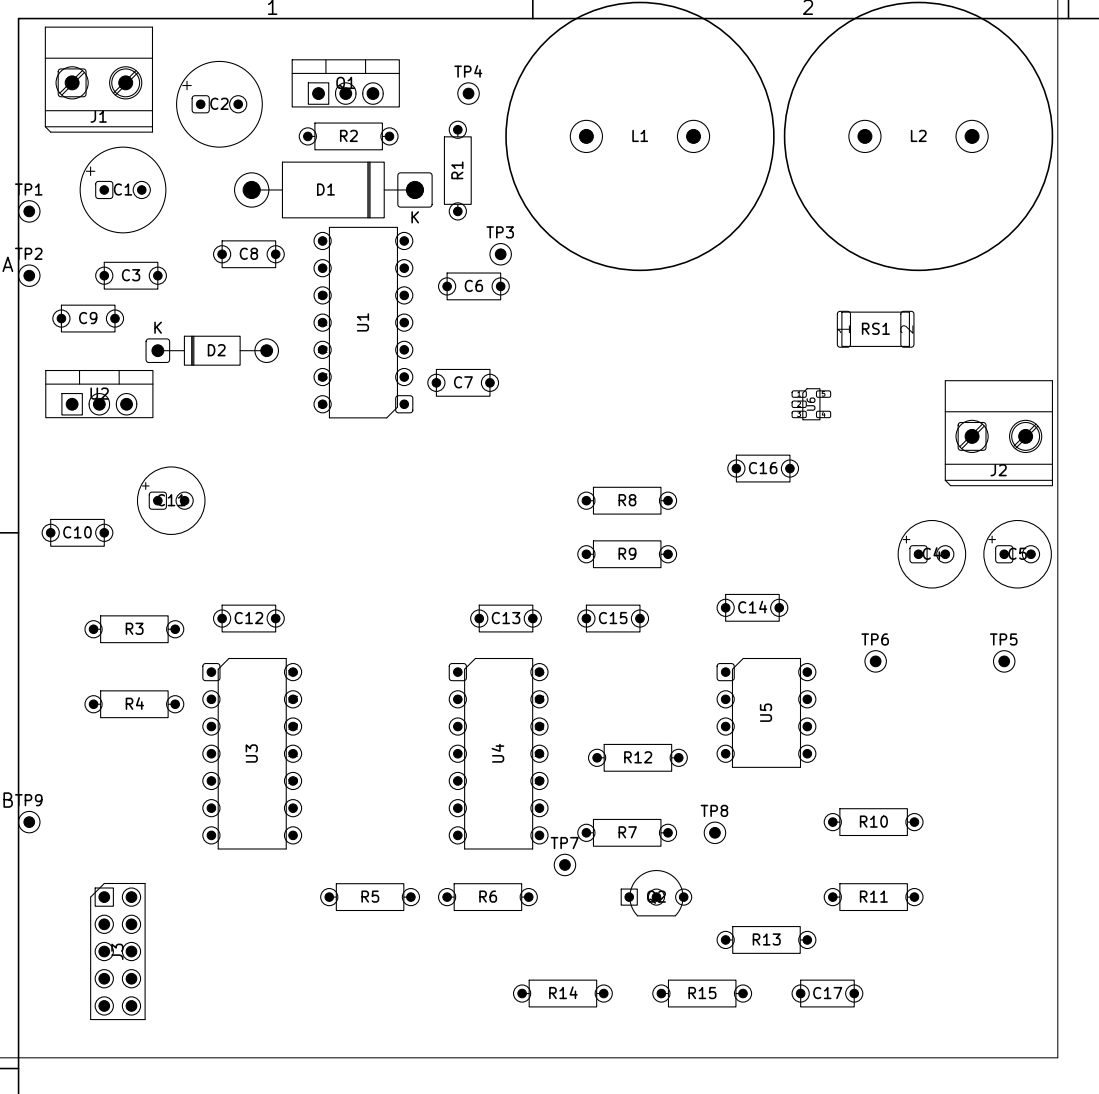
[picture p120: page 1]

File: buck.kicad_pcb
Title: BUCK REV A - FABRICATION ON HOLD

Size: A4 | Rev: A
KiCad E.D.A. 10.0.6 | Id: 1/1
