almondsun/DynamicSystemsAndControl/project/pcb/release/schematic.pdf

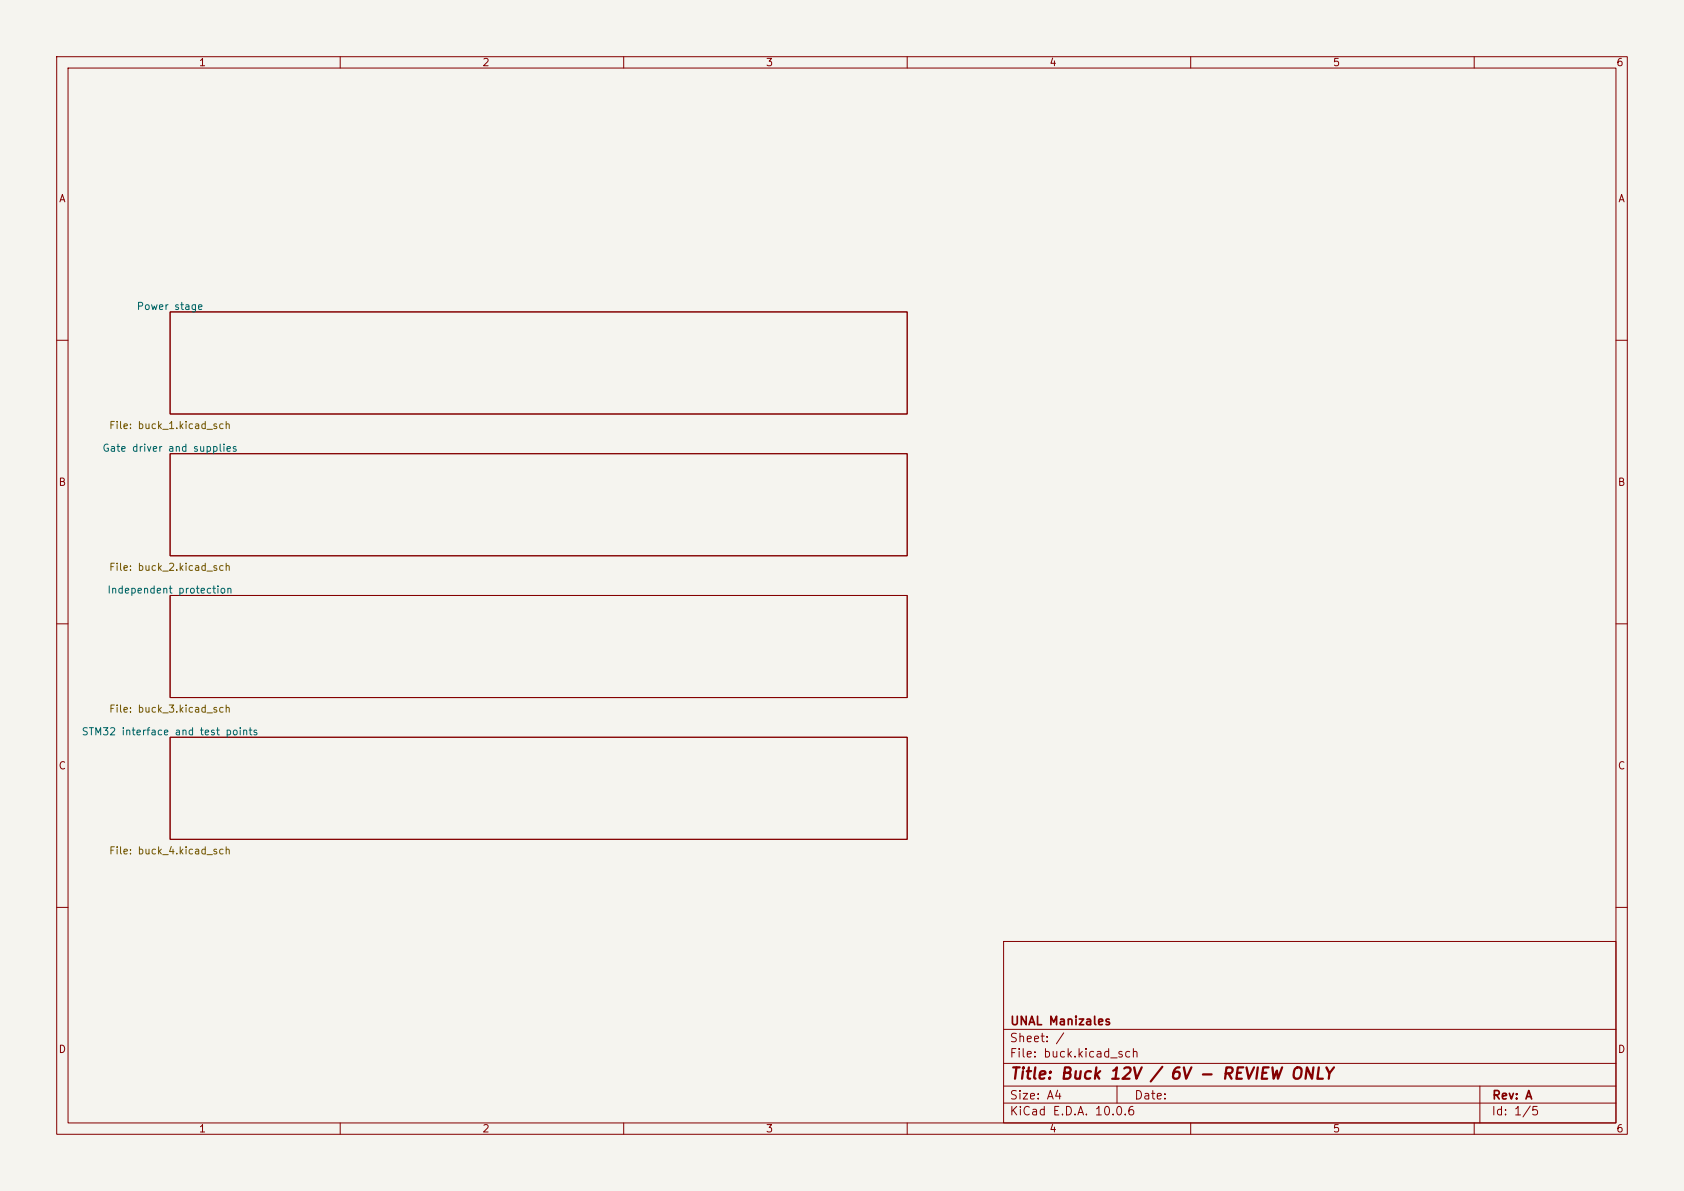
[picture p121: page 1]

File: buck_1.kicad_sch Gate driver and supplies File: buck_2.kicad_sch

File: buck_3.kicad_sch STM32 interface and test points File: buck_4.kicad_sch

UNAL Manizales
Sheet: /
File: buck.kicad_sch
Title: Buck 12V / 6V - REVIEW ONLY

Size: A4 | Rev: A
KiCad E.D.A. 10.0.6 | Id: 1/5

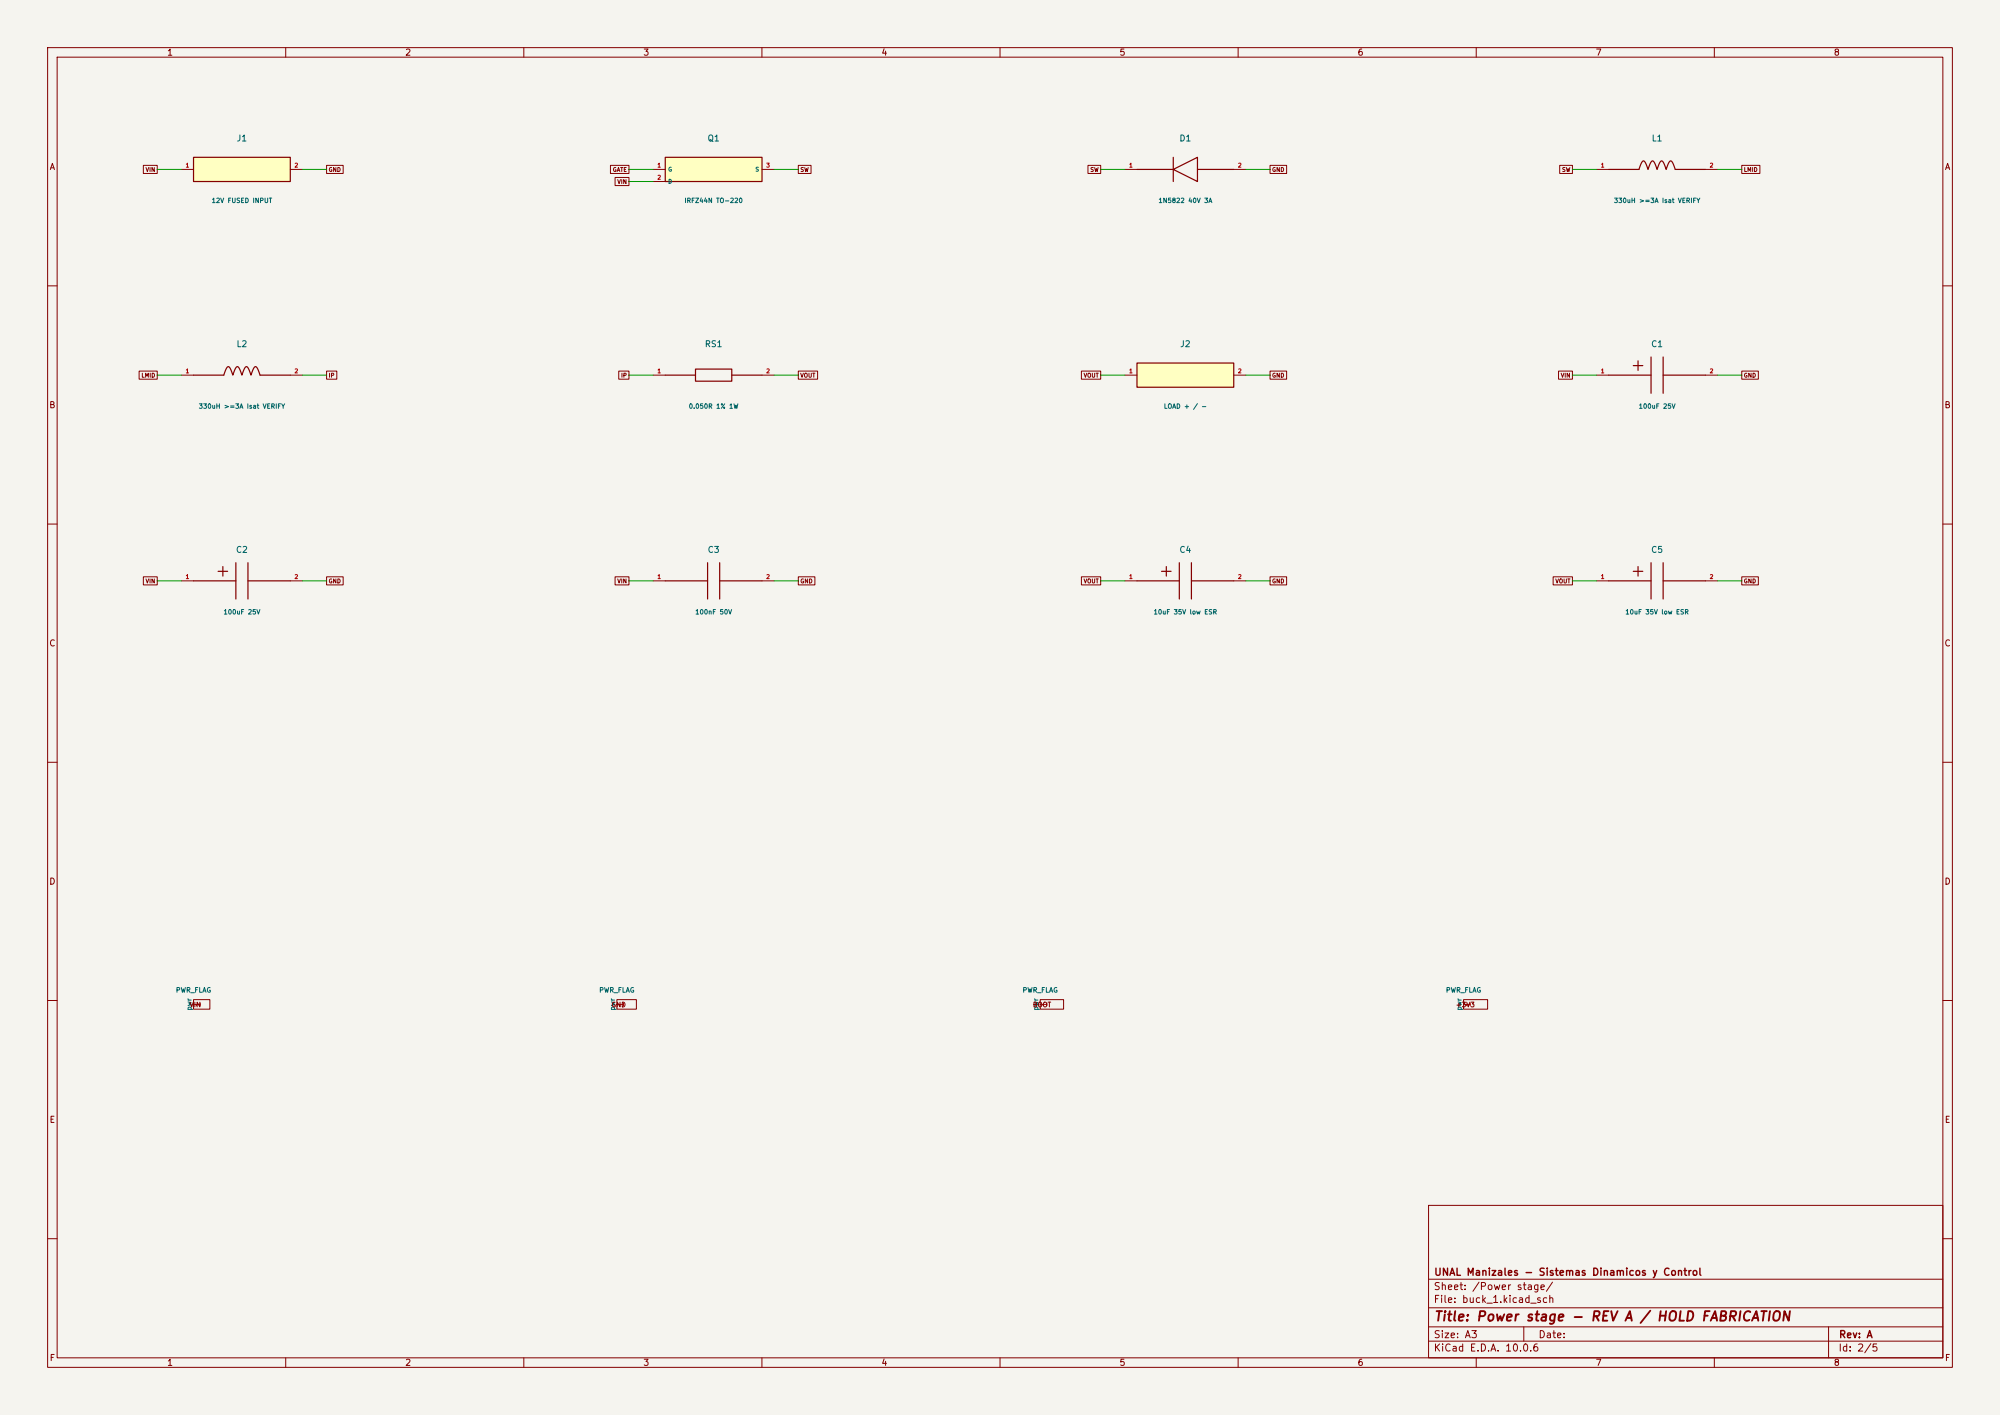
[picture p122: page 2]

UNAL Manizales - Sistemas Dinamicos y Control pwr 1 PWR_FLAG pwr 1 PWR_FLAG

Sheet: /Power stage/
File: buck_1.kicad_sch
Title: Power stage - REV A / HOLD FABRICATION

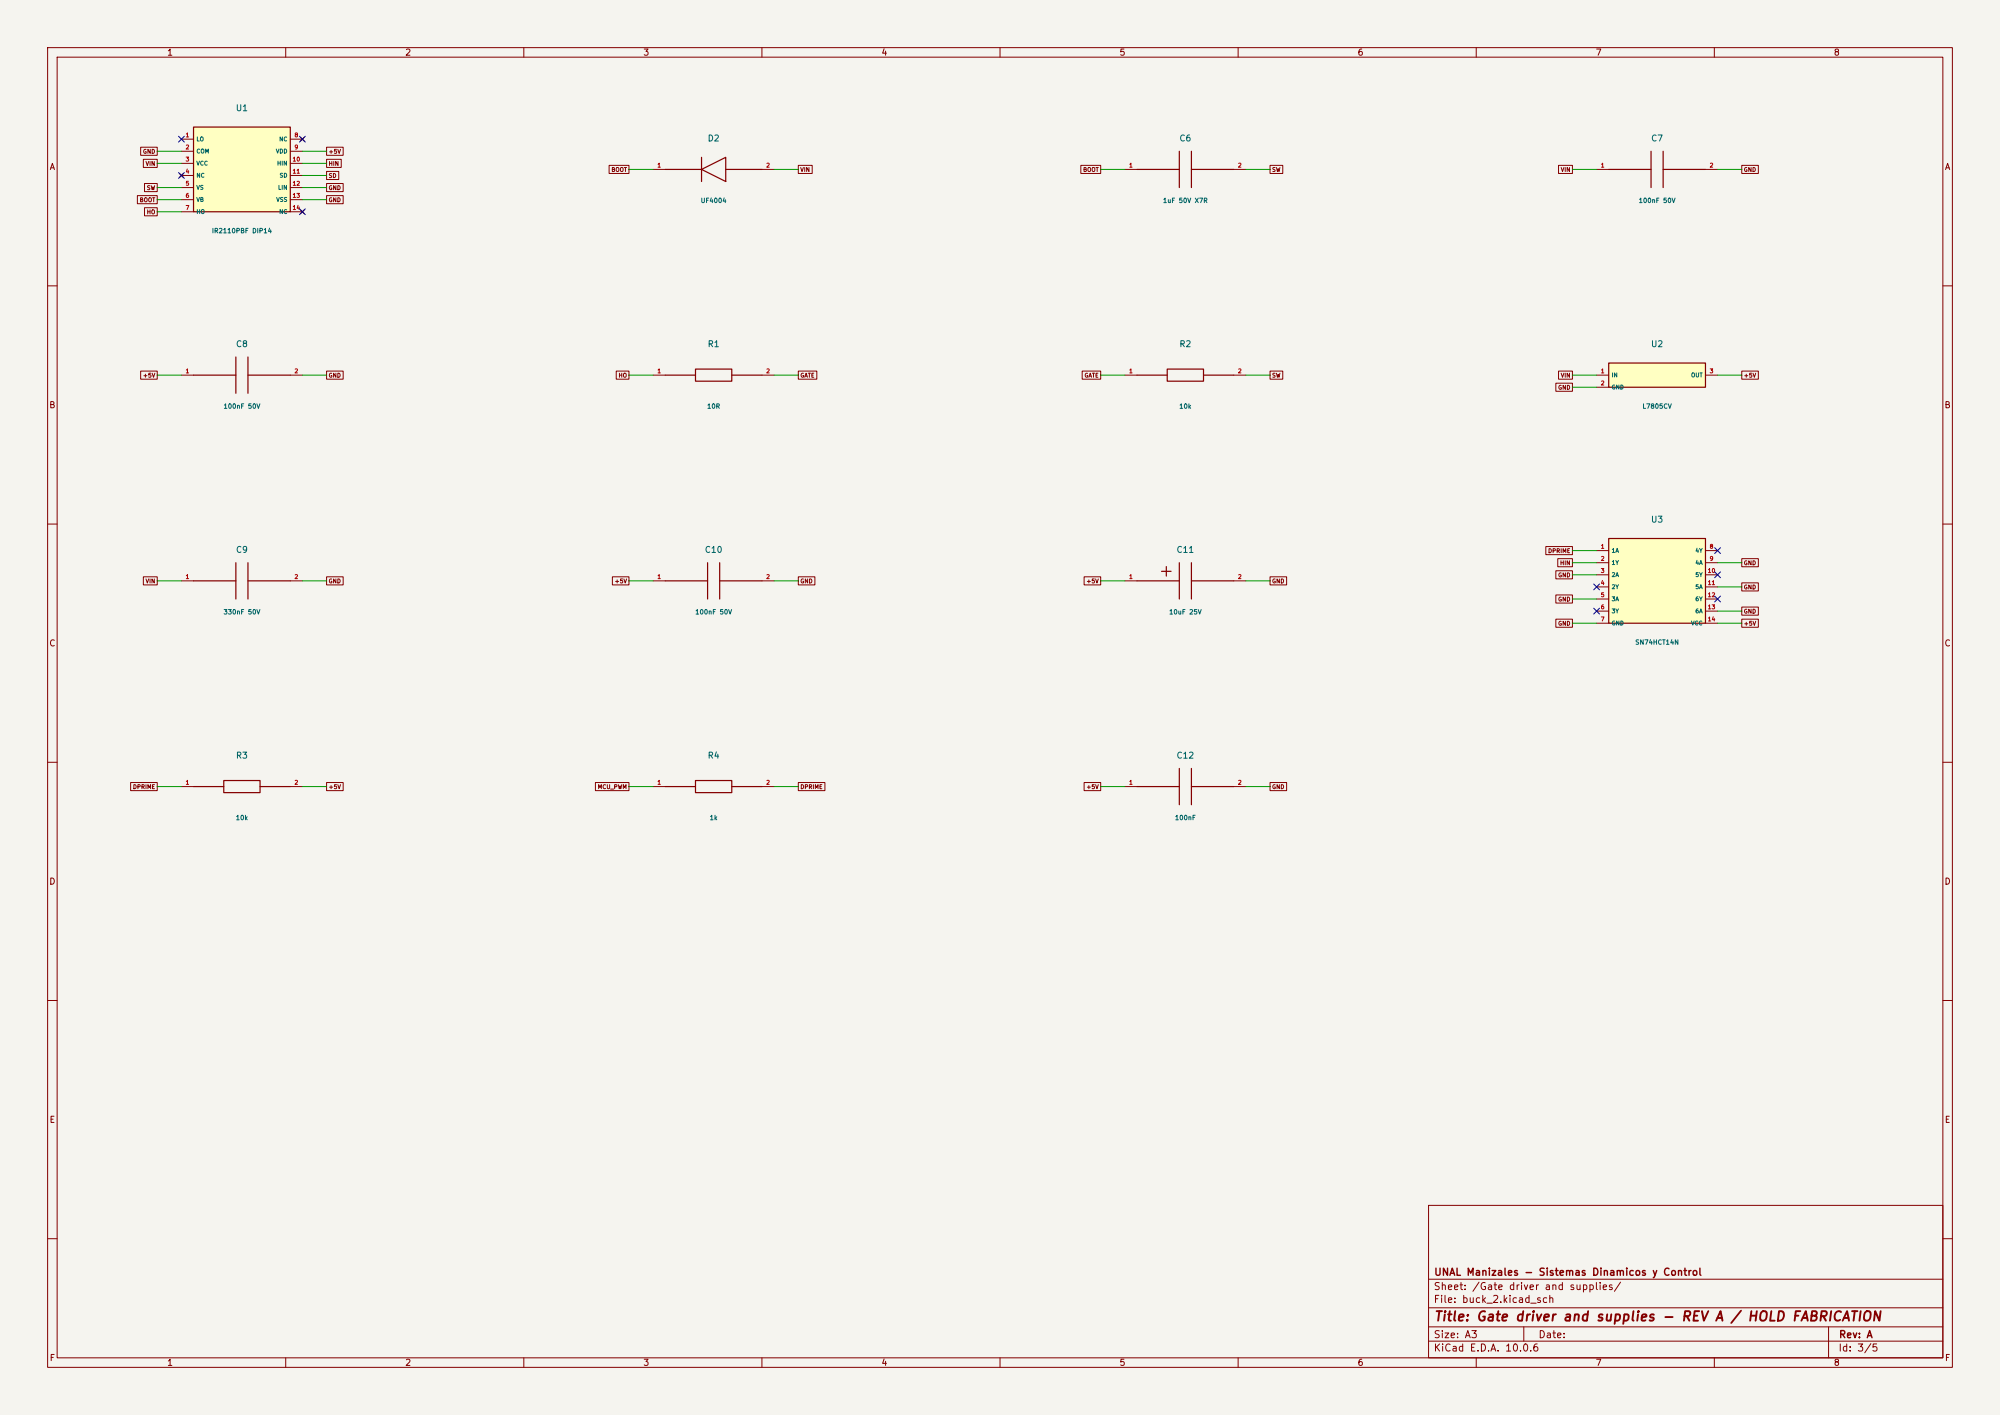
[picture p123: page 3]

UNAL Manizales - Sistemas Dinamicos y Control
Sheet: /Gate driver and supplies/
File: buck_2.kicad_sch
Title: Gate driver and supplies - REV A / HOLD FABRICATION

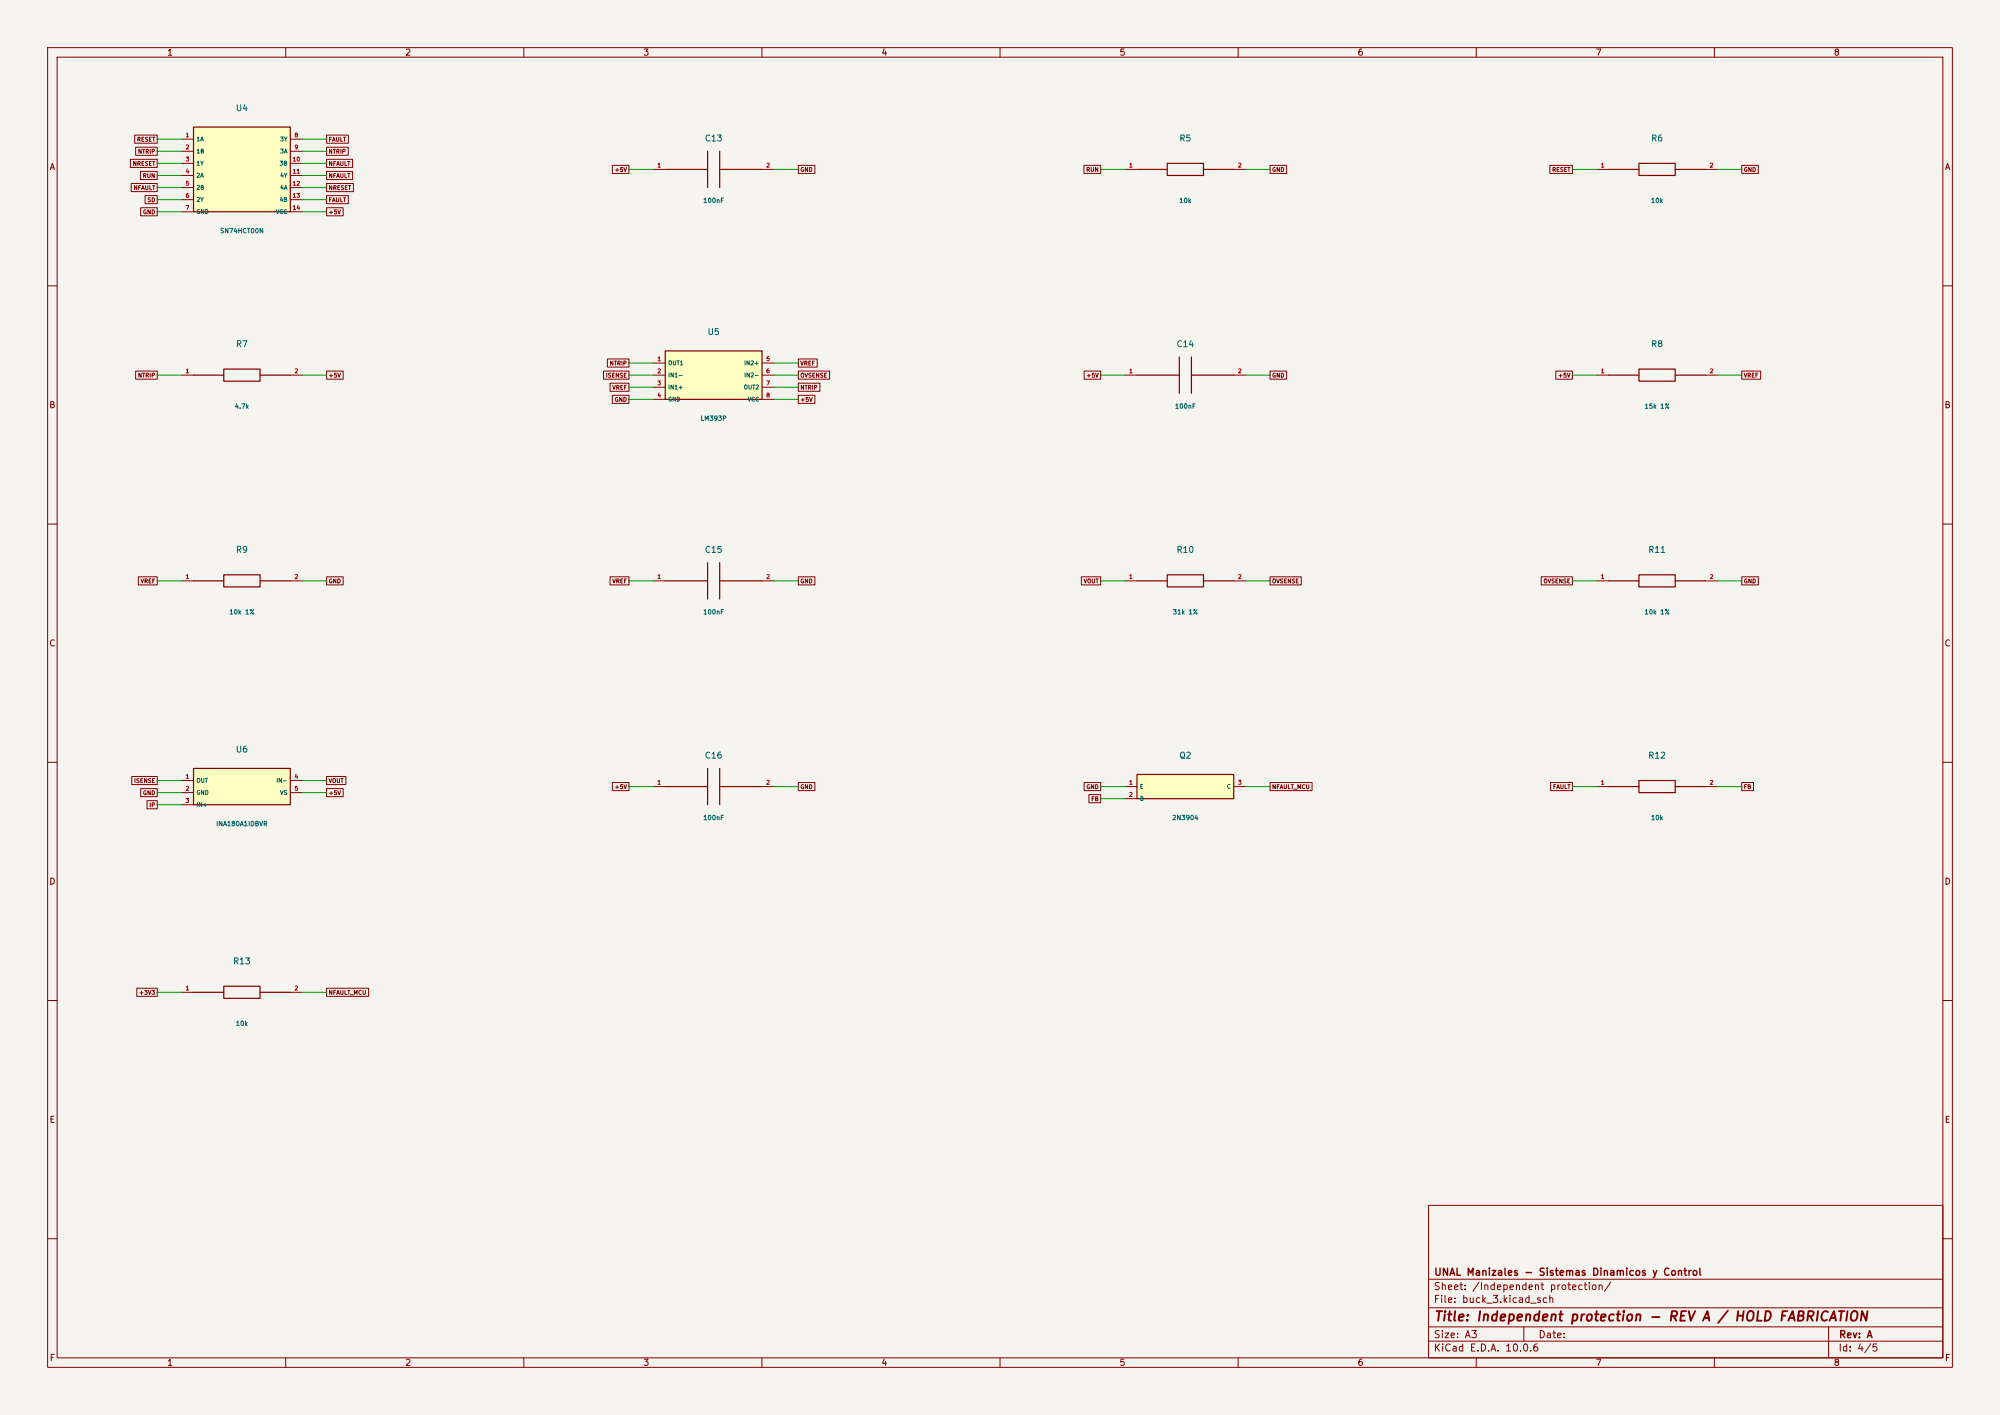
[picture p124: page 4]

UNAL Manizales - Sistemas Dinamicos y Control
Sheet: /Independent protection/
File: buck_3.kicad_sch
Title: Independent protection - REV A / HOLD FABRICATION

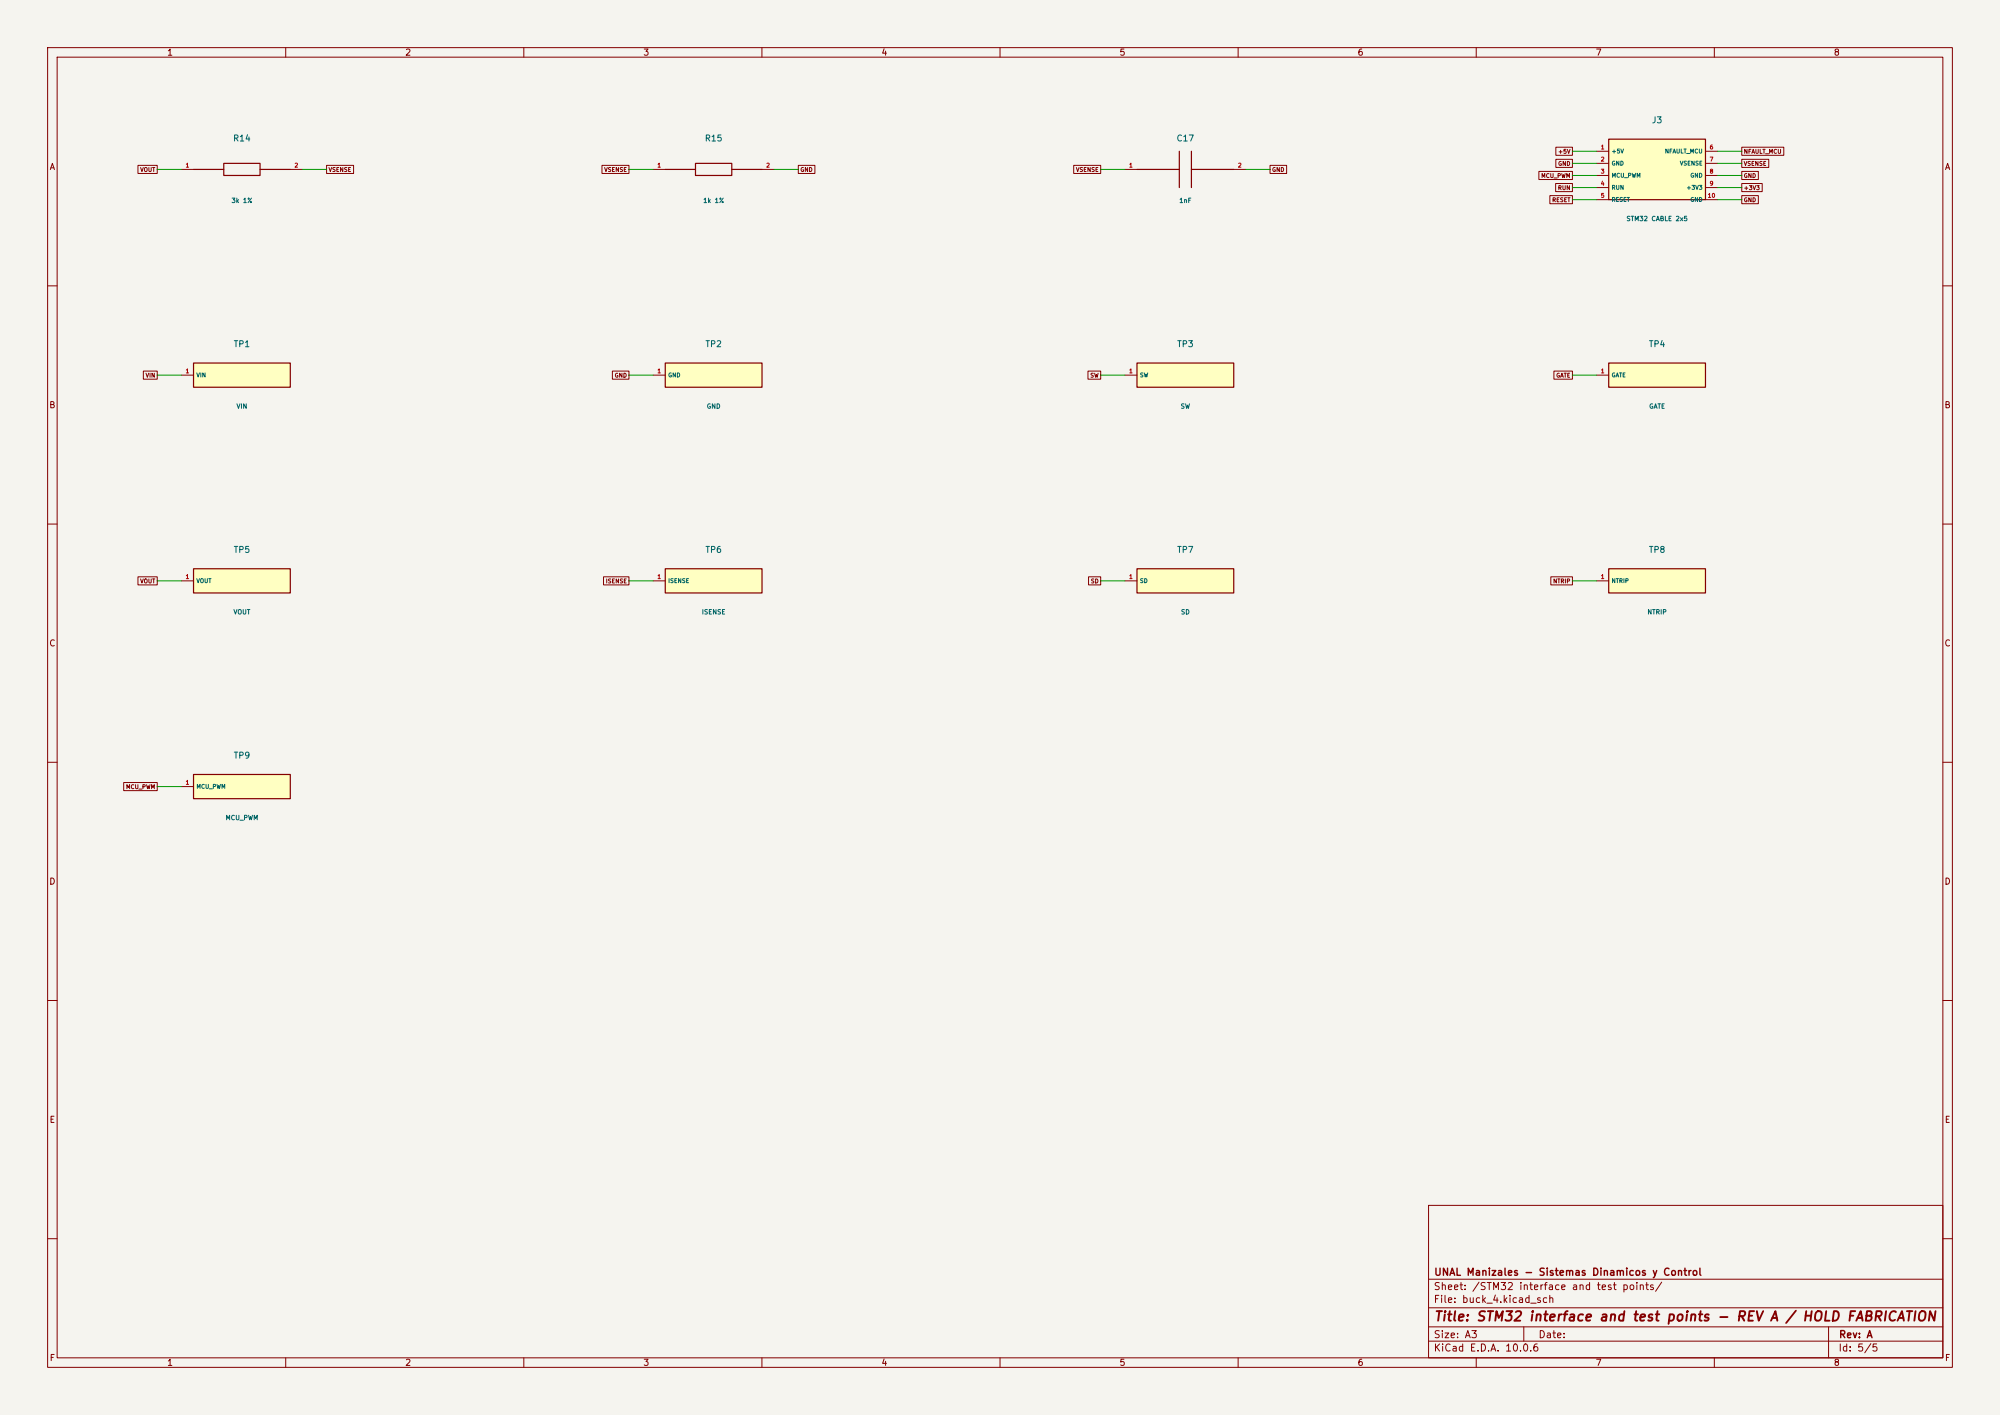
[picture p125: page 5]

UNAL Manizales - Sistemas Dinamicos y Control
Sheet: /STM32 interface and test points/
File: buck_4.kicad_sch
Title: STM32 interface and test points - REV A / HOLD FABRICATION
