almondsun/DynamicSystemsAndControl/project/pcb/redesign/production/jlcpcb-revB-2026-10-27/assembly_top_revB.pdf

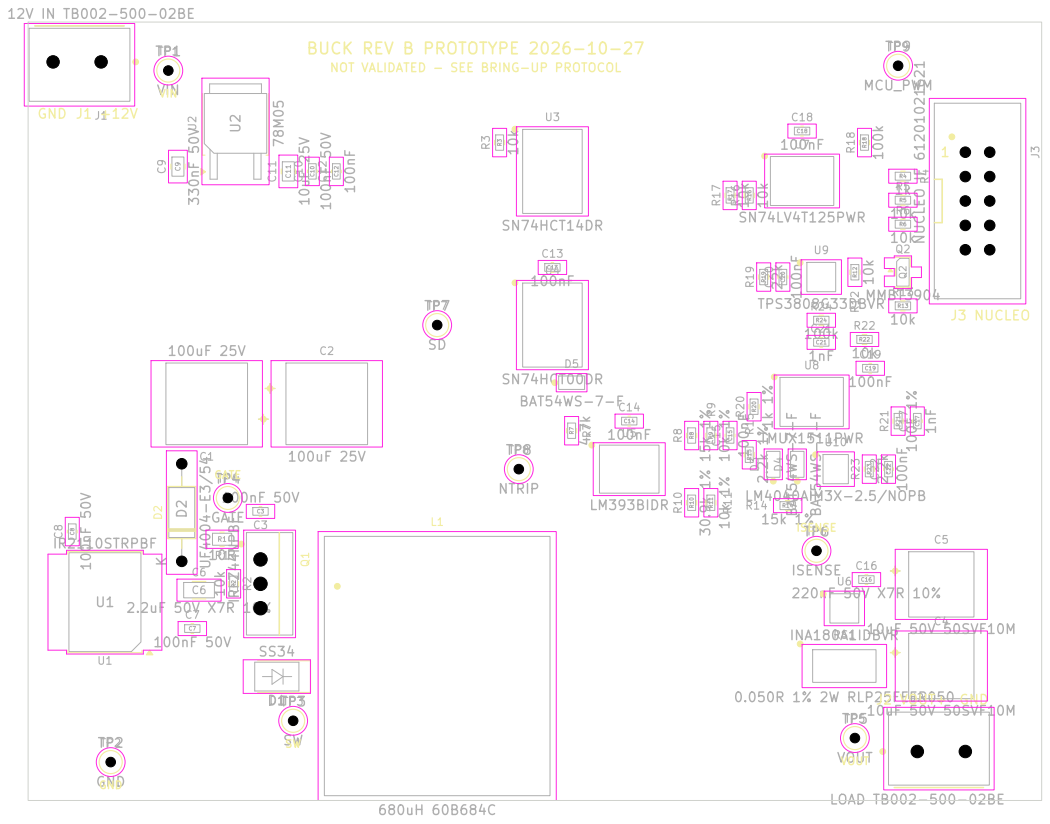
[picture p126: page 1]

NOT VALIDATED - SEE BRING-UP PROTOCOL GND J1 +12V

Size: A4 | Rev:
KiCad E.D.A. 10.0.7 | Id: 1/1
