almondsun/DynamicSystemsAndControl/project/pcb/redesign/production/jlcpcb-revB-2026-10-27/schematic_revB.pdf

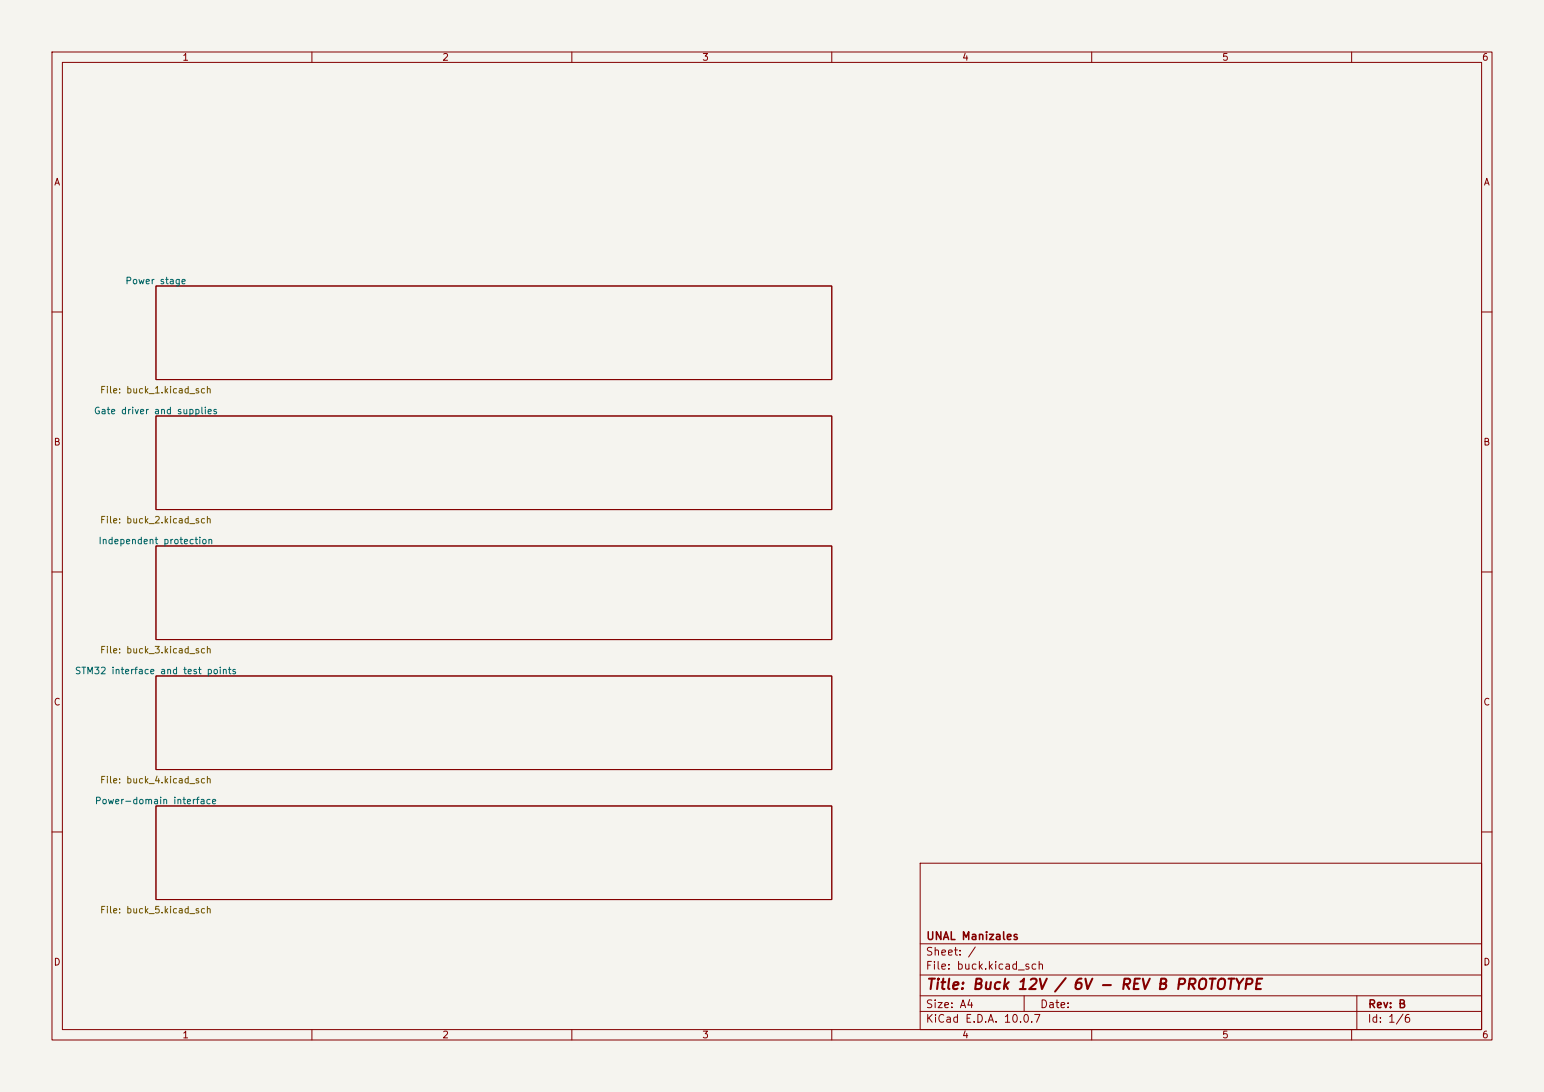
[picture p127: page 1]

File: buck_1.kicad_sch Gate driver and supplies File: buck_2.kicad_sch Power-domain interface

File: buck_3.kicad_sch STM32 interface and test points File: buck_4.kicad_sch

UNAL Manizales
Sheet: /
File: buck.kicad_sch
Title: Buck 12V / 6V - REV B PROTOTYPE

Size: A4 | Rev: B
KiCad E.D.A. 10.0.7 | Id: 1/6

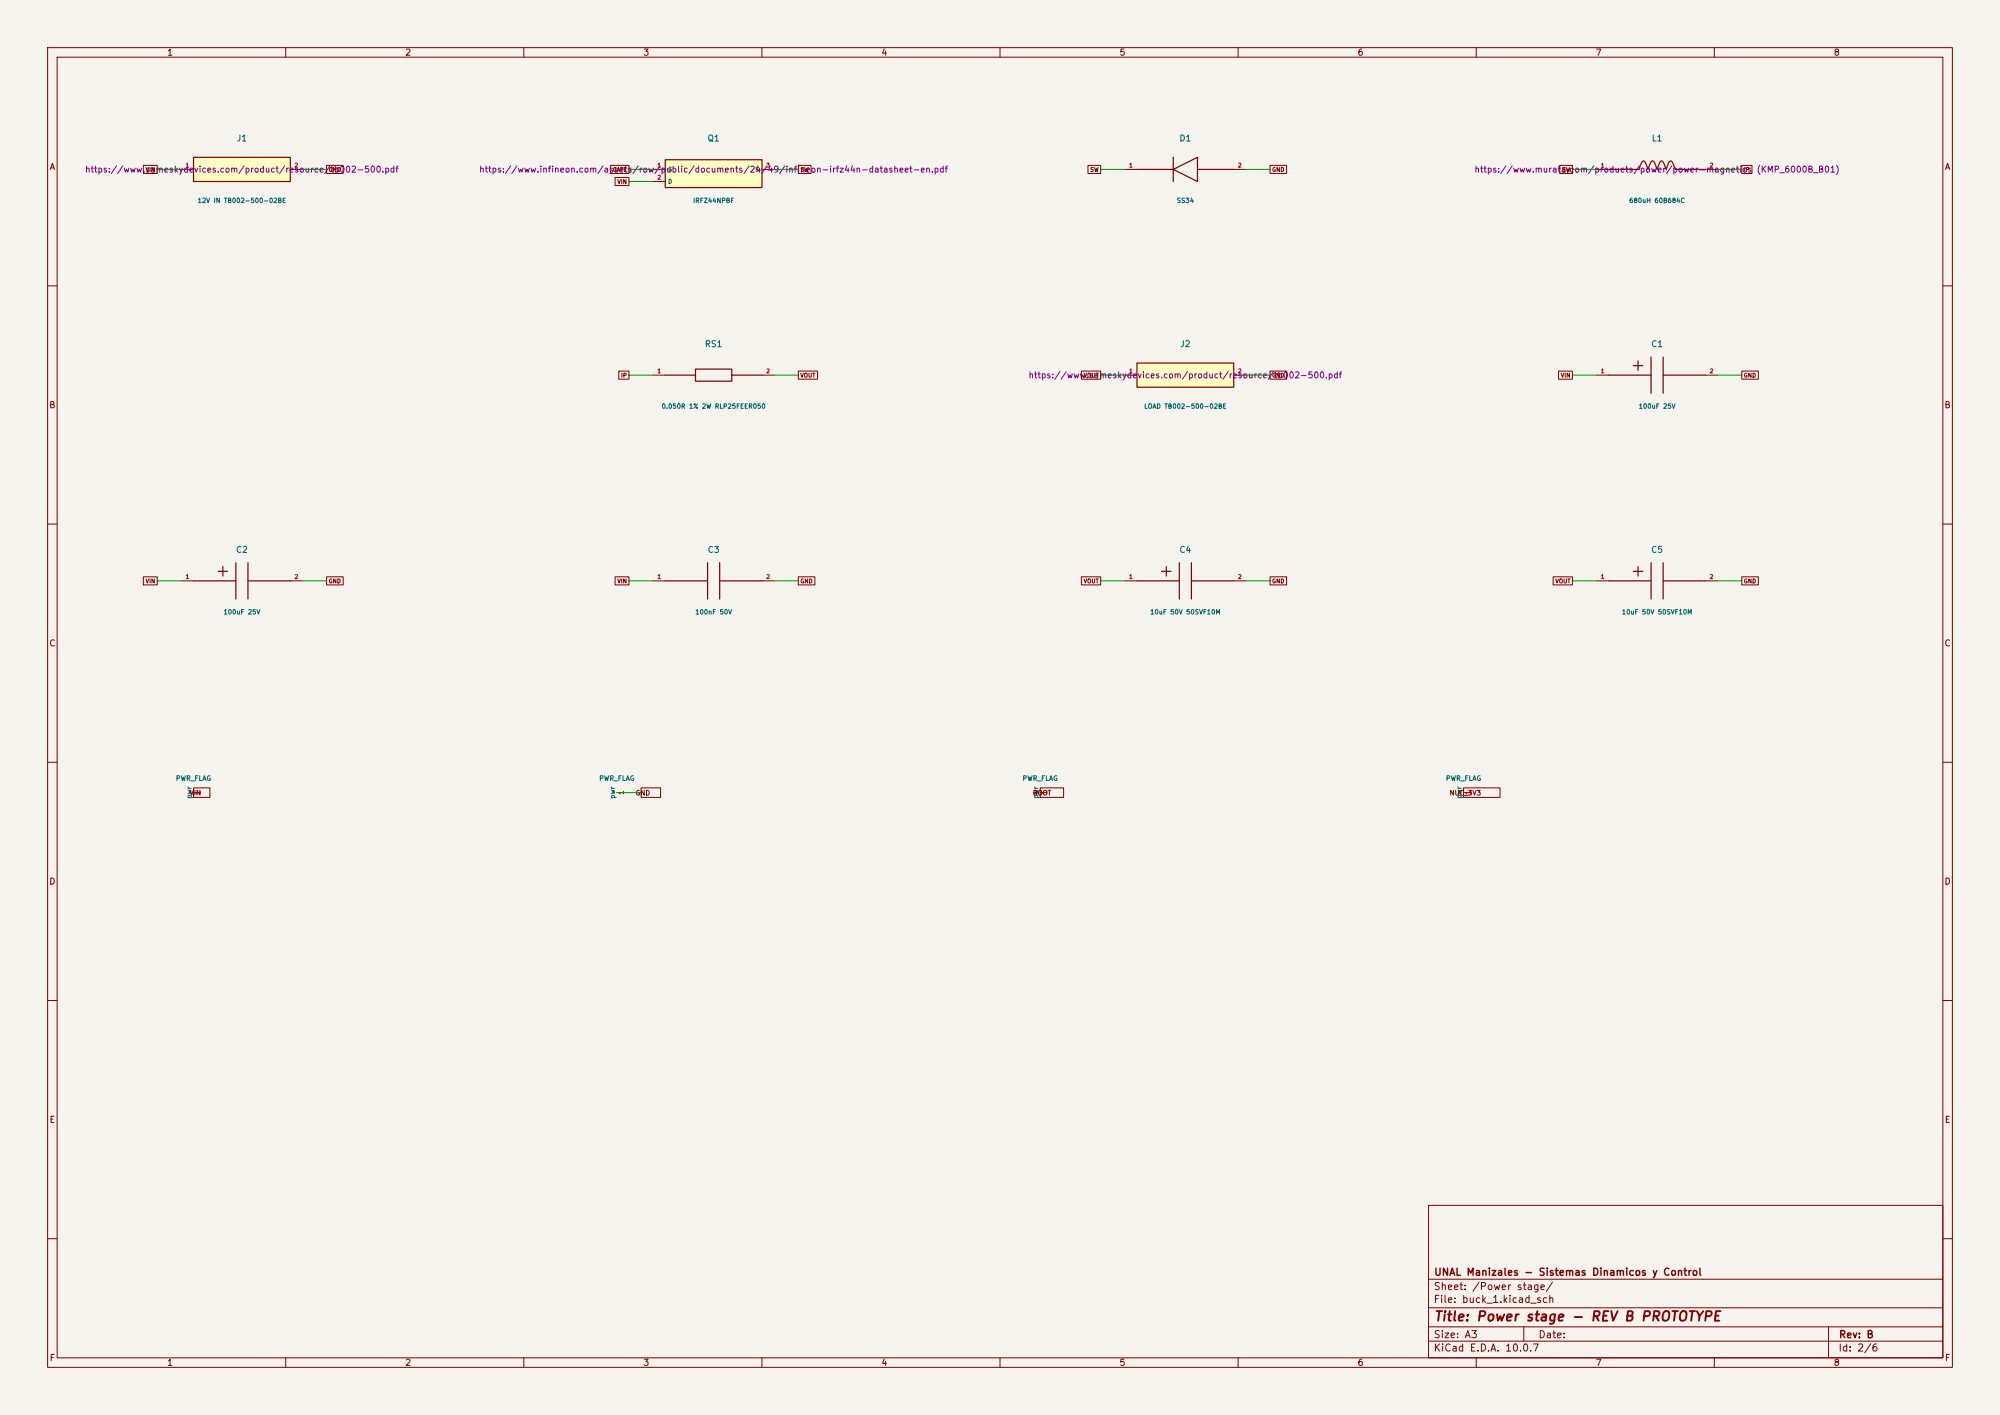
[picture p128: page 2]

680uH 60B684C https://www.murata.com/products/power/power-magnetics (KMP_6000B_B01)

UNAL Manizales - Sistemas Dinamicos y Control
Sheet: /Power stage/
File: buck_1.kicad_sch
Title: Power stage - REV B PROTOTYPE

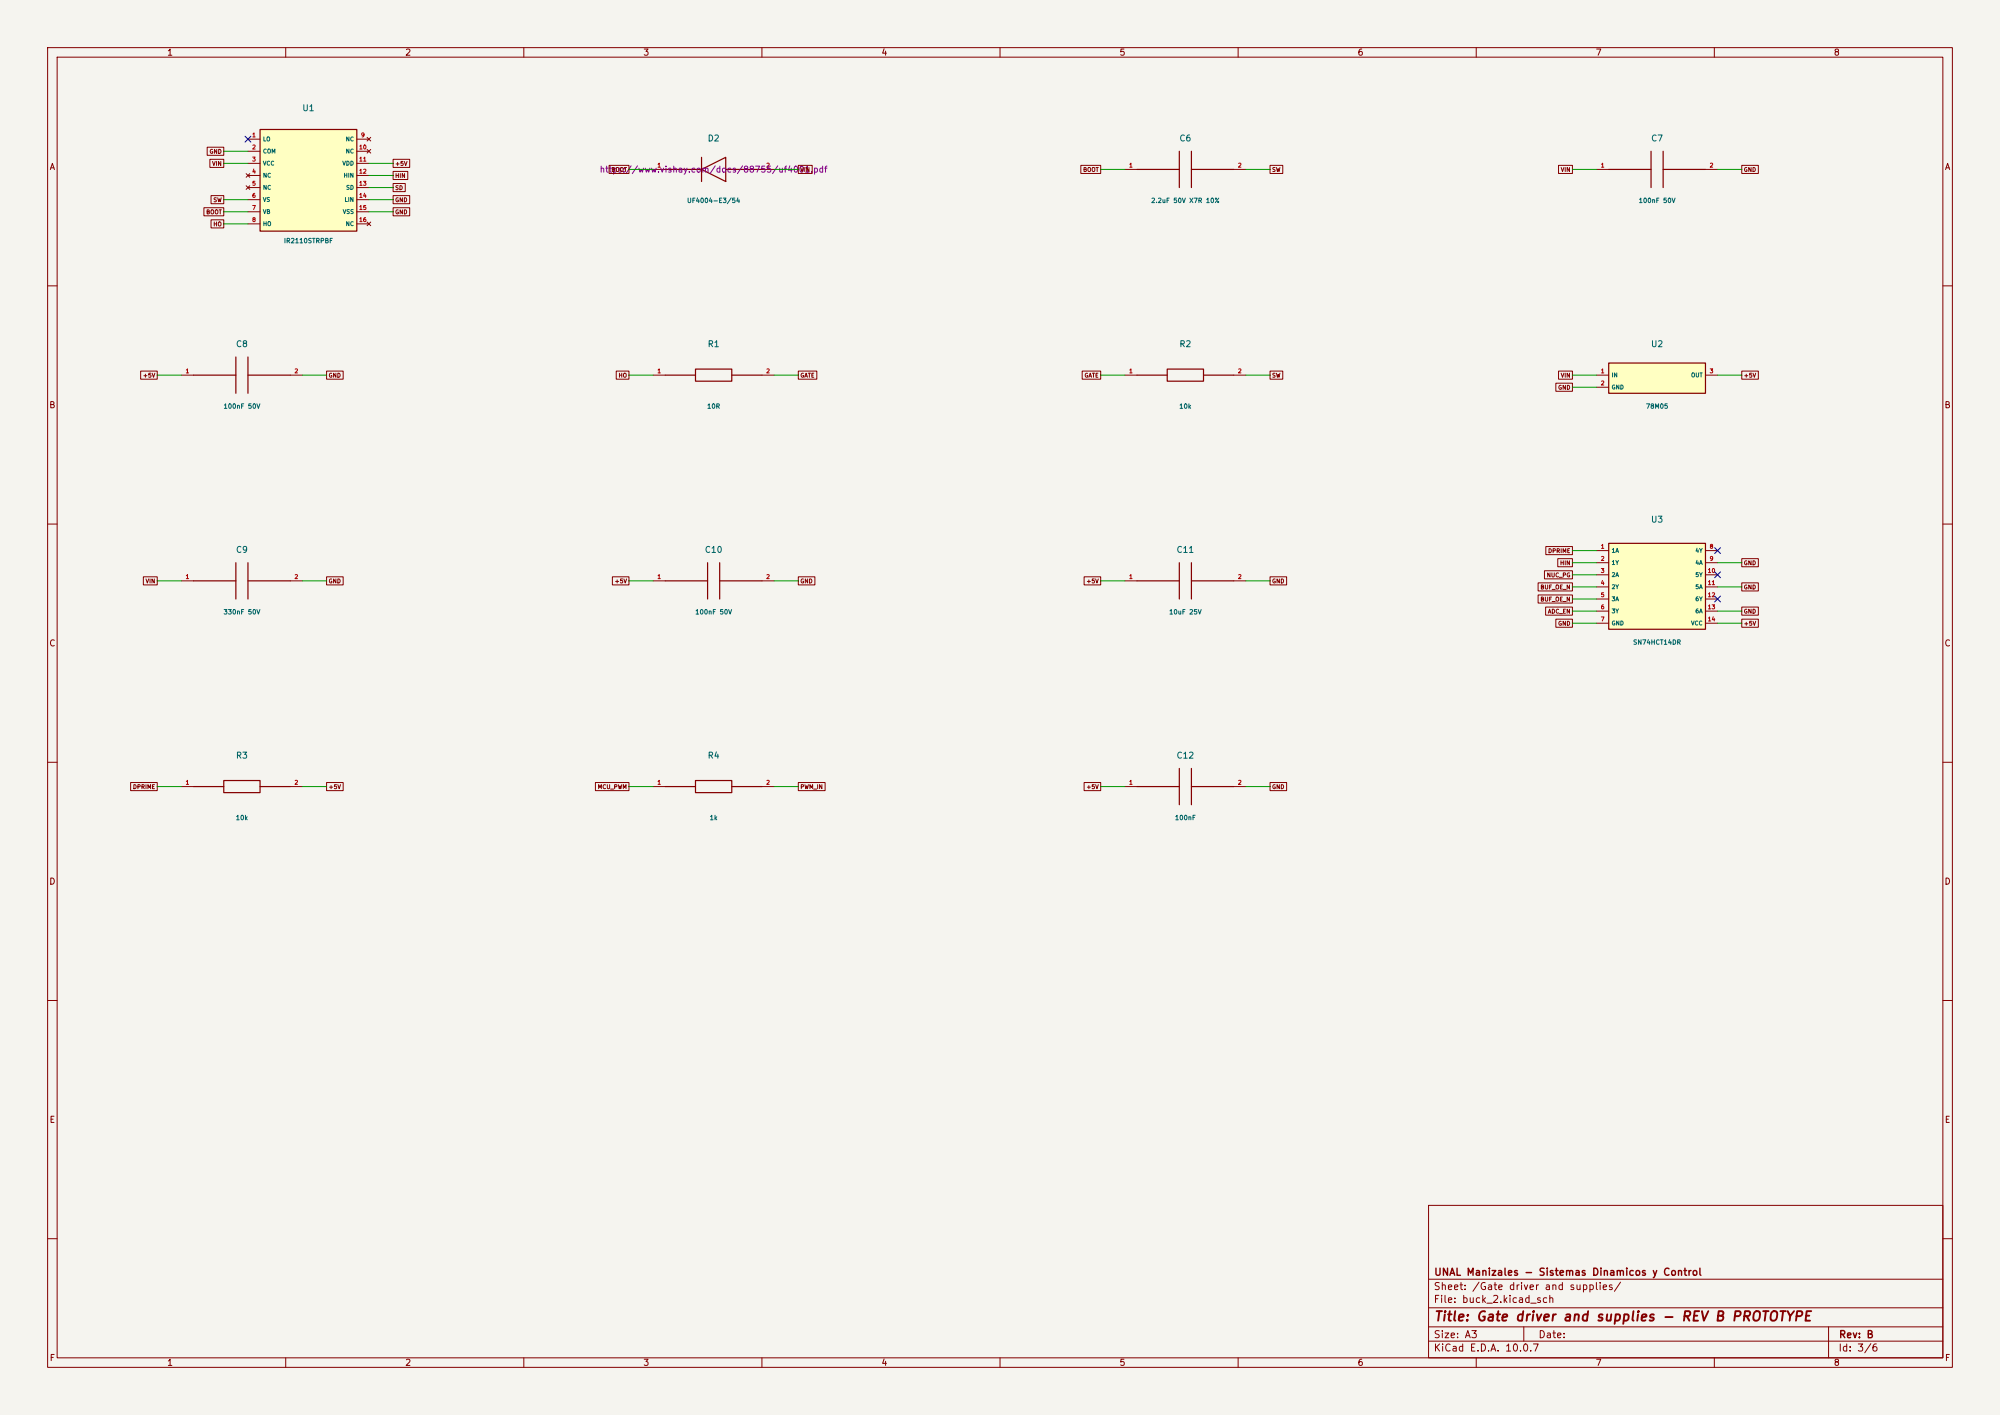
[picture p129: page 3]

UNAL Manizales - Sistemas Dinamicos y Control
Sheet: /Gate driver and supplies/
File: buck_2.kicad_sch
Title: Gate driver and supplies - REV B PROTOTYPE

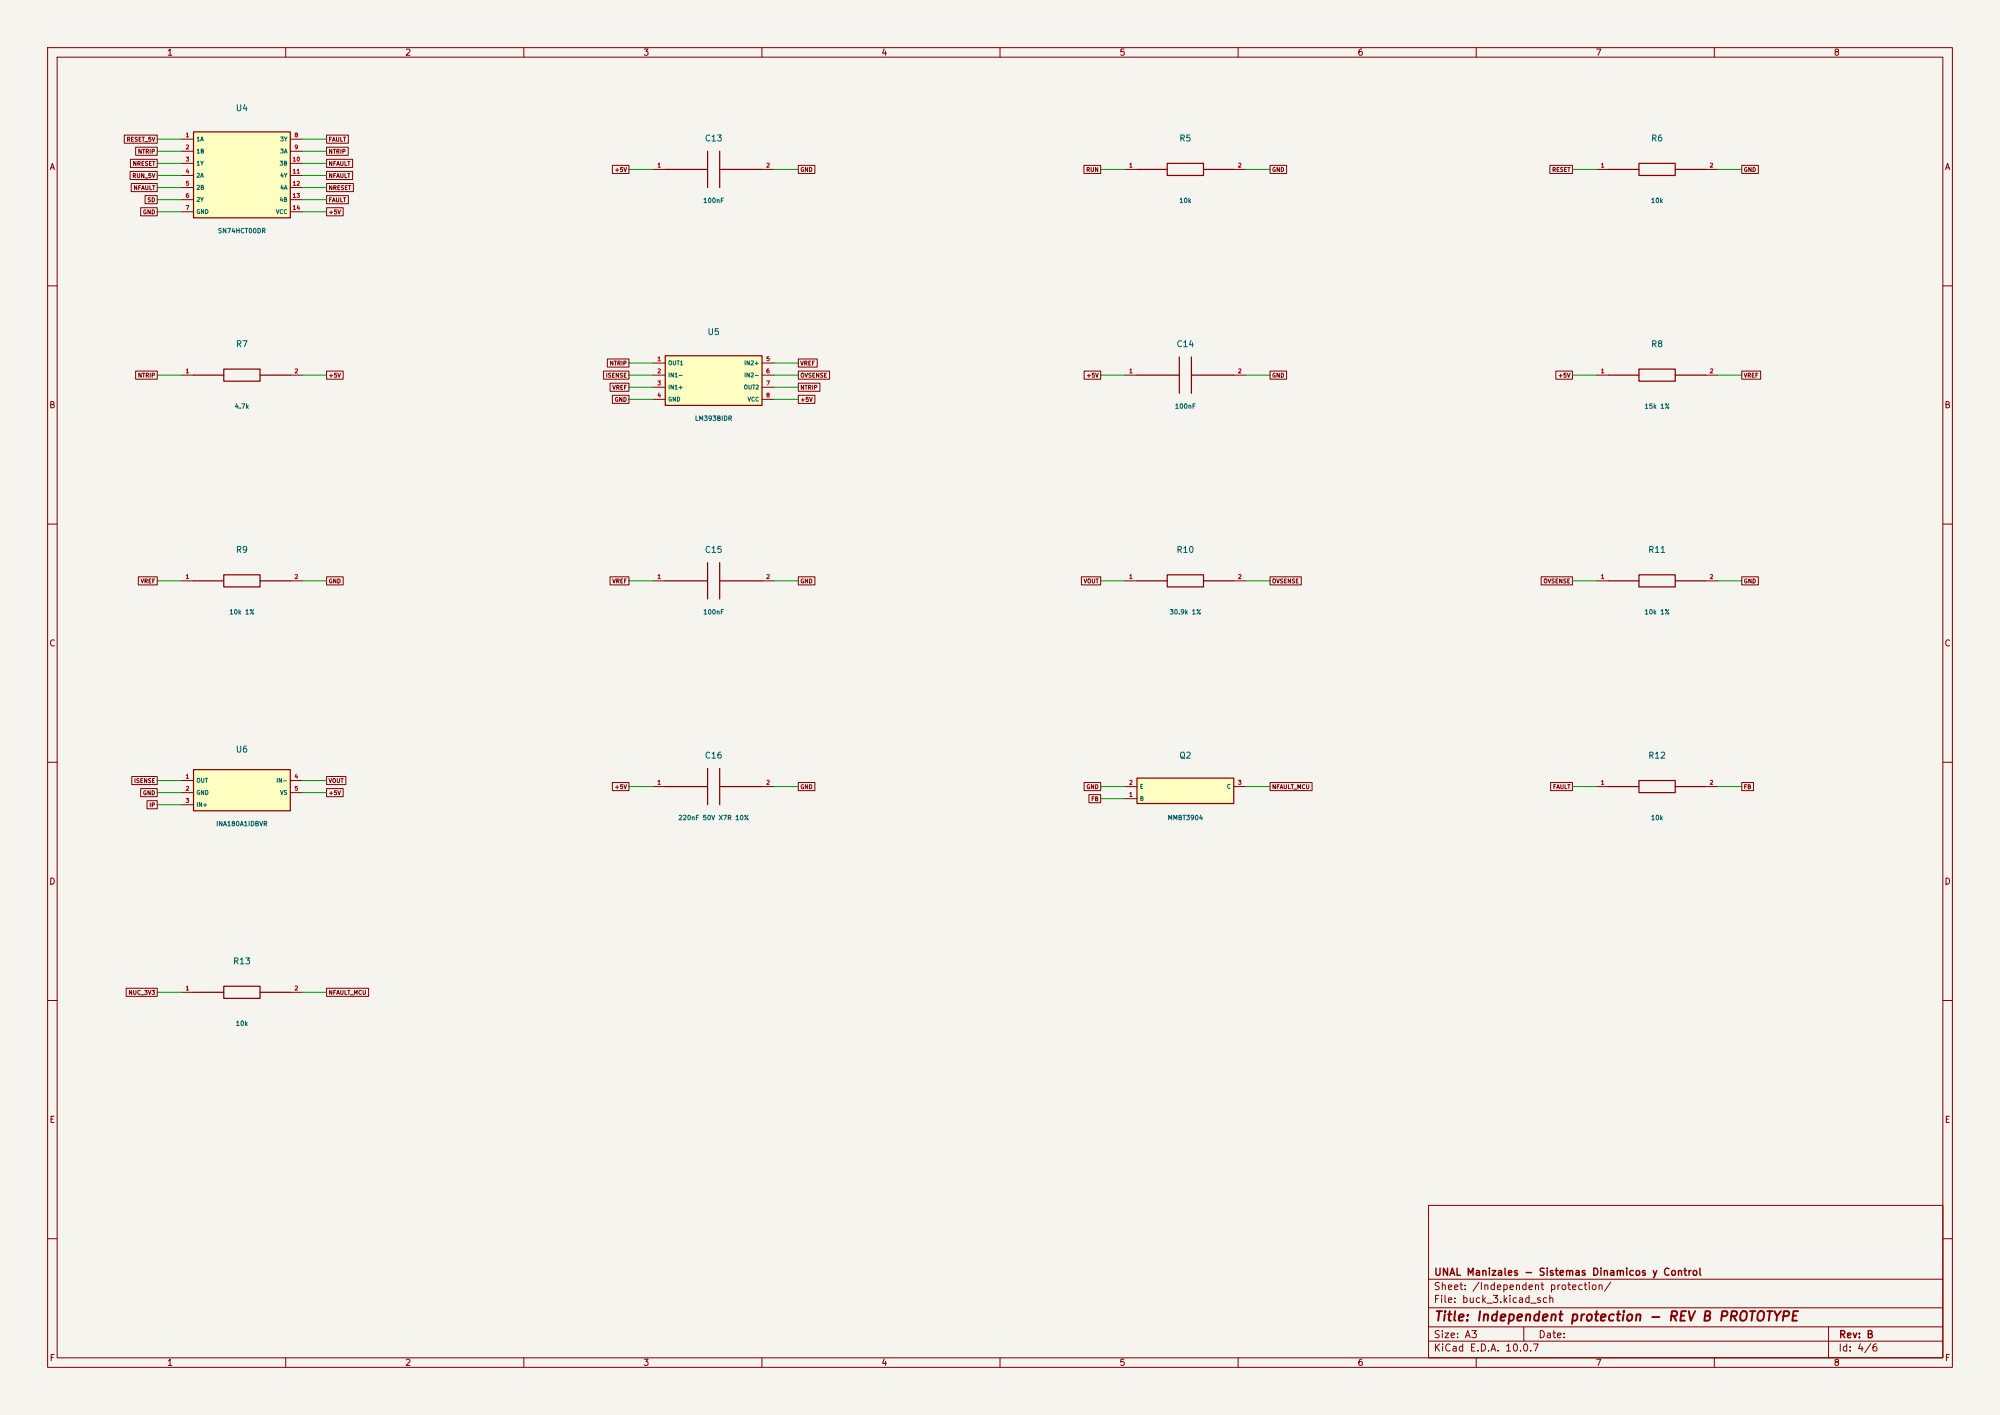
[picture p130: page 4]

VREF NTRIP OVSENSE GND

UNAL Manizales - Sistemas Dinamicos y Control
Sheet: /Independent protection/
File: buck_3.kicad_sch
Title: Independent protection - REV B PROTOTYPE

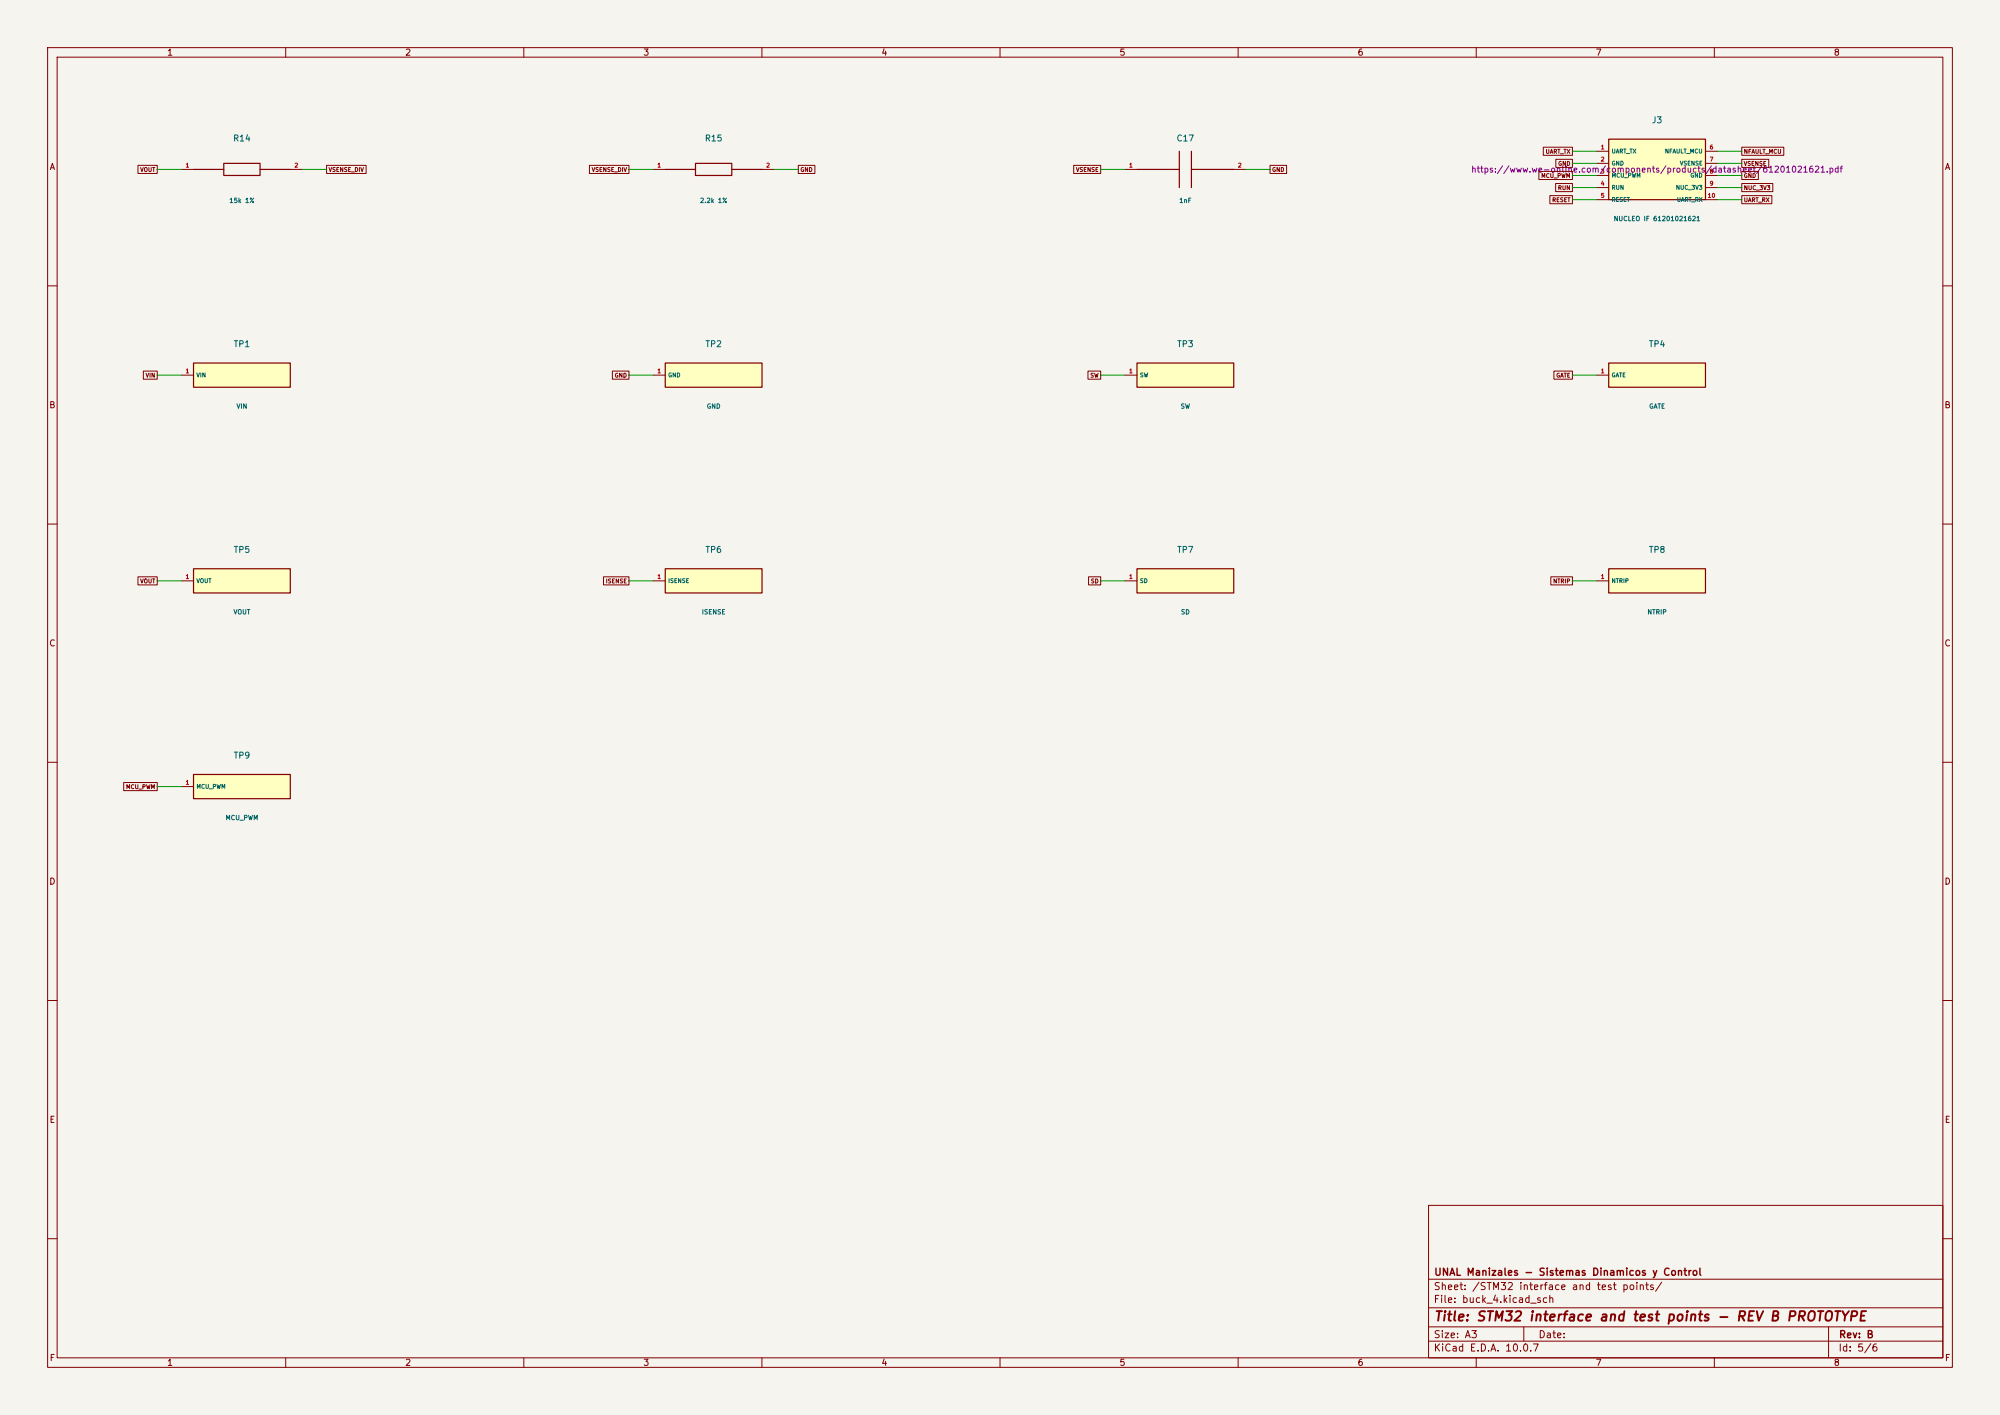
[picture p131: page 5]

UNAL Manizales - Sistemas Dinamicos y Control
Sheet: /STM32 interface and test points/
File: buck_4.kicad_sch
Title: STM32 interface and test points - REV B PROTOTYPE

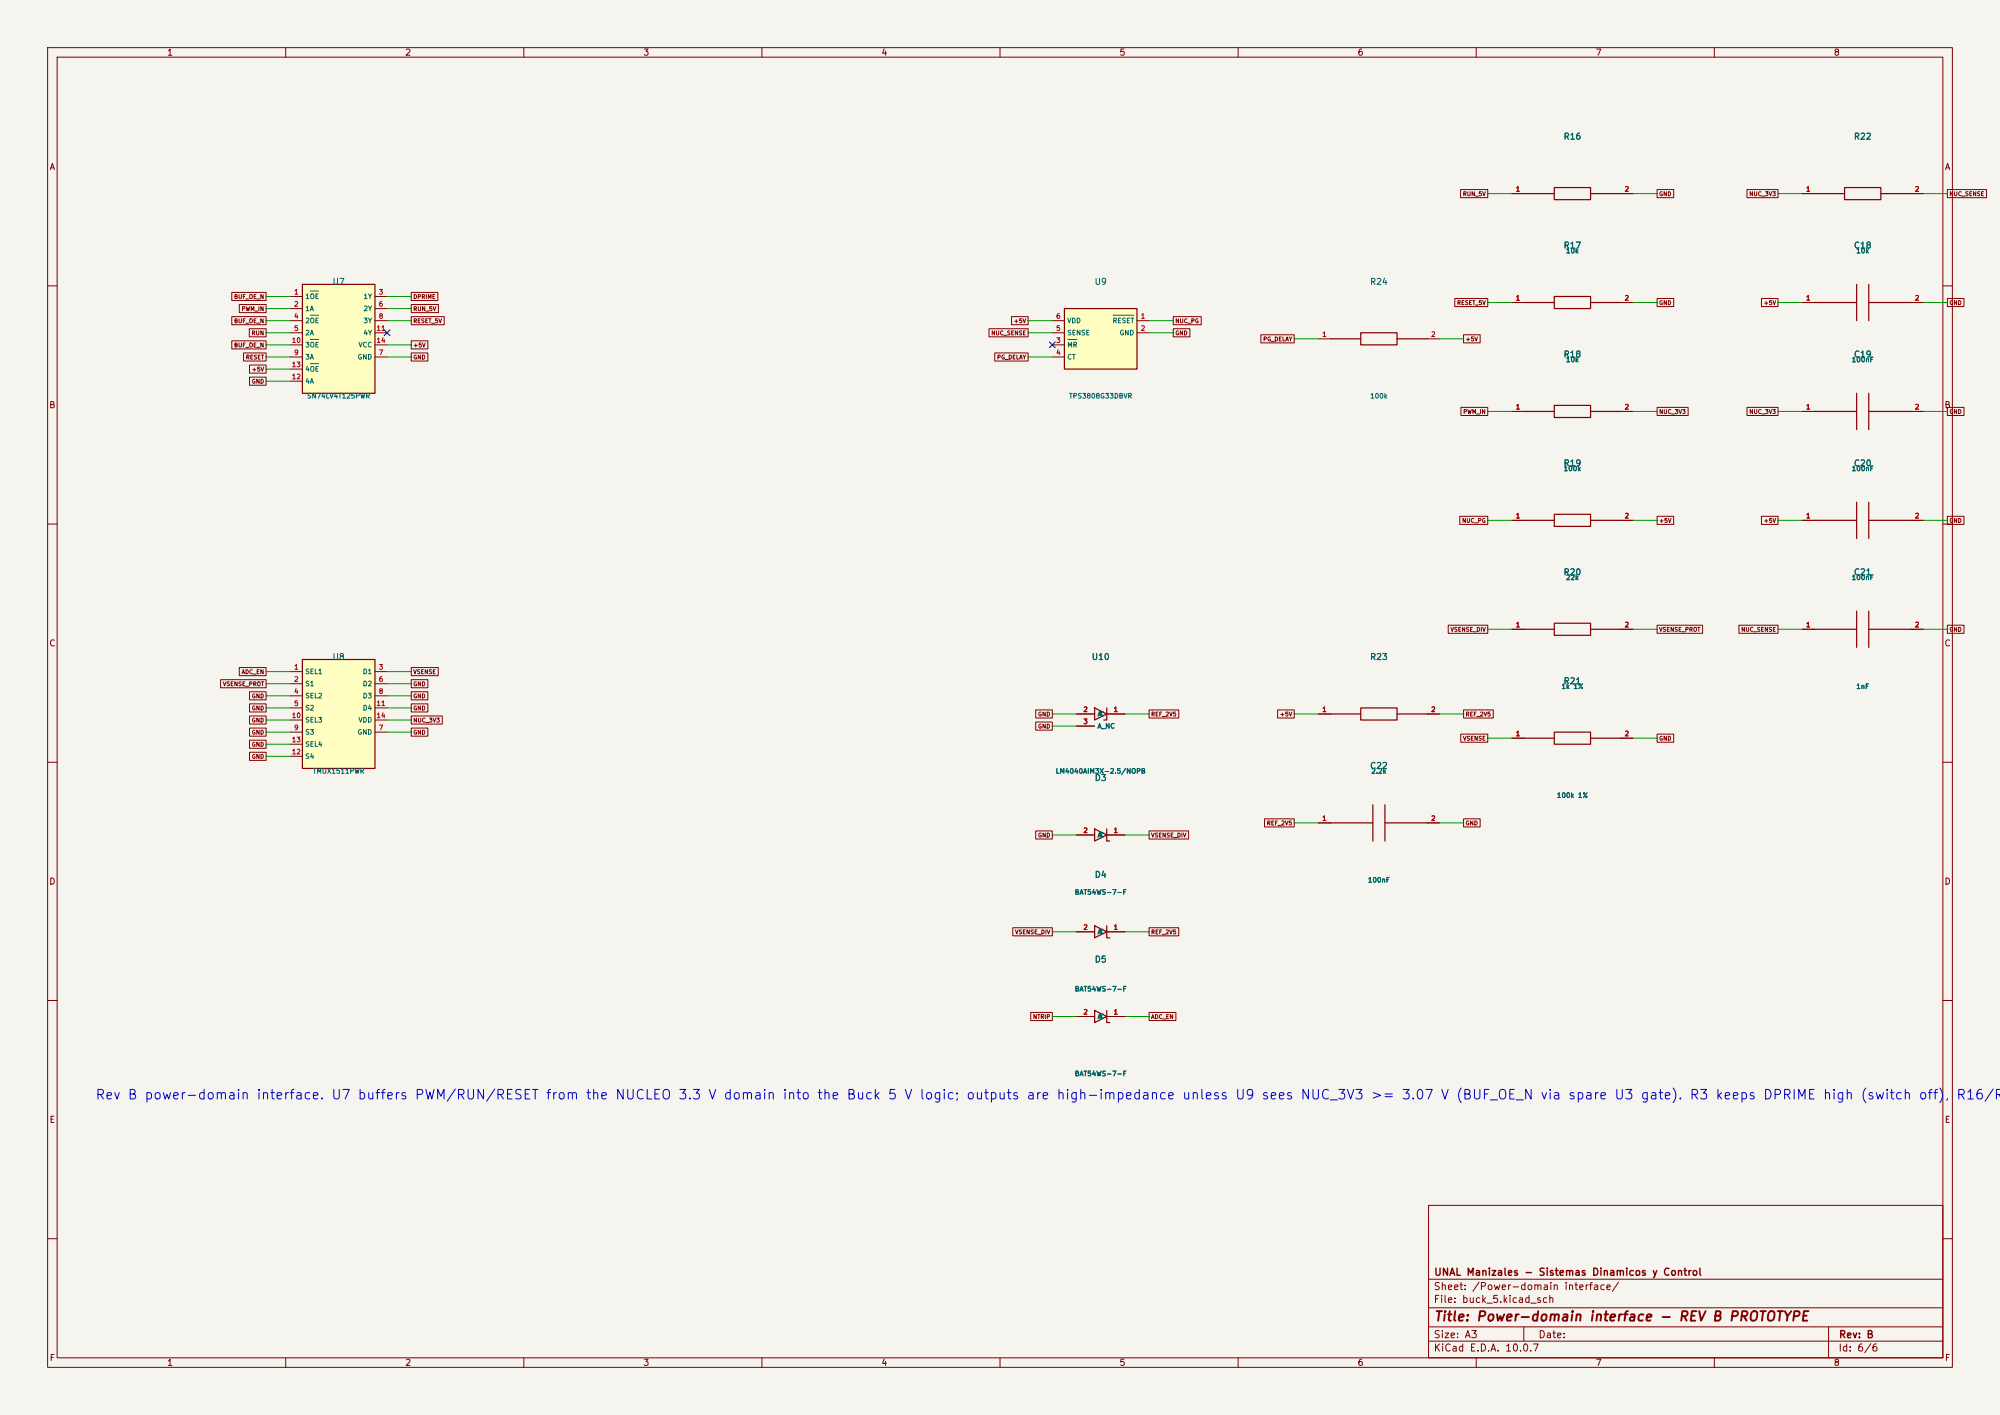
[picture p132: page 6]

RUN_5V Rev B power-domain interface. U7 buffers PWM/RUN/RESET from the NUCLEO 3.3 V domain into the Buck 5 V logic; outputs are high-impedance unless U9 sees NUC_3V3 >= 3.07 V (BUF_OE_N via spare U3 gate). R3 keeps DPRIME high (switch off), R16/R17 keep RUN_5V/RESET_5V low. U8 connects the clamped ADC divider only while ADC_EN is high. Not electrically validated.

UNAL Manizales - Sistemas Dinamicos y Control
Sheet: /Power-domain interface/
File: buck_5.kicad_sch
Title: Power-domain interface - REV B PROTOTYPE
