almondsun/DynamicSystemsAndControl/project/pcb/release/report-assets/layout.pdf

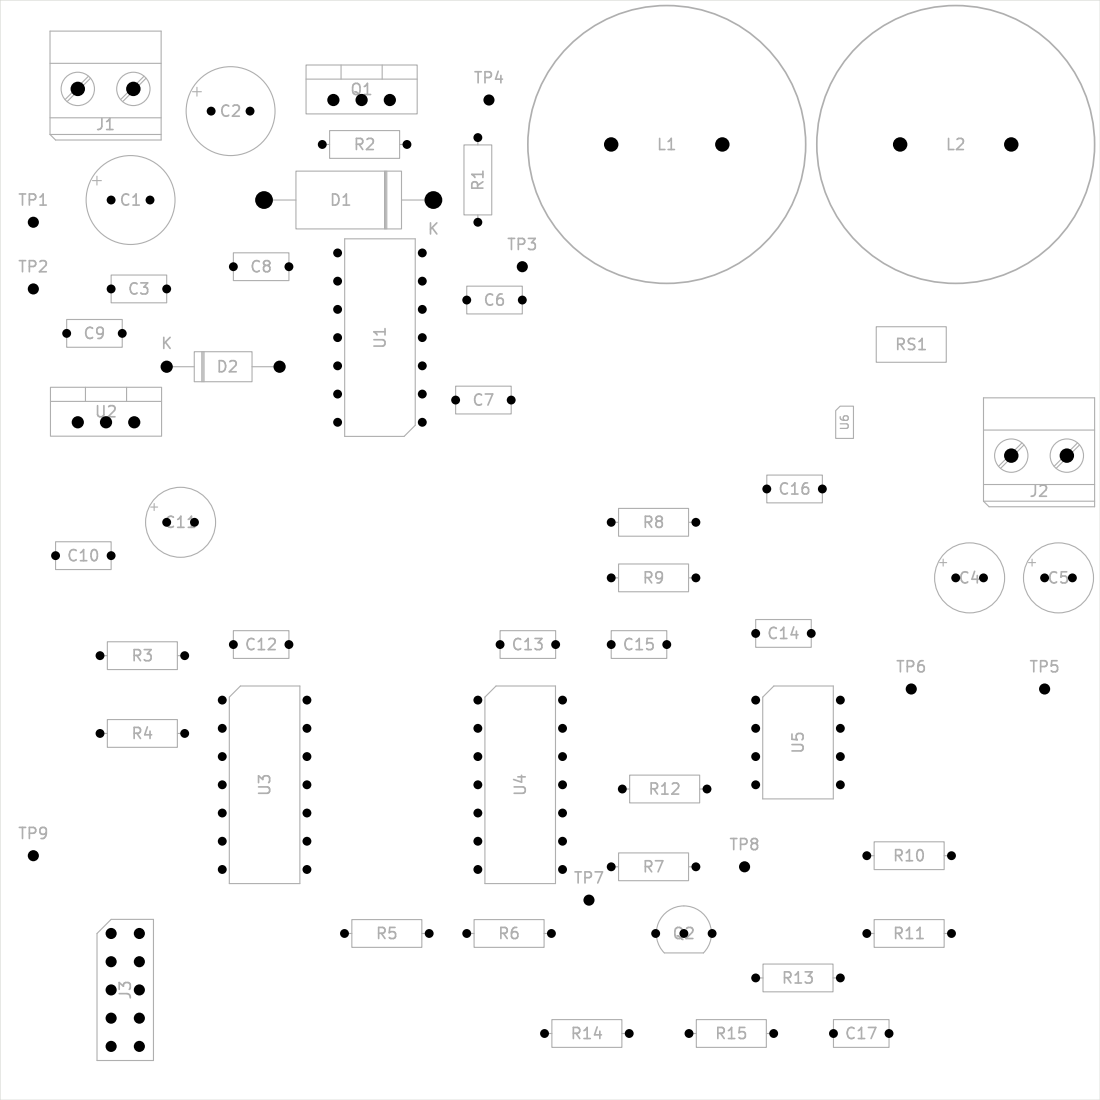
[picture p133: page 1]
