almondsun/DynamicSystemsAndControl/(list of files, drawings)

Other design files:
project/pcb/buck.dsn
project/pcb/redesign/production/jlcpcb-quote-2026-10/evidence/pcb_inventory.json
project/pcb/redesign/validation/pcb_rules/schematic_erc.json
