almondsun/DynamicSystemsAndControl/project/pcb/revC/pcb_revC/pcb_revC.kicad_pcb

## KiCad design project/pcb/revC/pcb_revC/pcb_revC.kicad_pcb (2026-11-07)

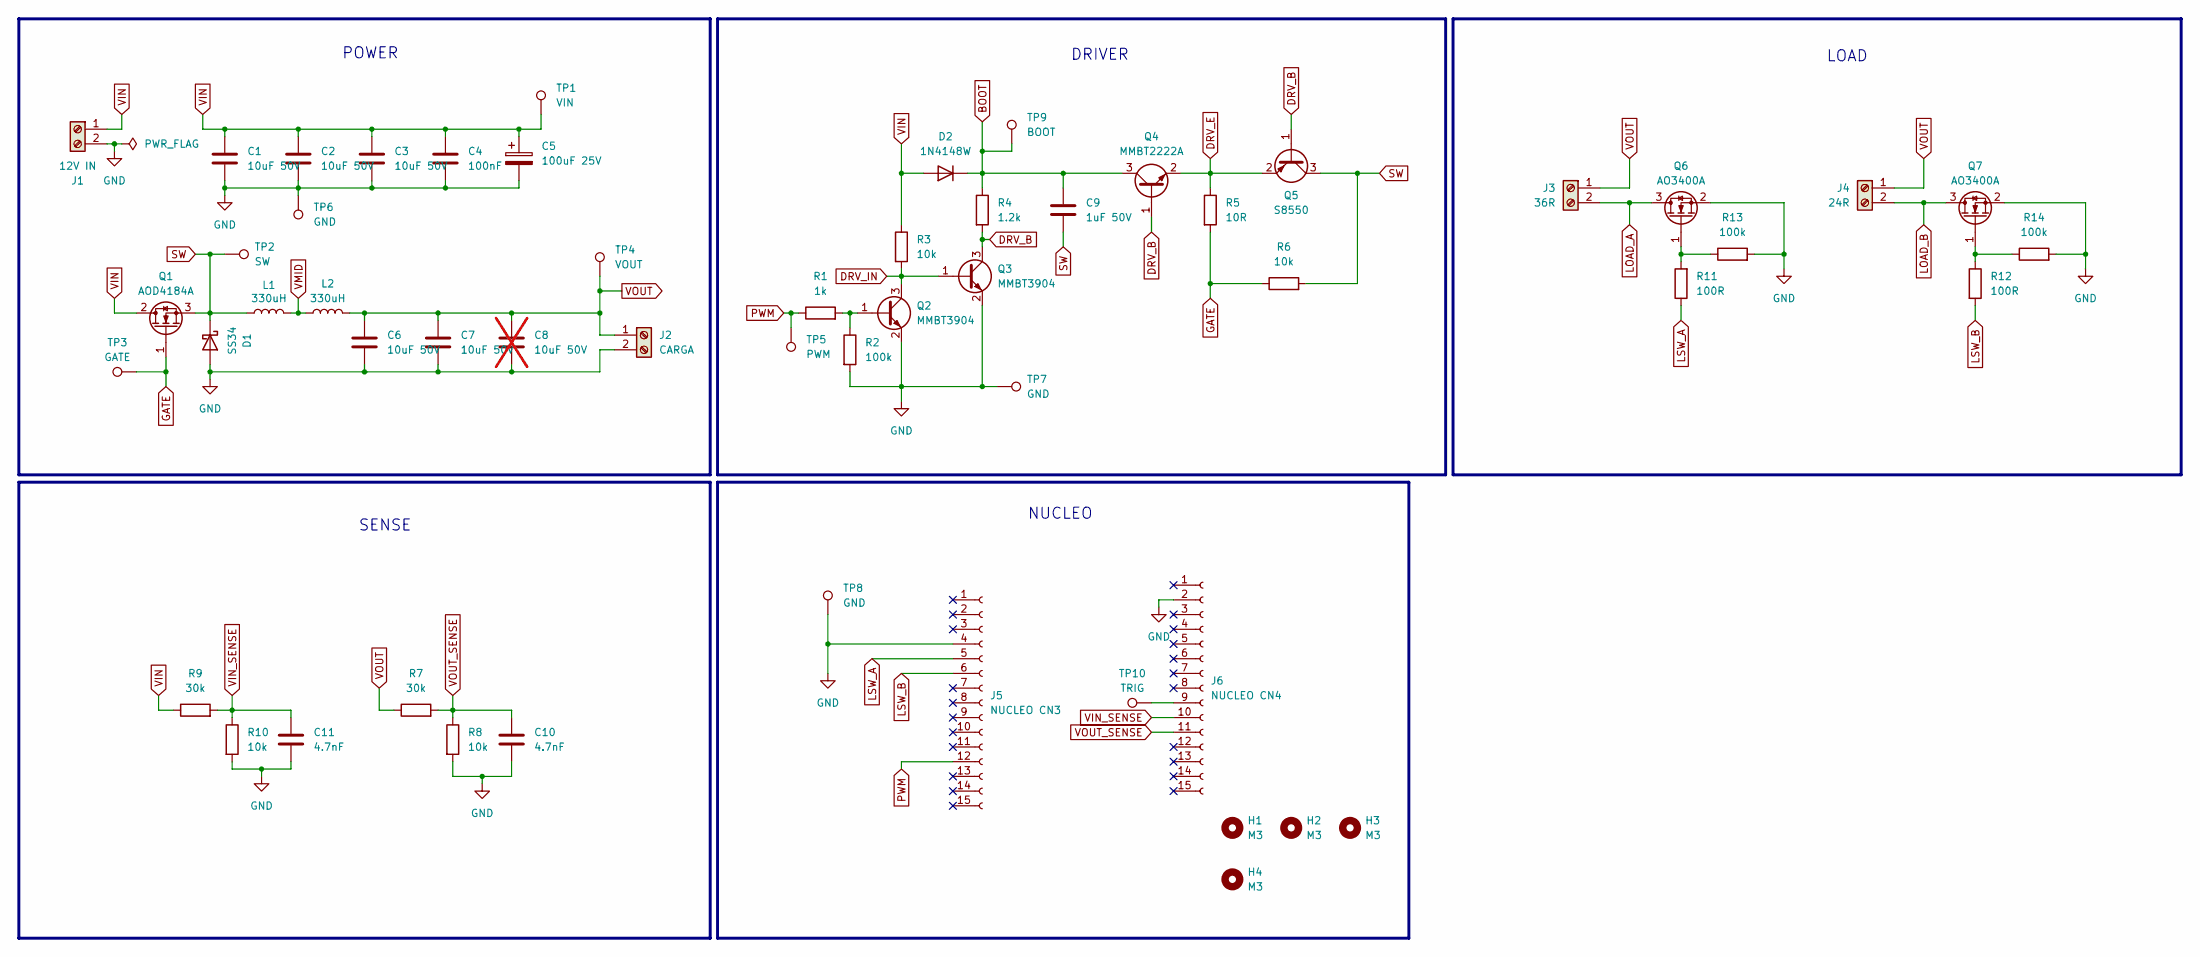
[picture p134: schematic pcb_revC.kicad_sch, Buck 12V-6V Rev C]

Parts:
C1, C2, C3, C6, C7: 10uF 50V; C_1206_3216Metric; LCSC C13585
C4: 100nF; C_0603_1608Metric; LCSC C14663
C5: 100uF 25V; CP_Radial_D6.3mm_P2.50mm
C8: 10uF 50V; C_1206_3216Metric; LCSC C13585; not fitted
C9: 1uF 50V; C_0805_2012Metric; LCSC C28323
C10, C11: 4.7nF; C_0603_1608Metric; LCSC C53987
D1: SS34; D_SMA; LCSC C8678
D2: 1N4148W; D_SOD-123; LCSC C81598
H1, H2, H3, H4: M3; MountingHole_3.2mm_M3
J1: 12V IN; TerminalBlock_Phoenix_MKDS-1,5-2_1x02_P5.00mm_Horizontal
J2: CARGA; TerminalBlock_Phoenix_MKDS-1,5-2_1x02_P5.00mm_Horizontal
J3: 36R; TerminalBlock_Phoenix_MKDS-1,5-2_1x02_P5.00mm_Horizontal
J4: 24R; TerminalBlock_Phoenix_MKDS-1,5-2_1x02_P5.00mm_Horizontal
J5: NUCLEO CN3; PinSocket_1x15_P2.54mm_Vertical
J6: NUCLEO CN4; PinSocket_1x15_P2.54mm_Vertical
L1, L2: 330uH; L_Bourns_SRR1280; LCSC C2041412
Q1: AOD4184A; TO-252-2; LCSC C99124
Q2, Q3: MMBT3904; SOT-23; LCSC C20526
Q4: MMBT2222A; SOT-23; LCSC C8512
Q5: S8550; SOT-23; LCSC C105432
Q6, Q7: AO3400A; SOT-23; LCSC C20917
R1: 1k; R_0603_1608Metric; LCSC C21190
R2, R13, R14: 100k; R_0603_1608Metric; LCSC C25803
R3, R6, R8, R10: 10k; R_0603_1608Metric; LCSC C25804
R4: 1.2k; R_0805_2012Metric; LCSC C17379
R5: 10R; R_0603_1608Metric; LCSC C22859
R7, R9: 30k; R_0603_1608Metric; LCSC C22984
R11, R12: 100R; R_0603_1608Metric; LCSC C22775
TP1: VIN; TestPoint_THTPad_D2.0mm_Drill1.0mm
TP2: SW; TestPoint_THTPad_D2.0mm_Drill1.0mm
TP3: GATE; TestPoint_THTPad_D2.0mm_Drill1.0mm
TP4: VOUT; TestPoint_THTPad_D2.0mm_Drill1.0mm
TP5: PWM; TestPoint_THTPad_D2.0mm_Drill1.0mm
TP6, TP7, TP8: GND; TestPoint_THTPad_D2.0mm_Drill1.0mm
TP9: BOOT; TestPoint_THTPad_D2.0mm_Drill1.0mm
TP10: TRIG; TestPoint_THTPad_D2.0mm_Drill1.0mm

Connections:
BOOT: C9.1, D2.1 (K), Q4.3 (C), R4.1, TP9.1 (1_1)
DRV_B: Q3.3 (C), Q4.1 (B), Q5.1 (B), R4.2
DRV_E: Q4.2 (E), Q5.2 (E), R5.1
DRV_IN: Q2.3 (C), Q3.1 (B), R3.2
GATE: Q1.1 (G), R5.2, R6.1, TP3.1 (1_1)
GND: C1.2, C2.2, C3.2, C4.2, C5.2, C6.2, C7.2, C8.2, C10.2, C11.2, D1.2 (A), J1.2, J2.2, J5.4, J6.2, Q2.2 (E), Q3.2 (E), Q6.2 (S), Q7.2 (S), R2.2, R8.2, R10.2, R13.2, R14.2, TP6.1 (1_1), TP7.1 (1_1), TP8.1 (1_1)
LOAD_A: J3.2, Q6.3 (D)
LOAD_B: J4.2, Q7.3 (D)
LSW_A: J5.5, R11.1
LSW_B: J5.6, R12.2
unnamed: J6.9, TP10.1 (1_1)
unnamed: Q2.1 (B), R1.2, R2.1
unnamed: Q6.1 (G), R11.2, R13.1
unnamed: Q7.1 (G), R12.1, R14.1
PWM: J5.12, R1.1, TP5.1 (1_1)
SW: C9.2, D1.1 (K), L1.2, Q1.3 (S), Q5.3 (C), R6.2, TP2.1 (1_1)
VIN: C1.1, C2.1, C3.1, C4.1, C5.1, D2.2 (A), J1.1, Q1.2 (D), R3.1, R9.1, TP1.1 (1_1)
VIN_SENSE: C11.1, J6.10, R9.2, R10.1
VMID: L1.1, L2.1
VOUT: C6.1, C7.1, C8.1, J2.1, J3.1, J4.1, L2.2, R7.1, TP4.1 (1_1)
VOUT_SENSE: C10.1, J6.11, R7.2, R8.1

Notes on the sheet:
DRIVER
POWER
SENSE
NUCLEO
LOAD

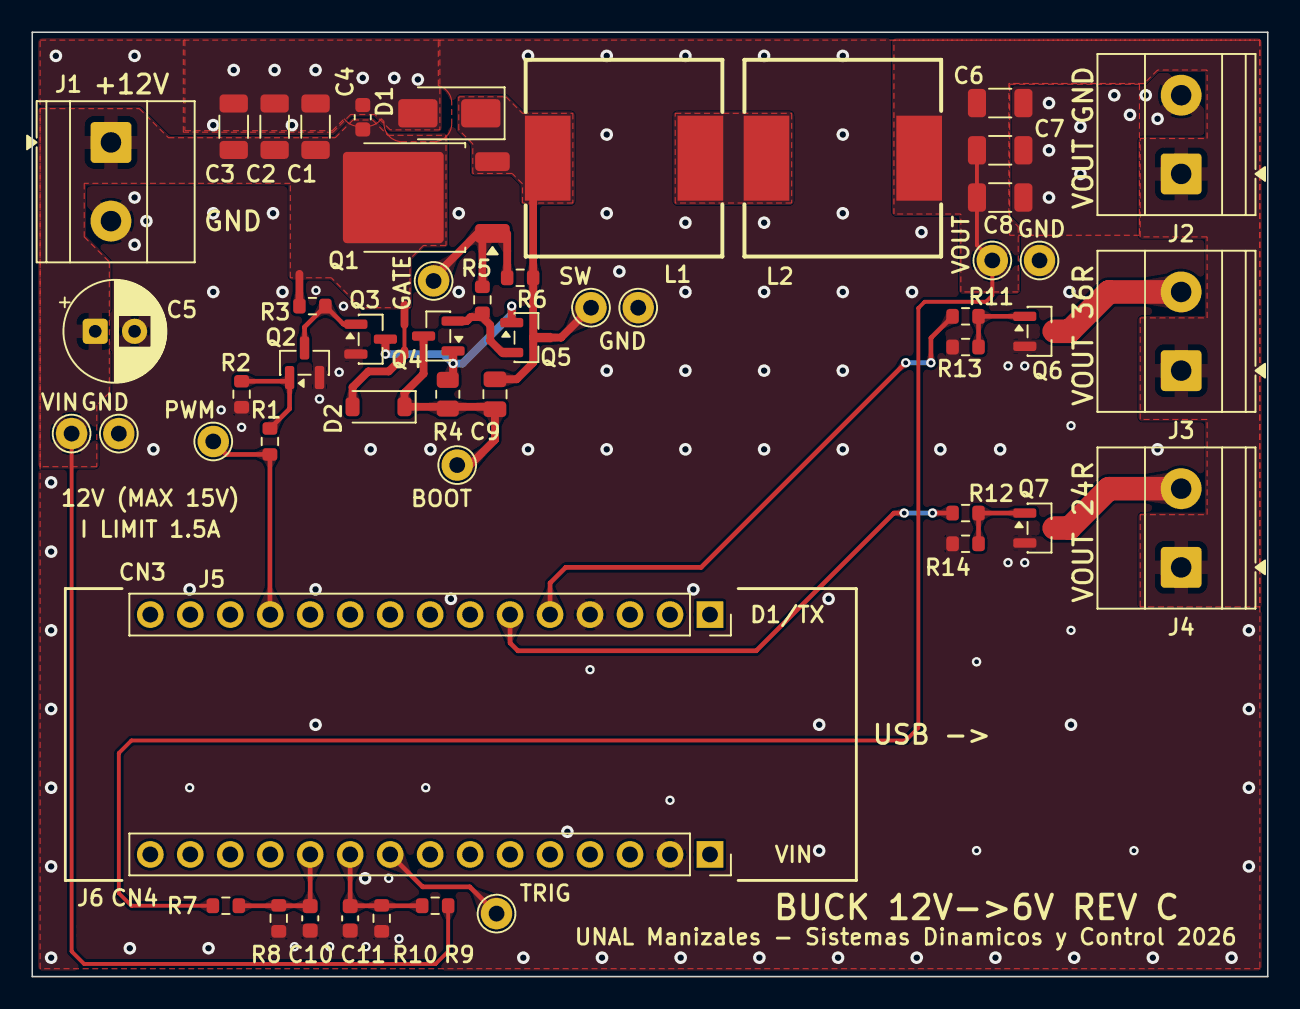
[picture p135: board pcb_revC.kicad_pcb from above]

Board: 2 copper layers, 78.5 x 60.0 mm, 52 parts (0 on the bottom side), 21 nets.
