almondsun/DynamicSystemsAndControl/project/pcb/redesign/buck.kicad_pcb

## KiCad design project/pcb/redesign/buck.kicad_pcb (2026-10-27)

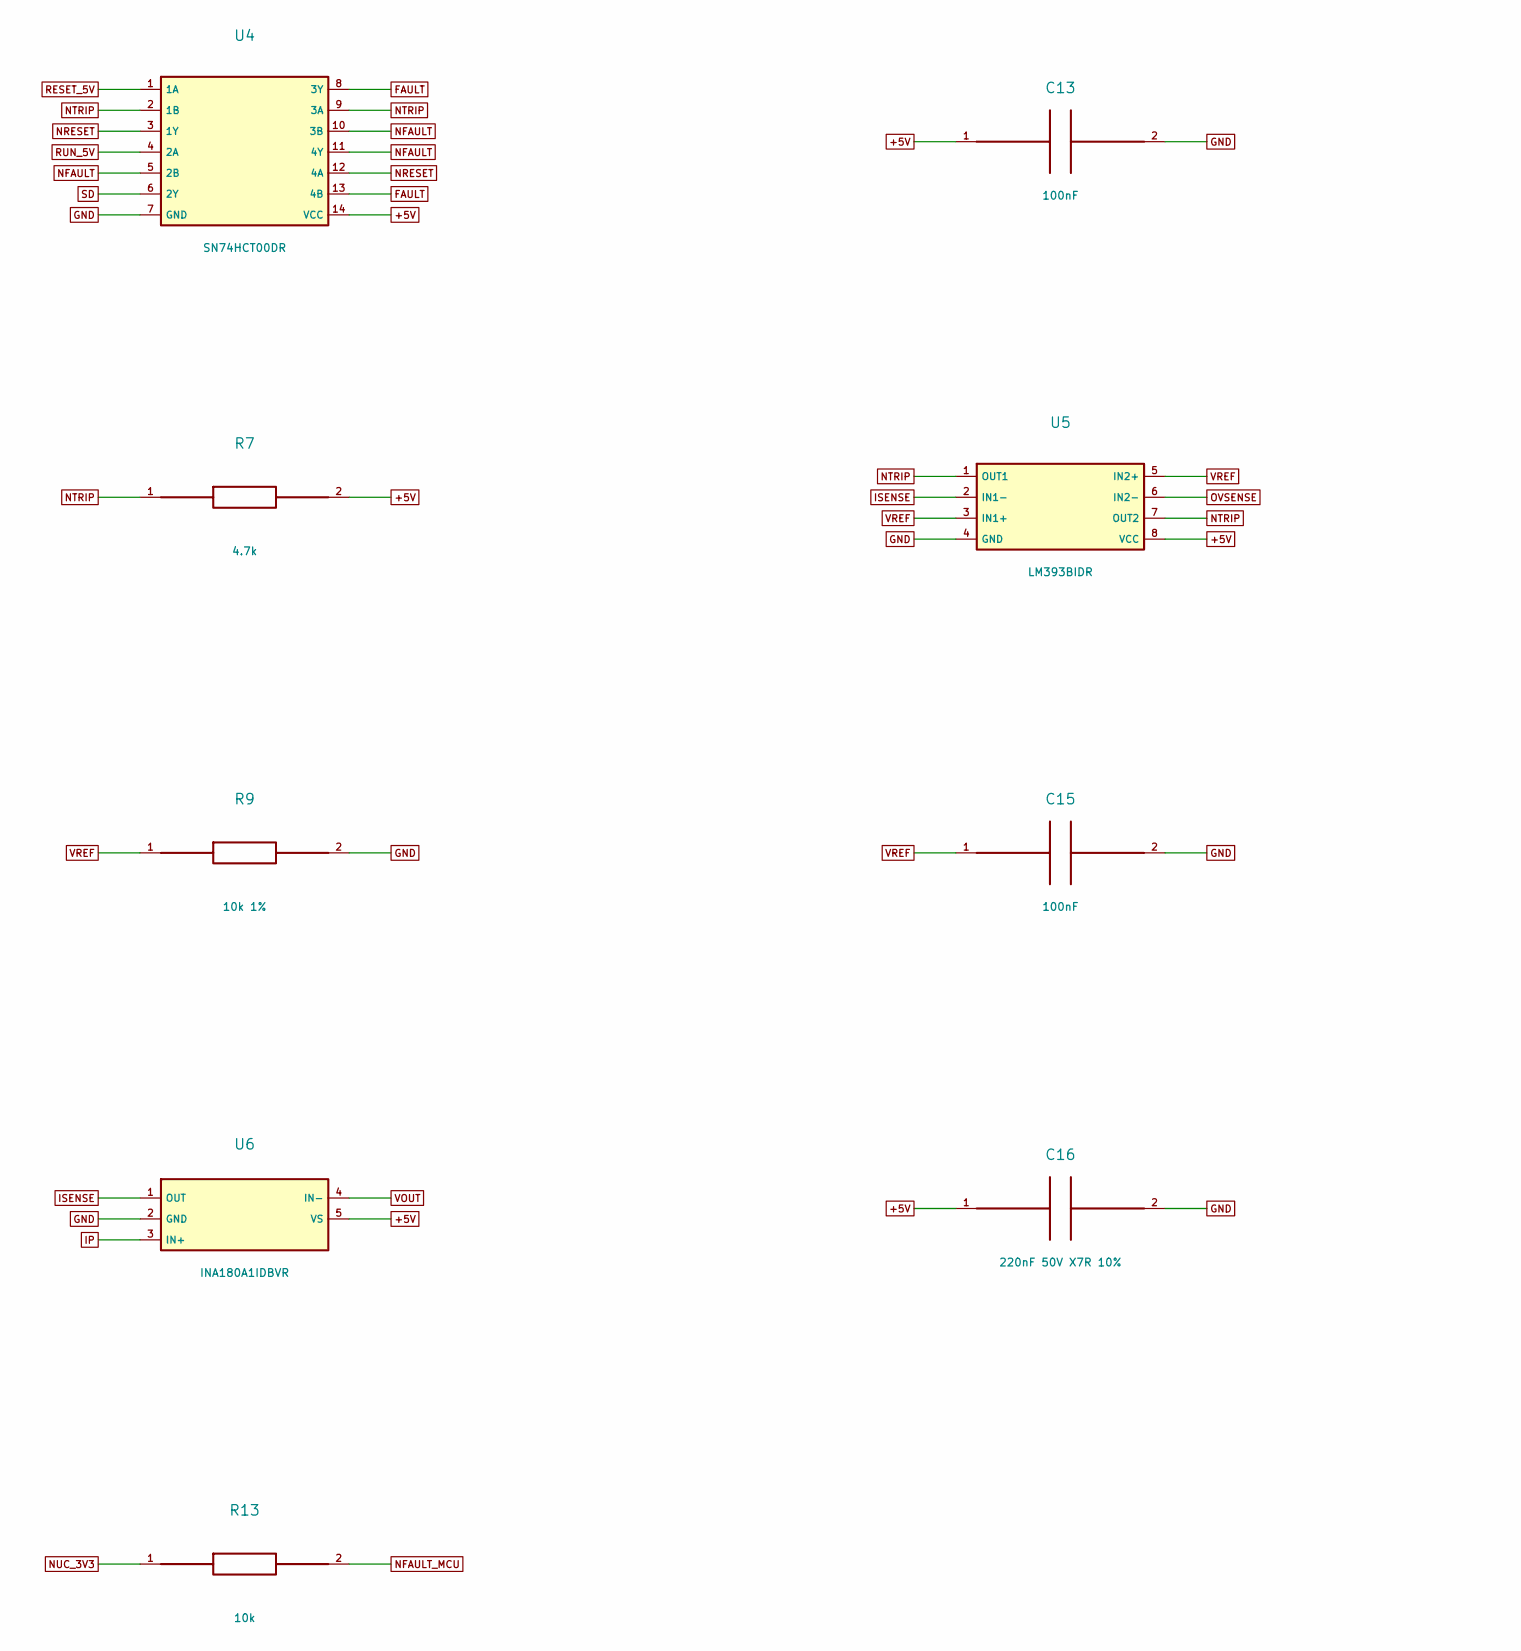
[picture p136: schematic buck_3.kicad_sch, Independent protection - REV B PROTOTYPE, part in row 1, column 1]

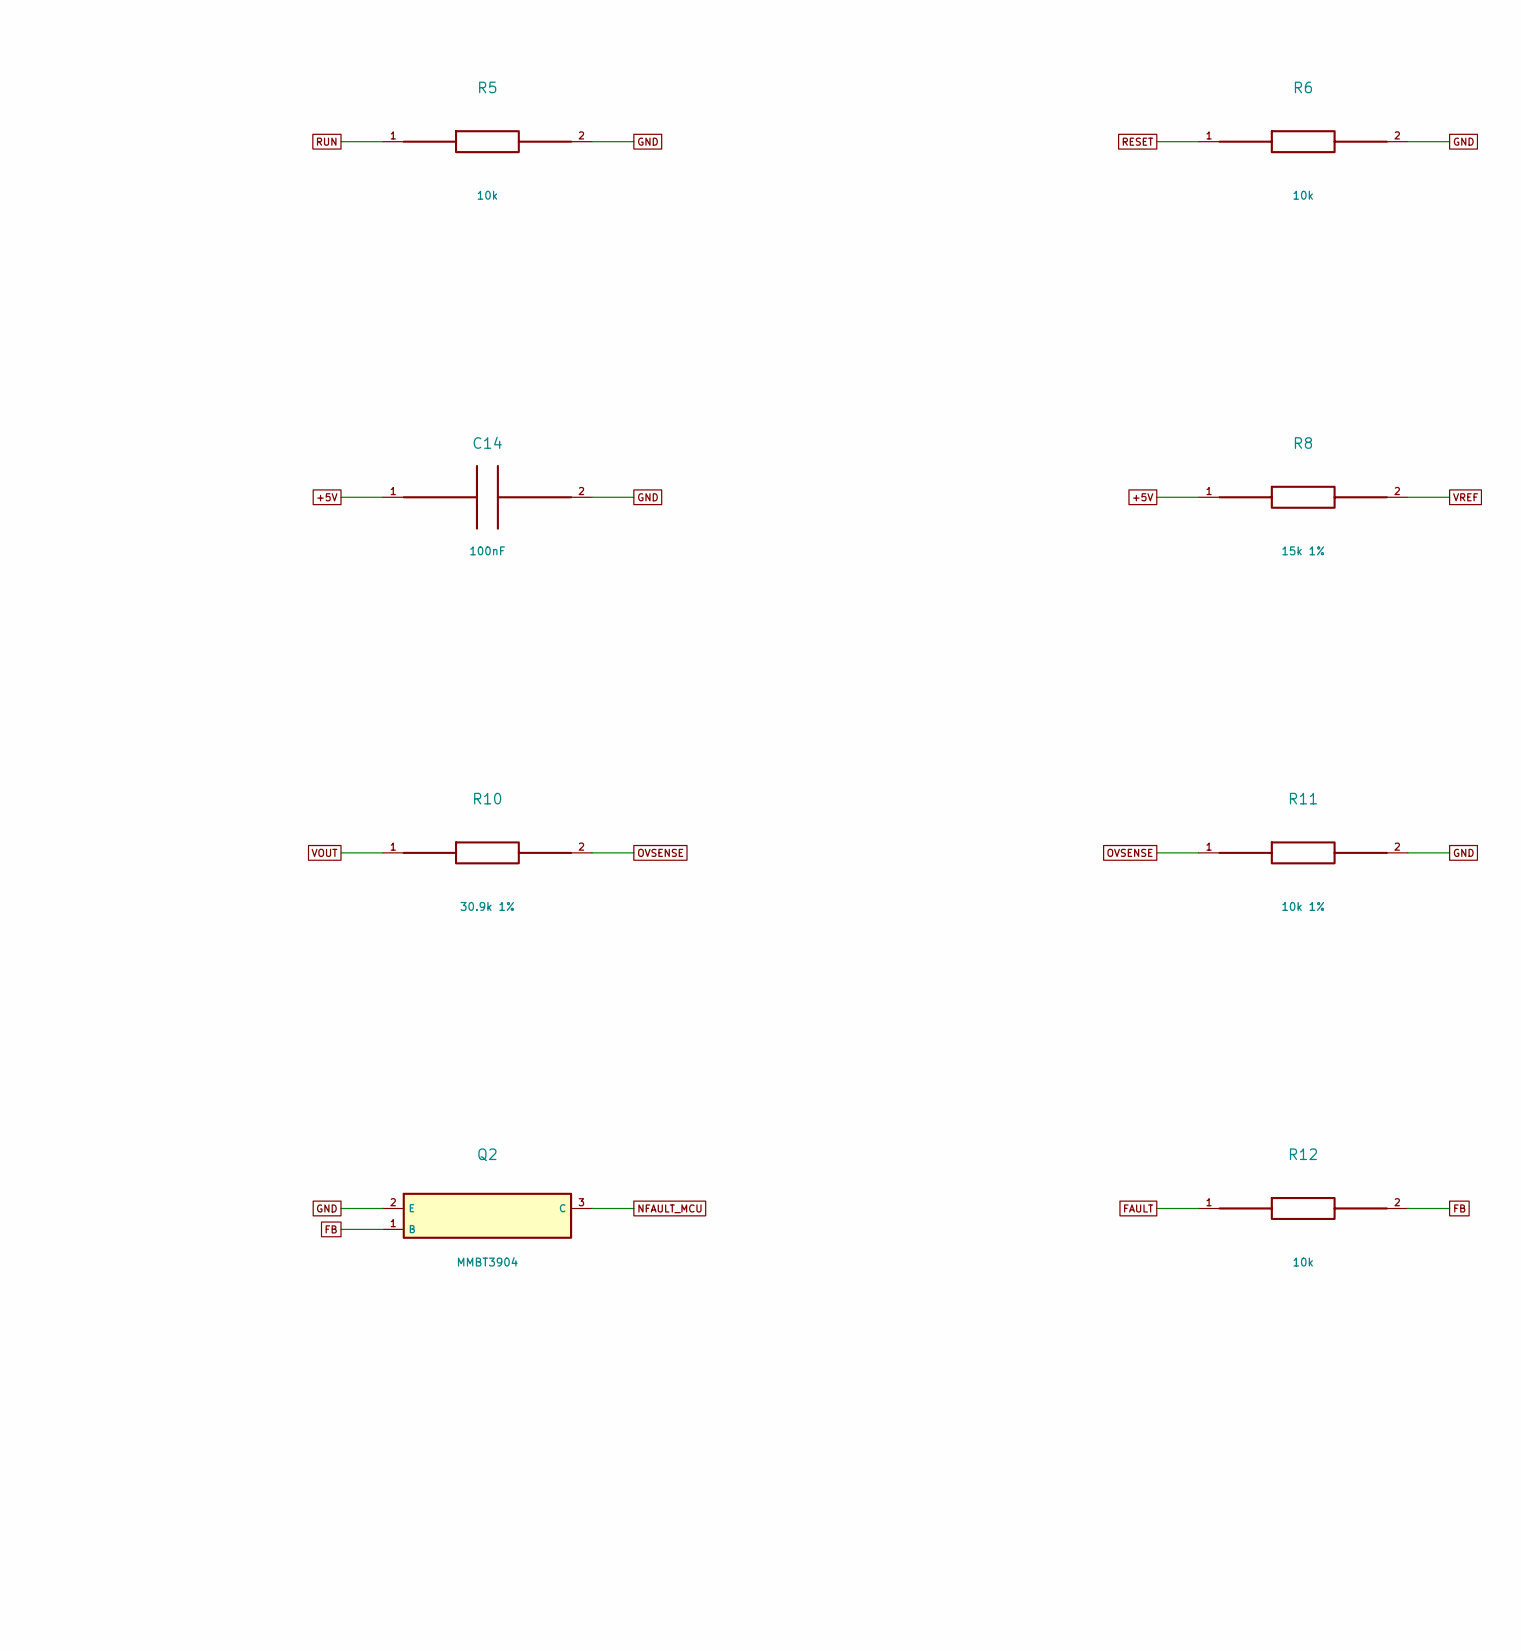
[picture p137: schematic buck_3.kicad_sch, Independent protection - REV B PROTOTYPE, part in row 1, column 2]

Parts:
C13, C14, C15: 100nF; C_0603_1608Metric; MPN Yageo CC0603KRX7R9BB104; LCSC C14663
C16: 220nF 50V X7R 10%; C_0603_1608Metric; MPN CC0603KRX7R9BB224; LCSC C107083
Q2: MMBT3904; SOT-23; MPN MMBT3904; LCSC C20526
R5, R6, R12, R13: 10k; R_0603_1608Metric; MPN UNI-ROYAL 0603WAF1002T5E; LCSC C25804
R7: 4.7k; R_0603_1608Metric; MPN UNI-ROYAL 0603WAF4701T5E; LCSC C23162
R8: 15k 1%; R_0603_1608Metric; MPN UNI-ROYAL 0603WAF1502T5E; LCSC C22809
R9, R11: 10k 1%; R_0603_1608Metric; MPN UNI-ROYAL 0603WAF1002T5E; LCSC C25804
R10: 30.9k 1%; R_0603_1608Metric; MPN 0603WAF3092T5E; LCSC C23022
U4: SN74HCT00DR; TI_D0014A_SOIC-14; MPN SN74HCT00DR; LCSC C6764
U5: LM393BIDR; TI_D0008A_SOIC-8; MPN LM393BIDR; LCSC C2865059
U6: INA180A1IDBVR; TI_DBV0005A_SOT-23-5; MPN INA180A1IDBVR; LCSC C122228

Connections:
+5V: C13.1, C14.1, C16.1, R7.2, R8.1, U4.14 (VCC), U5.8 (VCC), U6.5 (VS); also elsewhere on the board
FAULT: R12.1, U4.8 (3Y), U4.13 (4B)
FB: Q2.1 (B), R12.2
GND: C13.2, C14.2, C15.2, C16.2, Q2.2 (E), R5.2, R6.2, R9.2, R11.2, U4.7 (GND), U5.4 (GND), U6.2 (GND); also elsewhere on the board
IP: U6.3 (IN+); also elsewhere on the board
ISENSE: U5.2 (IN1-), U6.1 (OUT); also elsewhere on the board
NFAULT: U4.5 (2B), U4.10 (3B), U4.11 (4Y)
NFAULT_MCU: Q2.3 (C), R13.2; also elsewhere on the board
NRESET: U4.3 (1Y), U4.12 (4A)
NTRIP: R7.1, U4.2 (1B), U4.9 (3A), U5.1 (OUT1), U5.7 (OUT2); also elsewhere on the board
NUC_3V3: R13.1; also elsewhere on the board
OVSENSE: R10.2, R11.1, U5.6 (IN2-)
RESET: R6.1; also elsewhere on the board
RESET_5V: U4.1 (1A); also elsewhere on the board
RUN: R5.1; also elsewhere on the board
RUN_5V: U4.4 (2A); also elsewhere on the board
SD: U4.6 (2Y); also elsewhere on the board
VOUT: R10.1, U6.4 (IN-); also elsewhere on the board
VREF: C15.1, R8.2, R9.1, U5.3 (IN1+), U5.5 (IN2+)

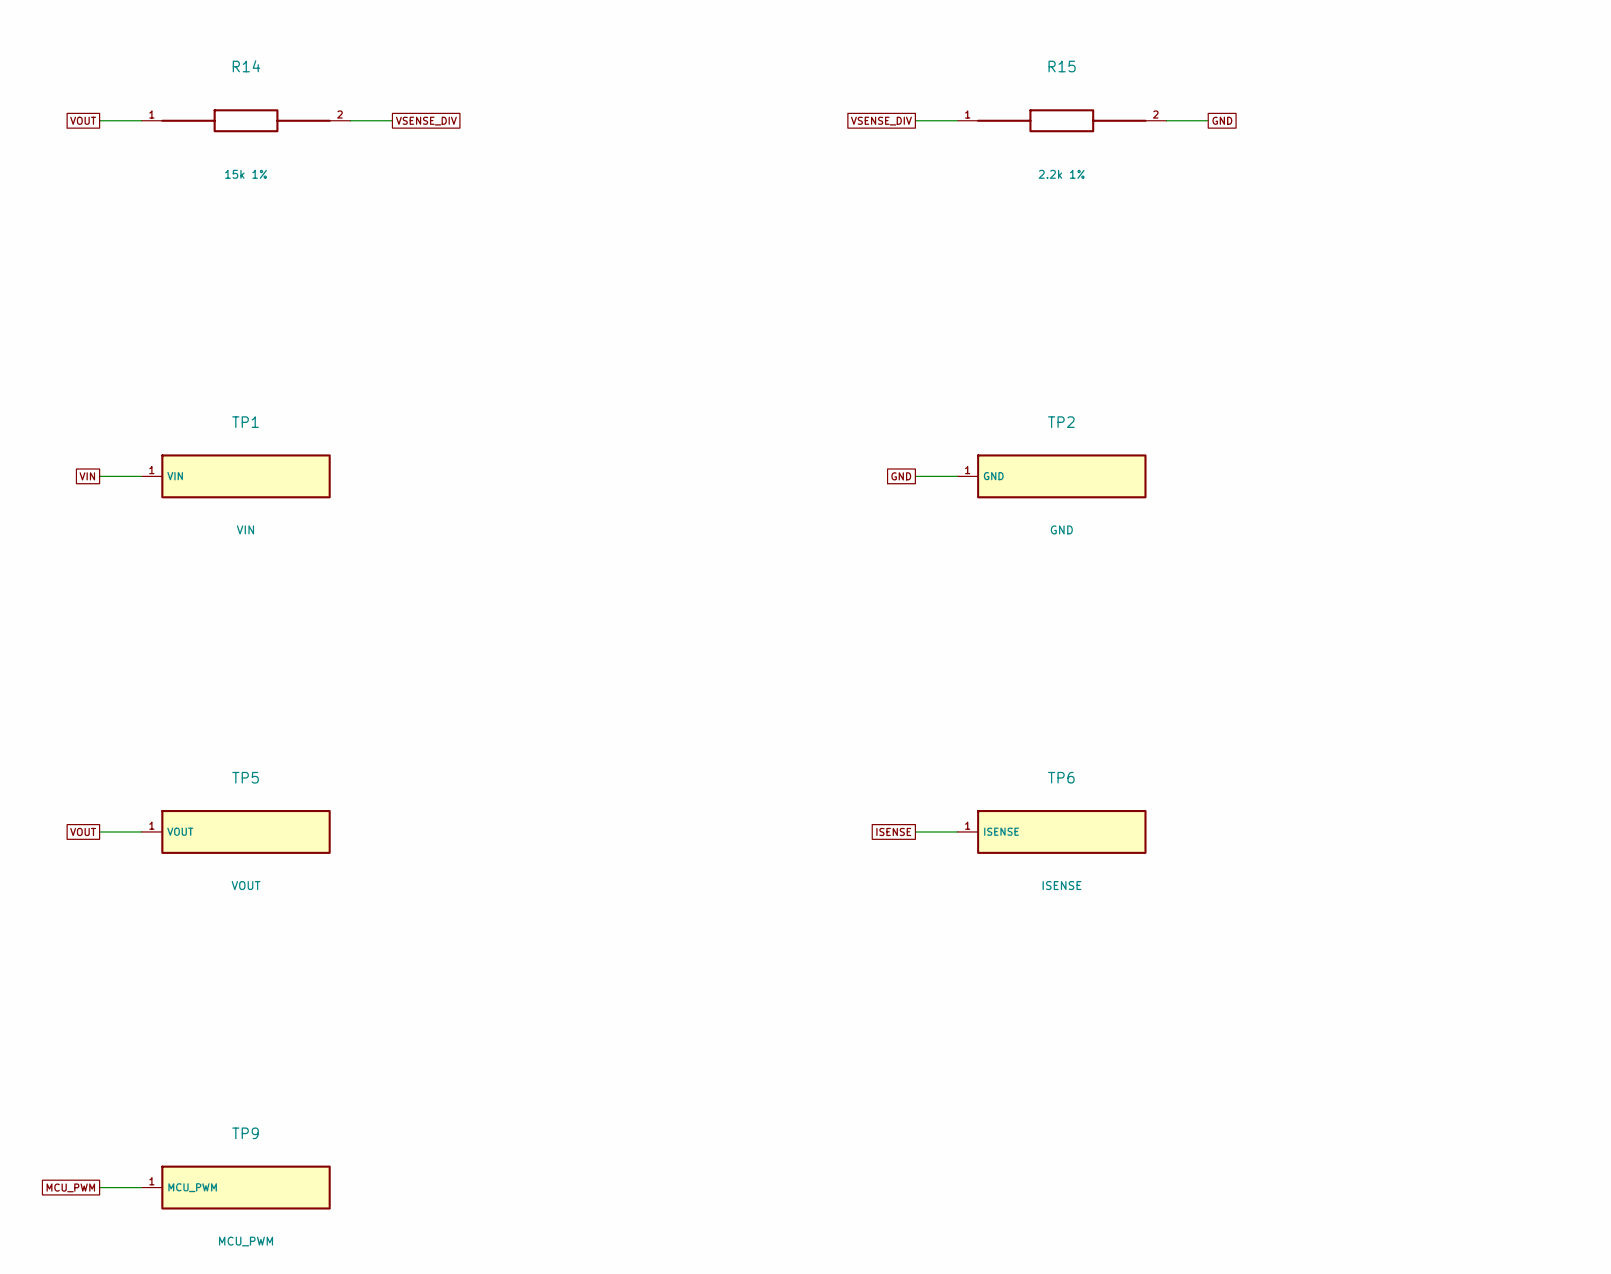
[picture p138: schematic buck_4.kicad_sch, STM32 interface and test points - REV B PROTOTYPE, part in row 1, column 1]

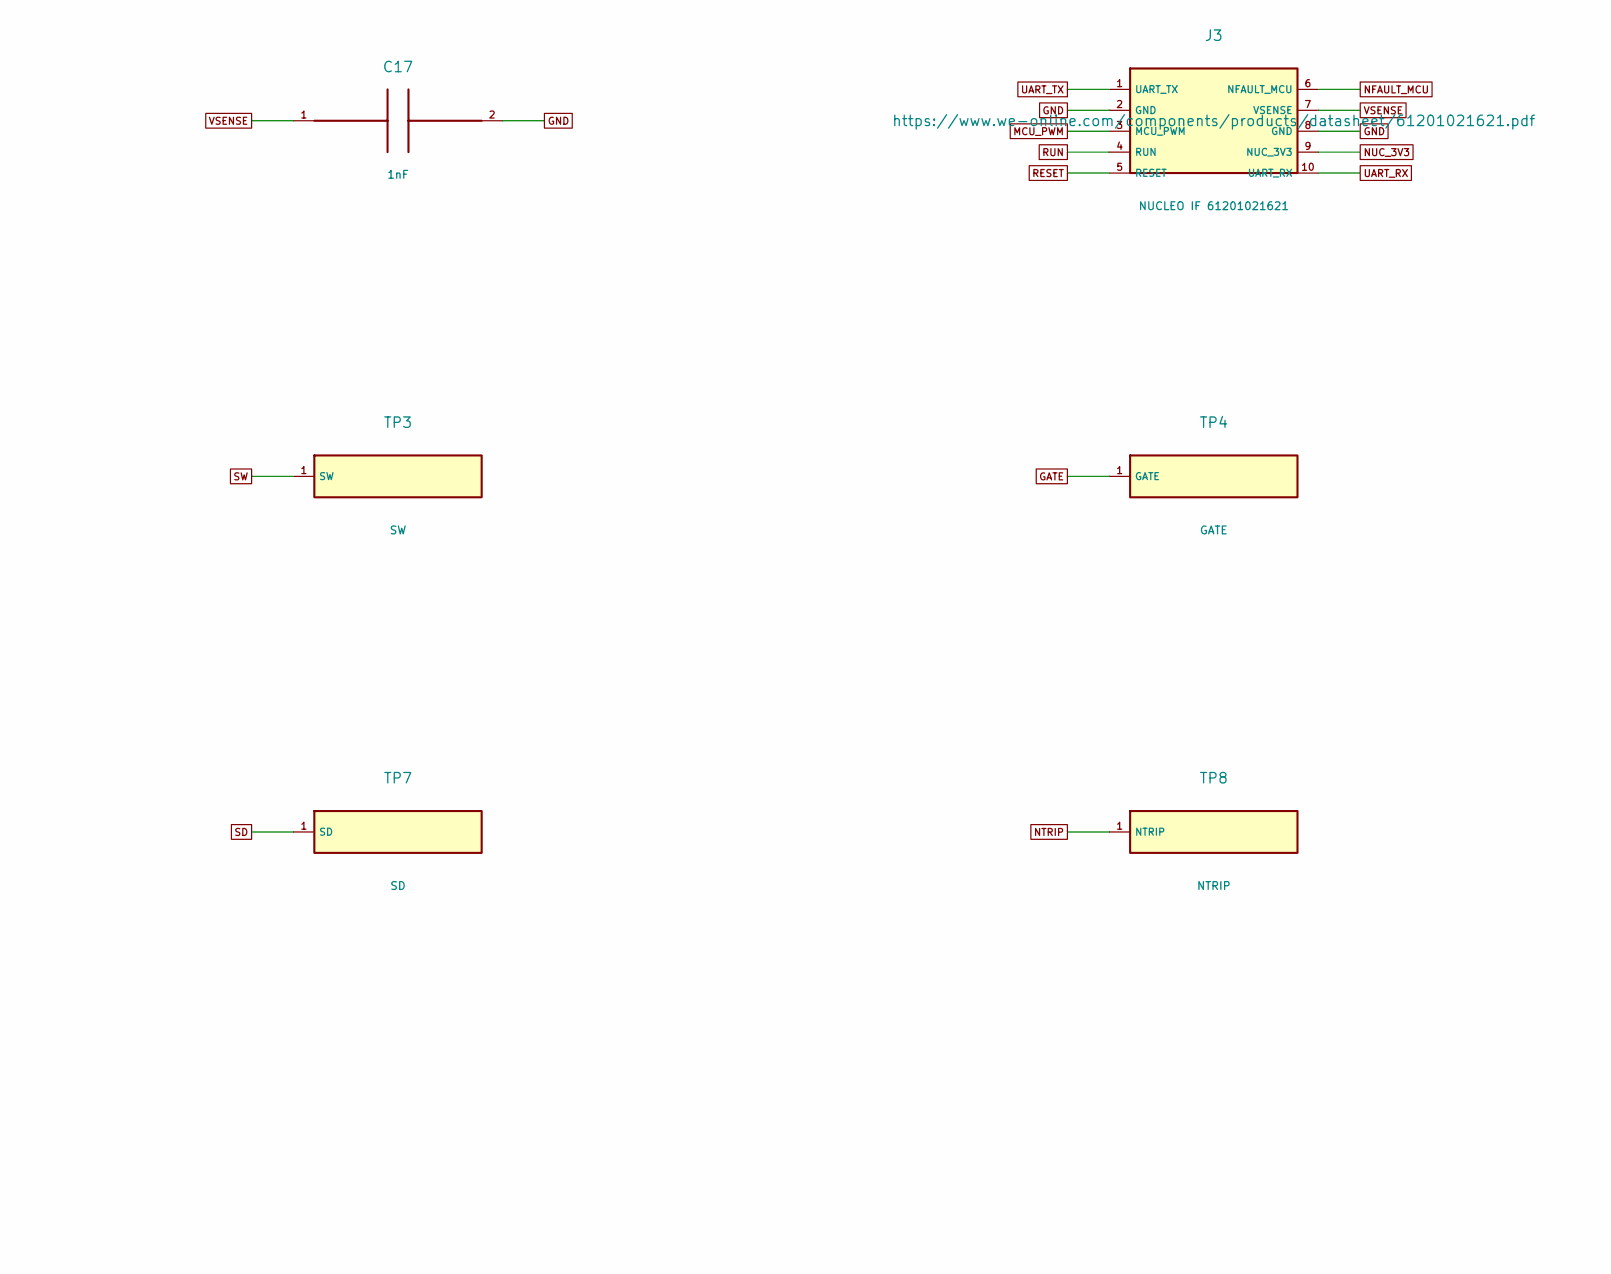
[picture p139: schematic buck_4.kicad_sch, STM32 interface and test points - REV B PROTOTYPE, part in row 1, column 2]

Parts:
C17: 1nF; C_0603_1608Metric; MPN Fenghua 0603CG102J500NT; LCSC C1636
J3: NUCLEO IF 61201021621; Wurth_WR-BHD_61201021621_2x05_P2.54mm_Vertical; MPN 61201021621; LCSC C4355000
R14: 15k 1%; R_0603_1608Metric; MPN 0603WAF1502T5E; LCSC C22809
R15: 2.2k 1%; R_0603_1608Metric; MPN 0603WAF2201T5E; LCSC C4190
TP1: VIN; TestPoint_THTPad_D2.0mm_Drill1.0mm
TP2: GND; TestPoint_THTPad_D2.0mm_Drill1.0mm
TP3: SW; TestPoint_THTPad_D2.0mm_Drill1.0mm
TP4: GATE; TestPoint_THTPad_D2.0mm_Drill1.0mm
TP5: VOUT; TestPoint_THTPad_D2.0mm_Drill1.0mm
TP6: ISENSE; TestPoint_THTPad_D2.0mm_Drill1.0mm
TP7: SD; TestPoint_THTPad_D2.0mm_Drill1.0mm
TP8: NTRIP; TestPoint_THTPad_D2.0mm_Drill1.0mm
TP9: MCU_PWM; TestPoint_THTPad_D2.0mm_Drill1.0mm

Connections:
GATE: TP4.1 (GATE_1); also elsewhere on the board
GND: C17.2, J3.2 (GND), J3.8 (GND), R15.2, TP2.1 (GND_1); also elsewhere on the board
ISENSE: TP6.1 (ISENSE_1); also elsewhere on the board
MCU_PWM: J3.3 (MCU_PWM), TP9.1 (MCU_PWM_1); also elsewhere on the board
NFAULT_MCU: J3.6 (NFAULT_MCU); also elsewhere on the board
NTRIP: TP8.1 (NTRIP_1); also elsewhere on the board
NUC_3V3: J3.9 (NUC_3V3); also elsewhere on the board
RESET: J3.5 (RESET); also elsewhere on the board
RUN: J3.4 (RUN); also elsewhere on the board
SD: TP7.1 (SD_1); also elsewhere on the board
SW: TP3.1 (SW_1); also elsewhere on the board
UART_RX: J3.10 (UART_RX)
UART_TX: J3.1 (UART_TX)
VIN: TP1.1 (VIN_1); also elsewhere on the board
VOUT: R14.1, TP5.1 (VOUT_1); also elsewhere on the board
VSENSE: C17.1, J3.7 (VSENSE); also elsewhere on the board
VSENSE_DIV: R14.2, R15.1; also elsewhere on the board

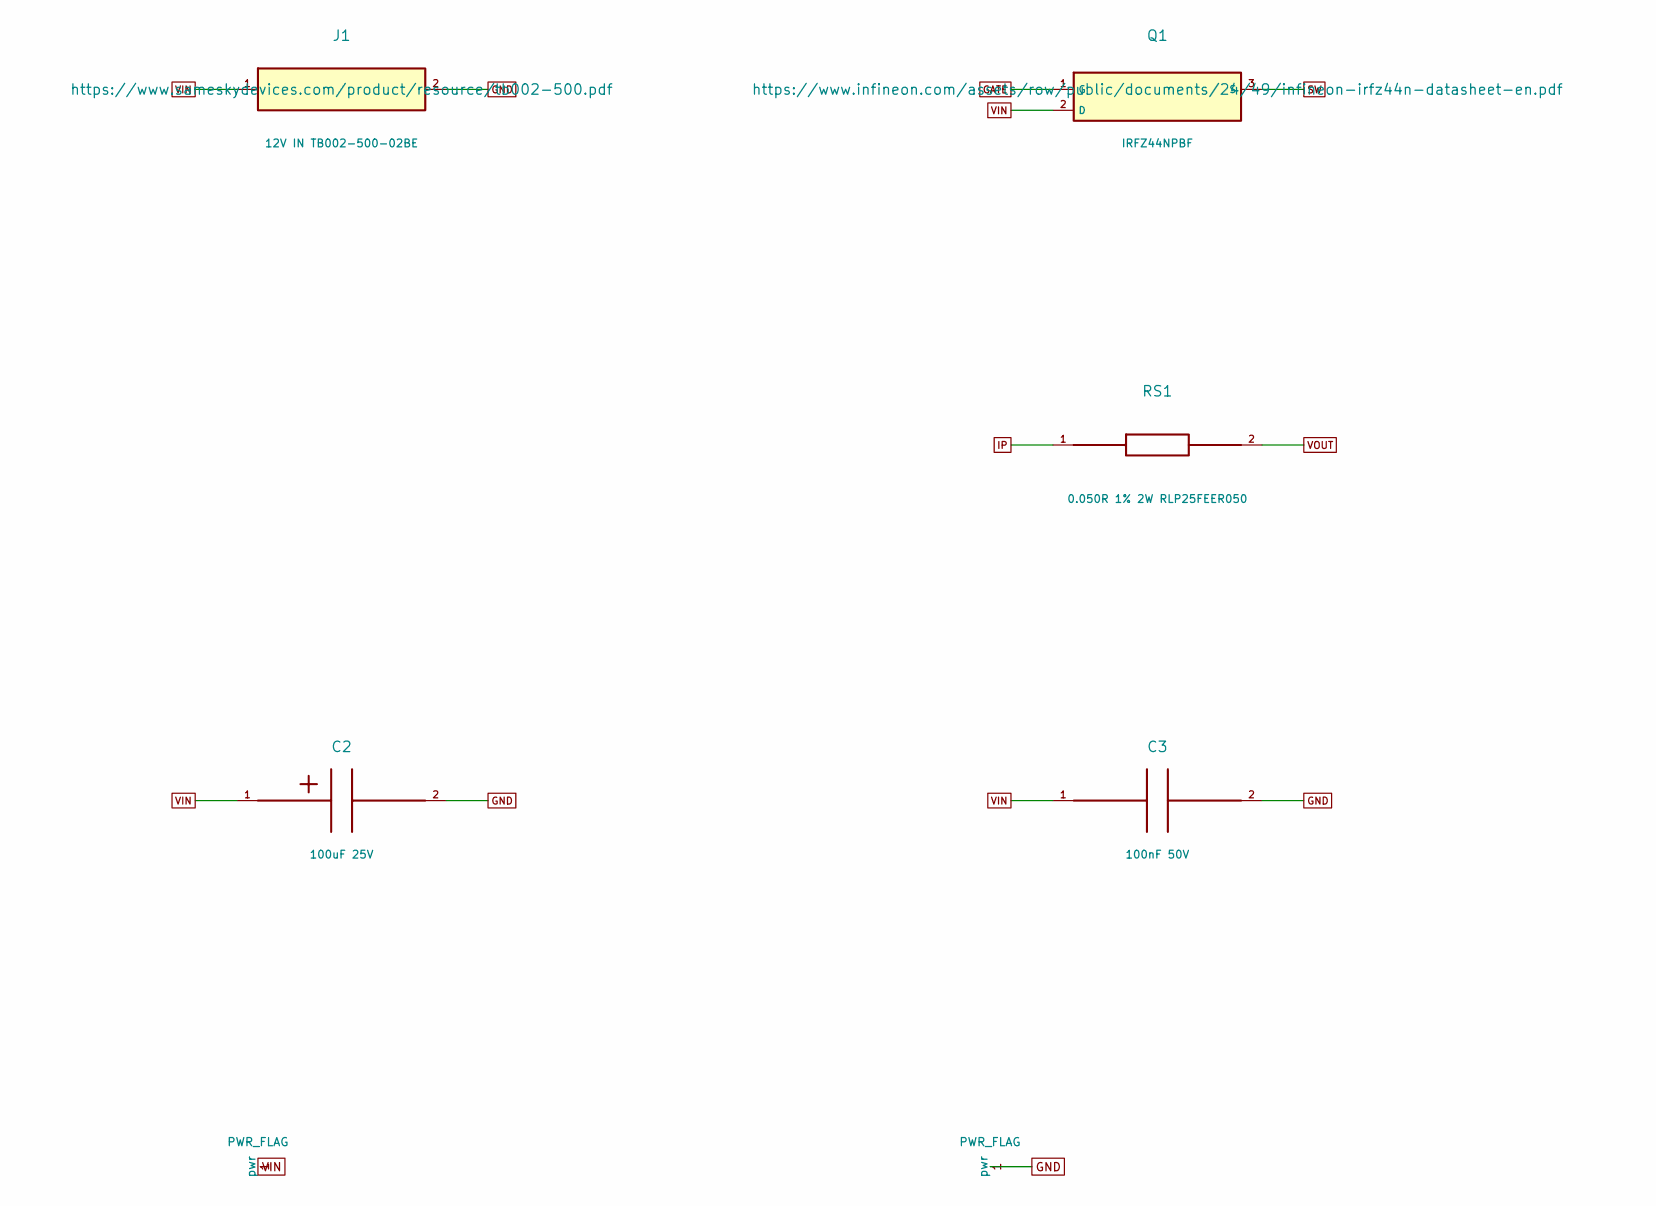
[picture p140: schematic buck_1.kicad_sch, Power stage - REV B PROTOTYPE, part in row 1, column 1]

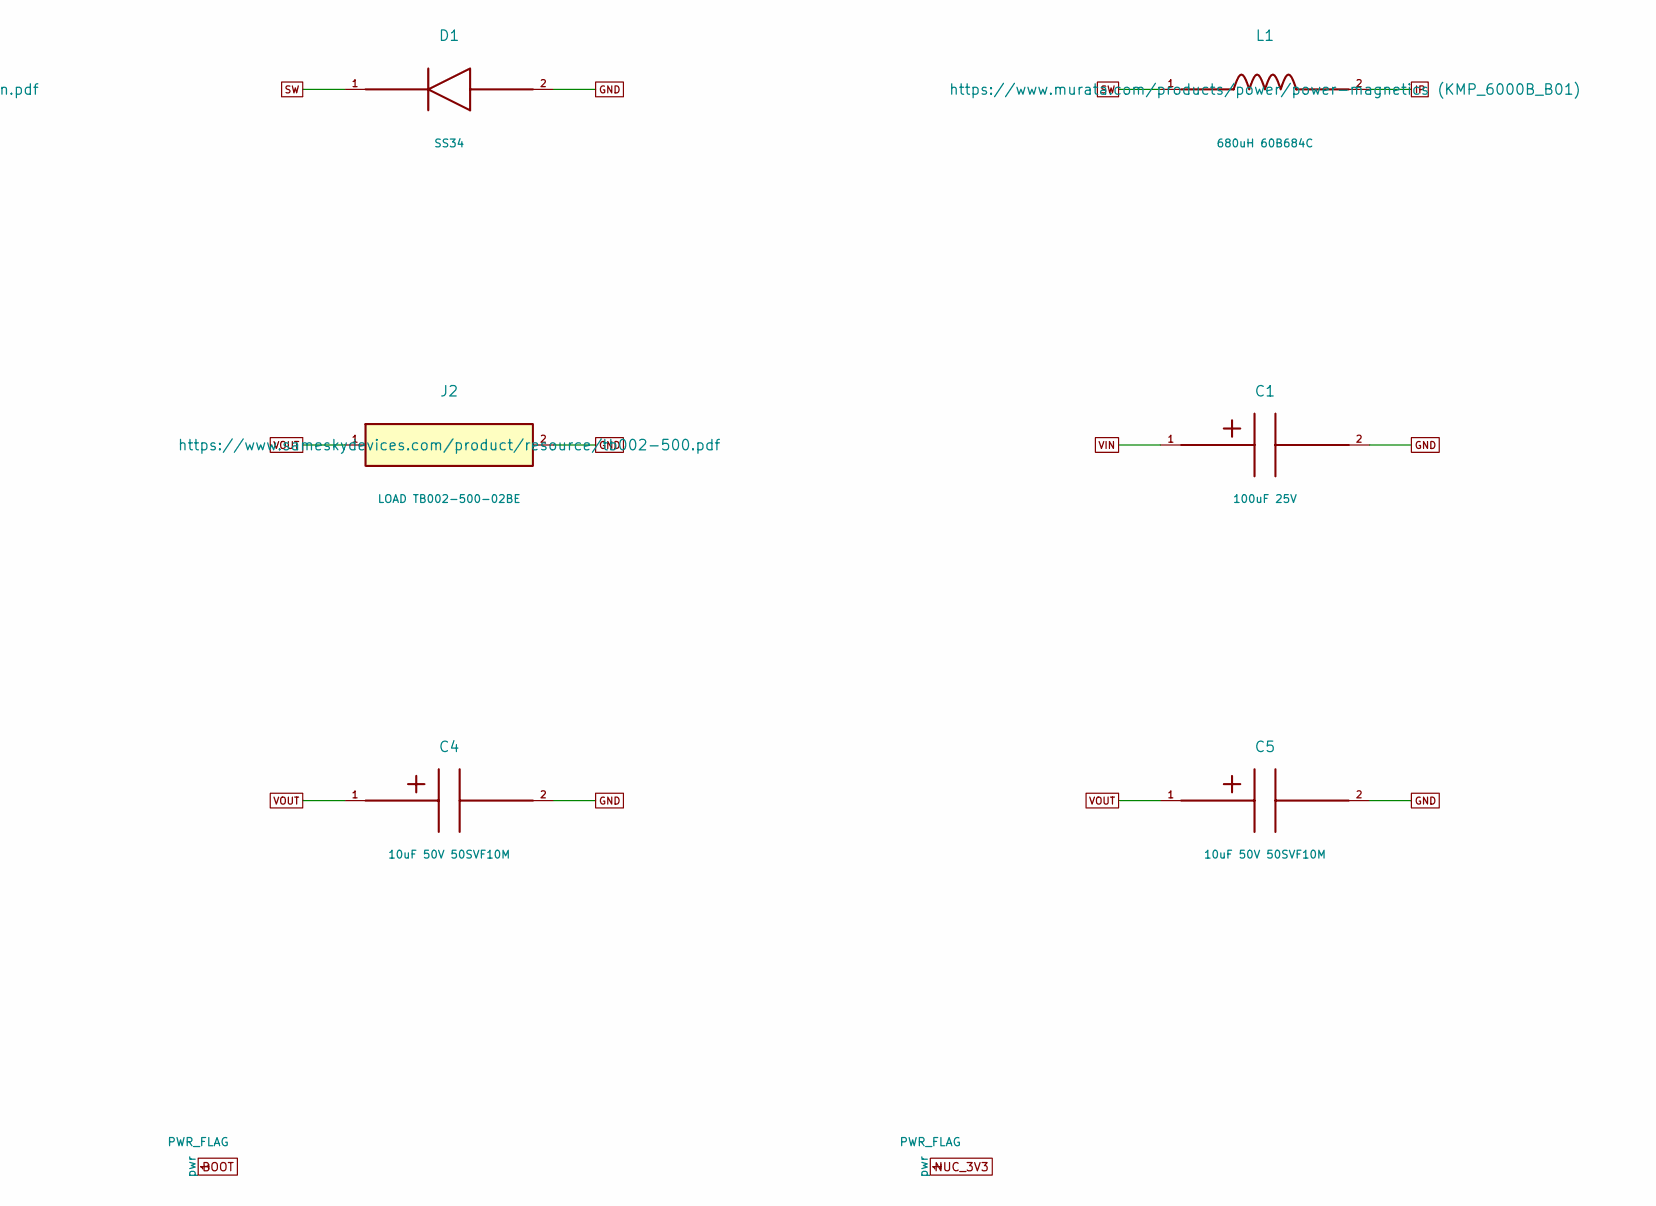
[picture p141: schematic buck_1.kicad_sch, Power stage - REV B PROTOTYPE, part in row 1, column 2]

Parts:
C1, C2: 100uF 25V; CP_Panasonic_SVPF_E7_Land; MPN Panasonic 25SVPF100M; LCSC C136279
C3: 100nF 50V; C_0603_1608Metric; MPN Yageo CC0603KRX7R9BB104; LCSC C14663
C4, C5: 10uF 50V 50SVF10M; CP_Panasonic_SVF_C6_Land; MPN Panasonic 50SVF10M; LCSC C454354
D1: SS34; D_SMA; MPN SS34; LCSC C8678
J1: 12V IN TB002-500-02BE; TerminalBlock_SameSky_TB002-500-02_1x02_P5.00mm; MPN TB002-500-02BE; LCSC C2757858
J2: LOAD TB002-500-02BE; TerminalBlock_SameSky_TB002-500-02_1x02_P5.00mm; MPN TB002-500-02BE; LCSC C2757858
L1: 680uH 60B684C; L_Murata_6000B_27.0x23.5mm; MPN 60B684C; LCSC C6095796
Q1: IRFZ44NPBF; TO-220-3_Vertical_Drill1.4; MPN IRFZ44NPBF; LCSC C2586
RS1: 0.050R 1% 2W RLP25FEER050; R_TAI_RLP25_2512_Kelvin; MPN TA-I RLP25FEER050; LCSC C160588

Connections:
GATE: Q1.1 (G); also elsewhere on the board
GND: C1.2, C2.2, C3.2, C4.2, C5.2, D1.2, J1.2, J2.2; also elsewhere on the board
IP: L1.2, RS1.1; also elsewhere on the board
SW: D1.1, L1.1, Q1.3 (S); also elsewhere on the board
VIN: C1.1, C2.1, C3.1, J1.1, Q1.2 (D); also elsewhere on the board
VOUT: C4.1, C5.1, J2.1, RS1.2; also elsewhere on the board
