almondsun/DynamicSystemsAndControl/project/pcb/redesign/buck.kicad_pcb

## KiCad design project/pcb/redesign/buck.kicad_pcb (continued)

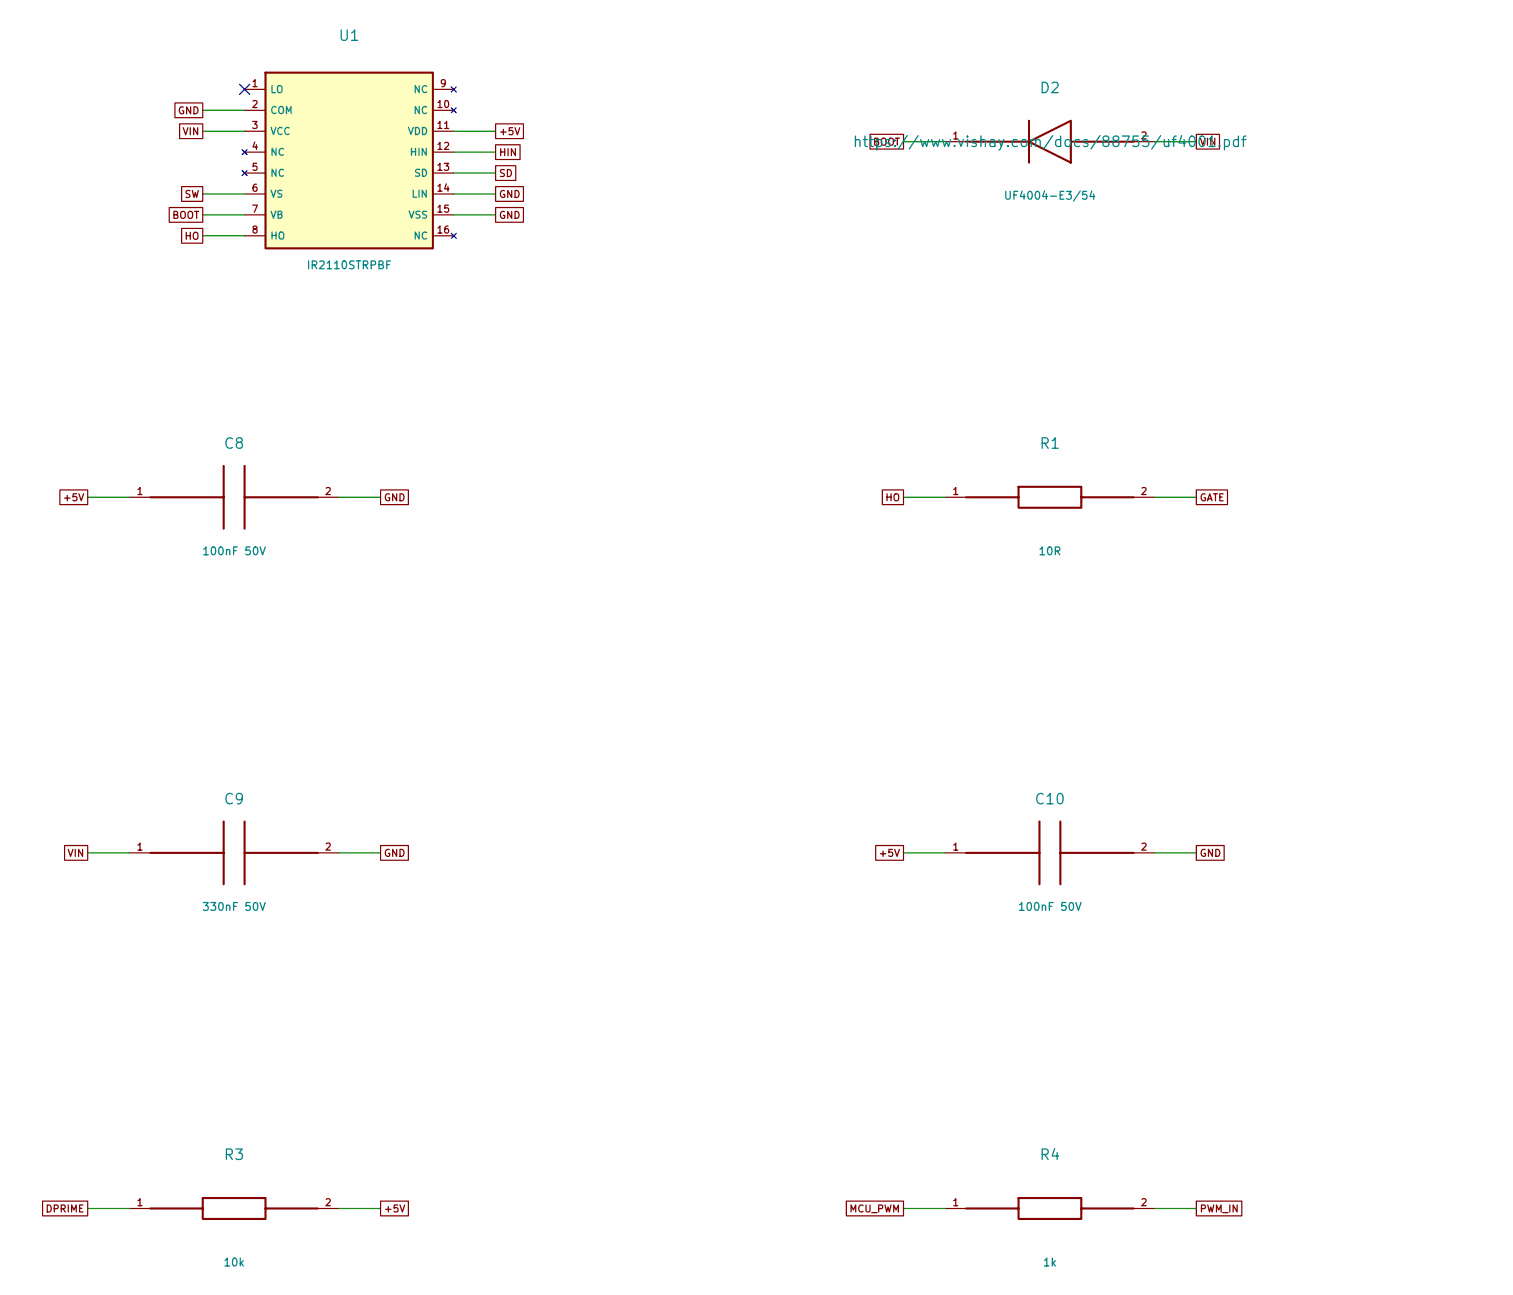
[picture p142: schematic buck_2.kicad_sch, Gate driver and supplies - REV B PROTOTYPE, part in row 1, column 1]

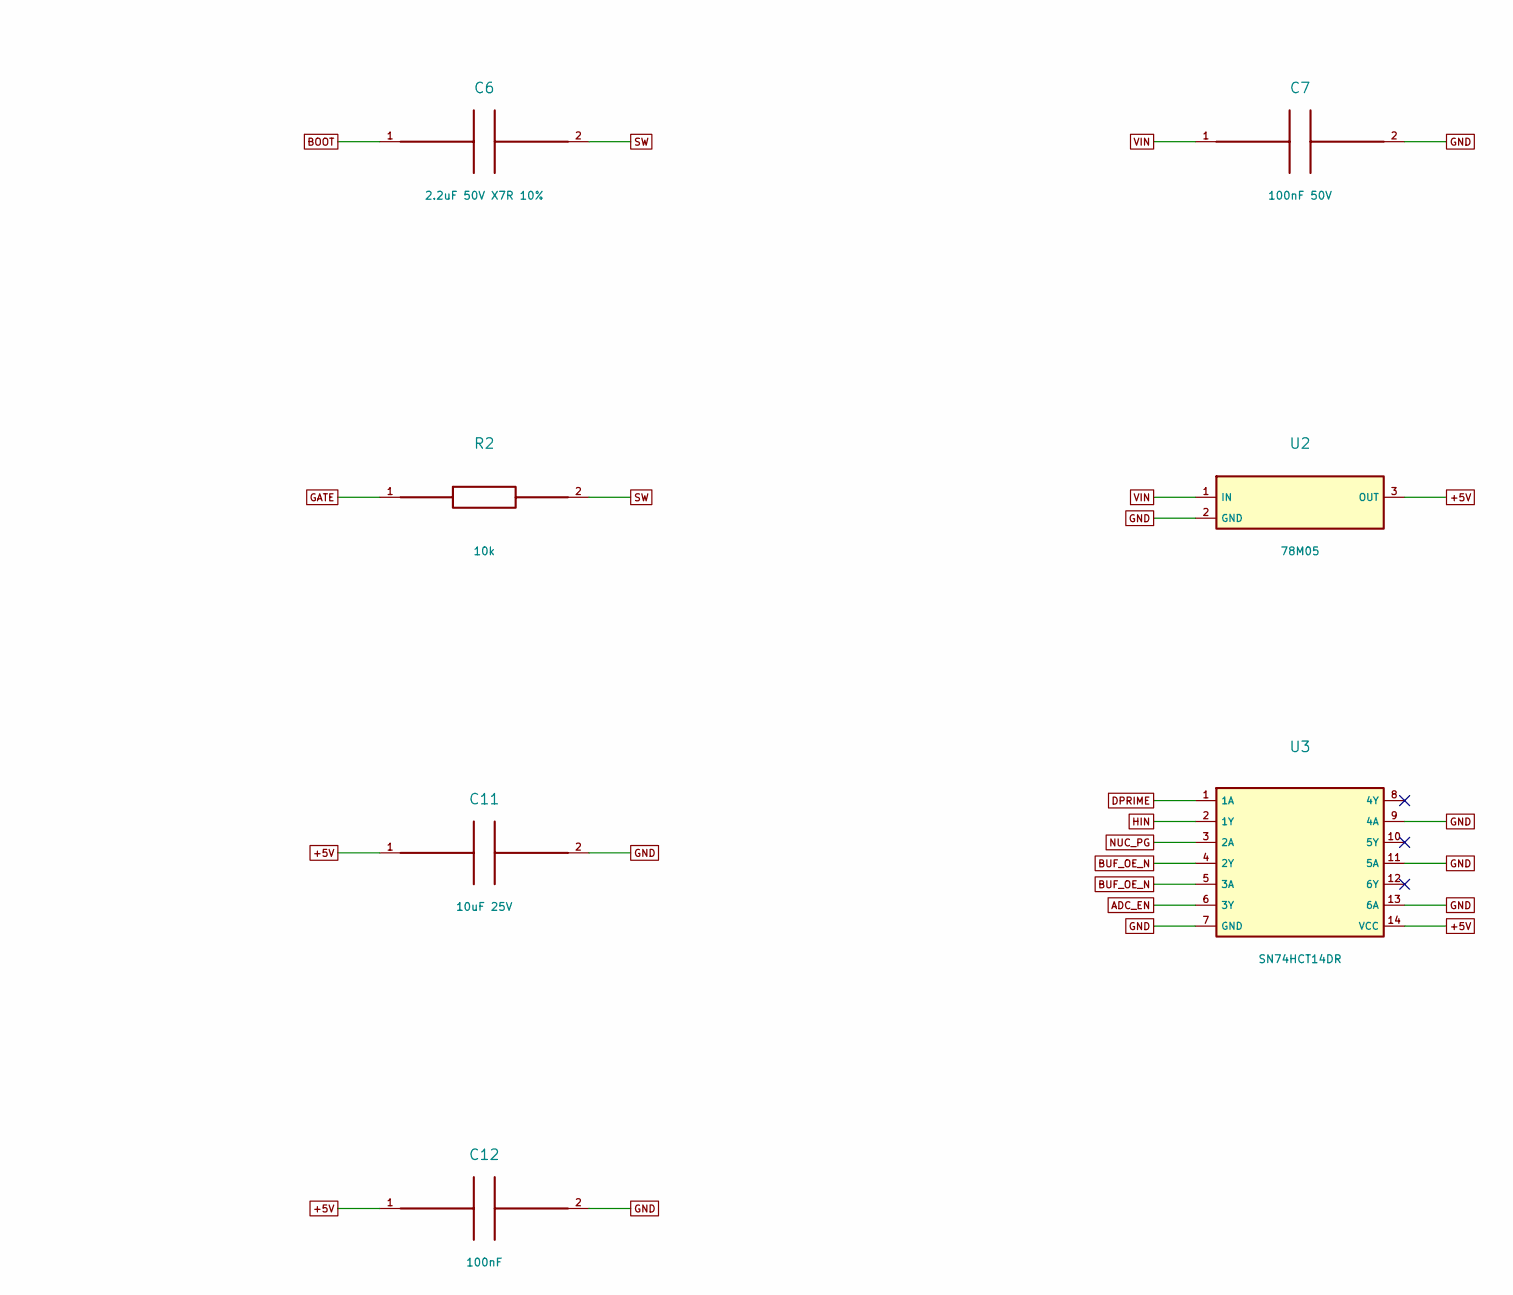
[picture p143: schematic buck_2.kicad_sch, Gate driver and supplies - REV B PROTOTYPE, part in row 1, column 2]

Parts:
C6: 2.2uF 50V X7R 10%; C_1206_3216Metric; MPN CL31B225KBHNNNE; LCSC C50254
C7, C8, C10: 100nF 50V; C_0603_1608Metric; MPN Yageo CC0603KRX7R9BB104; LCSC C14663
C9: 330nF 50V; C_0805_2012Metric; MPN Samsung CL21B334KBFNNNE; LCSC C73142
C11: 10uF 25V; C_0805_2012Metric; MPN Samsung CL21A106KAYNNNE; LCSC C15850
C12: 100nF; C_0603_1608Metric; MPN Yageo CC0603KRX7R9BB104; LCSC C14663
D2: UF4004-E3/54; D_DO-41_SOD81_P10.16mm_Horizontal; MPN UF4004-E3/54; LCSC C5137033
R1: 10R; R_0805_2012Metric; MPN UNI-ROYAL 0805W8F100JT5E; LCSC C17415
R2, R3: 10k; R_0603_1608Metric; MPN UNI-ROYAL 0603WAF1002T5E; LCSC C25804
R4: 1k; R_0603_1608Metric; MPN UNI-ROYAL 0603WAF1001T5E; LCSC C21190
U1: IR2110STRPBF; SOIC-16W_7.5x10.3mm_P1.27mm; MPN IR2110STRPBF; LCSC C2968
U2: 78M05; TO-252-2; MPN 78M05; LCSC C347278
U3: SN74HCT14DR; TI_D0014A_SOIC-14; MPN SN74HCT14DR; LCSC C6769

Connections:
+5V: C8.1, C10.1, C11.1, C12.1, R3.2, U1.11 (VDD), U2.3 (OUT), U3.14 (VCC); also elsewhere on the board
ADC_EN: U3.6 (3Y); also elsewhere on the board
BOOT: C6.1, D2.1, U1.7 (VB)
BUF_OE_N: U3.4 (2Y), U3.5 (3A); also elsewhere on the board
DPRIME: R3.1, U3.1 (1A); also elsewhere on the board
GATE: R1.2, R2.1; also elsewhere on the board
GND: C7.2, C8.2, C9.2, C10.2, C11.2, C12.2, U1.2 (COM), U1.14 (LIN), U1.15 (VSS), U2.2 (GND), U3.7 (GND), U3.9 (4A), U3.11 (5A), U3.13 (6A); also elsewhere on the board
HIN: U1.12 (HIN), U3.2 (1Y)
HO: R1.1, U1.8 (HO)
MCU_PWM: R4.1; also elsewhere on the board
NUC_PG: U3.3 (2A); also elsewhere on the board
PWM_IN: R4.2; also elsewhere on the board
SD: U1.13 (SD); also elsewhere on the board
SW: C6.2, R2.2, U1.6 (VS); also elsewhere on the board
VIN: C7.1, C9.1, D2.2, U1.3 (VCC), U2.1 (IN); also elsewhere on the board

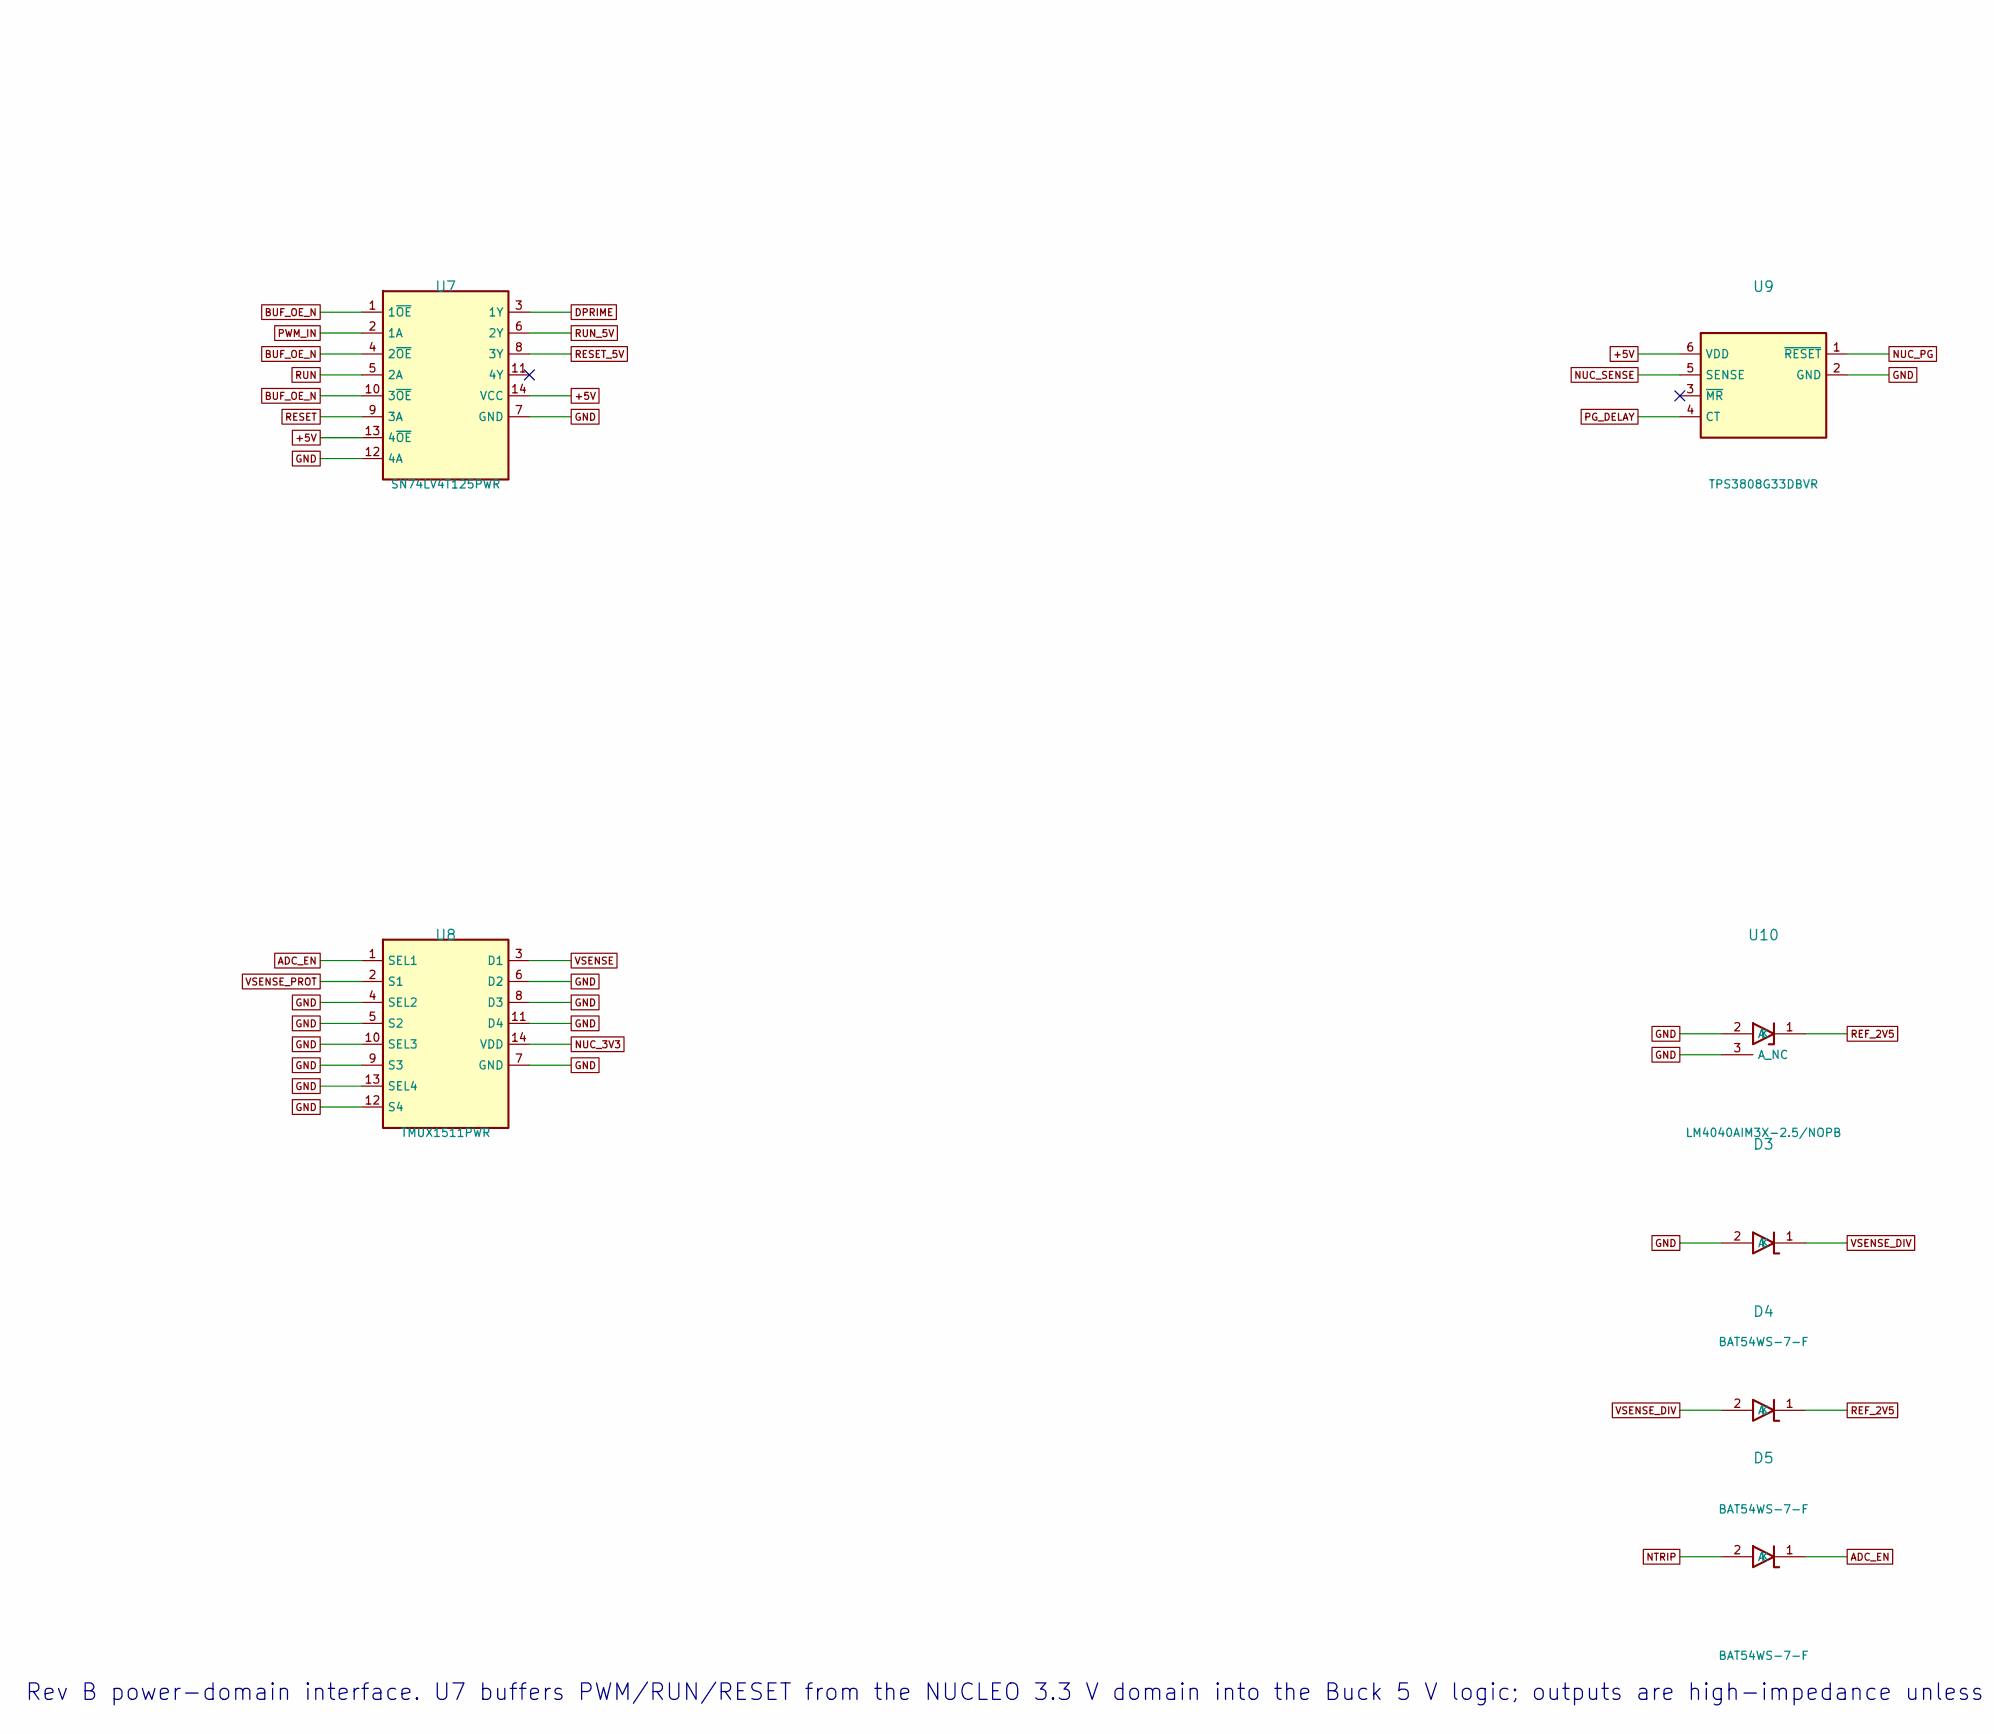
[picture p144: schematic buck_5.kicad_sch, Power-domain interface - REV B PROTOTYPE, part in row 1, column 1]

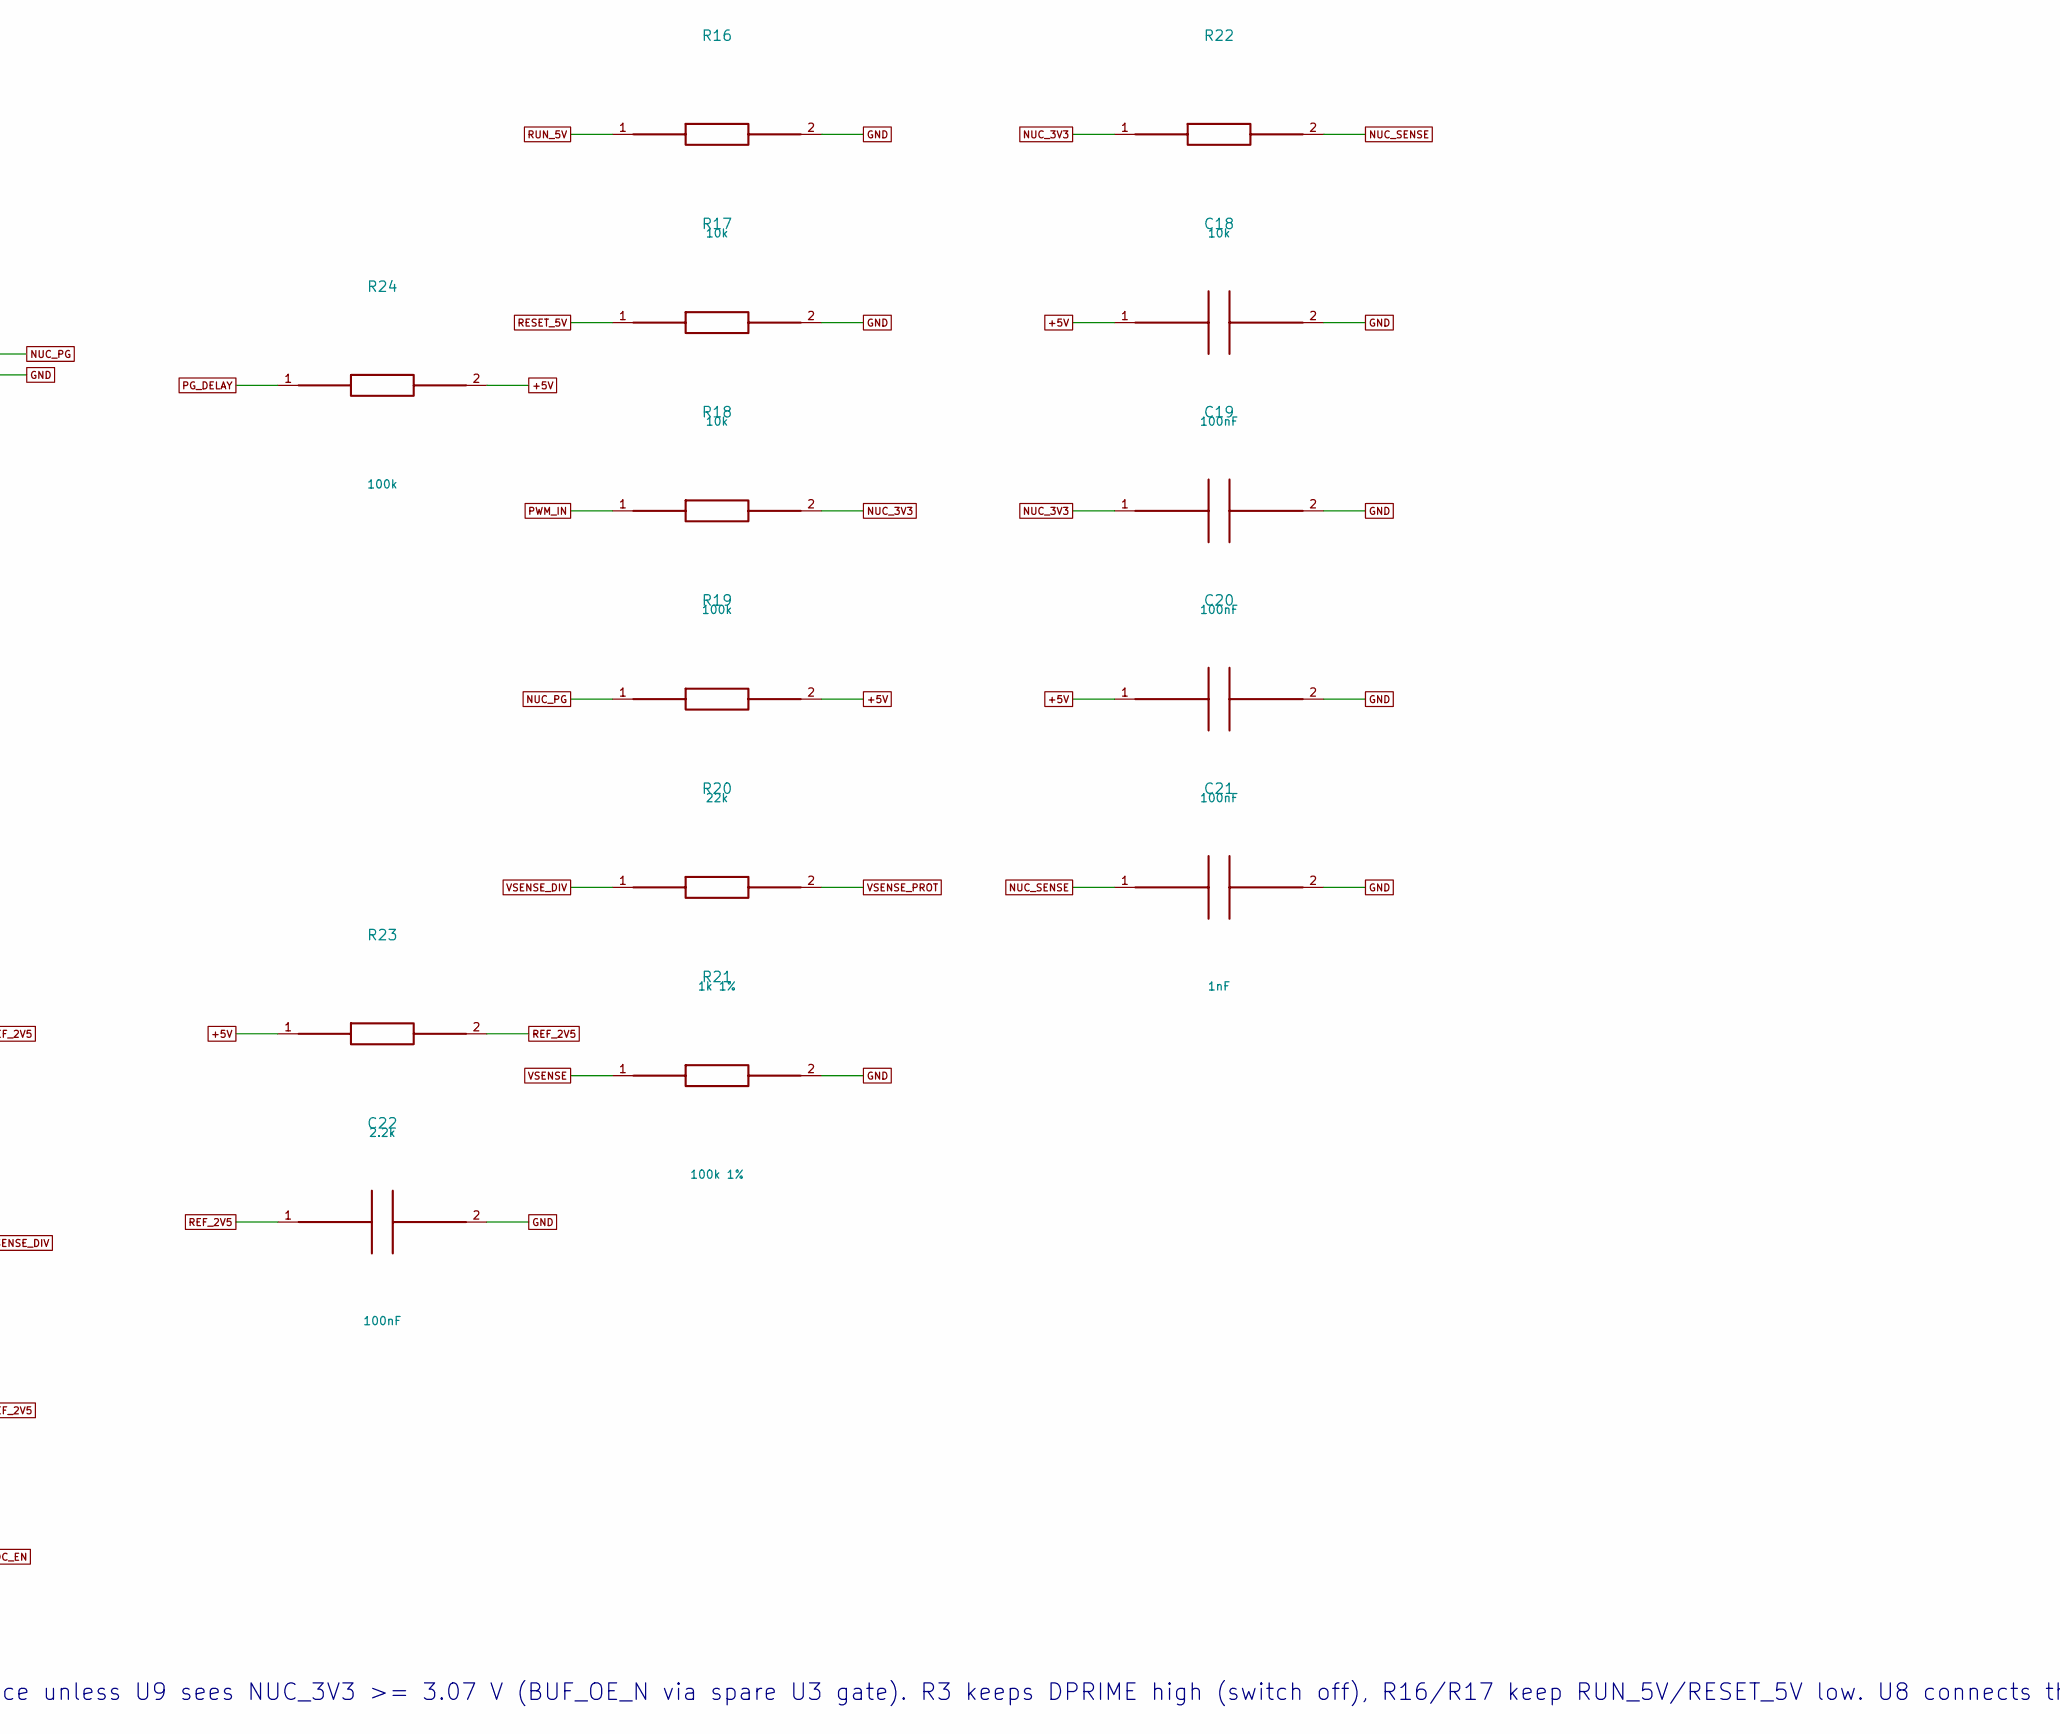
[picture p145: schematic buck_5.kicad_sch, Power-domain interface - REV B PROTOTYPE, part in row 1, column 2]

Parts:
C18, C19, C20, C22: 100nF; C_0603_1608Metric; MPN CC0603KRX7R9BB104; LCSC C14663
C21: 1nF; C_0603_1608Metric; MPN 0603CG102J500NT; LCSC C1636
D3, D4, D5: BAT54WS-7-F; Diodes_SOD323; MPN BAT54WS-7-F; LCSC C124205
R16, R17, R22: 10k; R_0603_1608Metric; MPN 0603WAF1002T5E; LCSC C25804
R18, R24: 100k; R_0603_1608Metric; MPN 0603WAF1003T5E; LCSC C25803
R19: 22k; R_0603_1608Metric; MPN 0603WAF2202T5E; LCSC C31850
R20: 1k 1%; R_0603_1608Metric; MPN 0603WAF1001T5E; LCSC C21190
R21: 100k 1%; R_0603_1608Metric; MPN 0603WAF1003T5E; LCSC C25803
R23: 2.2k; R_0603_1608Metric; MPN 0603WAF2201T5E; LCSC C4190
U7: SN74LV4T125PWR; TI_PW0014A_TSSOP-14; MPN SN74LV4T125PWR; LCSC C90755
U8: TMUX1511PWR; TI_PW0014A_TSSOP-14; MPN TMUX1511PWR; LCSC C2866750
U9: TPS3808G33DBVR; TI_DBV0006A_SOT-23-6; MPN TPS3808G33DBVR; LCSC C43698
U10: LM4040AIM3X-2.5/NOPB; TI_DBZ0003A_SOT-23-3; MPN LM4040AIM3X-2.5/NOPB; LCSC C111866

Connections:
+5V: C18.1, C20.1, R19.2, R23.1, R24.2, U7.13 (4~OE), U7.14 (VCC), U9.6 (VDD); also elsewhere on the board
ADC_EN: D5.1 (K), U8.1 (SEL1); also elsewhere on the board
BUF_OE_N: U7.1 (1~OE), U7.4 (2~OE), U7.10 (3~OE); also elsewhere on the board
DPRIME: U7.3 (1Y); also elsewhere on the board
GND: C18.2, C19.2, C20.2, C21.2, C22.2, D3.2 (A), R16.2, R17.2, R21.2, U7.7 (GND), U7.12 (4A), U8.4 (SEL2), U8.5 (S2), U8.6 (D2), U8.7 (GND), U8.8 (D3), U8.9 (S3), U8.10 (SEL3), U8.11 (D4), U8.12 (S4), U8.13 (SEL4), U9.2 (GND), U10.2 (A), U10.3 (A_NC); also elsewhere on the board
NTRIP: D5.2 (A); also elsewhere on the board
NUC_3V3: C19.1, R18.2, R22.1, U8.14 (VDD); also elsewhere on the board
NUC_PG: R19.1, U9.1 (~RESET); also elsewhere on the board
NUC_SENSE: C21.1, R22.2, U9.5 (SENSE)
PG_DELAY: R24.1, U9.4 (CT)
PWM_IN: R18.1, U7.2 (1A); also elsewhere on the board
REF_2V5: C22.1, D4.1 (K), R23.2, U10.1 (K)
RESET: U7.9 (3A); also elsewhere on the board
RESET_5V: R17.1, U7.8 (3Y); also elsewhere on the board
RUN: U7.5 (2A); also elsewhere on the board
RUN_5V: R16.1, U7.6 (2Y); also elsewhere on the board
VSENSE: R21.1, U8.3 (D1); also elsewhere on the board
VSENSE_DIV: D3.1 (K), D4.2 (A), R20.1; also elsewhere on the board
VSENSE_PROT: R20.2, U8.2 (S1)

Notes on the sheet:
Rev B power-domain interface. U7 buffers PWM/RUN/RESET from the NUCLEO 3.3 V domain into the Buck 5 V logic; outputs are high-impedance unless U9 sees NUC_3V3 >= 3.07 V (BUF_OE_N via spare U3 gate). R3 keeps DPRIME high (switch off), R16/R17 keep RUN_5V/RESET_5V low. U8 connects the clamped ADC div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

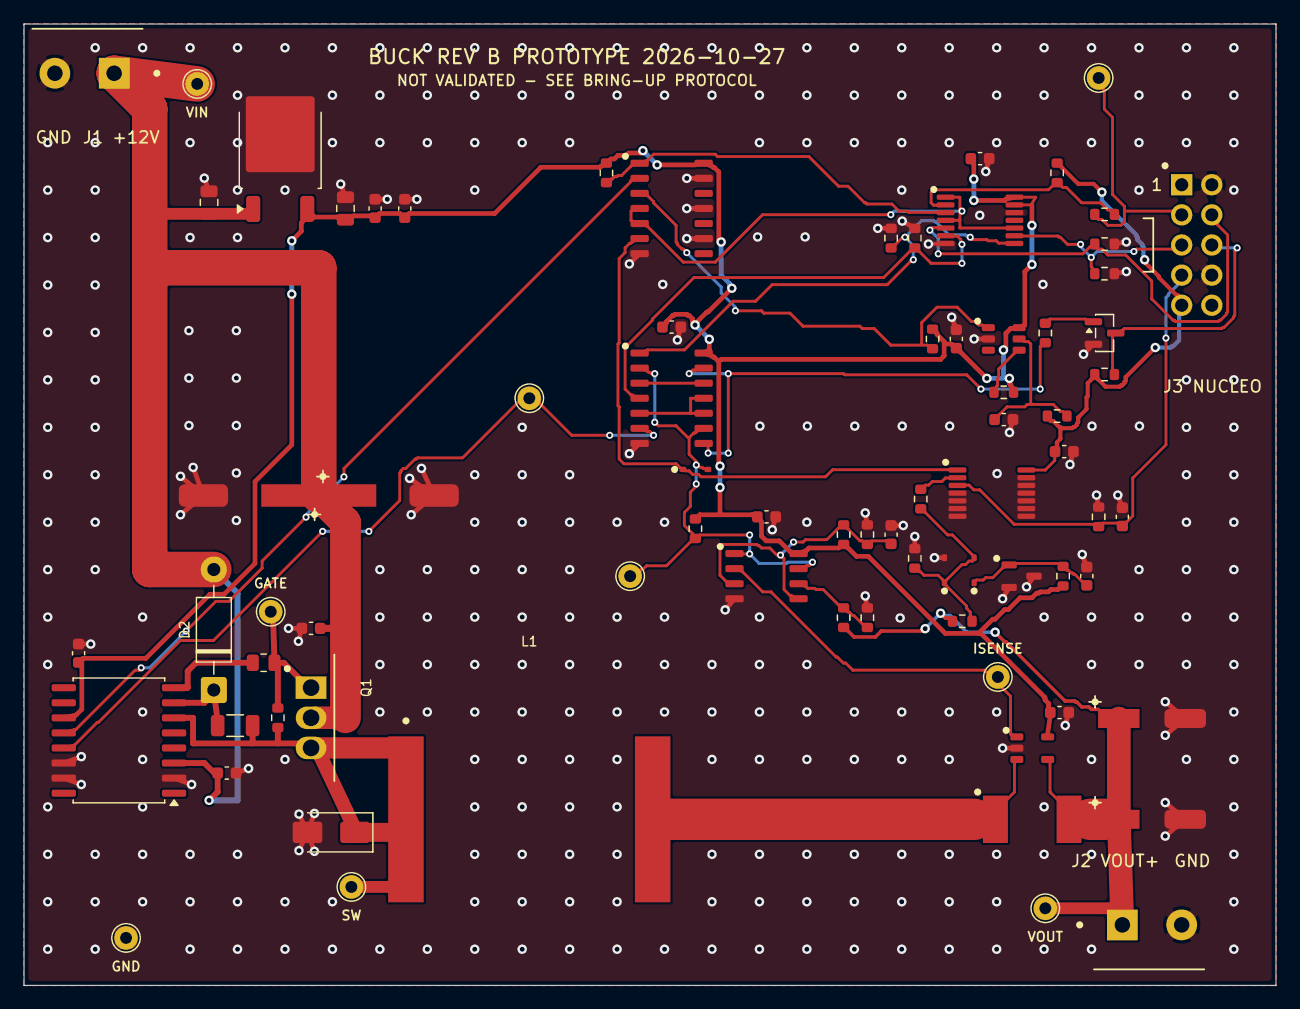
[picture p146: board buck.kicad_pcb from above]

Board: 2 copper layers, 105.5 x 81.0 mm, 77 parts (0 on the bottom side), 37 nets.
