almondsun/DynamicSystemsAndControl/(commit log)

2026-09-14 Initial commit: control systems coursework and Buck final project
2026-10-27 Preserve Buck PCB design and add validated JLCPCB quote package
2026-10-27 feat: Buck PCB Rev B prototype package for JLCPCB
    Rev B of project/pcb/redesign, prepared for a JLCPCB top-side SMT quote
    and still pending bring-up. Rev A is preserved in history/revA_quote_20261027.
    - Lands taken from manufacturer drawings (Murata 6000B, Same Sky TB002,
    Wurth WR-BHD, Panasonic SVPF/SVF, TA-I RLP, TI PW/DBV/DBZ/D/DBV5, Diodes
    SOD323); Q1 hole 1.4 mm per IPC-2222; U5 courtyard added.
    - Power-domain interface: SN74LV4T125 buffer for PWM/RUN/RESET from +5V,
    TMUX1511 on the ADC path, TPS3808G33 supervisor, LM4040 2.5 V reference
    with BAT54WS clamps, fault latch set while the interface is disabled.
    - Re-laid board: compact switching cell, no vias on HO/GATE/BOOT/SW,
    K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
2026-10-27 fix: make Buck Rev B orderable as a lab prototype
    Order decisions after an external second opinion:
    - Move the L1-L2-RS1-output chain 2 mm right: Q1 tab (VIN) to L1 SW clip
    clearance 1.28 -> 3.29 mm at maximum package dimensions; board rerouted,
    DRC 0 errors / 0 unconnected / 0 parity.
    - L1/L2 (60B334C, no JLC/LCSC stock) leave the JLC BOM/CPL and are
    hand-soldered: 31 BOM lines, 62 placements, all with JLC stock.
    - R10 -> UNI-ROYAL 0603WAF3092T5E (C23022), same 30.9k 1% 0603.
    - Accept LM4040AIM3X-2.5/NOPB (same device per TI SNOS633N s.11).
    - Document lab-only use: regulated 12 V, resistive load, supervised tests.
2026-10-27 feat: replace Buck Rev B L1+L2 with a single JLC-placed 60B684C
    L1+L2 (2 x Murata 60B334C in series) have no JLCPCB/LCSC stock, which
    forced buying them at DigiKey and hand-soldering. A single Murata
    60B684C (680 uH, 3 A, 135 mOhm, C6095796, JLC stock 17) from the same
    6000B series uses the same drawing and land, so JLCPCB can place it.
    - Schematic: L1 becomes 60B684C, L2 and the LMID net are removed and
    L1.2 joins IP (revb_tools/sch_single_inductor.py). ERC 0 errors;
    netdiff shows only those three changes.
    - PCB: L2 removed, 3.5 mm F.Cu track from L1 pad 2 to the outer end of
    RS1; Kelvin traces and the 3.285 mm Q1 tab to L1 gap are unchanged.
    DRC 0 errors / 0 unconnected / 0 parity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
2026-10-27 fix: hand-solder Buck Rev B L1 instead of JLC placement
    A second, informal external review of 6908b4d flagged two problems with
    JLCPCB placing the single 60B684C. Both were verified:
    - Murata KMP_6000B_B01 p.1 limits peak reflow to 245 C (J-STD-020D.1),
    while JLCPCB Economic PCBA reflows at 255 +/- 5 C, not adjustable
    (Standard PCBA: 240 +/- 5 C).
    - The L1 body ends 0.48 mm from the bottom board edge (pcbnew F.Fab);
    no other SMD part is closer than 4.17 mm.
    L1 becomes MANUAL_SMD_DNP_AT_JLC (revb_tools/sch_l1_hand_solder.py;
    symbol and footprint fields synced so schematic parity stays at 0).
    Order Economic PCBA for the other 62 SMD parts and buy the 60B684C
    separately (LCSC C6095796).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
2026-11-03 PCB Rev C: esquematico terminado
2026-11-04 pcb layout draft 1
2026-11-06 esquematicos completados de manera definitva y placement final de el circuito
2026-11-07 Disenio final PCB y mandada a hacer
